murugan-paramesh/SiC-DC-DC-Converter/Advanced_Research_2026/Robust_Optimization/README.md

# Robust_Optimization - reliability-aware multi-objective DAB design under uncertainty

_Generated by `robust_optimize.py` (seed 20261010, NSGA-II population 60 x 60 generations for every variant, 24 LHS uncertainty samples per design, 30850 design evaluations in 506 s). Maturity **L2** (analytical/simulation models, nothing measured)._

## 1. Problem

Design variables (9, mixed): switching frequency fs 60-200 kHz; nominal phase shift phi_nom 12-50 deg, which fixes the series inductance L = V1 n V2 phi (pi - phi) / (2 pi^2 fs P) at 800/400 V, 6.6 kW (L is reported); turns ratio n 1.6-2.4; transformer peak-flux target 0.08-0.20 T; transformer core {E55, ETD59, E65, E70}; inductor core {ETD44, ETD49, E55}; dead time 80-250 ns; HV device {C3M0032120K, C3M0016120K}; LV device {C3M0016120K x1, C3M0032120K x2}. Modulation is SPS (as in 12_Optimization); magnetics are designed at the nominal point with `dabtools.dab.magnetics.design_transformer/design_inductor`.

Objectives (all minimised, no weighted sum):

1. total converter loss at 800/400 V, 6.6 kW (W) - same budget as 04/12: bridges, gate drive, transformer, inductor, 12 W auxiliary, 0.4 % PCB/bus-bar;
2. magnetics volume (cm3) = 2.2 x (transformer + inductor core volume), as in 12_Optimization;
3. reliability proxy: log10 of the daily lifetime consumption D = sum n_i / Nf_i of the hotter bridge over the ASSUMED 24 h mission profile (rainflow count of the hourly steady-state Tj sequence, Coffin-Manson/Arrhenius law Nf = A dTj^alpha exp(Q/(R Tm)) with the LESIT coefficients A = 3.025e+05, alpha = -5.039, Q/R = 11897 K). **These coefficients are literature-typical values for Si IGBT modules (Held et al. 1997); they are not measured for discrete SiC TO-247 devices, so only the ratio between designs is meaningful** - the objective is reported as log10(D / D_baseline). For the record the absolute proxy for the baseline is 1.48e+13 years, i.e. thermal cycling is not life-limiting with the project heatsink (dTj < 15 K);
4. negative ZVS margin: -min over {nominal + 4 envelope corners} x {100 %, 50 % load} of (I_edge - I_min) at both bridges, A referred to the HV side (I_min from the energy criterion with Coss_er and the 60 pF winding capacitance of design_values.json).

Constraints (<= 0), following 00_Requirements/02_operating_envelope.md: full power reachable at all 9 (V1, V2) corners with phi <= 60 deg (requirement 1, firmware clamp); Tj <= 125 C at every full-power corner (13_Thermal_Analysis limit, heatsink 0.22 K/W + 0.35 K/W pad) **with hard-switching losses charged wherever the ZVS criterion fails** (requirement 2/3: a point without ZVS is allowed if the thermal budget holds); ZVS at both bridges at the nominal voltages 800/400 V at 100 % and 50 % load (EL-04a style); transformer Bpk at 850 V <= 0.2 T; transformer and inductor window fill <= 0.7; HV peak current <= 24 A (design_values I_limit_pk). ZVS over the envelope corners is objective 4 (maximised margin) and, in the three *strict* variants, an additional hard constraint (ZVS at both bridges at all five full-power points); the strict variants are reported because the task asked for corner ZVS as a constraint, and section 3.3 shows why it is incompatible with the 60 deg limit under inductance tolerance for SPS.

Uncertainty (assumed uniform, not measured): kL series inductance tolerance +/-15 % [0.85, 1.15]; kCoss Coss_er tolerance +/-20 % [0.8, 1.2]; kRds Rds_on aging +0..30 % [1, 1.3]; kCore ferrite core-loss tolerance +/-25 % [0.75, 1.25]; Tamb ambient 25..55 C [25, 55]. One Latin-hypercube set of 24 samples (common random numbers, `results/uncertainty_samples_LHS.csv`) is used for every design. **Robust** variant: every objective and constraint is the worst case over the samples. **Chance-constrained** variant: objectives are sample means, every constraint is enforced at its 95 % empirical quantile, so ZVS at the envelope corners holds with probability >= 95 % (at most 1 of 24 samples may fail).

Mission profile (`results/mission_profile_ASSUMED.csv`, figure below): ASSUMED EV-charger / battery-interface day, bidirectional (night charging 6.6 kW with battery voltage rising 330 -> 445 V, morning and evening vehicle-to-grid discharge up to 6.6 kW, midday PV charging 3.3 kW, standby hours with 12 W auxiliary loss). Segments are hourly, so each is evaluated at steady state (thermal time constants of TO-247 + heatsink are minutes).

## 2. Methods

* **Evaluator** (`dab_eval.py`): closed-form SPS waveform quantities (exact piecewise-linear rms), project loss model (`dabtools.dab.losses` re-implemented with Rds_on/Coss scaling, identical at scale 1), 5-step electro-thermal iteration, project magnetics design routines. Self-test against the numerical `DABPoint` model: rms/peak within 0.31 %, edge currents identical to `dab_model.sps_switching_currents`. Cross-check with the stored 12_Optimization baseline (phi = 28 deg -> 63.7 uH, no winding capacitance): stored 91.63 W, this evaluator 90.67 W; the project baseline with L = 64.0 uH gives 90.79 W. The 1 W difference has a cause worth recording: `DABPoint.switching_currents()` detects a third, wrap-around edge on bridge 1 (theta = 2 pi - d_theta) so 12_Optimization and 04 count three HV turn-off/dead-time events per period instead of two (HV switching 2.80 W and dead-time diode 0.87 W in design_values.json vs 1.88 W and 0.59 W here); the closed form uses two edges per bridge.
* **NSGA-II** (numpy): constrained non-dominated sorting (feasible beats infeasible, infeasible ranked by total violation), crowding distance, binary tournament, SBX (eta_c = 15, p_c = 0.9), polynomial mutation (eta_m = 20, p_m = 1/9). The reported Pareto set is the non-dominated subset of all feasible first-front members archived over the generations. Hypervolume is a Monte-Carlo estimate (1e5 fixed points) in a common box spanned by the union of all fronts.
* **Surrogate-assisted search**: Gaussian process (ARD squared-exponential kernel, hyperparameters by marginal likelihood, L-BFGS-B, two restarts) on an augmented-Tchebycheff scalarisation s = max_k w_k f~_k + 0.05 sum_k w_k f~_k of the box-normalised objectives, expected-improvement acquisition maximised over 4000 random + 300 local candidates; 5 weight vectors, 20 LHS initial + 30 iterations each. Infeasible designs get s = 2 + violation. This is a simplified single-objective BO per weight vector (ParEGO-like), not a hypervolume-based multi-objective BO; the weight vectors only steer the search, the result reported is the non-dominated set of all feasible evaluated points.
* **Exhaustive grid**: the 8640-point grid of 12_Optimization re-evaluated with this evaluator (Bpk target 0.13 T as there) for a like-for-like comparison.
* **Knee selection**: on each front, min-max normalise the four objectives over the front and take the point closest (Euclidean) to the ideal point; a second knee from the (loss, volume) projection (maximum distance from the chord between the extremes) is reported as a cross-check. Both are standard knee heuristics; neither is a tuned weighted-sum score.

## 3. Results

Variants: `nominal`, `robust`, `cc` use the requirement-based constraint set; `*_strict` add ZVS at every full-power corner as a hard constraint.

| variant | evaluations | non-dominated designs | hypervolume | loss range (W) | volume range (cm3) | ZVS-margin range (A) | log10 D/D_base range |
|---|---|---|---|---|---|---|---|
| NSGA-II nominal | 3660 | 305 | 0.691 | 77.7 - 107.1 | 152 - 321 | -12.00 - -4.96 | -1.63 - +3.00 |
| NSGA-II robust (worst case) | 3660 | 242 | 0.267 | 84.6 - 101.3 | 166 - 277 | -12.14 - -8.59 | -0.50 - +4.12 |
| NSGA-II chance-constrained 95 % | 3660 | 197 | 0.524 | 80.6 - 95.3 | 152 - 277 | -10.75 - -6.61 | -0.78 - +3.22 |
| NSGA-II nominal, strict (ZVS at all full-power corners) | 3660 | 234 | 0.680 | 81.1 - 99.2 | 152 - 321 | -8.37 - -4.99 | -1.09 - +2.25 |
| NSGA-II robust, strict | 3660 | 0 | 0.000 | nan - nan | nan - nan | nan - nan | +nan - +nan |
| NSGA-II chance-constrained 95 %, strict | 3660 | 0 | 0.000 | nan - nan | nan - nan | nan - nan | +nan - +nan |
| exhaustive grid (nominal, re-evaluated) | 8640 (1380 feasible) | 52 | 0.437 | 81.0 - 95.5 | 152 - 321 | -12.92 - -6.84 | -1.07 - +2.98 |
| GP-EI surrogate search (nominal) | 250 | 15 | 0.291 | 89.6 - 110.2 | 214 - 277 | -8.42 - -5.92 | +0.03 - +1.65 |

The robust and chance-constrained hypervolumes are computed in the same box but from worst-case / mean objectives, so they are not directly comparable to the nominal value; the comparison that matters is the shift of the fronts in the figures. NSGA-II nominal dominates 71 % of the grid's 4-D non-dominated designs and 100 % of the surrogate-search designs; at the surrogate budget (250 evaluations) NSGA-II nominal had hypervolume 0.361 vs 0.291 for the surrogate search. The grid front is evaluated under 12_Optimization's own constraint set (phi <= 60 deg, Tj, Bpk, fills; 1380 of 8640 feasible; 564 of them also pass this module's nominal set); only 0 grid designs satisfy the strict ZVS-at-every-full-power-corner + Ipk <= 24 A set, because the grid's phi_nom steps (20, 25, 30, 35 deg) straddle the narrow strict window (see 3.3) - its reported front designs (phi_nom 20 deg) hard-switch at the 650/450 V and 850/300 V full-power corners (allowed by the requirements if Tj holds, which it does with this heatsink).

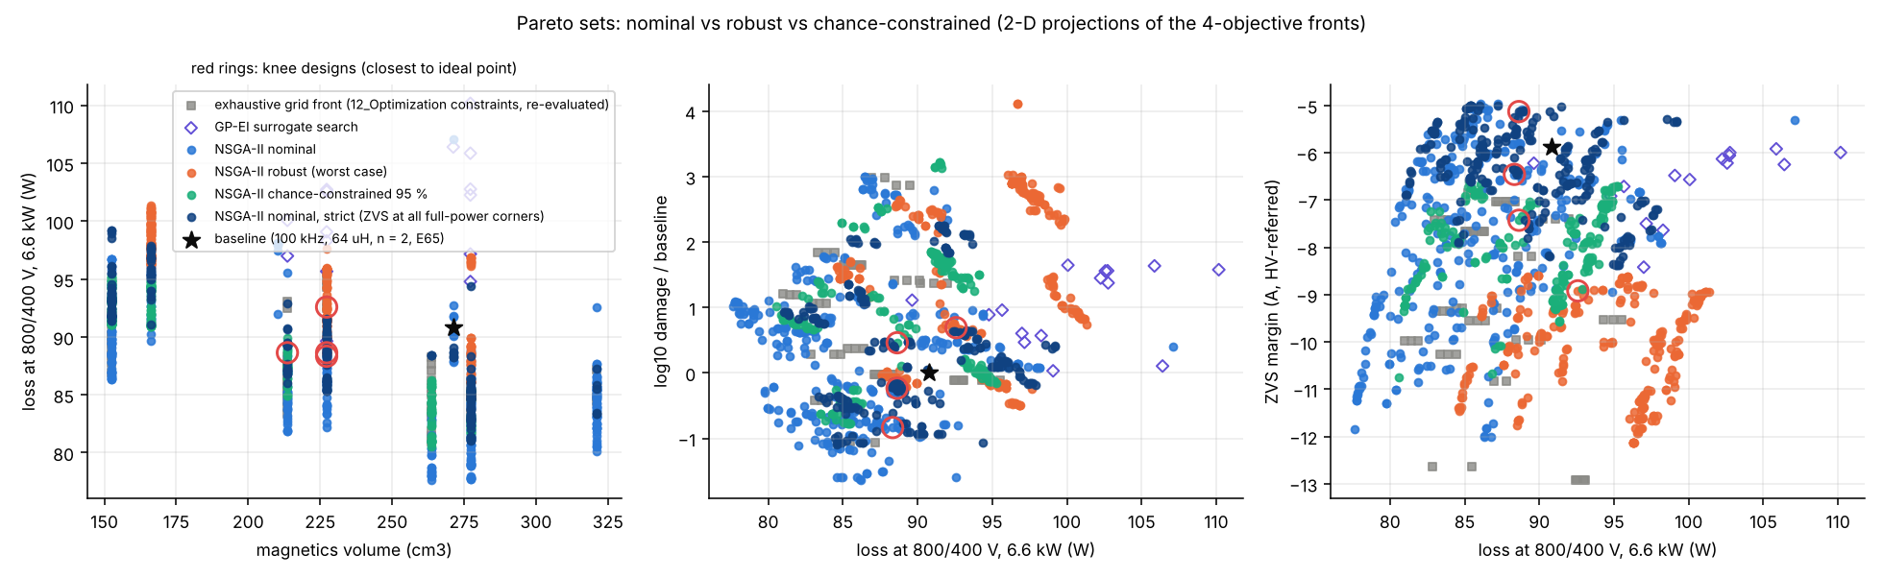
[picture p4: Advanced_Research_2026/Robust_Optimization/results/pareto_2d.png]
pareto 2d


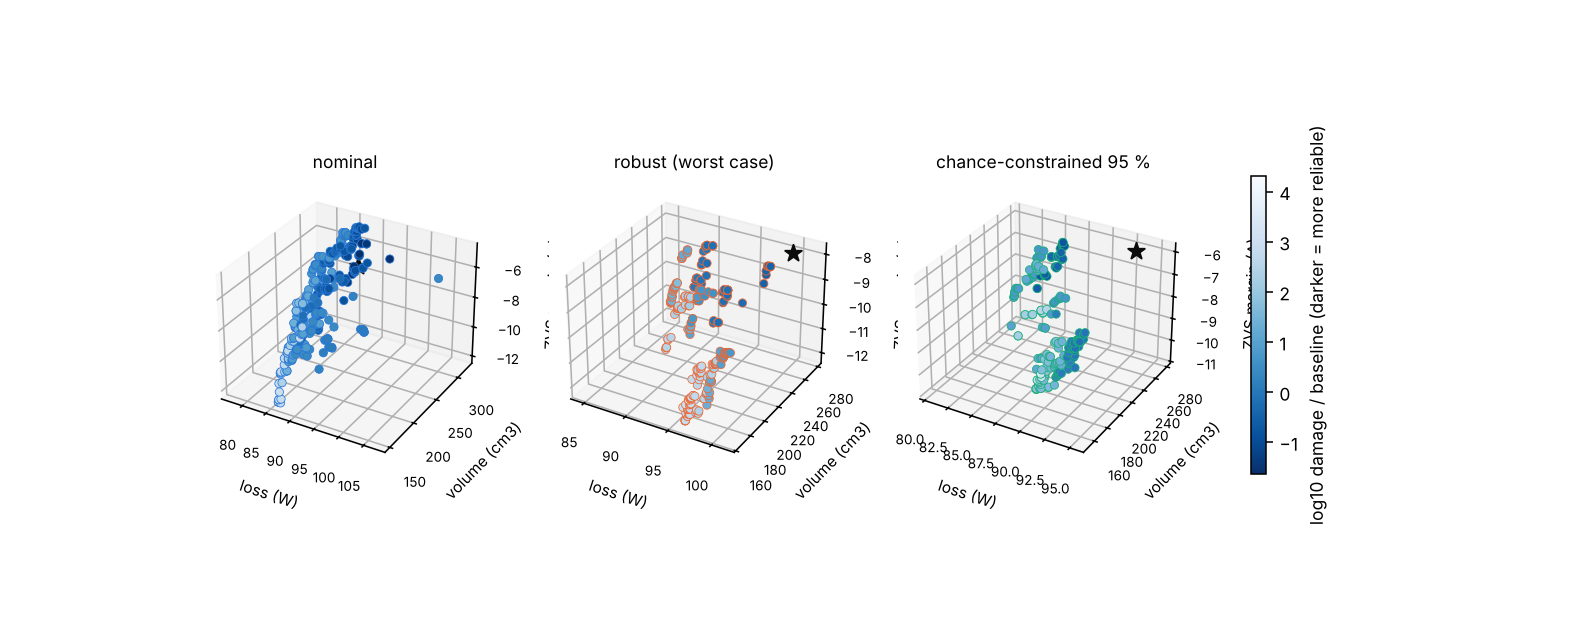
[picture p5: Advanced_Research_2026/Robust_Optimization/results/pareto_3d.png]
pareto 3d


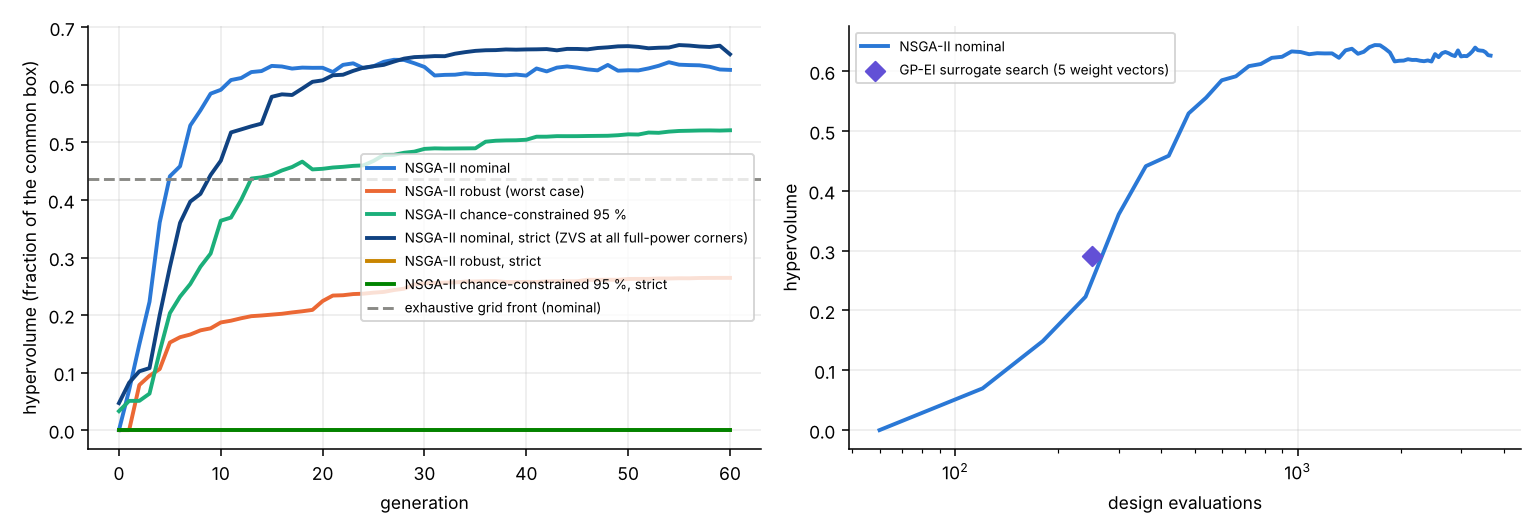
[picture p6: Advanced_Research_2026/Robust_Optimization/results/convergence_hypervolume.png]
convergence


### 3.1 Knee designs

| fs (kHz) | phi_nom (deg) | L (uH) | n | Bpk (T) | transformer | inductor | t_dead (ns) | HV device | LV device | loss (W) | volume (cm3) | log10 D/D_base | ZVS margin (A) |
|---|---|---|---|---|---|---|---|---|---|---|---|---|---|
| 71 | 24.6 | 78.9 | 1.97 | 0.178 | E65/32/27 | ETD49/25/16 | 119 | C3M0032120Kx1 | C3M0032120Kx2 | 88.3 | 227 | -0.83 | -6.46 | NSGA-II nominal, knee (ideal-point distance 0.64)
| 107 | 24.7 | 52.9 | 1.97 | 0.124 | E65/32/27 | ETD49/25/16 | 81 | C3M0032120Kx1 | C3M0032120Kx2 | 92.6 | 227 | +0.69 | -8.92 | NSGA-II robust (worst case), knee (ideal-point distance 0.78)
| 133 | 23.8 | 41.1 | 1.97 | 0.097 | E65/32/27 | ETD44/22/15 | 132 | C3M0032120Kx1 | C3M0032120Kx2 | 88.6 | 214 | +0.46 | -7.43 | NSGA-II chance-constrained 95 %, knee (ideal-point distance 0.82)
| 94 | 29.1 | 68.4 | 1.96 | 0.135 | E65/32/27 | ETD49/25/16 | 84 | C3M0032120Kx1 | C3M0032120Kx2 | 88.6 | 227 | -0.23 | -5.13 | NSGA-II nominal, strict (ZVS at all full-power corners), knee (ideal-point distance 0.66)
| 94 | 18.6 | 47.5 | 1.98 | 0.139 | E65/32/27 | ETD44/22/15 | 117 | C3M0016120Kx1 | C3M0032120Kx2 | 81.9 | 214 | +1.62 | -10.85 | NSGA-II nominal, 2-D (loss, volume) chord knee
| 103 | 21.2 | 48.3 | 1.98 | 0.124 | E65/32/27 | ETD49/25/16 | 83 | C3M0016120Kx1 | C3M0032120Kx2 | 88.5 | 227 | +2.54 | -11.76 | NSGA-II robust (worst case), 2-D (loss, volume) chord knee
| 116 | 21.8 | 44.0 | 1.98 | 0.180 | ETD59/31/22 | ETD49/25/16 | 125 | C3M0016120Kx1 | C3M0032120Kx2 | 90.9 | 166 | +1.85 | -9.14 | NSGA-II chance-constrained 95 %, 2-D (loss, volume) chord knee
| 122 | 26.0 | 47.5 | 1.93 | 0.169 | ETD59/31/22 | ETD49/25/16 | 89 | C3M0016120Kx1 | C3M0032120Kx2 | 91.1 | 166 | +2.02 | -6.86 | NSGA-II nominal, strict (ZVS at all full-power corners), 2-D (loss, volume) chord knee
| 100 | 28.2 | 64.0 | 2.00 | 0.130 | E65/32/27 | E55/28/21 | 150 | C3M0032120Kx1 | C3M0016120Kx1 | 90.8 | 271 | +0.00 | -5.88 | **baseline** (nominal evaluation)

Rationale: the knee is the design beyond which improving any one objective costs disproportionately in the others (closest point to the ideal in the normalised objective space). The nominal knee runs at 71 kHz with phi_nom 24.6 deg (L = 78.9 uH), n = 1.97, E65/32/27 / ETD49/25/16, dead time 119 ns, C3M0032120Kx1 / C3M0032120Kx2: 88.3 W (eta 98.68 %), 227 cm3, mission efficiency 98.33 % (1261 Wh/day), Tj max 54 C, dTj (HV/LV) 8.7/5.8 K, ZVS margin -6.46 A.

### 3.2 Baseline (100 kHz, 64 uH, n = 2, E65/E55, 150 ns, C3M0032120K / C3M0016120K) against the fronts

| variant | baseline objectives (loss W, volume cm3, log10 D/D_base, ZVS margin A) | feasible under variant | front designs dominating it | normalised distance to front | loss reduction available (W) | volume reduction available (cm3) | ZVS-margin gain available (A) |
|---|---|---|---|---|---|---|---|
| nominal | 90.8, 271, +0.00, -5.88 | yes | 6 of 305 | 0.173 | 2.6 | 44 | 0.08 |
| robust (worst case) | 99.9, 271, +0.54, -7.87 | no | 0 of 242 | 0.393 | 0.0 | 0 | 0.00 |
| chance-constrained 95 % | 93.3, 271, -0.30, -5.97 | no | 0 of 197 | 0.524 | 0.0 | 0 | 0.00 |
| nominal, strict (ZVS at all full-power corners) | 90.8, 271, +0.00, -5.88 | yes | 12 of 234 | 0.159 | 2.5 | 44 | 0.77 |
| robust, strict | 99.9, 271, +0.54, -7.87 | no | 0 of 0 | nan | 0.0 | 0 | 0.00 |
| chance-constrained 95 %, strict | 93.3, 271, -0.30, -5.97 | no | 0 of 0 | nan | 0.0 | 0 | 0.00 |

The baseline is **dominated** by 6 of the 305 front designs; its normalised distance to the front is 0.173 of the front span. The dominating designs save at most 2.6 W (2.9 % of the loss) and 44 cm3 (16 % of the magnetics volume) while being no worse in reliability proxy and ZVS margin - e.g. 91 kHz, phi_nom 27.0 deg (L = 66.3 uH), n = 1.96, E65/32/27 + ETD49/25/16 inductor, 107 ns, C3M0032120Kx1 / C3M0032120Kx2. Verdict: the baseline is near-Pareto-optimal in loss (within 3 %) but not in magnetics volume: the E55 series-inductor core is oversized (window fill 0.28) and an ETD49 core with 2 x C3M0032120K on the LV bridge gives the same loss, ZVS margin and reliability with less volume; the choice fs = 100 kHz / phi_nom = 28 deg / n = 2 itself lies on the front. Under the robust and chance-constrained variants the baseline is NOT feasible / NOT feasible respectively (violated constraint: phi_corner - the 650/300 V corner needs phi > 60 deg when L is at +15 %, see 3.3); its probability of ZVS at 800/400 V (100 % and 50 % load) over the LHS set is 1.00, of ZVS at every full-power corner 0.71 (see `results/knee_and_baseline.json`).

Designs dominating the baseline (nominal, first three):

| fs (kHz) | phi_nom (deg) | L (uH) | n | Bpk (T) | transformer | inductor | t_dead (ns) | HV device | LV device | loss (W) | volume (cm3) | log10 D/D_base | ZVS margin (A) |
|---|---|---|---|---|---|---|---|---|---|---|---|---|---|
| 91 | 27.0 | 66.3 | 1.96 | 0.141 | E65/32/27 | ETD49/25/16 | 107 | C3M0032120Kx1 | C3M0032120Kx2 | 88.2 | 227 | -0.30 | -5.81 |
| 91 | 27.0 | 66.3 | 1.96 | 0.141 | E65/32/27 | ETD49/25/16 | 110 | C3M0032120Kx1 | C3M0032120Kx2 | 88.2 | 227 | -0.30 | -5.81 |
| 91 | 27.0 | 66.3 | 1.96 | 0.139 | E65/32/27 | ETD49/25/16 | 145 | C3M0032120Kx1 | C3M0032120Kx2 | 88.6 | 227 | -0.30 | -5.80 |

### 3.3 Effect of the uncertainty treatment

* 55 of the 305 nominal-front designs remain feasible under the robust (worst case) constraints.
* 73 of the 305 nominal-front designs remain feasible under the chance-constrained 95 % constraints.
* 120 of the 305 nominal-front designs remain feasible under the nominal, strict (ZVS at all full-power corners) constraints.
* 0 of the 305 nominal-front designs remain feasible under the robust, strict constraints.
* 0 of the 305 nominal-front designs remain feasible under the chance-constrained 95 %, strict constraints.
* nominal front: probability of ZVS at 800/400 V (100 % and 50 % load) over the LHS set is min 0.58, mean 0.99; 95 % of its designs reach >= 95 %.
* robust (worst case) front: probability of ZVS at 800/400 V (100 % and 50 % load) over the LHS set is min 1.00, mean 1.00; 100 % of its designs reach >= 95 %.
* chance-constrained 95 % front: probability of ZVS at 800/400 V (100 % and 50 % load) over the LHS set is min 0.96, mean 1.00; 100 % of its designs reach >= 95 %.
* nominal, strict (ZVS at all full-power corners) front: probability of ZVS at every full-power corner over the LHS set is min 0.46, mean 0.72; 1 % of its designs reach >= 95 %.
* **No feasible design was found by the robust, strict variant** (3660 evaluations); least-violating final design: constraints [-0.113, -0.463, 0.0, -0.18, -0.082, -0.486, -0.133] (order ['phi_corner', 'Tj', 'zvs_full', 'Bpk_850V', 'fill_xf', 'fill_ind', 'Ipk']).
* **No feasible design was found by the chance-constrained 95 %, strict variant** (3660 evaluations); least-violating final design: constraints [-0.016, -0.537, 0.0, -0.175, -0.507, -0.261, -0.198] (order ['phi_corner', 'Tj', 'zvs_full', 'Bpk_850V', 'fill_xf', 'fill_ind', 'Ipk']).
* Shift of the fronts (minimum loss / maximum ZVS margin / best log10 D on each front): nominal 77.7 W / -4.96 A / -1.63; robust (worst case) 84.6 W / -8.59 A / -0.50; chance-constrained 95 % 80.6 W / -6.61 A / -0.78; nominal, strict (ZVS at all full-power corners) 81.1 W / -4.99 A / -1.09. Worst-case objectives include +30 % Rds_on, +25 % core loss and 55 C ambient simultaneously, so a robust front sits above the nominal one in loss by construction; the chance-constrained objectives are sample means and sit close to the nominal values, the difference is in which designs are admitted.
* Why the strict worst case is (nearly) empty - closed form: with SPS at full power the HV bridge keeps ZVS at the 650/450 V corner only if phi > pi (V2' - V1) / (2 V2') (I0 > 0) and the LV bridge at 850/300 V only if phi > pi (V1 - V2') / (2 V1) (I1 > 0); for n = 2 these are 25.0 deg and 26.5 deg. Because P = V1 V2' phi (pi - phi) / (2 pi^2 fs L), every corner sees the same K = 2 pi^2 fs L P scaled by 1/(V1 V2'): ZVS at 650/450 V (585 kV^2, phi >= 25.0 deg) needs K >= 690 kV^2 and ZVS at 850/300 V (510 kV^2, phi >= 26.5 deg) K >= 632 kV^2, while the 60 deg limit of 00_Requirements / firmware clamp at 650/300 V (390 kV^2) caps K <= 855 kV^2. K is proportional to L, so the zero-current ZVS boundaries and the phase limit together admit only a K ratio of 1.24, i.e. a +/-10.7 % inductance band for n = 2 (+/-12.7 % for n = 1.95), below the assumed +/-15 % tolerance; the Coss-based minimum ZVS current, the +20 % Coss sample and the 24 A peak limit of the strict set narrow it further. (Earlier text quoted 57 deg at 650/300 V and a +/-1.5 % band: the 57 deg is the baseline 64 uH value, not the value implied by the 26.5 deg boundary (37.3 deg), and the 1.5 % was not supported by the closed form - corrected 2026-10-10.) In nominal-phase terms the lossless bound is phi_nom (800/400 V) = 22.5-29.1 deg; the optimiser's strict set narrows it to about 26.5-28.5 deg - the baseline (28.2 deg) sits inside it, which also explains why only 0 of the 8640 grid designs (phi_nom 20/25/30/35 deg) satisfy the strict constraint set. Consequence: with SPS, ZVS at the voltage-mismatch corners at full power cannot be *guaranteed* under a +/-15 % inductance tolerance; the requirement document already allows hard-switched operation where the thermal budget holds, which is what the main variants enforce (Tj with hard-switching losses) while the corner margin is maximised as an objective. EPS/TPS modulation (11_Control_Algorithms) is the known remedy and is outside this SPS study.

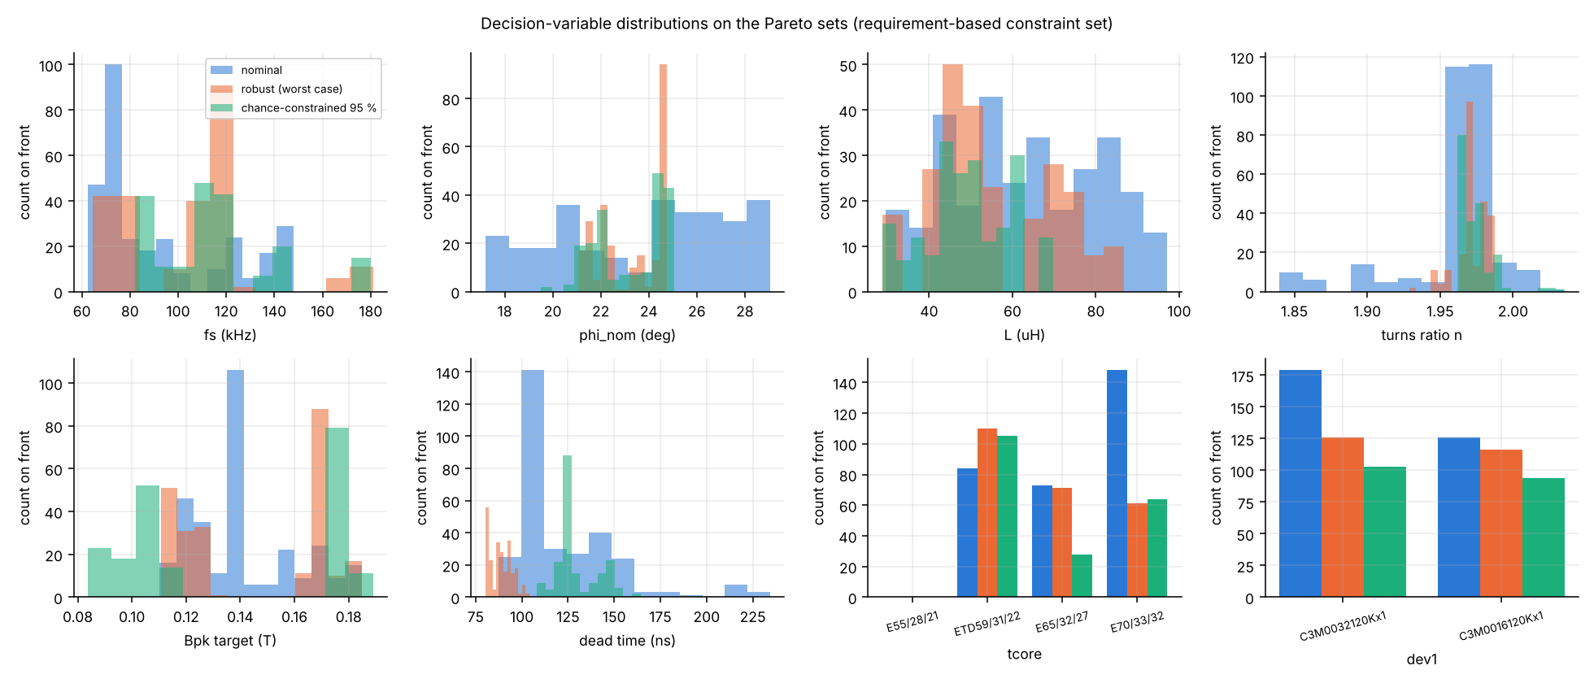
[picture p7: Advanced_Research_2026/Robust_Optimization/results/decision_variables.png]
variables


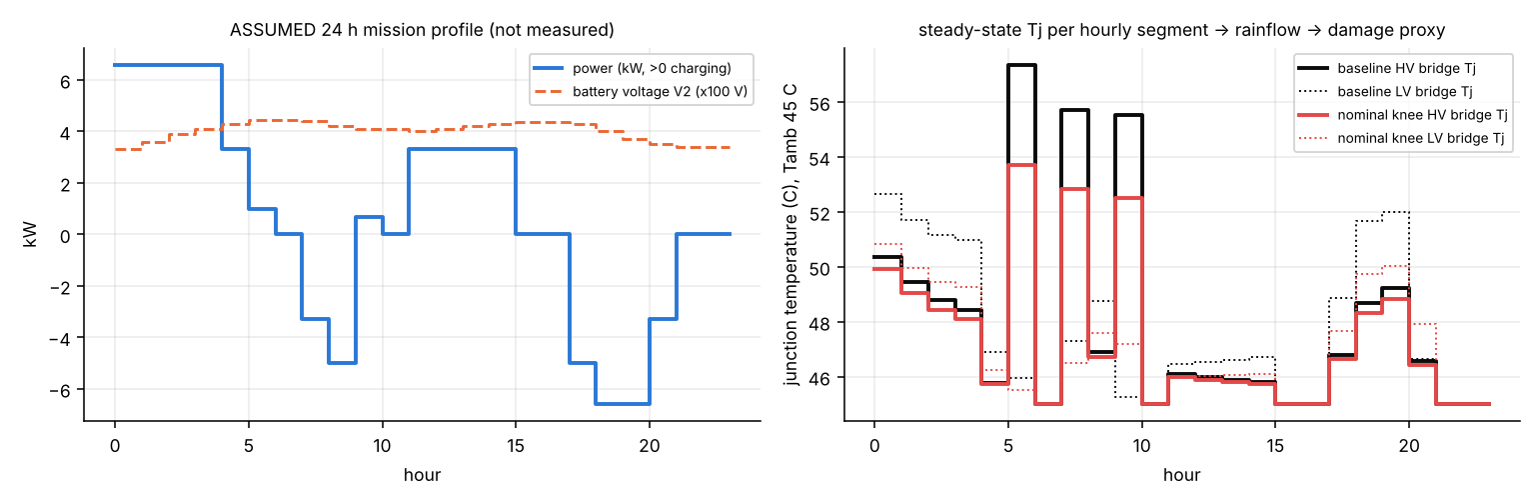
[picture p8: Advanced_Research_2026/Robust_Optimization/results/mission_profile_Tj.png]
mission


### 3.4 Decision-variable patterns on the fronts

* nominal: fs 63-148 kHz (median 77), phi_nom 17-29 deg, n 1.84-2.03 (median 1.97), Bpk 0.110-0.185 T, t_dead 88-234 ns; transformer cores {'E55/28/21': 0, 'ETD59/31/22': 84, 'E65/32/27': 73, 'E70/33/32': 148}; HV device {'C3M0032120Kx1': 179, 'C3M0016120Kx1': 126}.
* robust (worst case): fs 65-181 kHz (median 107), phi_nom 21-25 deg, n 1.93-1.99 (median 1.97), Bpk 0.111-0.185 T, t_dead 80-104 ns; transformer cores {'E55/28/21': 0, 'ETD59/31/22': 110, 'E65/32/27': 71, 'E70/33/32': 61}; HV device {'C3M0032120Kx1': 126, 'C3M0016120Kx1': 116}.
* chance-constrained 95 %: fs 82-180 kHz (median 111), phi_nom 20-25 deg, n 1.96-2.04 (median 1.97), Bpk 0.084-0.189 T, t_dead 108-164 ns; transformer cores {'E55/28/21': 0, 'ETD59/31/22': 105, 'E65/32/27': 28, 'E70/33/32': 64}; HV device {'C3M0032120Kx1': 103, 'C3M0016120Kx1': 94}.
* nominal, strict (ZVS at all full-power corners): fs 71-140 kHz (median 98), phi_nom 25-29 deg, n 1.82-1.99 (median 1.94), Bpk 0.103-0.184 T, t_dead 80-123 ns; transformer cores {'E55/28/21': 0, 'ETD59/31/22': 79, 'E65/32/27': 84, 'E70/33/32': 71}; HV device {'C3M0032120Kx1': 156, 'C3M0016120Kx1': 78}.

Note on objective 4: the margin is the minimum over the envelope at 100 % and 50 % load; with SPS every design is hard-switched at 50 % load at the voltage-mismatch corners (850/300 V, 650/450 V), so the values are negative throughout and rank how far from ZVS the worst point is. The per-generation hypervolume uses the population's first front, the final value the archive, so small dips are possible.

Full fronts: `results/pareto_fronts.csv` (NSGA-II, all variants with feasible designs), `results/grid_front_reevaluated.csv`, `results/bo_front.csv`; hypervolume history and BO traces: `results/convergence.json`.

## 4. Maturity and what was NOT verified

Maturity **L2**: every number comes from the analytical/semi-numerical project models (SPS closed form, datasheet-typical device parameters flagged `verified=False`, Steinmetz/Dowell magnetics, one-node thermal network). Not verified:

* no hardware, no measured losses, temperatures, ZVS transitions or inductance/capacitance tolerances - the uncertainty ranges are assumptions;
* the lifetime law and its coefficients (LESIT, Si IGBT modules) are not calibrated for discrete SiC TO-247 devices; the proxy ranks designs, it does not predict a lifetime;
* the mission profile is invented (labelled ASSUMED); a different profile changes the reliability ranking and the mission efficiency;
* the mission thermal model is quasi-static (hourly steady state), so sub-hour power cycling and the resulting small-amplitude Tj cycles are not counted;
* SPS modulation only - EPS/TPS would change the ZVS margins at the voltage-mismatch corners (see 11_Control_Algorithms);
* the hypervolume is a Monte-Carlo estimate (1e5 points); NSGA-II is stochastic - a single seed per variant is reported (deterministic, but no multi-seed statistics); the robust and chance-constrained hypervolume curves were still rising slowly at the last generation (more generations would extend those fronts slightly);
* the chance constraint uses an empirical quantile over 24 LHS samples (resolution 1/24), not an analytical probability;
* the surrogate search is a simplified single-objective BO per weight vector; its lower hypervolume at equal budget is a result of this run, not a general statement about BO.

## 5. Files

`dab_eval.py` (shared evaluator, also used by `../Uncertainty_Quantification/`), `robust_optimize.py` (this run), `results/` (CSV, JSON, PNG), `provenance.json`.
