murugan-paramesh/SiC-DC-DC-Converter/SiC_6k6_Industrial_DAB/07_KiCad_Schematics/drc_report.txt

** Drc report for /home/user/SiC-DC-DC-Converter/SiC_6k6_Industrial_DAB/07_KiCad_Schematics/SiC_DAB_6k6.kicad_pcb **
** Created on 2026-10-10 03:26:20 **

** Found 63 DRC violations **
[silk_overlap]: Silkscreen overlap
    Rule: board setup constraints silk; Severity: warning
    @(270.0000 mm, 241.0000 mm): Circle on F.Silkscreen
    @(280.0000 mm, 241.0000 mm): PCB Text 'DANGER: LV LINK 450 VDC' on F.Silkscreen
[silk_overlap]: Silkscreen overlap
    Rule: board setup constraints silk; Severity: warning
    @(280.0000 mm, 241.0000 mm): PCB Text 'DANGER: LV LINK 450 VDC' on F.Silkscreen
    @(283.0000 mm, 238.0000 mm): Rect on F.Silkscreen
[silk_overlap]: Silkscreen overlap
    Rule: board setup constraints silk; Severity: warning
    @(170.0000 mm, 241.0000 mm): PCB Text 'rev A  2026-10  open hardware' on F.Silkscreen
    @(170.0000 mm, 243.0000 mm): Circle on F.Silkscreen
[silk_overlap]: Silkscreen overlap
    Rule: board setup constraints silk; Severity: warning
    @(170.0000 mm, 245.0000 mm): PCB Text 'CONTROL (SELV)' on F.Silkscreen
    @(170.0000 mm, 243.0000 mm): Circle on F.Silkscreen
[silk_overlap]: Silkscreen overlap
    Rule: board setup constraints silk; Severity: warning
    @(150.5000 mm, 242.0000 mm): Circle on F.Silkscreen
    @(170.0000 mm, 241.0000 mm): PCB Text 'rev A  2026-10  open hardware' on F.Silkscreen
[silk_overlap]: Silkscreen overlap
    Rule: board setup constraints silk; Severity: warning
    @(150.0000 mm, 84.5750 mm): Reference 'C159'
    @(148.2500 mm, 84.8000 mm): Footprint Text '+' of C159
[silk_overlap]: Silkscreen overlap
    Rule: board setup constraints silk; Severity: warning
    @(160.0000 mm, 84.5750 mm): Reference 'C160'
    @(158.2500 mm, 84.8000 mm): Footprint Text '+' of C160
[silk_overlap]: Silkscreen overlap
    Rule: board setup constraints silk; Severity: warning
    @(170.0000 mm, 84.5750 mm): Reference 'C162'
    @(168.2500 mm, 84.8000 mm): Footprint Text '+' of C162
[silk_overlap]: Silkscreen overlap
    Rule: board setup constraints silk; Severity: warning
    @(60.0000 mm, 245.0000 mm): PCB Text 'SiC 6.6 kW BIDIRECTIONAL DUAL ACTI...' on F.Silkscreen
    @(53.0000 mm, 238.0000 mm): Rect on F.Silkscreen
[silk_overlap]: Silkscreen overlap
    Rule: board setup constraints silk; Severity: warning
    @(60.0000 mm, 245.0000 mm): PCB Text 'SiC 6.6 kW BIDIRECTIONAL DUAL ACTI...' on F.Silkscreen
    @(7.0000 mm, 243.0000 mm): Circle on F.Silkscreen
[silk_overlap]: Silkscreen overlap
    Rule: board setup constraints silk; Severity: warning
    @(60.0000 mm, 245.0000 mm): PCB Text 'SiC 6.6 kW BIDIRECTIONAL DUAL ACTI...' on F.Silkscreen
    @(17.0000 mm, 238.0000 mm): Rect on F.Silkscreen
[silk_over_copper]: Silkscreen clipped by solder mask
    Local override; Severity: warning
    @(60.0000 mm, 241.0000 mm): PCB Text 'DANGER: HV LINK 850 VDC' on F.Silkscreen
[silk_over_copper]: Silkscreen clipped by solder mask
    Local override; Severity: warning
    @(170.0000 mm, 241.0000 mm): PCB Text 'rev A  2026-10  open hardware' on F.Silkscreen
[silk_over_copper]: Silkscreen clipped by solder mask
    Local override; Severity: warning
    @(60.0000 mm, 245.0000 mm): PCB Text 'SiC 6.6 kW BIDIRECTIONAL DUAL ACTI...' on F.Silkscreen
[silk_over_copper]: Silkscreen clipped by solder mask
    Local override; Severity: warning
    @(280.0000 mm, 241.0000 mm): PCB Text 'DANGER: LV LINK 450 VDC' on F.Silkscreen
[silk_over_copper]: Silkscreen clipped by solder mask
    Local override; Severity: warning
    @(170.0000 mm, 245.0000 mm): PCB Text 'CONTROL (SELV)' on F.Silkscreen
[silk_over_copper]: Silkscreen clipped by solder mask
    Local override; Severity: warning
    @(247.4000 mm, 20.5000 mm): Line on F.Silkscreen
[silk_over_copper]: Silkscreen clipped by solder mask
    Local override; Severity: warning
    @(284.0500 mm, 7.7000 mm): Rect on F.Silkscreen
[silk_over_copper]: Silkscreen clipped by solder mask
    Local override; Severity: warning
    @(315.4000 mm, 20.5000 mm): Line on F.Silkscreen
[silk_over_copper]: Silkscreen clipped by solder mask
    Local override; Severity: warning
    @(77.4000 mm, 20.5000 mm): Line on F.Silkscreen
[silk_over_copper]: Silkscreen clipped by solder mask
    Local override; Severity: warning
    @(68.0500 mm, 7.7000 mm): Rect on F.Silkscreen
[silk_over_copper]: Silkscreen clipped by solder mask
    Local override; Severity: warning
    @(168.4000 mm, 222.5000 mm): Line on F.Silkscreen
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
    @(126.4700 mm, 74.0000 mm): Rect on Edge.Cuts
    @(135.8000 mm, 81.6000 mm): Rect on F.Silkscreen
[silk_edge_clearance]: Silkscreen clipped by board edge
    Rule: board setup constraints silk; Severity: warning
    @(210.9300 mm, 54.0000 mm): Rect on Edge.Cuts
    @(203.2000 mm, 54.4000 mm): Rect on F.Silkscreen
[silk_edge_clearance]: Silkscreen clipped by board edge
    Rule: board setup constraints silk; Severity: warning
    @(212.2000 mm, 124.0000 mm): Rect on Edge.Cuts
    @(203.2000 mm, 124.4000 mm): Rect on F.Silkscreen
[silk_edge_clearance]: Silkscreen clipped by board edge
    Rule: board setup constraints silk; Severity: warning
    @(210.9300 mm, 74.0000 mm): Rect on Edge.Cuts
    @(203.2000 mm, 74.4000 mm): Rect on F.Silkscreen
[silk_edge_clearance]: Silkscreen clipped by board edge
    Rule: board setup constraints silk; Severity: warning
    @(126.4700 mm, 64.0000 mm): Rect on Edge.Cuts
    @(126.0000 mm, 64.0750 mm): Reference 'PS3'
[silk_edge_clearance]: Silkscreen clipped by board edge
    Rule: board setup constraints silk; Severity: warning
    @(126.4700 mm, 64.0000 mm): Rect on Edge.Cuts
    @(135.8000 mm, 71.6000 mm): Rect on F.Silkscreen
[silk_edge_clearance]: Silkscreen clipped by board edge
    Rule: board setup constraints silk; Severity: warning
    @(126.4700 mm, 54.0000 mm): Rect on Edge.Cuts
    @(126.0000 mm, 54.0750 mm): Reference 'PS2'
[silk_edge_clearance]: Silkscreen clipped by board edge
    Rule: board setup constraints silk; Severity: warning
    @(126.4700 mm, 54.0000 mm): Rect on Edge.Cuts
    @(135.8000 mm, 61.6000 mm): Rect on F.Silkscreen
[track_dangling]: Track has unconnected end
    Local override; Severity: warning
    @(148.5400 mm, 167.7800 mm): Track [RESET_N] on F.Cu, length 4.0000 mm
[track_dangling]: Track has unconnected end
    Local override; Severity: warning
    @(148.5400 mm, 165.2400 mm): Track [SPI_MISO] on F.Cu, length 2.0000 mm
[track_dangling]: Track has unconnected end
    Local override; Severity: warning
    @(148.5400 mm, 162.7000 mm): Track [SPI_CS] on F.Cu, length 4.0000 mm
[track_dangling]: Track has unconnected end
    Local override; Severity: warning
    @(148.5400 mm, 160.1600 mm): Track [I2C_SDA] on F.Cu, length 2.0000 mm
[track_dangling]: Track has unconnected end
    Local override; Severity: warning
    @(146.0000 mm, 167.7800 mm): Track [SPI_MOSI] on F.Cu, length 4.0000 mm
[track_dangling]: Track has unconnected end
    Local override; Severity: warning
    @(146.0000 mm, 160.1600 mm): Track [I2C_SCL] on F.Cu, length 2.0000 mm
[track_dangling]: Track has unconnected end
    Local override; Severity: warning
    @(146.0000 mm, 157.6200 mm): Track [SPI_CLK] on F.Cu, length 4.0000 mm
[track_dangling]: Track has unconnected end
    Local override; Severity: warning
    @(152.7000 mm, 79.3650 mm): Track [I2_REF_OUT] on F.Cu, length 3.6000 mm
[track_dangling]: Track has unconnected end
    Local override; Severity: warning
    @(170.0000 mm, 162.7000 mm): Track [GPIO_SYNC] on F.Cu, length 4.0000 mm

** Found 0 unconnected pads **

** Found 0 Footprint errors **

** End of Report **
