murugan-paramesh/SiC-DC-DC-Converter/hardware/kicad/drc_report.txt

** Drc report for /home/user/SiC-DC-DC-Converter/hardware/kicad/SiC_PSFB_3kW.kicad_pcb **
** Created on 2026-10-09 20:26:44 **

** Found 40 DRC violations **
[silk_overlap]: Silkscreen overlap
    Rule: board setup constraints silk; Severity: warning
    @(200.0000 mm, 192.0000 mm): PCB Text 'SECONDARY 48 V / 62.5 A' on F.Silkscreen
    @(183.2000 mm, 191.6000 mm): Rect on F.Silkscreen
[silk_overlap]: Silkscreen overlap
    Rule: board setup constraints silk; Severity: warning
    @(244.0000 mm, 180.0000 mm): Circle on F.Silkscreen
    @(244.0000 mm, 170.5750 mm): Reference 'C16'
[silk_overlap]: Silkscreen overlap
    Rule: board setup constraints silk; Severity: warning
    @(244.0000 mm, 162.0000 mm): Circle on F.Silkscreen
    @(244.0000 mm, 170.5750 mm): Reference 'C16'
[silk_overlap]: Silkscreen overlap
    Rule: board setup constraints silk; Severity: warning
    @(244.0000 mm, 162.0000 mm): Circle on F.Silkscreen
    @(244.0000 mm, 152.5750 mm): Reference 'C15'
[silk_overlap]: Silkscreen overlap
    Rule: board setup constraints silk; Severity: warning
    @(244.0000 mm, 152.5750 mm): Reference 'C15'
    @(244.0000 mm, 144.0000 mm): Circle on F.Silkscreen
[silk_overlap]: Silkscreen overlap
    Rule: board setup constraints silk; Severity: warning
    @(244.0000 mm, 134.5750 mm): Reference 'C14'
    @(244.0000 mm, 144.0000 mm): Circle on F.Silkscreen
[silk_overlap]: Silkscreen overlap
    Rule: board setup constraints silk; Severity: warning
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
    @(130.5000 mm, 8.0000 mm): Rect on Edge.Cuts
    @(130.0000 mm, 8.0750 mm): Reference 'PS1'
[silk_edge_clearance]: Silkscreen clipped by board edge
    Rule: board setup constraints silk; Severity: warning
    @(130.5000 mm, 8.0000 mm): Rect on Edge.Cuts
    @(139.8000 mm, 15.6000 mm): Rect on F.Silkscreen
[silk_edge_clearance]: Silkscreen clipped by board edge
    Rule: board setup constraints silk; Severity: warning
    @(130.5000 mm, 18.0000 mm): Rect on Edge.Cuts
    @(130.0000 mm, 18.0750 mm): Reference 'PS2'
[silk_edge_clearance]: Silkscreen clipped by board edge
    Rule: board setup constraints silk; Severity: warning
    @(130.5000 mm, 18.0000 mm): Rect on Edge.Cuts
    @(139.8000 mm, 25.6000 mm): Rect on F.Silkscreen
[silk_edge_clearance]: Silkscreen clipped by board edge
    Rule: board setup constraints silk; Severity: warning
    @(130.5000 mm, 38.0000 mm): Rect on Edge.Cuts
    @(130.0000 mm, 38.0750 mm): Reference 'PS4'
[silk_edge_clearance]: Silkscreen clipped by board edge
    Rule: board setup constraints silk; Severity: warning
    @(130.5000 mm, 38.0000 mm): Rect on Edge.Cuts
    @(139.8000 mm, 45.6000 mm): Rect on F.Silkscreen
[silk_edge_clearance]: Silkscreen clipped by board edge
    Rule: board setup constraints silk; Severity: warning
    @(130.5000 mm, 28.0000 mm): Rect on Edge.Cuts
    @(130.0000 mm, 28.0750 mm): Reference 'PS3'
[silk_edge_clearance]: Silkscreen clipped by board edge
    Rule: board setup constraints silk; Severity: warning
    @(130.5000 mm, 28.0000 mm): Rect on Edge.Cuts
    @(139.8000 mm, 35.6000 mm): Rect on F.Silkscreen

** Found 0 unconnected pads **

** Found 0 Footprint errors **

** End of Report **
