murugan-paramesh/SiC-DC-DC-Converter/SiC_6k6_Industrial_DAB/00_Requirements/00_existing_project_audit.md

# 00 - Audit of the existing project (Phase 1)

Repository `murugan-paramesh/SiC-DC-DC-Converter`, branch `claude/gifted-archimedes-m9e484`, audited before
the DAB upgrade (commit 5d49041 is the preservation point; the PSFB design is untouched by the DAB work
except for generator refactoring that keeps its outputs identical).

| Item | State found | Reusable for the DAB |
|---|---|---|
| Topology / specification | PSFB ZVS, 3 kW, 370-420 V -> 48 V / 62.5 A, 100 kHz, unidirectional, UCC28951 control | baseline for the topology comparison only |
| Design calculations | `tools/psfb_design.py` (turns ratio, ZVS boundary, magnetics, loss budget 97.1 %, type-II loop, IPC copper) | method; magnetics/Dowell models re-implemented in `dabtools/dab/magnetics.py` |
| Schematic | KiCad 7 hierarchical, 3 sheets, 157 symbols, generated from `tools/kicad/design.py`; netlist verified identical to the design database by `kicad-cli` export + `check_netlist.py` | generator reused (`gen_schematic.use_design`) |
| Libraries | 32 symbols, 38 footprints, project-local | reused + 19 new symbols/footprints for the DAB |
| PCB | 260 x 200 mm, 4-layer, generated; zones/planes, power pours and stitching correct; signal routing by an own grid router - at the time of the audit 12-14 of 72 nets remained unrouted (dense controller block), zero clearance errors, isolation rules (8 mm / 5.5 mm + slots) DRC-checked | BoardGen + router (now negotiated-congestion) reused |
| ERC | not available in kicad-cli 7; netlist/pin consistency check used instead | same for the DAB (+ pin-exists check) |
| DRC | Python `WriteDRCReport` with project rules; results in `hardware/kicad/drc_report.txt` / `drc_summary.json` | same |
| Simulation | switched model (Python) agrees with the analytical design (duty 0.853 vs 0.845, I_rms 10.2 vs 10.1 A) | model approach reused for the DAB |
| BOM, docs | 57 line items; docs 01-07 | format reused |
| Missing in the PSFB package | firmware (analog controller), EMI, FMEA, thermal beyond junction estimates, gerbers | all added in the DAB package |

Necessary upgrades identified: bidirectional topology (DAB), 1200 V devices and 850 V insulation
coordination, digital control + firmware, 6-layer PCB with three isolation regions, hardware
protection chain, sensing, communication, and the research/verification documentation.
