murugan-paramesh/SiC-DC-DC-Converter/SiC_6k6_Industrial_DAB/06_Magnetics/magnetics_design.md

# 06 - High-frequency transformer and series inductor

_Generated by `transformer_design.py` from the design values; see 03 for the models._

## 1. Core material and geometry comparison (100 kHz, square-wave, Bpk 0.13 T target)

| core | material | N1:N2 | Bpk (T) | core loss (W) | copper loss (W) | bundle fill (copper fill = 0.5x) | leakage interleaved (uH) | dT (K) | volume (cm3) |
|---|---|---|---|---|---|---|---|---|---|
| E55/28/21 | 3C95 | 44:22 | 0.128 | 5.9 | 9.9 | 1.45 (!) | 14.6 | 37 | 44 |
| E55/28/21 | N97 | 44:22 | 0.128 | 5.6 | 9.9 | 1.45 (!) | 14.6 | 36 | 44 |
| ETD59/31/22 | 3C95 | 42:21 | 0.129 | 7.0 | 8.4 | 1.06 (!) | 9.8 | 33 | 52 |
| ETD59/31/22 | N97 | 42:21 | 0.129 | 6.7 | 8.4 | 1.06 (!) | 9.8 | 32 | 52 |
| E65/32/27 | 3C95 | 28:14 | 0.132 | 11.4 | 7.4 | 0.66 | 4.1 | 36 | 79 |
| E65/32/27 | N97 | 28:14 | 0.132 | 10.9 | 7.4 | 0.66 | 4.1 | 35 | 79 |
| PQ65/60 | 3C95 | 24:12 | 0.124 | 11.8 | 7.0 | 0.81 (!) | 4.0 | 35 | 96 |
| PQ65/60 | N97 | 24:12 | 0.124 | 11.3 | 7.0 | 0.81 (!) | 4.0 | 34 | 96 |
| E70/33/32 | 3C95 | 24:12 | 0.122 | 12.0 | 6.8 | 0.50 | 3.3 | 33 | 102 |
| E70/33/32 | N97 | 24:12 | 0.122 | 11.5 | 6.8 | 0.50 | 3.3 | 33 | 102 |

Selection: **E65/32/27 pair, 3C95** - lowest total loss with a feasible fill factor and 14 K rise; E55 does not fit the window, E70/PQ65 add volume without benefit. Planar alternative: a planar E64 with 4-layer PCB windings would need 28 turns of 2 mm2 (two 70 um layers in parallel per turn ... > 24 layers) - not practical at 800 V / 28 turns; planar construction is attractive only for n ~ 1 low-turn-count designs, so the conventional litz/bobbin construction is retained.

## 2. Selected transformer

| item | value |
|---|---|
| core | 2 x E65/32/27, 3C95, ungapped (Lm ~ 10.9 mH) |
| turns | N1 = 28, N2 = 14 (n = 2) |
| primary wire | litz 294 x 0.1 mm (2.31 mm2), 2 layers |
| secondary wire | litz 588 x 0.1 mm (4.62 mm2), 2 layers |
| arrangement | P/2 - S - P/2 interleaved; 3 x 50 um polyimide between P and S (reinforced), 6 mm margins |
| skin depth at 100 kHz, 100 C | 0.239 mm |
| Rac/Rdc | primary 1.04, secondary 1.08 |
| Bpk at 800 V | 0.132 T (Bsat 0.41 T at 100 C) |
| core loss | 11.4 W (Steinmetz x iGSE 1.22) |
| copper loss | 7.4 W at 9.2 / 18.5 A rms |
| temperature rise | 36 K at 3 m/s |
| leakage (HV side) | 4.1 uH interleaved, 16.4 uH non-interleaved |
| interwinding capacitance | 631 pF |
| window fill | 0.66 |

## 3. Integrated leakage option

The non-interleaved winding gives 16 uH (26 % of the 64 uH needed) with 1.16x the copper loss. A deliberate leakage layer (3 mm spacer between P and S) would reach ~40 uH but the tolerance on leakage of a hand-wound bobbin transformer is +/-20 %, which maps directly into +/-20 % power capability (eq. 4). The baseline keeps the leakage small and uses the discrete gapped inductor whose value is set by the gap (+/-5 %).

## 4. Series inductor

| item | value |
|---|---|
| core | 2 x E55/28/21, 3C95, gapped 2.10 mm (centre leg, fringing correction to be measured) |
| inductance | 59.9 uH |
| turns | 17 x litz 294 x 0.1 mm, 2 layers, kept 3 mm from the gap |
| Bpk at 1.2 x I_pk | 0.116 T |
| stored energy | 4.1 mJ |
| core loss | 4.6 W |
| copper loss | 2.5 W (Rac/Rdc 1.50 incl. fringing) |
| fill | 0.28 |

## 5. Insulation system (HV-LV basic, 850 V working, see 15_Safety_Reliability)

* Bobbin: glass-filled PBT/PET, CTI >= 400, 6 mm flanges; primary and secondary on separate bobbin halves is NOT used (interleaving needs a single bobbin), so the
  interwinding insulation is 3 layers of 50 um polyimide tape (each layer rated > 5 kV) plus 6 mm margin tape at both ends: creepage along the bobbin > 12 mm.
* Lead-outs: triple-insulated wire (TIW) for the primary exits, secondary litz with 0.4 mm PFA sleeve.
* High-frequency stress: the 100 kHz square voltage (dv/dt ~ 20 V/ns at the edges) drives displacement current through C_iw (~0.6 nF): i = C dv/dt ~ 12 A peak pulses - the
  Y-capacitors and the EMI filter (14) return this current; partial-discharge inception is not expected below 1 kV peak across 150 um polyimide but must be tested.
* Core bonded to the heatsink/chassis (PE) through a thermal pad; the core is at protective-earth potential, so the primary-to-core and secondary-to-core insulation is also basic (850 V / 450 V).

## 6. Test procedure (before assembly on the PCB)

1. Turns ratio and polarity (1 kHz, 1 V): N1/N2 = 2.00 +/- 1 %.
2. Lm at 100 kHz, 1 V: expect 10 mH class (ungapped 3C95), record; leakage with the secondary shorted: expect < 6 uH.
3. Winding resistance (4-wire): compare with the calculated DC values (R1 = 41.1 mOhm, R2 = 10.3 mOhm).
4. Interwinding capacitance at 100 kHz.
5. Hipot: 2.5 kVrms 60 s primary-secondary and 2.5 kVrms primary-core / secondary-core (basic, 850 V working); partial discharge screening at 1.5 x working voltage if the lab has the equipment.
6. Thermal run at rated current (back-to-back test with a second unit or on the converter at reduced voltage) - record hot-spot with a thermocouple under the outer layer.
7. Inductor: L at 0, 10, 20 A DC bias (must stay within -10 % at 24 A), gap measurement, hipot 1.5 kVrms winding-core.
