murugan-paramesh/SiC-DC-DC-Converter/SiC_6k6_Industrial_DAB/11_Control_Algorithms/control_design.md

# 11 - Digital control design

_Generated by `control_design.py`_

## 1. Plant and controller structure

Averaged model (03, eq. 10-12): the DAB is a current source into the LV link. The controller output is a **power command** and the modulator inverse (`phi_from_power`, current form) linearises it, so the loop gain does not depend on V1 or on the operating phase shift (without the feedforward K_phi varies from 26.6 to 36.6 A/rad between 650 and 850 V, a +/-15 % gain change that the PI would otherwise have to tolerate). The one-period computation delay plus the PWM update give T_d = 1.5 T_s = 15 us.

## 2. PI design

| item | value |
|---|---|
| LV capacitance (link + external) | 1.12 mF |
| plant pole at full load | 6 Hz |
| PI zero | 120 Hz (fc/5) |
| kp | 1689.0 W/V |
| ki | 1.27e+06 W/(V s) |
| crossover | 612 Hz |
| phase margin | 76 deg |
| gain margin | inf dB |
| anti-windup | clamping (integrate only when unsaturated) |
| output limits | +/- 1.1 P_rated, slew 2 kW/ms |

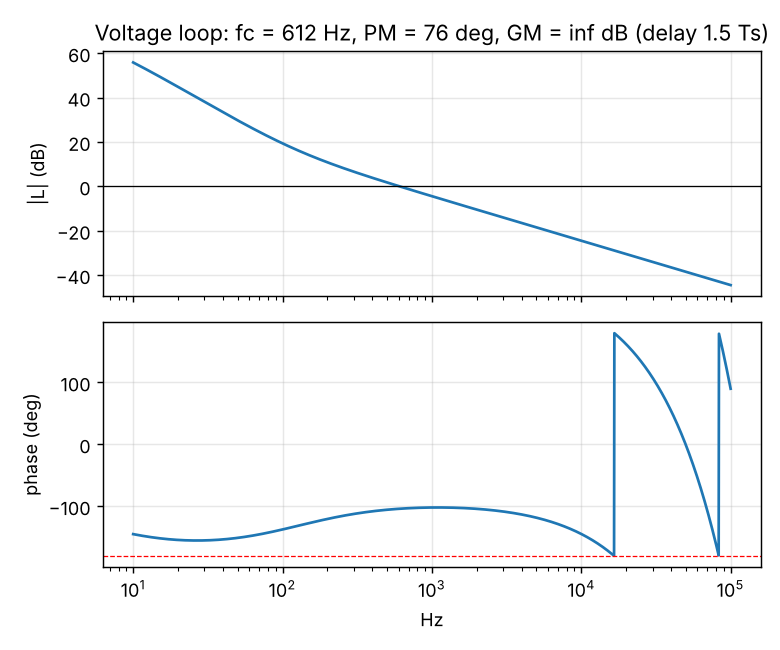
[picture p27: SiC_6k6_Industrial_DAB/11_Control_Algorithms/img/loop_bode.png]
bode


The 600 Hz crossover (f_s/167) keeps the delay phase lag at 3 deg and gives a 2.8 % dip for a 50 % load step in the switched simulation (05_Simulation), against the 3 % requirement EL-10. Quantisation: the C2000 EPWM has a 10 ns resolution (1/1000 of the period, 0.36 deg); the ADC is 12 bit (0.25 V on an 850 V range), both negligible against the 1 % regulation requirement.

## 3. Modulation comparison (analytical, HV-side rms current)

| V1/V2 | load | SPS I_rms / backflow / ZVS margin | EPS | DPS | TPS |
|---|---|---|---|---|---|
| 850/300 | 25 % | 6.1 A / 1378 W / -7.9 A | 4.8 A / 376 W / -1.0 A | 5.3 A / 150 W / -5.9 A | 4.4 A / 196 W / +1.0 A |
| 850/300 | 50 % | 7.5 A / 982 W / -4.7 A | 6.8 A / 43 W / -1.0 A | 7.5 A / 736 W / -7.4 A | - |
| 850/300 | 75 % | 9.5 A / 1022 W / -1.1 A | 9.2 A / 7 W / -0.7 A | 9.5 A / 539 W / -6.3 A | - |
| 850/300 | 100 % | 12.2 A / 1427 W / +3.2 A | 12.3 A / 84 W / +2.7 A | 12.2 A / 1418 W / +3.1 A | 12.1 A / 225 W / +4.6 A |
| 650/450 | 25 % | 6.1 A / 848 W / -8.8 A | 4.8 A / 463 W / -1.6 A | 5.1 A / -0 W / -6.4 A | - |
| 650/450 | 50 % | 7.2 A / 312 W / -6.0 A | 6.5 A / 92 W / -1.5 A | 7.2 A / 230 W / -8.8 A | - |
| 650/450 | 75 % | 9.0 A / 22 W / -2.8 A | 8.7 A / 1 W / -0.8 A | 9.0 A / 5 W / -5.6 A | - |
| 650/450 | 100 % | 11.3 A / 16 W / +0.9 A | 11.2 A / 59 W / +2.0 A | 11.3 A / 16 W / +0.9 A | 11.2 A / 25 W / +1.4 A |
| 800/400 | 25 % | 2.1 A / 13 W / +0.1 A | 2.1 A / 13 W / +0.1 A | 2.1 A / 13 W / +0.1 A | - |
| 800/400 | 50 % | 4.3 A / 60 W / +2.4 A | 4.3 A / 60 W / +2.4 A | 4.3 A / 60 W / +2.4 A | - |
| 800/400 | 75 % | 6.7 A / 149 W / +4.9 A | 6.7 A / 153 W / +5.0 A | 6.7 A / 153 W / +5.0 A | 6.8 A / 18 W / +0.4 A |
| 800/400 | 100 % | 9.2 A / 299 W / +7.7 A | 9.3 A / 304 W / +7.8 A | 9.3 A / 304 W / +7.8 A | 9.3 A / 300 W / +7.7 A |

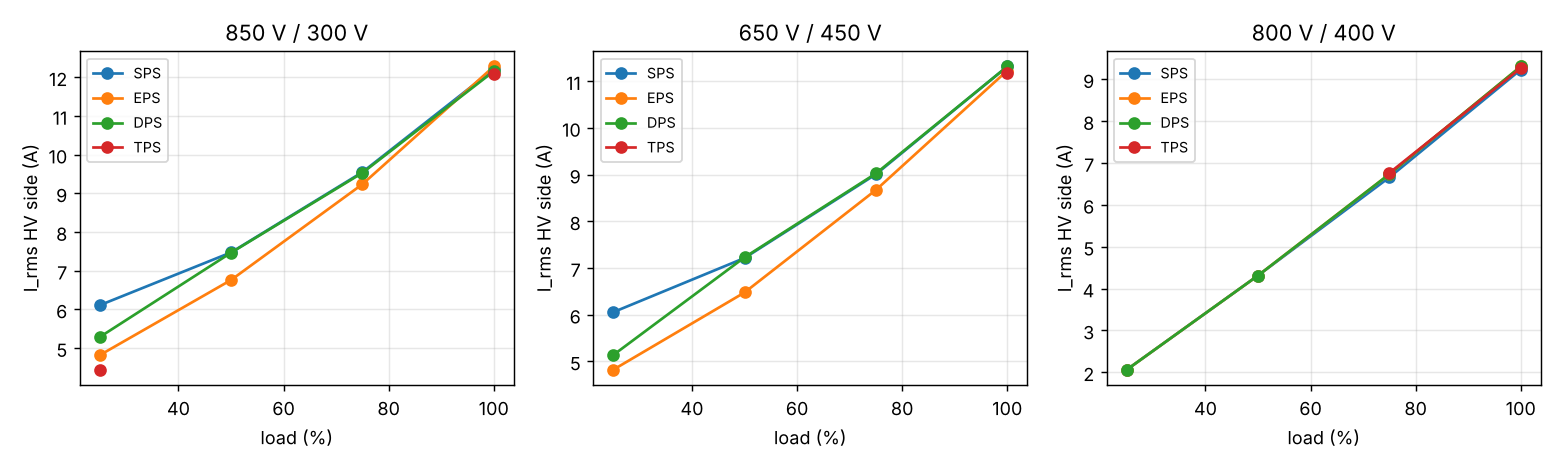
[picture p28: SiC_6k6_Industrial_DAB/11_Control_Algorithms/img/modulation_rms.png]
mod


EPS voltage matching (D of the higher-voltage bridge = d) removes most of the circulating power at d far from 1 and keeps ZVS at light load; it is the firmware default because it needs no table. TPS gives the lowest rms current but the gain over EPS is small at this ratio range; it is kept as an optional look-up table (12_Optimization). All modulation changes are applied by the ISR at the period boundary with the same feedforward, so the voltage loop sees the same linearised plant.

## 4. Model predictive control (research alternative)

An explicit one-step MPC with a disturbance observer on the averaged model gives a 0.1 V dip versus 1.5 V for the PI on a 50 % step; settling (1 V band) 0.0 ms vs 1.28 ms. The explicit form costs ~30 multiply-adds per ISR (equivalent to the PI), but it relies on the load estimate and the plant parameters (C2, delay); in the switched simulation the PI with feedforward already meets EL-08/EL-10, so the MPC remains a documented research option, not the baseline.

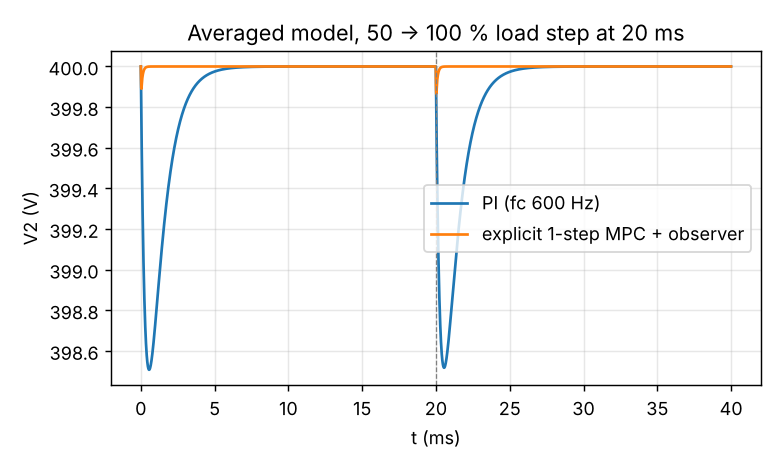
[picture p29: SiC_6k6_Industrial_DAB/11_Control_Algorithms/img/mpc_vs_pi.png]
mpc


## 5. Reverse power flow

In CP mode the power reference is signed; the feedforward returns a negative phi and the same PI trims the regulated port. The switched simulation (05) ramps +6.6 kW to -6.6 kW in 6.6 ms (2 kW/ms slew) with < 0.7 % excursion on either link.
