murugan-paramesh/SiC-DC-DC-Converter/Advanced_Research_2026/Reliability_Engineering/results/state_machine_report.md

# State-machine model check (generated by state_machine_check.py)

Reachable states from INIT: ['FAULT', 'INIT', 'PRECHARGE_WAIT', 'RUN', 'SOFTSTART']; transitions checked: 46080 (5 states x 4608 consistent input combinations x clear/no-clear)

| property | status | violations | summary |
|---|---|---|---|
| P1_literal | FAIL | 456 | INIT: ['v1_low'] (16); INIT: ['v2_low'] (16); INIT: ['v1_low', 'v2_low'] (16); INIT: ['comm_lost'] (16); INIT: ['comm_lost', 'v1_low'] (16); INIT: ['comm_lost', 'v2_low'] (16) |
| P1_conditional | PASS | 0 |  |
| P2_fault_latched | PASS | 0 |  |
| P3_gates_off_outside_run_softstart | PASS | 0 |  |
| P4_no_deadlock | PASS | 0 |  |
| P5_gates_imply_enable | PASS | 0 |  |

C-code conformance (sm_conformance.c against the unmodified dab_control.c): **PASS**, 46080 cases, 0 mismatches

Python reference controller (dabtools/dab/control.py) vs the C model: 71 mismatch classes over 23040 cases:

| state | C model next | Python next | distinguishing inputs | count |
|---|---|---|---|---|
| INIT | FAULT | INIT | ['driver_fault'] | 32 |
| INIT | FAULT | PRECHARGE_WAIT | ['driver_fault', 'enable'] | 32 |
| INIT | FAULT | INIT | ['hw_trip'] | 32 |
| INIT | FAULT | PRECHARGE_WAIT | ['hw_trip', 'enable'] | 32 |
| INIT | FAULT | INIT | ['driver_fault', 'hw_trip'] | 32 |
| INIT | FAULT | PRECHARGE_WAIT | ['driver_fault', 'hw_trip', 'enable'] | 32 |
| INIT | FAULT | INIT | ['driver_fault', 'pc_timeout'] | 32 |
| INIT | FAULT | PRECHARGE_WAIT | ['driver_fault', 'pc_timeout', 'enable'] | 32 |
| INIT | FAULT | INIT | ['hw_trip', 'pc_timeout'] | 32 |
| INIT | FAULT | PRECHARGE_WAIT | ['hw_trip', 'pc_timeout', 'enable'] | 32 |
| INIT | FAULT | INIT | ['driver_fault', 'hw_trip', 'pc_timeout'] | 32 |
| INIT | FAULT | PRECHARGE_WAIT | ['driver_fault', 'hw_trip', 'pc_timeout', 'enable'] | 32 |
| SOFTSTART | FAULT | INIT | ['driver_fault'] | 16 |
| SOFTSTART | FAULT | INIT | ['hw_trip'] | 16 |
| SOFTSTART | FAULT | INIT | ['driver_fault', 'hw_trip'] | 16 |

SIL harness (10_Firmware/sil/sil_main.c, compiled with gcc in a scratch directory): {'status': 'RUN', 'exit_code': 0, 'n_pass': 30, 'n_fail': 0, 'result_line': ['RESULT: ALL PASS (0 failures)'], 'build_warnings': ''}
