murugan-paramesh/SiC-DC-DC-Converter/21_Human_Friendly_Learning_Notes/18_Health_GateDrive_Reliability_Security.md

# 18 Health monitoring, gate drive, reliability and cybersecurity

> Reading time: ~45 min. Prerequisites: chapters 03 (SiC devices), 09 (state machine, protections),
> 10 (schematics), 12 (thermal) and 14 (safety, FMEA). Files covered:
> `Advanced_Research_2026/SiC_Health_Monitoring/`, `Advanced_Research_2026/Active_Gate_Drive/`,
> `Advanced_Research_2026/Reliability_Engineering/`, `Advanced_Research_2026/Cybersecurity/`,
> `Advanced_Research_2026/Verification_Evidence/KNOWN_ISSUES.md` (items 6-12).

## Overview

**Level 1 - Beginner:** A converter must not only work on day one; it must keep working safely for
years and must not be misused. This chapter covers four questions. Can we notice that a transistor is
slowly wearing out before it fails (health monitoring)? Is a clever "active" gate driver worth it, and is
the gate driver we chose safe against accidental turn-on (gate drive)? What combinations of part
failures could cause a hazard, and do our protections catch them (reliability)? Could someone on the
communication bus switch the converter on or keep it running when they should not (cybersecurity)?
Every answer here comes from calculations and simulations; the wear-out data are invented (SYNTHETIC)
because no device was ever aged, and no safety rating or certification is claimed.

**Level 2 - Engineering:** On SYNTHETIC data, a temperature-compensated Rds_on estimator with weekly
CUSUM detects a 1 % drift within 1-7 weeks with zero false alarms in 3 years - provided the temperature
reference drifts by less than ~1 K over life; a 2 K drift gives false alarms in every run. The gate-drive
study finds that under ZVS the node dv/dt is set by I / (2 Coss) (15-31 V/ns), not by Rg, so an active
gate driver is not worth it; the real finding is a crosstalk margin of about 0 V (HV) and negative (LV)
with the schematic's -3 V off bias, while `dabtools/dab/devices.py` assumed -4 V. The fault tree shows
that every leading cut set of the shoot-through top event contains "no DESAT"; a DESAT driver divides it
by ~99. The exhaustive check of 46 080 state-machine transitions finds 0 mismatches against
`SiC_6k6_Industrial_DAB/10_Firmware/src/dab_control.c`. The command interface is unauthenticated today;
an AES-128-CMAC frame with a replay counter is demonstrated in host Python.

**Level 3 - Research:** Condition monitoring of SiC MOSFETs (Rds_on, Vth, gate-switching signatures) is an
active field, but most papers rely on accelerated-test data the project does not have; the honest
deliverable here is a sensor requirement, not a remaining-useful-life (RUL) prediction. Active gate
drivers are a hot topic for hard-switched SiC; this study shows why they have little to act on in a ZVS
DAB. FTA and FMEDA use assumed class failure rates, so they rank weaknesses but give no SIL. IEC 62443
applicability is mapped at the component level, with a target security level proposed, not assessed.

## Topic 1: SiC health monitoring on SYNTHETIC data

### Rds_on drift estimators, CUSUM detection and the temperature-reference requirement
**What is it?** A feasibility study: could the project's sensing chain detect a 1 % rise of the
on-resistance of an HV MOSFET (C3M0032120K), the classic indicator of bond-wire and die-attach fatigue,
and what would a V_ds,on sensor need? All data are SYNTHETIC. `[Simulated]` (L2 on synthetic data)

**Why do we need it?** Power cycling ages the package; detecting the drift early would allow planned
maintenance. Before building sensors one must know whether the drift is even resolvable.

**How does it work?**
**Level 1 - Beginner:** A worn transistor gets slightly more resistive, like a garden hose getting
furred up. We measure the voltage across it while it conducts and the current through it, and divide.
The trouble is that the resistance also rises when the device is warm - by about 0.5 % per degree - so a
1-degree error in temperature looks like half the wear we want to detect. Averaging a week of
measurements removes random noise, but a slowly drifting thermometer cannot be averaged away.
**Level 2 - Engineering:** Generator (`Advanced_Research_2026/SiC_Health_Monitoring/01_generate_synthetic_data.py`):
3 years hourly mission, Tj from the thermal network (20-53 C - this converter runs cold), damage
N_f = A dTj^-4.4 exp(0.08 eV / kB Tm), dR/R0 = 0.05 D^1.5, A calibrated so D = 1 at 2.5 years (a scenario
choice, not a lifetime estimate), plus a Vth drift of 0.08 V log10(1 + t / 100 h). Estimators: R25_hat =
(V_ds / I_d) rds(25) / rds(T_meas) with samples below 40 % of nominal current discarded; 2-parameter RLS
(forgetting 0.9995) that also estimates the tempco; a Kalman filter on [level, rate]; CUSUM on weekly
means in relative units, g = max(0, g + (block / mu0 - 1) - k), k = 0.5 %, baseline the first 13 weeks.
**Level 3 - Research:** Bond-wire fatigue and gate-oxide Vth drift both raise Rds_on and cannot be
separated from Rds_on alone; the Vth share (~0.6 % of 7.1 % after 3 years) is below detection anyway.
A first CUSUM standardised with a 13-week sigma gave 60-90 % false alarms - a documented negative result
fixed by the relative-units design.

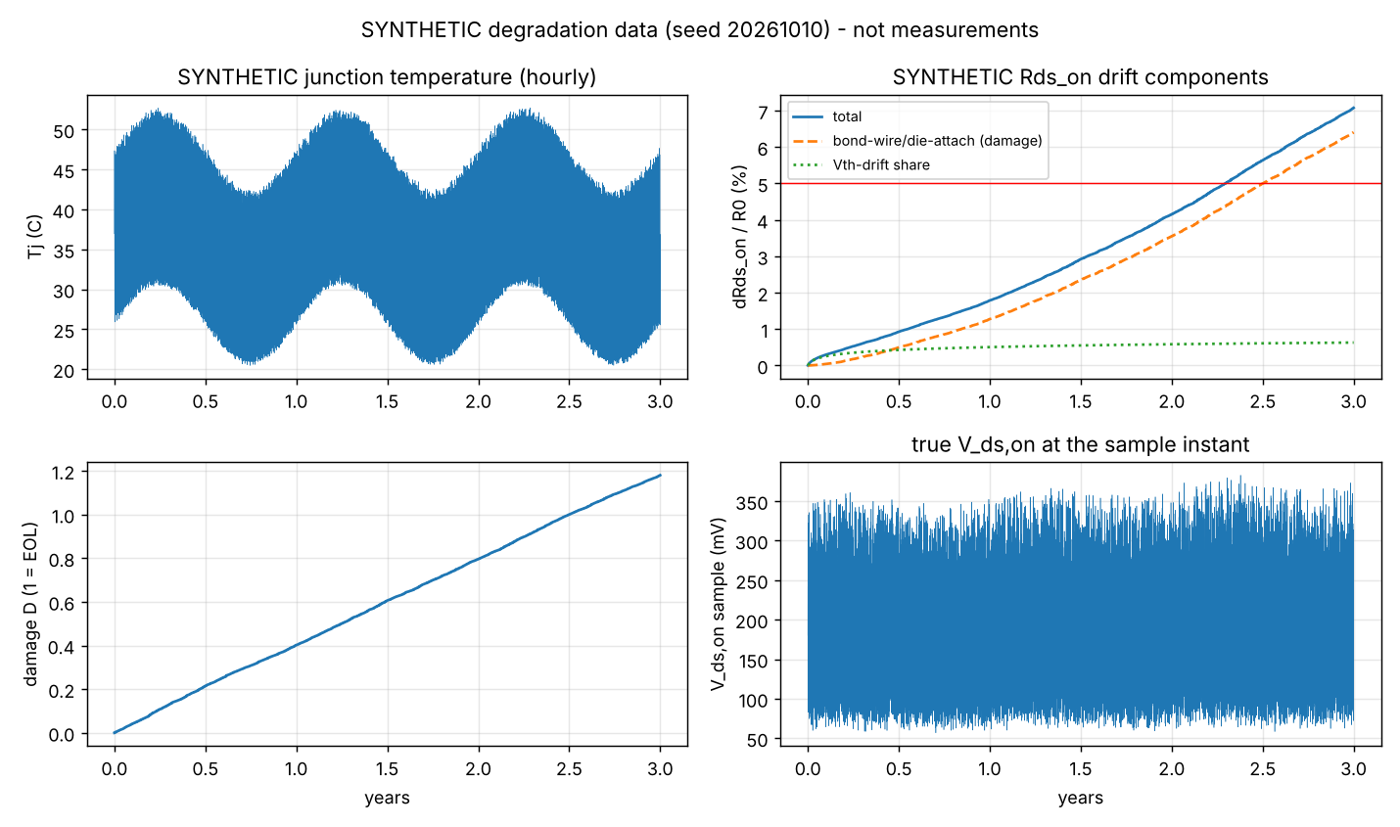
[picture p42: Advanced_Research_2026/SiC_Health_Monitoring/results/fig_synthetic_truth.png]
synthetic truth


*Figure 18-1: SYNTHETIC degradation truth (module result figure) - generated, not measured.*

**Example from our converter:** `Advanced_Research_2026/SiC_Health_Monitoring/results/detection_tables.md`
(24 Monte-Carlo noise realisations, SYNTHETIC):

| temperature sensor | h | false alarms (healthy, 3 y) | detection | alarm vs 1 % crossing, mean / p90 (days) |
|---|---|---|---|---|
| heatsink NTC (current design) | 0.5 % | 0.00 | 1.00 | -3 / +8 |
| heatsink NTC | 2.0 % | 0.00 | 1.00 | +36 / +45 |
| case sensor | 0.5 % | 0.00 | 1.00 | +1 / +10 |
| junction model (1 K slow bias) | 0.5 % | 0.62 | 1.00 | -41 / +1 |
| junction model | 2.0 % | 0.00 | 1.00 | +26 / +90 |

Sensitivity (case sensor, h = 2 %): random temperature noise up to 10 K and load-dependent offsets are
harmless; a slow sensor drift of 1 K over 3 years gives 0 false alarms, **2 K gives false alarms in every
realisation**. `[Simulated]` (SYNTHETIC)

**Engineering calculations:** datasheet-typical R25 = 32 mOhm, R150 = 52 mOhm (`verified=False` in
`dabtools/dab/devices.py`): (52 - 32) / 32 / 125 K = 0.5 %/K of R25, so 1 K error = 0.5 % apparent drift,
one tenth of the 5 % end-of-life criterion. Sensor requirement (analytic 3-sigma of a weekly mean,
random errors only): 1 mV rms V_ds noise -> 0.20 % (0.5 K) to 1.09 % (10 K); 10 mV rms -> 1.36 % even at
0.5 K, i.e. a 10 mV-class channel cannot resolve 1 %. Modelled chain LSB 0.39 mV at the device.

**Design decision made in this project:** No V_ds,on sensor exists in rev A. A desaturation-detector-style
sense (1200 V diode, 1 mA source, ~5 V clamp, 1:4 divider, AMC1301, TLV9062, ADC sampled at mid-conduction
with >= 300 ns blanking) on at least Q1 and Q5 is proposed, with requirements <= 0.4 mV resolution,
< 50 ppm/K gain drift, a sampled instantaneous current within 0.5 % and a temperature reference within
1 K of Tj over the service life. `[Proposed]` (not in the schematic, not simulated at circuit level)

**Alternatives considered:** A Vth measurement circuit (proposed only); a junction-temperature model (a 1 K
slow bias gives 62 % false alarms at h = 0.5 %); gate-signature methods (L12, L39, L40).

**How to verify it:** Run `Advanced_Research_2026/SiC_Health_Monitoring/02_estimators_and_detection.py`
(deterministic seeds, < 20 s) to reproduce the tables. Real verification needs power-cycled devices and
measured drift - none exist. `[Not yet tested]`

**Common mistakes:** Quoting the detection delay in days as a device property (it scales with the assumed
drift rate); using the Kalman rate for RUL (it extrapolates the assumed law); dropping the SYNTHETIC label.

**Interview explanation (30 s):** "On synthetic data, a temperature-compensated Rds_on estimator with a
weekly CUSUM detects a 1 percent drift in one to seven weeks with no false alarms in three years. The
catch is temperature: Rds_on moves 0.5 percent per kelvin, so the reference must not drift more than about
1 kelvin over life - at 2 kelvin every run false-alarms. We give a sensor requirement, not a lifetime
prediction."

**Research-level explanation:** The dominant risk is a slow systematic error - NTC ageing, thermal-interface
degradation changing the NTC-to-junction offset, or a sensor replacement - exactly what a synthetic study
cannot bound. A defensible research path is a power-cycling test with a reference V_ds,on measurement and
a periodic self-check of the temperature reference against the heatsink NTC; RUL claims must wait for
measured aging data (see L11, L41, L42 in the literature database).

## Topic 2: Active gate drive and the gate-bias discrepancy

### What sets dv/dt in a ZVS DAB, and the -3 V versus -4 V crosstalk margin
**What is it?** An analytic comparison of gate-drive options for the C3M0032120K (HV, 800 V) and
C3M0016120K (LV, 400 V): fixed Rg, the current two-level 3.3 / 1.5 Ohm network, the same with -4 V bias,
with a Miller clamp, slow 10 / 10 Ohm, and a multi-level active driver concept. `[Simulated]` (L1 analytic)

**Why do we need it?** dv/dt drives EMI and crosstalk; active gate drivers are often proposed to shape it.
We must know whether they help in a DAB, and whether the chosen driver keeps the off device off.

**How does it work?**
**Level 1 - Beginner:** When one transistor of a leg switches, the voltage across its partner changes very
fast. Through a tiny internal capacitance this pushes current into the partner's gate and can lift it
towards its turn-on threshold - an accidental turn-on. A negative off voltage on the gate is the safety
margin. In soft (ZVS) switching the speed of the voltage change is set by the load current charging the
device capacitances, not by the gate resistor, so a clever driver has little to control.
**Level 2 - Engineering:** Under ZVS the turn-off is capacitive: dv/dt = I_sw / (2 Coss,tr), independent of
Rg. Crosstalk: V_gs,ind = Voff + R_off (Qgd / V) dv/dt (1 - exp(-t_tr / tau_off)), margin to
Vth,min(150 C) = 1.8 V; Miller clamp modelled as R_off -> 1 Ohm + Rg_int. Hard-switched light-load points:
3 A (HV) and 6 A (LV), just above I_min = 2.0 / 3.1 A.
**Level 3 - Research:** The quasi-static gate-charge method is pessimistic at the start of the slope and
optimistic near its end; a transient Cgd(V) model would move margins by +/-1 V. In a ZVS leg an induced
bump re-conducts the device that just turned off (self-limiting, extra loss); in the hard-switched
light-load region it is genuine cross-conduction.

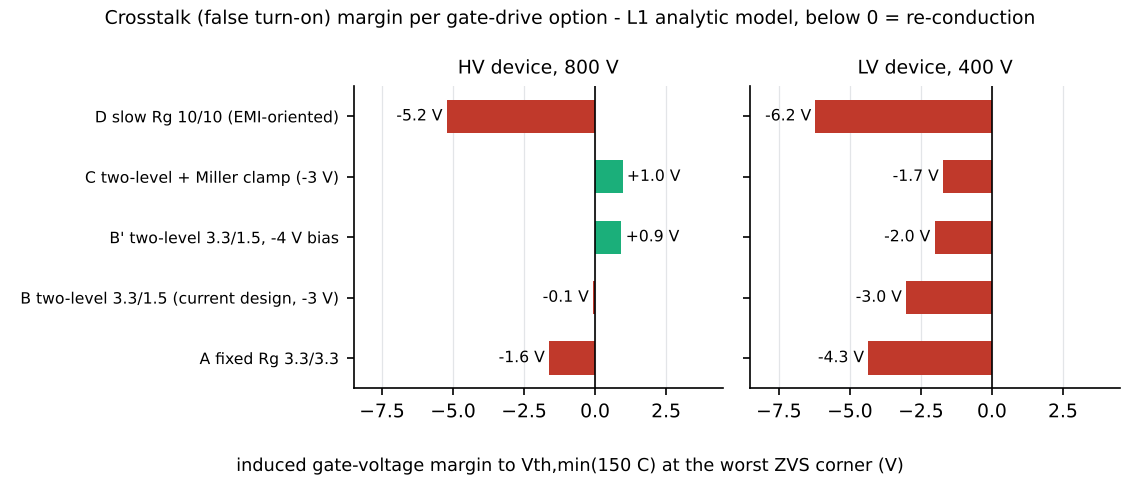
[picture p43: 21_Human_Friendly_Learning_Notes/img/ch18_crosstalk_margin.png]
crosstalk margin


*Figure 18-2 (`img/make_figs_ch17_18.py`, data from the module's gate_drive_results.json): worst-corner
ZVS crosstalk margin per option.*

**Example from our converter:** `Advanced_Research_2026/Active_Gate_Drive/results/option_table.md`:

| option | HV margin ZVS nom / worst (V) | LV margin ZVS nom / worst (V) | HV hard E_on+off at 3 A (uJ) |
|---|---|---|---|
| B current 3.3 / 1.5 Ohm, -3 V | +2.3 / -0.1 | -0.4 / -3.0 | 91 |
| B' same with -4 V | +3.3 / +0.9 | +0.6 / -2.0 | 91 |
| C current + Miller clamp, -3 V | +2.9 / +1.0 | +0.9 / -1.7 | 91 |
| D slow 10 / 10 Ohm | -1.7 / -5.2 | -4.7 / -6.2 | 110 |

ZVS dv/dt 15 V/ns nominal, ~30 V/ns at the worst corners, on both bridges, for every option. `[Simulated]`

**Engineering calculations:** Hard turn-on at 3.3 Ohm: 31 V/ns and 91 uJ per on/off pair, i.e. 9.1 W per
edge position at 100 kHz if continuous; 10 Ohm costs +20 % energy for -40 % dv/dt. Ringing bound at the
end of a worst-corner capacitive commutation I sqrt(L_loop / C_leg) ~ 95 V (HV) / 90 V (LV), inside the
1200 V rating. ZVS turn-off loss by this model 0.16 / 0.31 uJ per edge, far below the conservative
0.35 x Eoff assumption of the loss model (19 / 42 uJ) - the truth is in between and needs measurement.

**Design decision made in this project:** Active gate drive is **not worth its complexity** for this
converter. Recommended instead: resolve the bias to -4 V (or -5 V) and move to a Miller-clamp + DESAT
driver (UCC21710 class), the documented upgrade path in `SiC_6k6_Industrial_DAB/16_BOM/bom.md`. Rev A uses
UCC21520DW (no DESAT, no Miller clamp), Rg_on 3.3 Ohm / Rg_off 1.5 Ohm and R12P21503D bias modules
(+15 / -3 V). `[Implemented]` (rev A as drawn) / `[Proposed]` (the change)

**Alternatives considered:** Rg_off below 1.5 Ohm (Rg_int dominates); snubber capacitance (costs ZVS range);
a closed-loop dv/dt driver (nothing to act on under ZVS).

**How to verify it:** `python3 Advanced_Research_2026/Active_Gate_Drive/gate_drive_analysis.py` (< 5 s, no
random numbers). Then measure v_GS of the off device at 25 / 50 / 100 % load (test plan step 8) - not done;
gate-loop SPICE also absent. `[Not yet tested]`

**Common mistakes:** Assuming Rg controls dv/dt in a ZVS converter; slowing the gate "for EMI" (option D
makes crosstalk worse: -5.2 / -6.2 V); trusting a negative-bias value from a model file instead of the
schematic; forgetting that Ciss, g_fs, Rg_int and Vth,min(150 C) in the script are recalled values to verify.

**Interview explanation (30 s):** "In a ZVS DAB the switching node slews at the load current divided by
twice Coss - 15 to 30 volts per nanosecond - whatever the gate resistor. So an active gate driver has
nothing to act on. The real finding was crosstalk: with the schematic's minus 3 volt bias the margin is
about zero on the HV side and negative on the LV side, so we recommend minus 4 volts and a Miller-clamp
plus DESAT driver."

**Research-level explanation:** The literature on active gate drivers (L21, L22, L44, L45) targets
hard-switched SiC where turn-on di/dt and overshoot are Rg-controlled. In a DAB the hard-switched region is
light load, where the loss penalty of a slow passive Rg is small in absolute terms. The open measurement
item is the LV device (Qgd 62 nC, low Rg_int), whose self-limiting dv/dt is only 12 V/ns at -3 V - below
the nominal 15 V/ns.

## Topic 3: Fault tree analysis (FTA)

### Minimal cut sets for four top events
**What is it?** Fault trees for TE1 hazardous voltage at an accessible part, TE2 overcurrent / shoot-through
not interrupted within the device withstand time, TE2b = TE2 and the fuse fails, and TE3 thermal runaway,
with 32 basic events and minimal cut sets by boolean expansion. `[Simulated]` (L1, assumed rates)

**Why do we need it?** An FMEA (chapter 14) looks at one failure at a time; a fault tree shows which
combinations lead to a hazard and which single item dominates.

**How does it work?**
**Level 1 - Beginner:** Start from the bad outcome ("an uncontrolled short circuit") and ask "what must go
wrong for this?" - one thing, or two things together. A "cut set" is a smallest group of failures that
together cause the outcome. If one missing feature appears in every important group, fixing it helps most.
**Level 2 - Engineering:** Rates in FIT (1e-9 / h) of the IEC TR 62380 / SN 29500 class, entered as
assumptions; detected failures repaired in 48 h, latent ones revealed by an annual proof test
(unavailability lambda T / 2); `NO_DESAT` is a house event (TRUE for the UCC21520); rare-event
approximation; Fussell-Vesely importance per basic event.
**Level 3 - Research:** A static FTA ignores sequence and repair-time distributions, and demand-type events
(ACCESS, SW_PWM, TZ_CFG) are placeholders. Its value is ranking, not absolute probability.

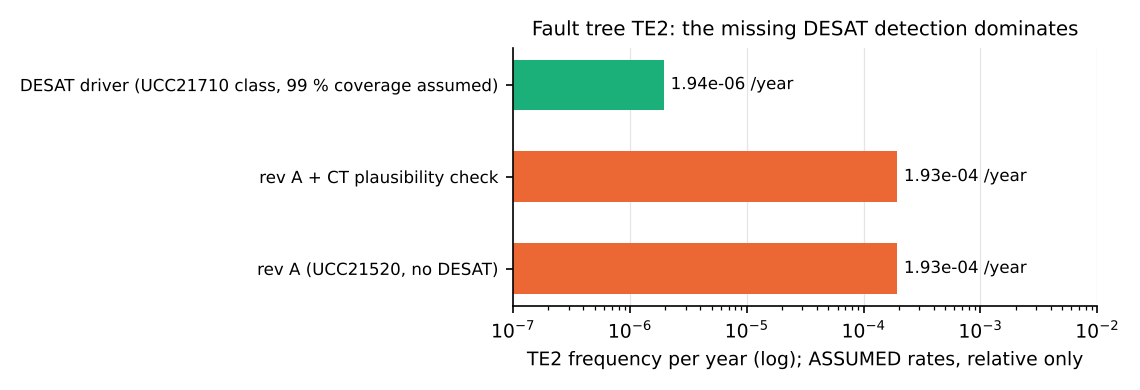
[picture p44: 21_Human_Friendly_Learning_Notes/img/ch18_te2_variants.png]
TE2 variants


*Figure 18-3 (`img/make_figs_ch17_18.py`, data from the module's fta_cutsets.json): TE2 frequency for rev A,
with a CT plausibility check, and with a DESAT driver.*

**Example from our converter:** `Advanced_Research_2026/Reliability_Engineering/results/fta_cutsets.md`:

| top event | cut sets | lowest order | frequency (/year) | dominant cut sets |
|---|---|---|---|---|
| TE1 hazardous voltage | 6 | 1 | 1.4e-4 | ISO_BIAS 50 %, ISO_DRV 25 %, ISO_AMC 22 % |
| TE2 overcurrent not interrupted | 21 | 2 | 1.9e-4 | DRV_HIGH + NO_DESAT 36 %, MCU + NO_DESAT 23 %, XTALK + NO_DESAT 23 %, UVLO + NO_DESAT 18 % |
| TE2b and fuse fails | 21 | 3 | 1.7e-9 | FUSE + NO_DESAT + SW_PWM 51 % |
| TE3 thermal runaway | 15 | 3 | 1.7e-9 | FAN + NTC + HOST 74 % |

Variants: DESAT driver (99 % coverage assumed) 1.94e-6 / year (ratio 99.2); CT plausibility check leaves TE2
unchanged (1.93e-4); NTC plausibility check reduces TE3 to 3.8e-10 (4.4x). `[Simulated]`

**Engineering calculations:** TE2 rev A / DESAT = 1.93e-4 / 1.94e-6 = 99.2. Fussell-Vesely of NO_DESAT is
1.00 in rev A: every relevant TE2 cut set contains it. In TE1 the eight bias modules (ISO_BIAS, 7.0e-5 /
year) are the largest contributor - they are basic-class parts (R12P21503D, 5.2 kVDC), confirming open item
15.1-4 of `SiC_6k6_Industrial_DAB/15_Safety_Reliability/01_insulation_coordination.md`.

**Design decision made in this project:** Next hardware revision: DESAT-capable drivers, reinforced-rated
bias modules, an NTC plausibility check. `[Proposed]` (KNOWN_ISSUES item 9)

**Alternatives considered:** A leg-current shunt with a fast comparator instead of DESAT.

**How to verify it:** `python3 Advanced_Research_2026/Reliability_Engineering/fta.py` (< 2 s) regenerates
the cut sets; the trees are in `Advanced_Research_2026/Reliability_Engineering/results/fta_trees.md`. The
absolute numbers cannot be verified without manufacturer FIT data and field data. `[Simulated]`

**Common mistakes:** Reading 1.9e-4 / year as a real hazard rate; claiming a SIL from an FTA; forgetting
that the CT sees the inductor current, not the leg current, so only the fuse (milliseconds) stops a
shoot-through in rev A.

**Interview explanation (30 s):** "The fault tree for an uninterrupted shoot-through has 21 minimal cut
sets and every important one contains 'no desaturation detection'. With a DESAT driver the frequency
drops by about a hundred. For hazardous voltage the eight basic-class bias modules are the biggest
single-point contributor. The rates are assumptions, so this ranks weaknesses - it is not a safety rating."

**Research-level explanation:** Dynamic fault trees or Markov models would capture the repair and proof-test
sequence; common-cause beta factors (e.g. one supply feeding several drivers) are absent. The robust
conclusion survives any reasonable rate choice because it is structural: rev A has no detection path for
leg shoot-through below the fuse.

## Topic 4: FMEDA-lite and the LV-sensor common cause
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
