murugan-paramesh/SiC-DC-DC-Converter/21_Human_Friendly_Learning_Notes/17_Advanced_Control_MPC_AI_RL.md

# 17 Advanced control: MPC, embedded AI, safe RL and physics-informed models

> Reading time: ~45 min. Prerequisites: chapters 04 (DAB operation, ZVS), 05 (models), 08 (switched
> simulation) and 09 (PI loop, modulator inverse). Files covered: `Advanced_Research_2026/Adaptive_MPC/`,
> `Advanced_Research_2026/Embedded_AI/`, `Advanced_Research_2026/Safe_RL_Research/README.md`,
> `Advanced_Research_2026/Physics_Informed_Models/README.md` and their `results/` folders.

## Overview

**Level 1 - Beginner:** Chapter 09 described the controller the converter actually uses: a simple PI
loop that compares the output voltage with 400 V and asks for more or less power. This chapter asks
whether a "smarter" controller does better: model predictive control (the controller looks a few steps
ahead), a small neural network inside the microcontroller, reinforcement learning (learning by trial
and error) and physics-informed neural networks. Every experiment ran only on a computer model. The
answer is that the simple tools are mostly good enough here. Prediction helps for sudden load changes,
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
