murugan-paramesh/SiC-DC-DC-Converter/21_Human_Friendly_Learning_Notes/img/ch01_inductor_voltseconds.png

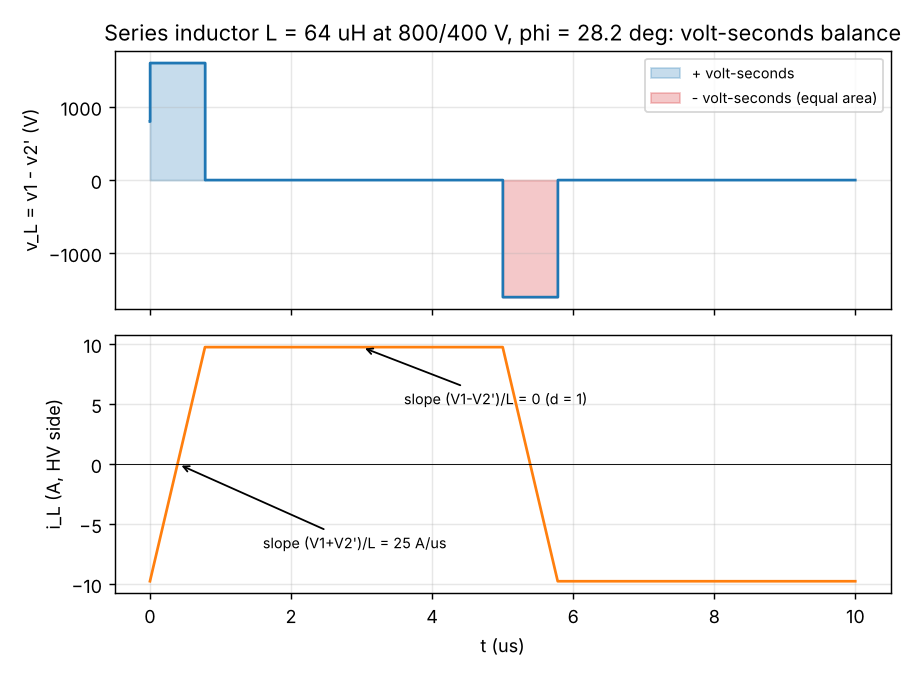
21_Human_Friendly_Learning_Notes/img/ch01_inductor_voltseconds.png
