murugan-paramesh/SiC-DC-DC-Converter/21_Human_Friendly_Learning_Notes/img/ch01_rms_avg_peak.png

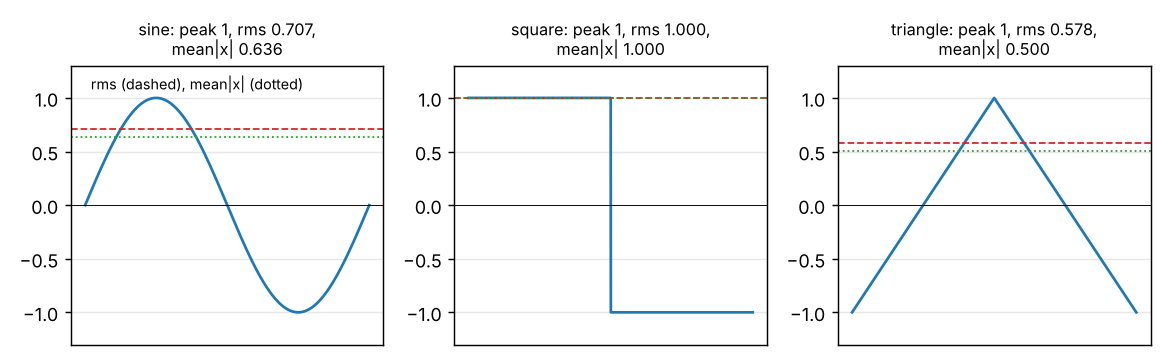
21_Human_Friendly_Learning_Notes/img/ch01_rms_avg_peak.png
