murugan-paramesh/SiC-DC-DC-Converter/21_Human_Friendly_Learning_Notes/img/ch02_hard_vs_soft.png

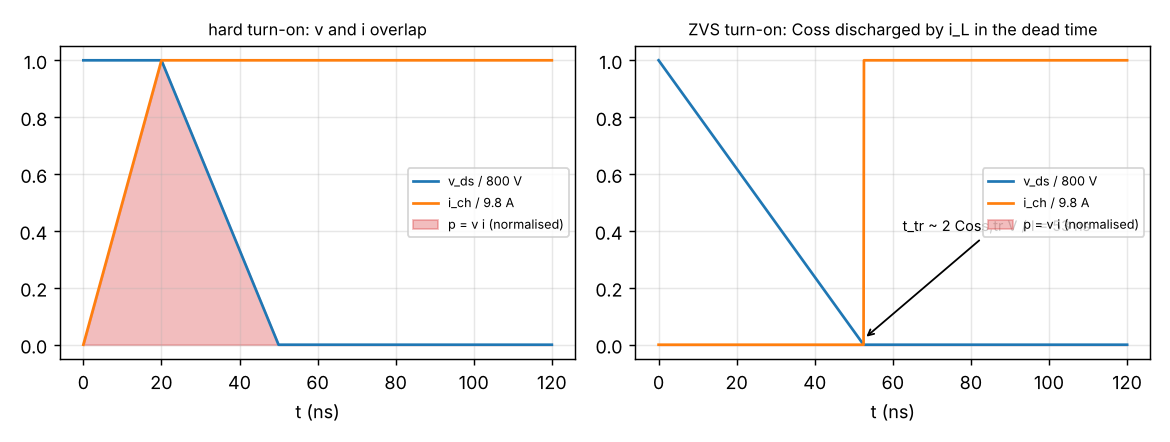
21_Human_Friendly_Learning_Notes/img/ch02_hard_vs_soft.png
