murugan-paramesh/SiC-DC-DC-Converter/21_Human_Friendly_Learning_Notes/img/ch03_rds_vs_tj.png

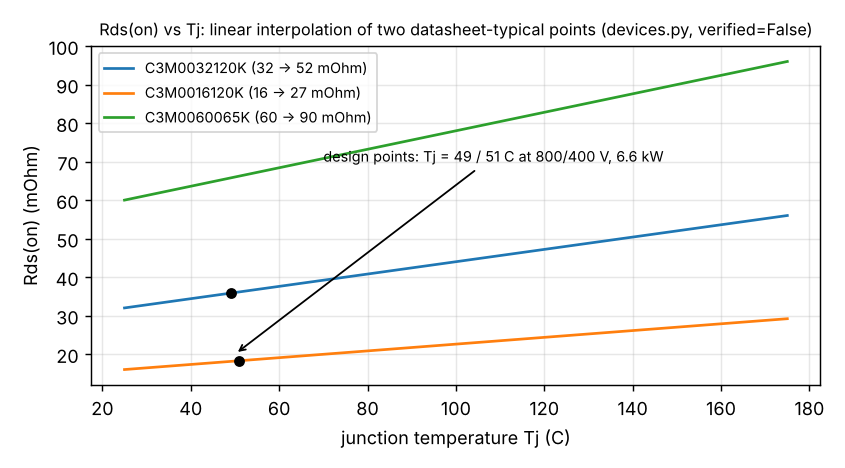
21_Human_Friendly_Learning_Notes/img/ch03_rds_vs_tj.png
