murugan-paramesh/SiC-DC-DC-Converter/21_Human_Friendly_Learning_Notes/img/ch03_zvs_current_min.png

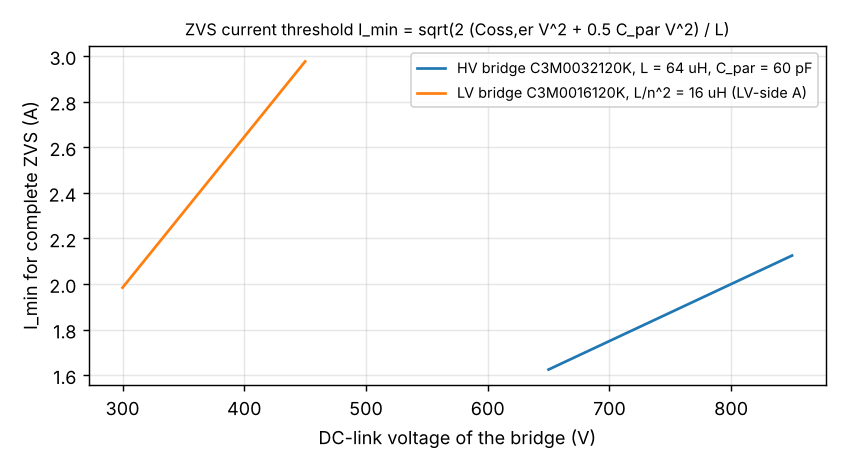
21_Human_Friendly_Learning_Notes/img/ch03_zvs_current_min.png
