murugan-paramesh/SiC-DC-DC-Converter/21_Human_Friendly_Learning_Notes/img/ch04_edge_currents_vs_d.png

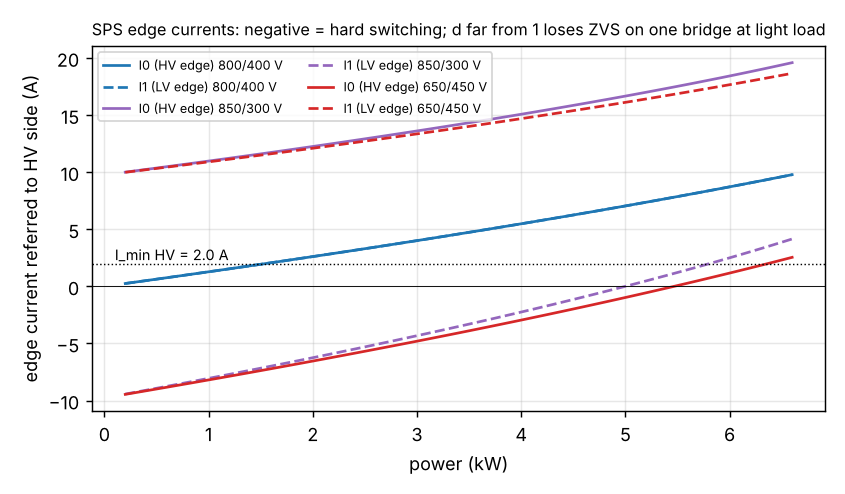
21_Human_Friendly_Learning_Notes/img/ch04_edge_currents_vs_d.png
