murugan-paramesh/SiC-DC-DC-Converter/21_Human_Friendly_Learning_Notes/img/ch04_power_vs_phi.png

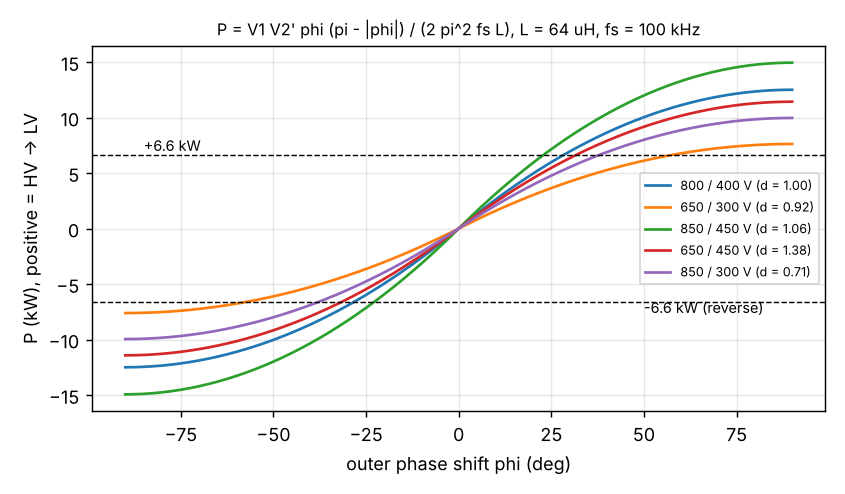
21_Human_Friendly_Learning_Notes/img/ch04_power_vs_phi.png
