murugan-paramesh/SiC-DC-DC-Converter/21_Human_Friendly_Learning_Notes/img/ch04_waveforms_three_ratios.png

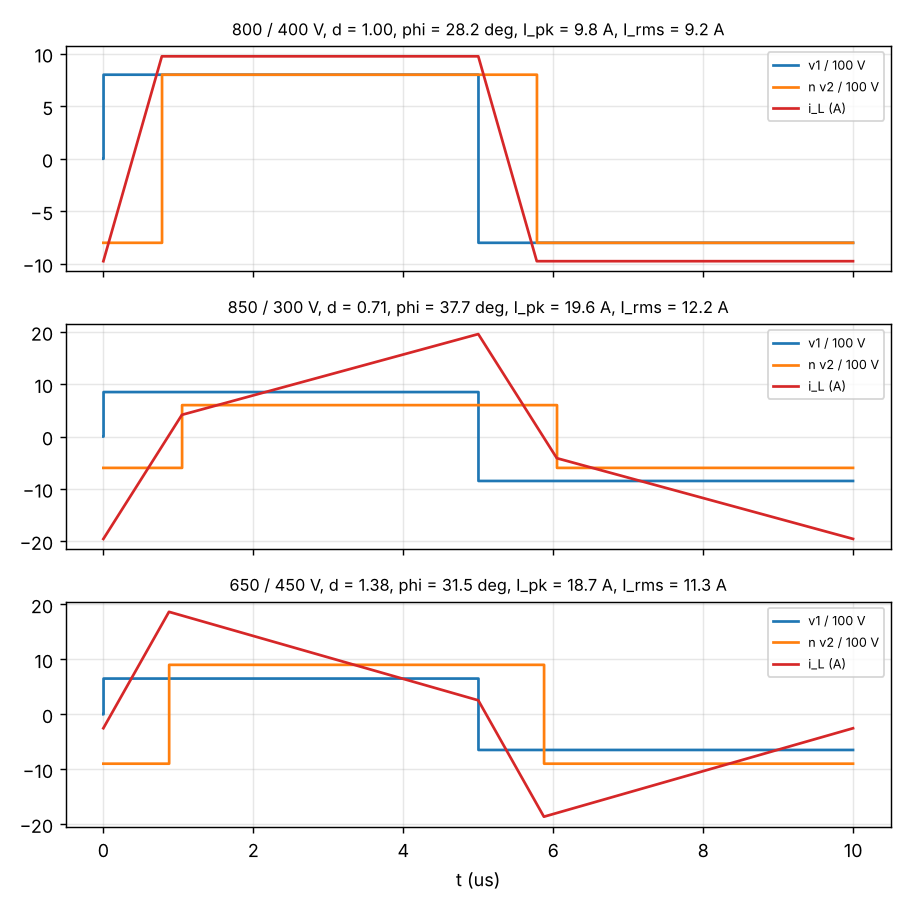
21_Human_Friendly_Learning_Notes/img/ch04_waveforms_three_ratios.png
