murugan-paramesh/SiC-DC-DC-Converter/21_Human_Friendly_Learning_Notes/img/ch05_averaged_gain.png

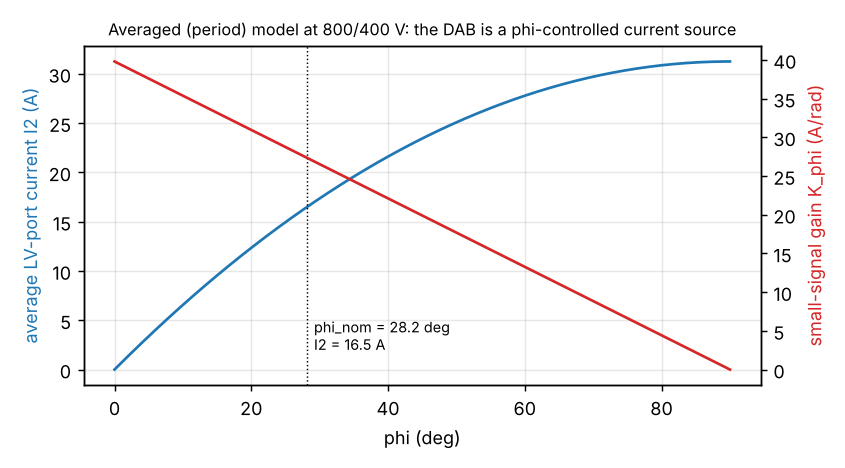
21_Human_Friendly_Learning_Notes/img/ch05_averaged_gain.png
