murugan-paramesh/SiC-DC-DC-Converter/21_Human_Friendly_Learning_Notes/img/ch05_closed_vs_numeric.png

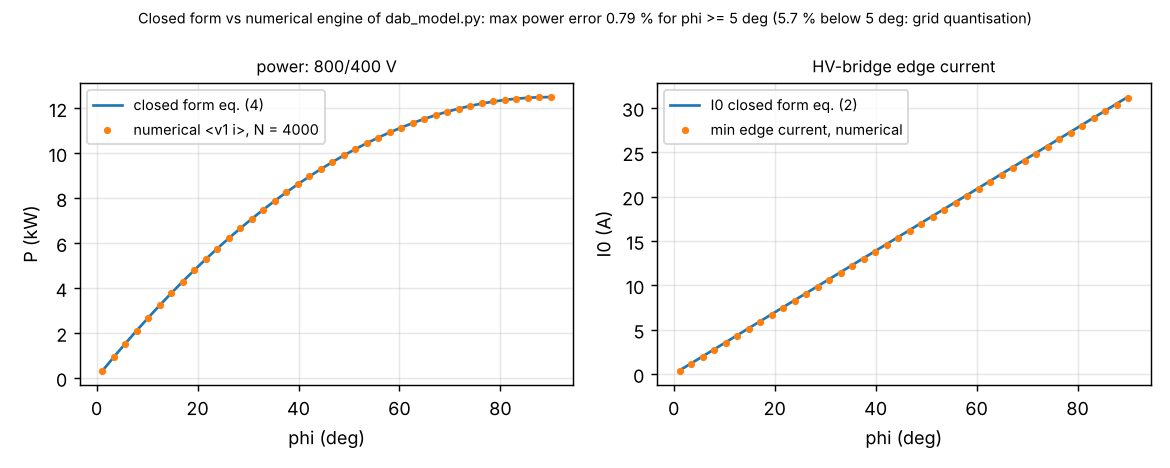
21_Human_Friendly_Learning_Notes/img/ch05_closed_vs_numeric.png
