murugan-paramesh/SiC-DC-DC-Converter/21_Human_Friendly_Learning_Notes/img/ch05_regressor_1_over_L.png

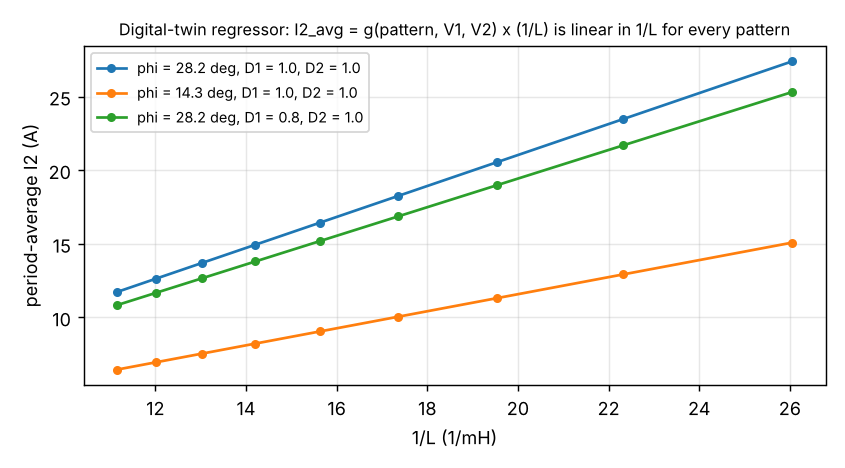
21_Human_Friendly_Learning_Notes/img/ch05_regressor_1_over_L.png
