murugan-paramesh/SiC-DC-DC-Converter/21_Human_Friendly_Learning_Notes/img/ch11_router_halos.png

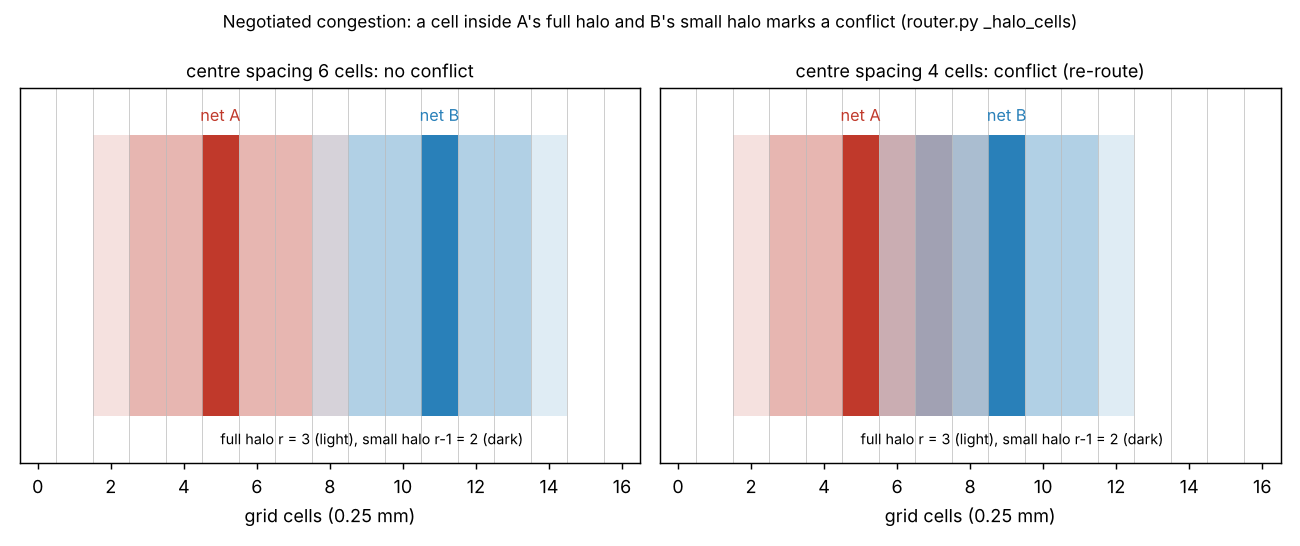
21_Human_Friendly_Learning_Notes/img/ch11_router_halos.png
