murugan-paramesh/SiC-DC-DC-Converter/21_Human_Friendly_Learning_Notes/img/ch12_thermal_chain.png

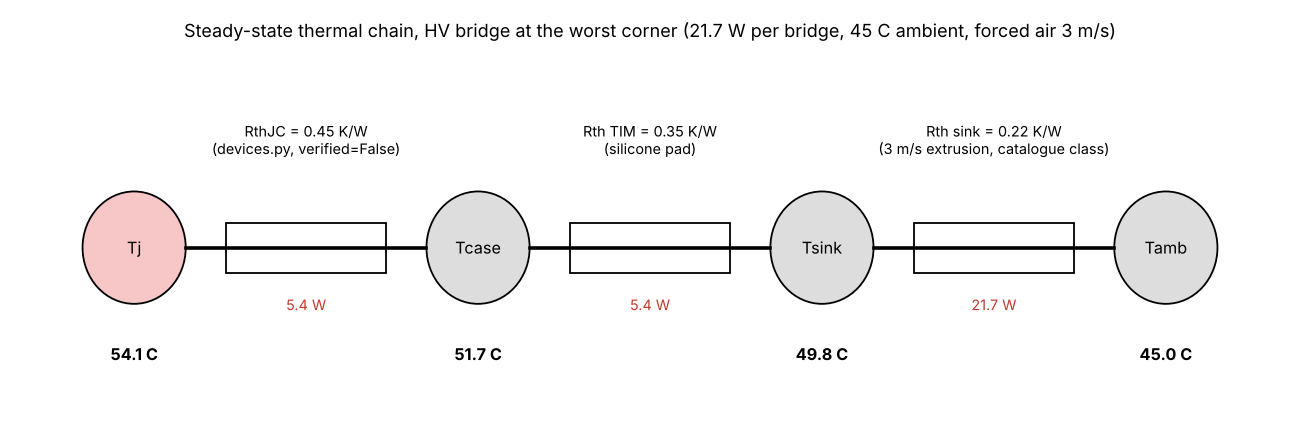
21_Human_Friendly_Learning_Notes/img/ch12_thermal_chain.png
