murugan-paramesh/SiC-DC-DC-Converter/21_Human_Friendly_Learning_Notes/img/ch13_dm_cm_paths.png

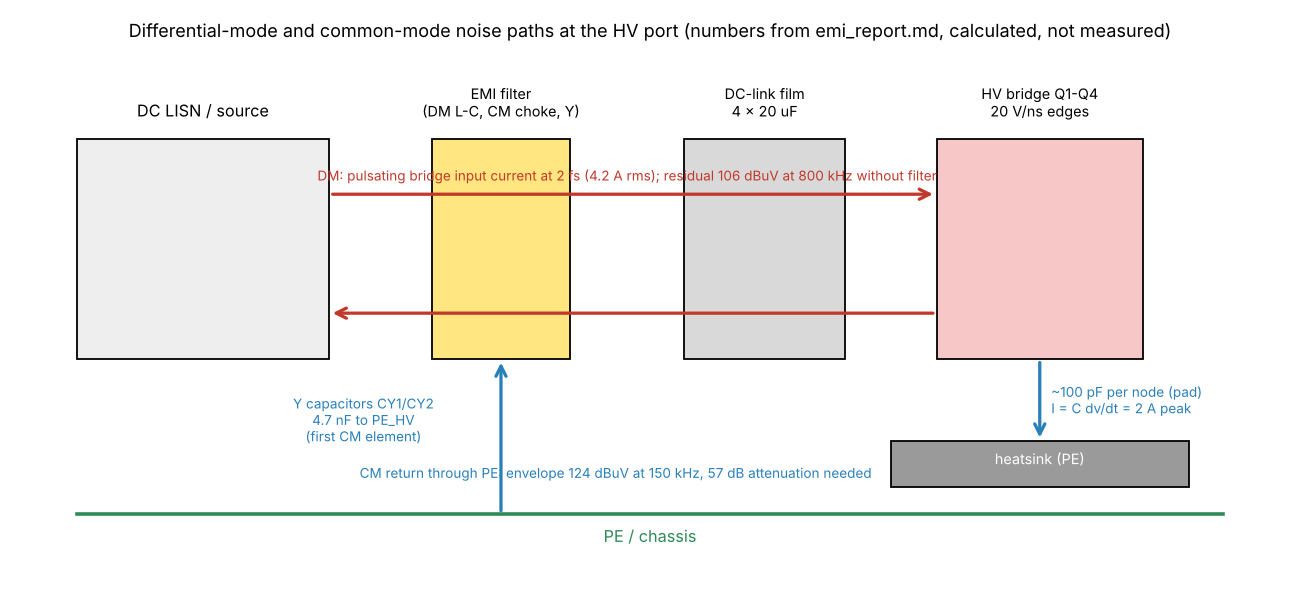
21_Human_Friendly_Learning_Notes/img/ch13_dm_cm_paths.png
