murugan-paramesh/SiC-DC-DC-Converter/21_Human_Friendly_Learning_Notes/img/ch17_surrogate_accuracy.png

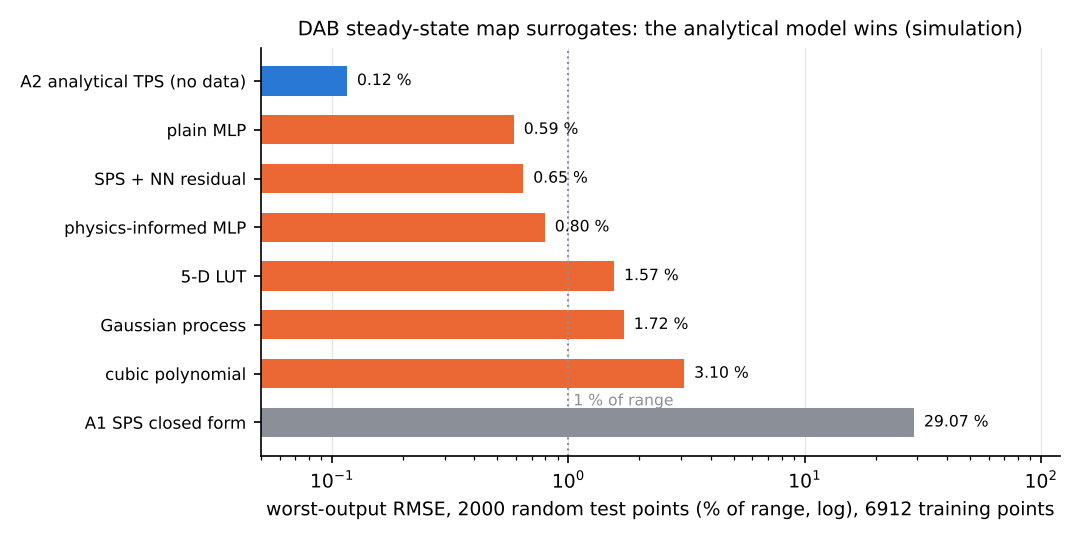
21_Human_Friendly_Learning_Notes/img/ch17_surrogate_accuracy.png
