murugan-paramesh/SiC-DC-DC-Converter/21_Human_Friendly_Learning_Notes/img/ch17_wcet_budget.png

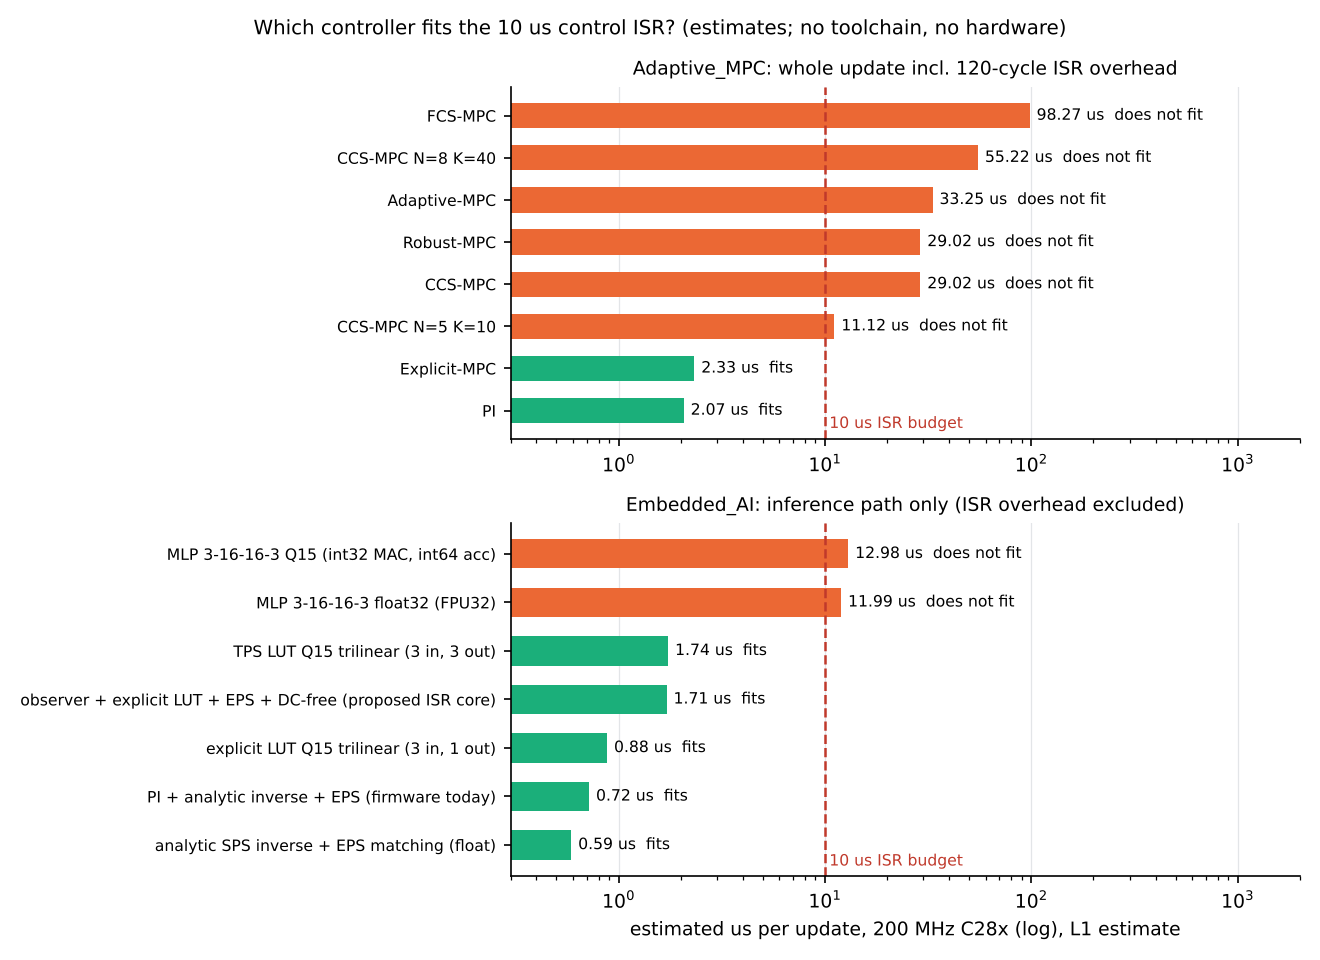
21_Human_Friendly_Learning_Notes/img/ch17_wcet_budget.png
