murugan-paramesh/SiC-DC-DC-Converter/21_Human_Friendly_Learning_Notes/img/fig07_winding_arrangements.png

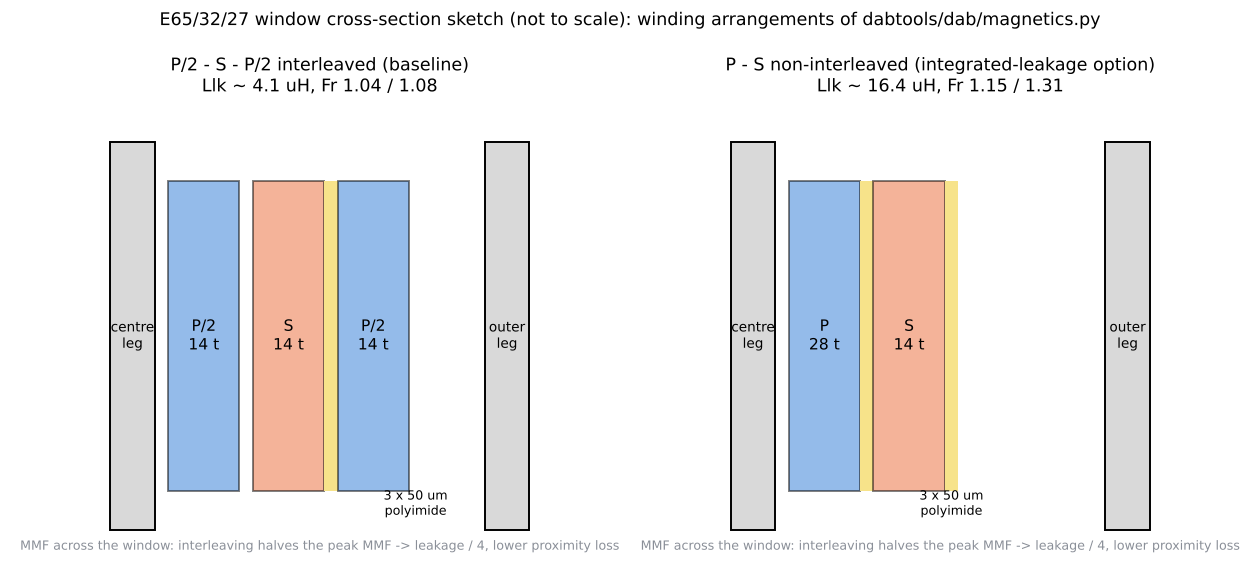
21_Human_Friendly_Learning_Notes/img/fig07_winding_arrangements.png
