murugan-paramesh/SiC-DC-DC-Converter/21_Human_Friendly_Learning_Notes/img/fig08_sim_timing.png

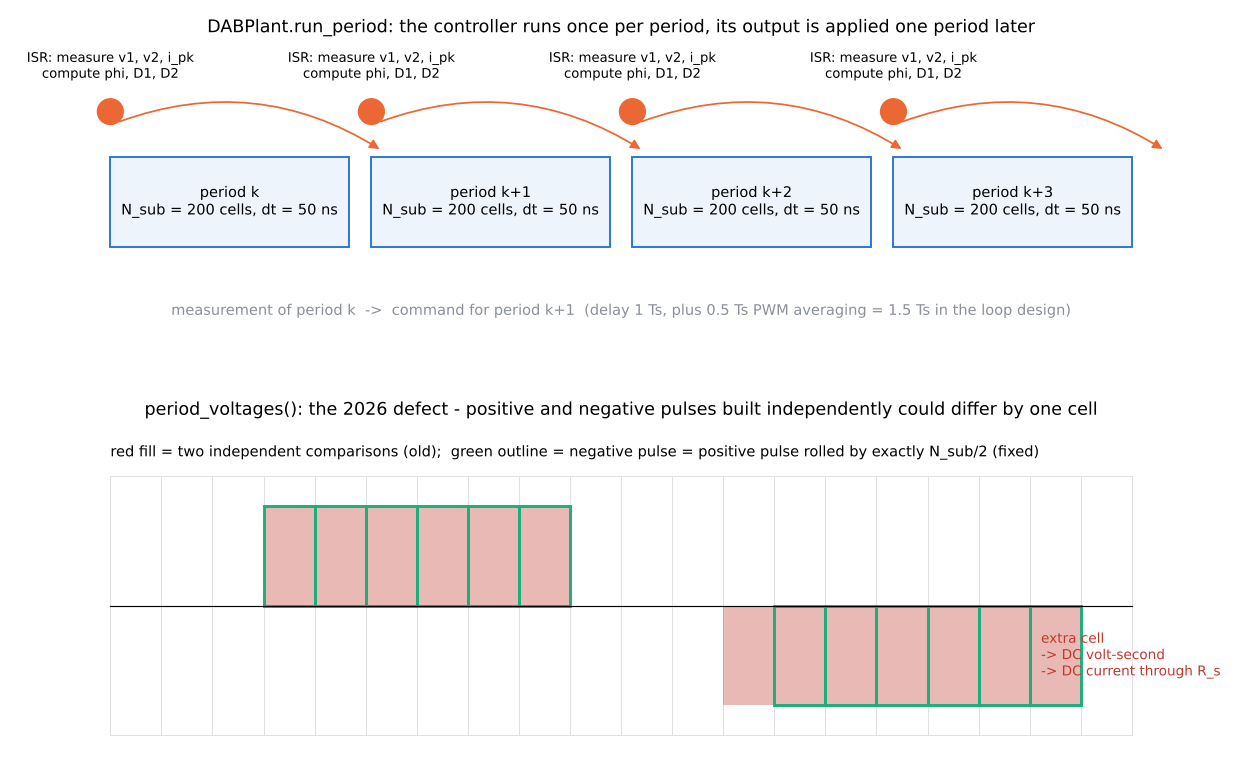
21_Human_Friendly_Learning_Notes/img/fig08_sim_timing.png
