murugan-paramesh/SiC-DC-DC-Converter/Advanced_Research_2026/SiC_Health_Monitoring/results/fig_sensor_requirement.png

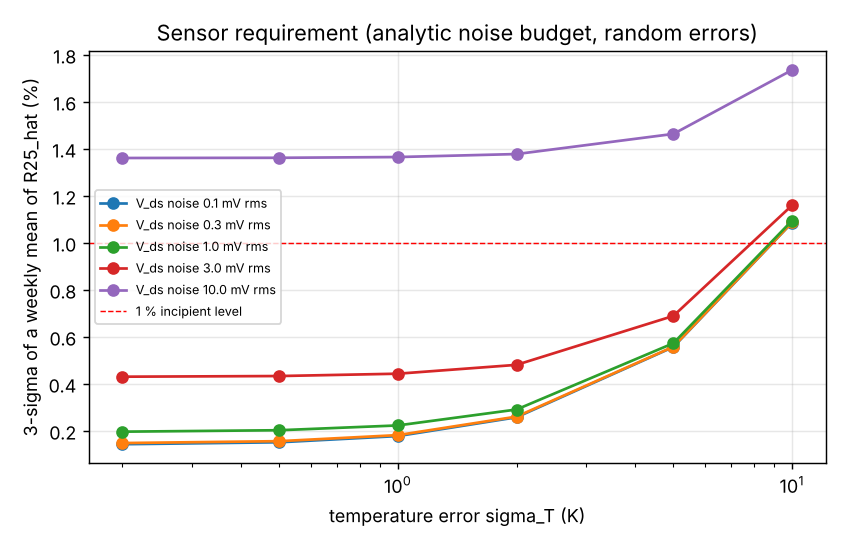
Advanced_Research_2026/SiC_Health_Monitoring/results/fig_sensor_requirement.png
