murugan-paramesh/SiC-DC-DC-Converter/docs/img/sim_waveforms.png

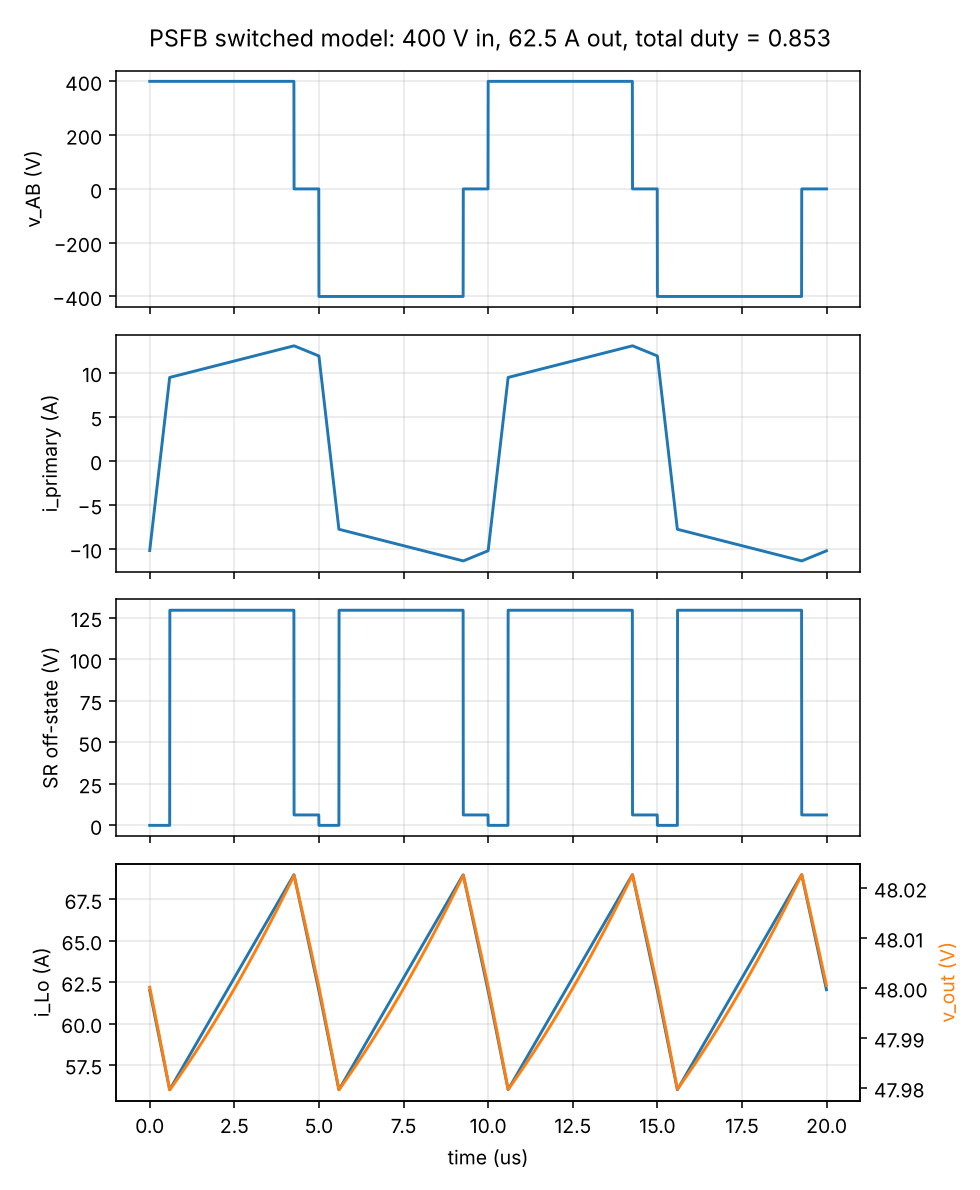
docs/img/sim_waveforms.png
