murugan-paramesh/SiC-DC-DC-Converter/SiC_6k6_Industrial_DAB/02_Topology_Comparison/img/clllc_gain.png

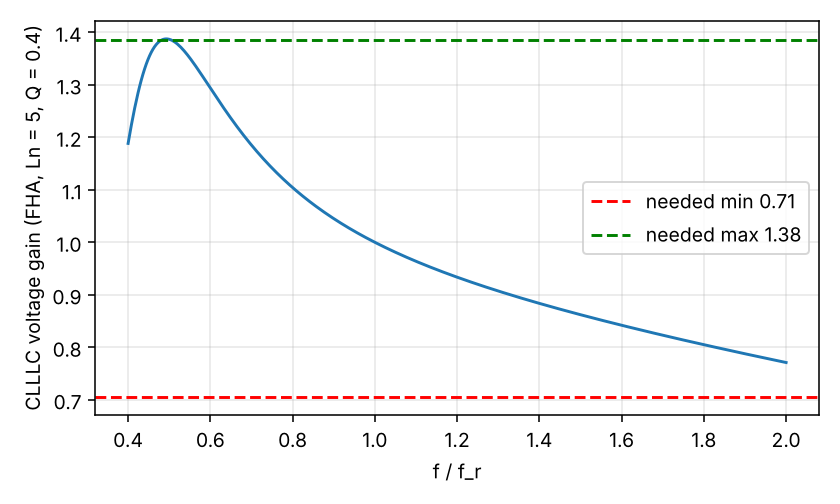
SiC_6k6_Industrial_DAB/02_Topology_Comparison/img/clllc_gain.png
