murugan-paramesh/SiC-DC-DC-Converter/SiC_6k6_Industrial_DAB/05_Simulation/img/sim_deadbus_start.png

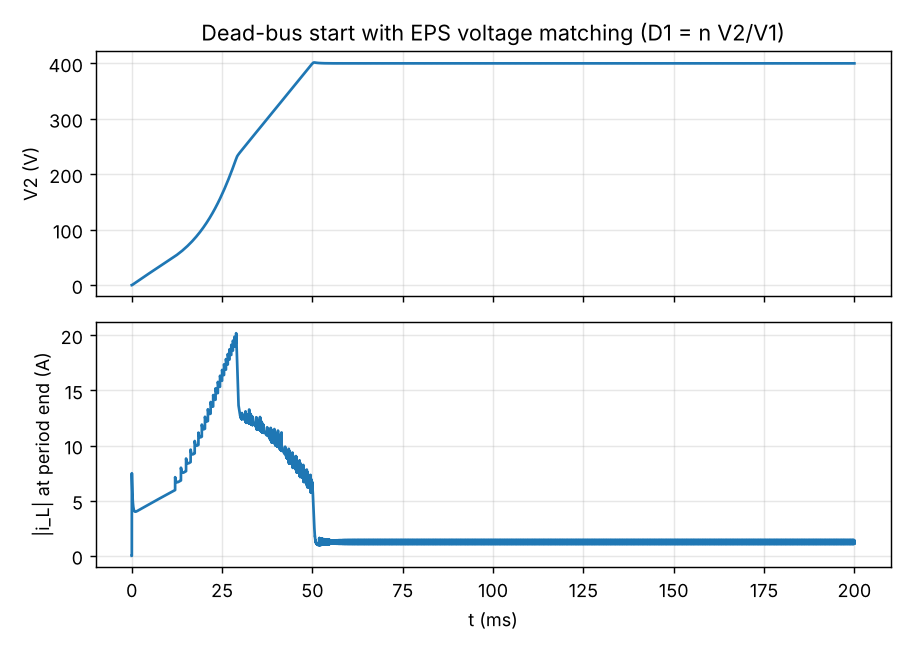
SiC_6k6_Industrial_DAB/05_Simulation/img/sim_deadbus_start.png
