murugan-paramesh/SiC-DC-DC-Converter/SiC_6k6_Industrial_DAB/05_Simulation/img/sim_reversal.png

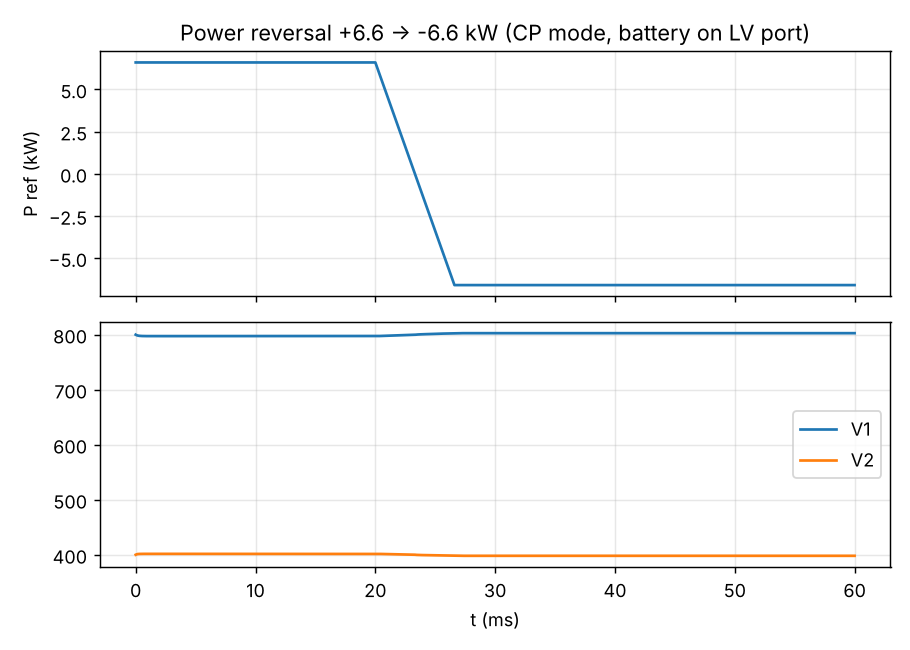
SiC_6k6_Industrial_DAB/05_Simulation/img/sim_reversal.png
