murugan-paramesh/SiC-DC-DC-Converter/SiC_6k6_Industrial_DAB/05_Simulation/img/sim_switching_waveforms.png

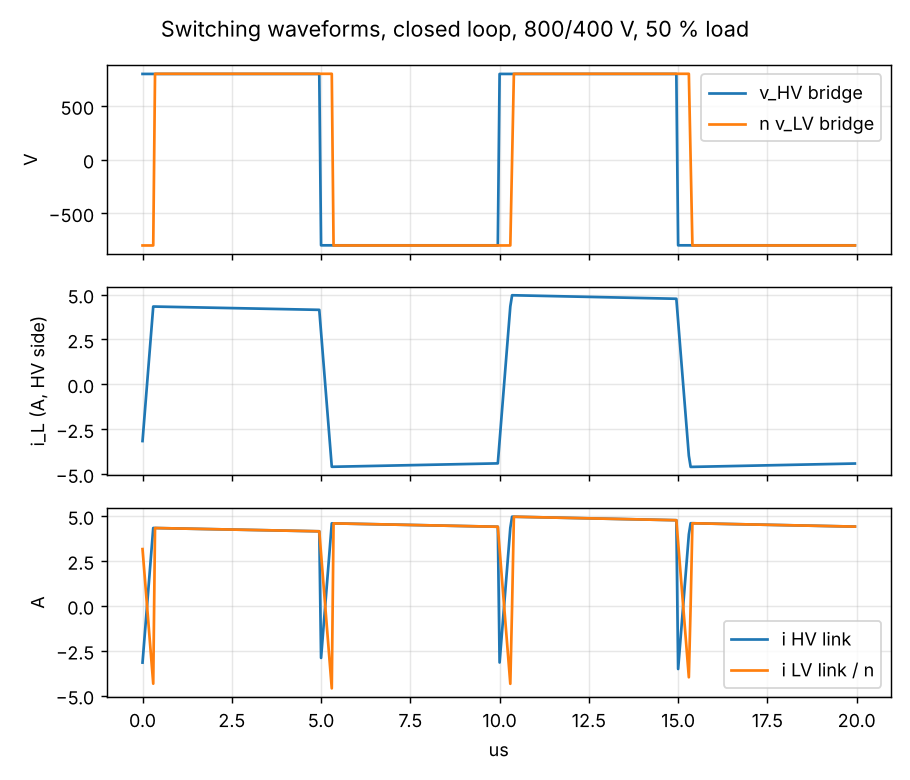
SiC_6k6_Industrial_DAB/05_Simulation/img/sim_switching_waveforms.png
