murugan-paramesh/SiC-DC-DC-Converter/SiC_6k6_Industrial_DAB/05_Simulation/img/spice_sps_waveforms.png

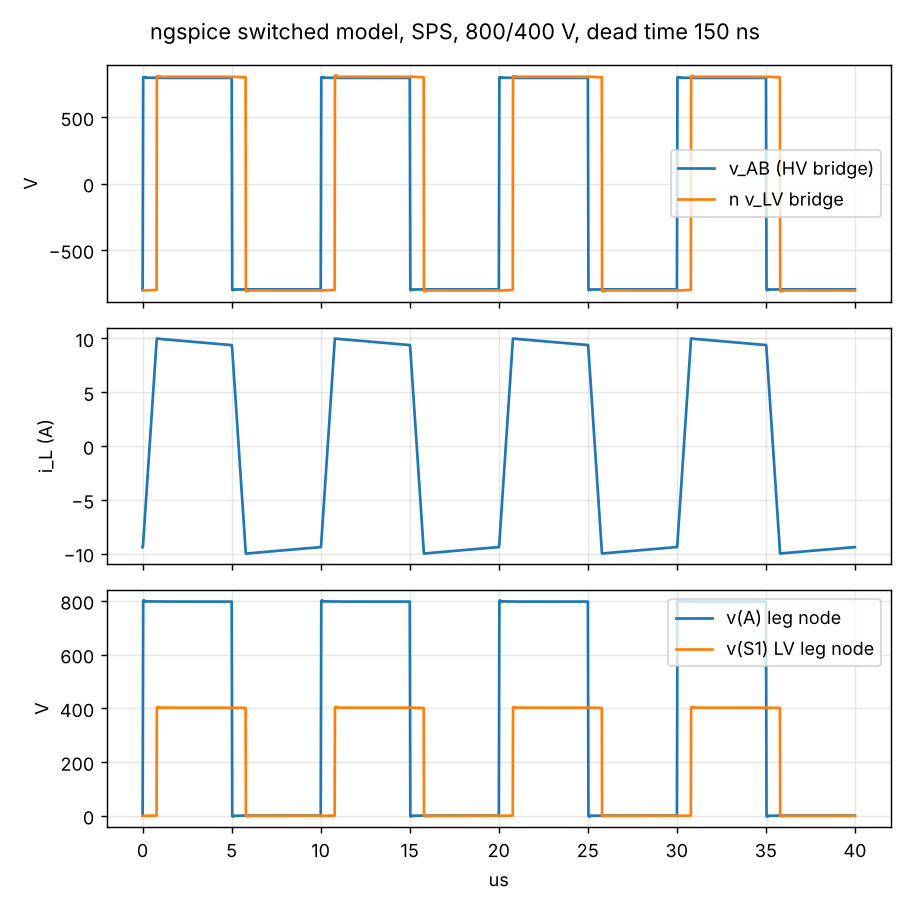
SiC_6k6_Industrial_DAB/05_Simulation/img/spice_sps_waveforms.png
