murugan-paramesh/SiC-DC-DC-Converter/SiC_6k6_Industrial_DAB/16_BOM/off_board_items.md

# Off-board items

| Item | Specification | Reference |
|---|---|---|
| T1 main transformer | 2 x E65/32/27 3C95, 28:14, litz, reinforced tape | 06_Magnetics |
| L1 series inductor | 2 x E55/28/21 3C95 gapped, 60 uH | 06_Magnetics |
| CT1 core | ferrite toroid 1:100 (Magnetics ZW42908TC class) | 06_Magnetics |
| Controller | TI LAUNCHXL-F280049C | 10_Firmware |
| Heatsinks | 2 x extruded 150 x 60 x 40 mm, 0.22 K/W at 3 m/s | 13_Thermal_Analysis |
| Fans | 2 x 80 mm 24 V, 60 m3/h | 13_Thermal_Analysis |
| HV fuse | 16 A / 1000 V semiconductor fuse, 14x51 body (Bussmann FWP class, verify) | 15_Safety_Reliability |
| LV fuse | 32 A / 700 V semiconductor fuse (verify) | 15_Safety_Reliability |
| Precharge | contactor + 100 Ohm / 100 W resistor per port (system) | 00_Requirements APP-05 |
| EMI filter | 2-stage DM/CM per port | 14_EMI_EMC |
| Enclosure | IP20 module, PE bonded | 15_Safety_Reliability |
