murugan-paramesh/SiC-DC-DC-Converter/SiC_6k6_Industrial_DAB/00_Requirements/03_RTM.csv

req_id | requirement | design_artifact | analysis_or_simulation | test_reference | verification_level_planned | status
EL-01 | 6.6 kW rated power both directions | 04_Design_Calculations/dab_design.py | 05_Simulation | 18_Verification/verification_report.md | calc | calc-verified (no hardware test)
EL-02 | HV port 650-850 V | 04_Design_Calculations (envelope) | 05_Simulation | 18_Verification | calc | calc-verified (no hardware test)
EL-03 | LV port 300-450 V | 04_Design_Calculations (envelope) | 05_Simulation | 18_Verification | calc | calc-verified (no hardware test)
EL-04 | Full-power envelope and derating map | 04_Design_Calculations/img/derating_map.png | - | 18_Verification | calc | calc-verified (no hardware test)
EL-05 | 100 kHz switching | 04_Design_Calculations, 12_Optimization | 05_Simulation | 18_Verification | calc | calc-verified (no hardware test)
EL-06 | Peak efficiency >= 97.5 % | 04_Design_Calculations (loss model) | 05_Simulation | 20_Experimental_Test_Plan | calc only; measurement required | calc only (no hardware test)
EL-07 | Full-load efficiency >= 96.5 % | 04_Design_Calculations | 05_Simulation | 20_Experimental_Test_Plan | calc only | calc only (no hardware test)
EL-08 | +/-1 % regulation | 11_Control_Algorithms | 05_Simulation (closed loop) | 20_Experimental_Test_Plan | sim | sim-verified (no hardware test)
EL-09 | <= 1 % ripple | 04_Design_Calculations (DC link) | 05_Simulation | - | calc | calc-verified (no hardware test)
EL-10 | 50 % load step | 11_Control_Algorithms | 05_Simulation (closed loop) | 20_Experimental_Test_Plan | sim | sim-verified (no hardware test)
EL-11 | Power reversal < 20 ms | 11_Control_Algorithms | 05_Simulation | 20_Experimental_Test_Plan | sim | sim-verified (no hardware test)
EL-12 | Cycle-by-cycle current limit | 07_KiCad_Schematics (comparator -> TZ) | 10_Firmware | 20_Experimental_Test_Plan | design | designed (no hardware test)
EL-13 | DC-link ripple <= 2 % | 04_Design_Calculations | 05_Simulation | - | calc | calc-verified (no hardware test)
EL-14 | C2000 digital control | 07_KiCad_Schematics, 10_Firmware | 10_Firmware/sil | - | SIL | SIL-verified (no hardware test)
EL-15 | CAN + UART | 07_KiCad_Schematics, 10_Firmware | - | 20_Experimental_Test_Plan | design | designed (no hardware test)
EL-16 | 24 V aux | 07_KiCad_Schematics | - | - | design | designed (no hardware test)
SAF-01 | Insulation classes | 15_Safety_Reliability/01_insulation_coordination.md | - | 20_Experimental_Test_Plan | analysis | analysed (no hardware test)
SAF-02 | Test voltages | 15_Safety_Reliability | - | 20_Experimental_Test_Plan | analysis | analysed (no hardware test)
SAF-03 | Creepage/clearance | 08_KiCad_PCB (DRC rules) | 18_Verification (DRC) | - | DRC | DRC-checked (no hardware test)
SAF-04 | DC-link discharge | 07_KiCad_Schematics (bleeders), 04_Design_Calculations | - | 20_Experimental_Test_Plan | calc | calc-verified (no hardware test)
SAF-05 | Protective earthing | 08_KiCad_PCB (mounting holes), 17_Manufacturing | - | - | design | designed (no hardware test)
SAF-06 | Hardware protection | 07_KiCad_Schematics (protection sheet) | 05_Simulation (comparator timing) | 20_Experimental_Test_Plan | design | designed (no hardware test)
SAF-07 | Firmware protection | 10_Firmware | 10_Firmware/sil tests | 20_Experimental_Test_Plan | SIL | SIL-verified (no hardware test)
SAF-08 | No unreviewed energisation | 20_Experimental_Test_Plan | - | - | procedure | procedure defined (no hardware test)
MEC-01 | 3 kW/L | 13_Thermal_Analysis, 17_Manufacturing (volume estimate) | - | - | calc | calc-verified (no hardware test)
MEC-02 | 6-layer 2 oz PCB | 08_KiCad_PCB, 17_Manufacturing/stackup.md | 18_Verification (DRC) | - | design | designed (no hardware test)
MEC-03 | TO-247-4 with Kelvin source | 09_Component_Libraries | - | - | design | designed (no hardware test)
MEC-04 | Bus-bar studs, pluggable connectors | 07_KiCad_Schematics, 16_BOM | - | - | design | designed (no hardware test)
MEC-05 | Standard fab rules | 08_KiCad_PCB (design rules), 17_Manufacturing | 18_Verification (DRC) | - | DRC | DRC-checked (no hardware test)
APP-05 | Precharge interlock | 07_KiCad_Schematics (interface), 10_Firmware (state machine) | 10_Firmware/sil | 20_Experimental_Test_Plan | SIL | SIL-verified (no hardware test)
