murugan-paramesh/SiC-DC-DC-Converter/Advanced_Research_2026/Literature_Database/literature_2022_2026.csv

id | title | authors | year | venue | doi_or_url | topology | power_rating | switching_freq | efficiency_reported | validation_method | strengths | limitations | research_gap_identified | verification_status | evidence
L01 | Optimized Hybrid Phase-Shift Model Predictive Control for Dual Active Bridge Converters with Bayesian Optimization | Cong Hu; Ruofa Cheng; Kui Ye | 2026 | IEICE Electronics Express (advance online publication, article 23.20260139) | 10.1587/elex.23.20260139 | DAB (hybrid phase shift) | 1 kW prototype | not in accessible sources | 92.6 % peak vs 88.2 % SPS; current stress -44.7 % (abstract) | prototype measurements | hybrid-PS MPC with online parameter identification and Bayesian-optimised weights | 1 kW laboratory scale; low efficiency level shows a small/low-voltage prototype; abstract only accessible | no high-power (kW-class, 800 V) demonstration; weight tuning offline | confirmed (title+venue+year seen) | WebSearch 2026-10-10: J-STAGE advpub listing https://www.jstage.jst.go.jp/article/elex/advpub/0/advpub_23.20260139/_article shows title, 3 authors, DOI and abstract with 1 kW / 92.6 % / 44.7 % figures; a first DOI-only query returned nothing (index lag). Full text not accessed.
L02 | Artificial Intelligence-Based Modeling and Control Strategy for Dual Active Bridge Converter With Triple Phase Shift Modulation | Zhang; Xu; Dai; Yu; Zhang; Wang | 2026 | IEEE Transactions on Power Electronics vol. 41 no. 1 pp. 494-513 (2026) | 10.1109/TPEL.2025.3594613 | DAB TPS | not stated in abstract | not stated in abstract | not stated in abstract | comparative experiments (prototype) | general AI model of TPS trained from a numerical model incl. dead time and parasitics; multilayer heuristic optimiser; sliding-mode control + RNN error compensation | training data from a numerical model, so accuracy bounded by that model; computational burden of the AI model in the loop not quantified in the abstract | no physics-constraint guarantee on the AI model; no ZVS-margin estimation under parameter drift | confirmed (title+venue+year seen) | WebSearch 2026-10-10: IEEE Xplore result https://ieeexplore.ieee.org/document/11106282/ and AAU portal https://vbn.aau.dk/en/publications/artificial-intelligence-based-modeling-and-control-strategy-for-d/ show title, TPEL vol. 41 no. 1 pp. 494-513, DOI 10.1109/TPEL.2025.3594613, authors Zhang/Xu/Dai/Yu/Zhang/Wang and abstract (RNN + SMC keywords). Power/fs/efficiency not in snippet.
L03 | Design and Analysis of Digital Twin Models for Dual Active Bridge | Abdullah Berkay Bayindir; Ahmad Al-Khateeb; Ali Sharida; Hussein Alnuweiri; Sertac Bayhan; Haitham Abu-Rub | 2024 | IECON 2024 - 50th Annual Conference of the IEEE Industrial Electronics Society (Chicago), pp. 1-6 | https://ieeexplore.ieee.org/document/10905834/ | DAB | not in accessible sources | not in accessible sources | n/a (voltage-prediction twin) | microcontroller implementation of XGBoost and DNN twins predicting output voltage | low-cost real-time twin on a microcontroller | prediction of output voltage only; no physical parameter estimation; conference paper (IECON 2024), NOT IEEE TIM 2025 | twin without physical parameter identification; the user-cited 'TIM 2025 DAB digital twin parameter monitoring' paper could not be confirmed | confirmed (title+venue+year seen) - but it is IECON 2024, not the 'TIM 2025 DAB digital twin' named in the research specification | WebSearch 2026-10-10: HBKU portal https://elmi.hbku.edu.qa/en/publications/design-and-analysis-of-digital-twin-models-for-dual-active-bridge/ (6 authors, 2024-11-06, abstract: XGBoost + DNN twins on low-cost microcontroller predicting output voltage); IEEE Xplore result https://ieeexplore.ieee.org/document/10905834/ carries the same title; a 2026 review cites it as IECON 2024 Chicago pp. 1-6. No IEEE TIM 2025 DAB-twin paper surfaced in any query.
L04 | One-Cycle Digital Twin-Based Multiparameter Identification of Power Electronic Converters With Simple Implementation and High Accuracy | Y. Liu; X. Qing; G. Chen | 2024 | IEEE Transactions on Instrumentation and Measurement vol. 73 | 10.1109/TIM.2024.3488158 | buck prototype (generic method) | not in accessible sources | not in accessible sources | n/a | buck prototype; PSO fit of a Simulink replica to a few samples within one steady switching period | needs only the open-loop digital model; identifies L, C, switch and load parameters simultaneously from one switching period | buck only; PSO-based (offline-ish) fitting; abstract only accessible | identification bandwidth vs noise not assessed here | confirmed (title+venue+year seen) | WebSearch 2026-10-10: IEEE Xplore result https://ieeexplore.ieee.org/document/10712655/ (title, TIM vol. 73 2024, DOI 10.1109/TIM.2024.3488158, abstract); also cited with identical details in IET Power Electronics review https://ietresearch.onlinelibrary.wiley.com/doi/abs/10.1049/pel2.70013.
L05 | Robust data-light parameter estimation for DAB converters with physics-informed neural network | first author not captured (name cut off in the citing reference) | 2025 | 2025 IEEE Energy Conversion Congress and Exposition (ECCE), pp. 1-7 | not found - do not cite a DOI | DAB | not in accessible sources | not in accessible sources | not in accessible sources | not in accessible sources | PINN for parameter estimation with little data | seen only in a reference list | direct precedent for Contribution D - must be read before claiming novelty | partially confirmed (title + venue ECCE 2025 pp. 1-7 seen only in the reference list of a 2026 arXiv paper; authors/DOI/abstract not seen) | WebSearch 2026-10-10: the exact title appears only as a citation inside a 2026 arXiv preprint (surfaced by the query on 'data-light parameter estimation DAB PINN ECCE 2025'); no IEEE Xplore record, author list or abstract was returned. Closest accessible related work: Dey & Mallik arXiv 2502.17452 (L30).
L06 | A 6.6 kW Highly Efficient Reconfigurable Dual Active Bridge Converter Designed Using Planar Transformer, SiC-FETs and Monolithic Bidirectional Devices | Reza Barzegarkhoo; Fabian Groon; Arkadeb Sengupta; Marco Liserre (Kiel University) | 2025 | 2025 IEEE Applied Power Electronics Conference and Exposition (APEC), Atlanta | 10.1109/APEC48143.2025.10977430 | reconfigurable DAB (T-cell + half-bridge cell per side; SiC-FETs + monolithic bidirectional GaN; planar transformer) | 6.6 kW (abstract) | 50 kHz (abstract, per search snippet) | 98 % peak for 200-800 V input / 400 V output (abstract, per one search snippet of the Kiel repository PDF; full text not read). Earlier database version wrongly suspected the 98 % belonged to TI PMP21495 | fabricated 6.6 kW / 50 kHz prototype (abstract) | same power class as this project; wide 200-800 V input range with ZVS kept by reconfiguration; Pareto-optimised planar transformer | 50 kHz (vs 100 kHz here); needs monolithic bidirectional GaN devices; efficiency curve vs load not in accessible snippet; a related TPEL 2025 journal version (L46) is reported with a 5 kW prototype and 97.8 % peak - the two figures could not be reconciled without full text | benchmark for the 6.6 kW class once the paper is read | partially confirmed (title, authors, APEC 2025, DOI seen; 98 % / 50 kHz / 6.6 kW seen in one abstract snippet only, full text not accessed) | WebSearch 2026-10-10: Kiel repository PDF https://macau.uni-kiel.de/servlets/MCRFileNodeServlet/macau_derivate_00009827/1-A_6.6_10.1109_APEC48143.2025.10977430.pdf and record https://macau.uni-kiel.de/receive/macau_mods_00008292 (title, 4 authors, DOI); second query snippet quoted the abstract sentence 'A 6.6 kW/50 kHz prototype with a 98% peak efficiency for 200 V to 800 V input voltage and 400 V output voltage is fabricated'; APEC 2025 programme https://apec2025.eventscribe.net/agenda.asp?pfp=TechLecture. WebFetch of the PDF blocked (DNS).
L07 | SiC-based 6.6 kW bidirectional dual-active-bridge resonant (CLLC) converter reference design PMP21495 | Texas Instruments | 2019-2020 | TI reference design (industry) | https://www.ti.com/tool/PMP21495 | CLLC resonant DAB | 6.6 kW | 500 kHz | 98 % peak (vendor) | vendor measurements | documented 6.6 kW hardware benchmark with test report | resonant topology (not phase-shift DAB); vendor data | shows what a 500 kHz CLLC achieves; phase-shift DAB at 100 kHz must be compared with that difference stated | partially confirmed (6.6 kW / ~500 kHz / 98 % peak CLLLC reference design seen on a third-party news page; TI page itself not fetchable) | WebSearch 2026-10-10: https://eepower.com/new-industry-products/6-6kw-bidirectional-clllc-resonant-dual-active-bridge-reference-design/ describes TI 6.6 kW CLLLC resonant DAB, ~500 kHz nominal (300-700 kHz), 98 % peak claim; ti.com not fetchable (network policy).
L08 | Deep learning-based modeling for power converters via physics-enhanced hierarchical neural network | not captured | 2025 | IEEE Transactions on Power Electronics | 10.1109/TPEL.2025.3629881 | generic converters | n/a | n/a | n/a | simulation/experiment per abstract | physics-enhanced backbone + transfer learning for time-domain modelling | date ambiguous in index | surrogate accuracy vs analytical models not benchmarked at kW power | not found - treat as unverified | WebSearch 2026-10-10: exact-title query and DOI query 10.1109/TPEL.2025.3629881 returned no matching record (only PELS newsletters and unrelated PE-GPT / ModNet-CirNet hierarchical PINN preprints arXiv 2403.14059 / 2411.14214). Title and DOI may be wrong; do not cite.
L09 | NeurPecs: Physics-Informed AI-Based Adaptive Circuit Simulator for Power Converters | Xinze Li; Fanfan Lin; Juan J. Rodriguez-Andina; Josep M. Guerrero; H. Alan Mantooth; Hao Ma | 2026 | IEEE Transactions on Industrial Electronics vol. 73 no. 1 pp. 494-506 | 10.1109/TIE.2025.3582591 | generic converters | n/a | n/a | n/a | simulation | physics-in-architecture RNN simulator | n/a | PINN vs conventional simulation speed/accuracy for DAB at 100 kHz | confirmed (title+venue+year seen) | WebSearch 2026-10-10: UVa portal https://portaldelaciencia.uva.es/documentos/68b33d5a2f359d6e8f72427a and UVigo portal list title, authors, TIE vol. 73 no. 1 pp. 494-506 (2026), DOI 10.1109/TIE.2025.3582591. Abstract/method not in snippet.
L10 | Physics-Embedded Neural ODEs for Sim2Real Edge Digital Twins of Hybrid Power Electronics Systems | Jialin Zheng; Haoyu Wang; et al. (incl. Sergio Vazquez; Leopoldo G. Franquelo) | 2025 | arXiv 2508.02887 (v1 2025-08-04, cs.LG) | https://arxiv.org/abs/2508.02887 | generic converters | n/a | n/a | n/a | simulation | PENODE: event automaton for switching + known ODE terms embedded in the network; differentiable; cloud-to-edge FPGA toolchain; reports 75 % fewer neurons at higher accuracy vs white/gray/black-box baselines | preprint | supports the cautious stance of this project on PINNs | confirmed (title+venue+year seen) | WebSearch 2026-10-10: https://arxiv.org/abs/2508.02887v1 listing with title, authors, date and abstract. Note: earlier database row described the paper's stance inaccurately; corrected to the abstract's claims.
L11 | Review of Prognosis Approaches Applied to Power SiC MOSFETs for Health State and Remaining Useful Life Prediction | not captured | 2025 | review (journal not shown in accessible snippet); PMC id PMC12939361 not confirmed | https://pmc.ncbi.nlm.nih.gov/articles/PMC12939361/ | SiC devices | n/a | n/a | n/a | review | inventory of degradation indicators (Von/Rds_on in power cycling; Vth and gate leakage in HTRB) | review only | temperature decoupling of indicators under converter operation | partially confirmed (title seen on a French institute page; journal, authors, year and PMC id not confirmed) | WebSearch 2026-10-10: https://www.nae.fr/?p=91624 lists the title and summary (OpenAlex keyword search up to 2025, wear-out prognosis, transferable IGBT/Si-MOSFET methods); PMC12939361 query returned no matching record; pmc.ncbi.nlm.nih.gov not fetchable.
L12 | Non-contact Monitoring of Gate-Oxide Degradation in SiC MOSFETs Using Gate Switching Oscillation | Hao Li; Zehao Yang; Dawei Xiang; Xing Lei | 2025 | IEEE Transactions on Instrumentation and Measurement (early access 2025) | 10.1109/TIM.2025.3635834 | SiC devices | 1.2 kV / 30 A devices in half-bridge test | n/a | indicator: peak of gate HF switching-oscillation current, ~40 % change before end-of-life (abstract) | accelerated high-field gate aging; half-bridge switching tests | gate-oscillation-based indicator; body-diode drop as independent indicator | full text not accessed | in-converter implementation cost | confirmed (title+venue+year seen) | WebSearch 2026-10-10: ResearchGate listing https://www.researchgate.net/publication/397866665_Non-contact_Monitoring_of_Gate-Oxide_Degradation_in_SiC_MOSFETs_Using_Gate_Switching_Oscillation with authors, TIM 2025, DOI 10.1109/TIM.2025.3635834 and abstract.
L13 | A new complete condition monitoring method for SiC power MOSFETs | Enes Ugur; Chi Xu; Fei Yang; Shi Pu; Bilal Akin | 2021 | IEEE Transactions on Industrial Electronics vol. 68 no. 2 pp. 1654-1664 | https://ieeexplore.ieee.org/document/8984739/ | SiC devices | n/a | n/a | n/a | power-cycling experiments | Rds_on = oxide + package degradation; Vth = oxide; body-diode drop separates them | 2020 | baseline for the health-monitoring indicator set | confirmed (title+venue+year seen) - year corrected 2020 -> 2021 (print issue) | WebSearch 2026-10-10: DBLP https://dblp1.uni-trier.de/pid/19/2504-6.html lists Ugur, Xu, Yang, Pu, Akin, TIE 68(2) 1654-1664 (2021); ResearchGate https://www.researchgate.net/publication/339060546_A_New_Complete_Condition_Monitoring_Method_for_SiC_Power_MOSFETs.
L14 | An Approach for Online Estimation of On-State Resistance in SiC MOSFETs Without Current Measurement | Univ. of Illinois group (Karakaya / Banerjee per project page; author list not shown in snippet) | 2023 | IEEE Transactions on Power Electronics vol. 38 no. 9 pp. 11463-11473 | https://ieeexplore.ieee.org/document/10143680 | buck converter | n/a | n/a | Rds_on within +/-5 % | experiment | no load-current sensor needed | buck only | extension to DAB bridges | confirmed (title+venue+year seen; authors only inferred) | WebSearch 2026-10-10: Illinois Experts https://experts.illinois.edu/en/publications/an-approach-for-online-estimation-of-on-state-resistance-in-sic-m/ (title, TPEL 38(9) 11463-11473, Sept 2023, abstract: +/-5 %, buck converter, no load-current sensor); IEEE Xplore https://ieeexplore.ieee.org/document/10143680; CEME project page names Karakaya/Banerjee.
L15 | Model predictive control for DAB under extended-phase-shift considering components uncertainty | Yongsheng Fu; Zhengting Jing; Hai-Peng Ren | 2023 | IET Power Electronics vol. 16 no. 12 pp. 1984-1995 | 10.1049/pel2.12519 | DAB EPS | n/a | n/a | n/a | experiment | robust MPC under parameter uncertainty | n/a | direct precedent for robust/adaptive MPC - must be compared | confirmed (title+venue+year seen) | WebSearch 2026-10-10: DOAJ https://doaj.org/article/20c4b5340ba6487987254e76bb207e4d and Wiley https://ietresearch.onlinelibrary.wiley.com/doi/full/10.1049/pel2.12519 (authors, IET PE 16(12) 1984-1995, Sept 2023, abstract: RMPC under EPS, cost = backflow power + output voltage).
L16 | Moving discretized control set model-predictive control for dual-active bridge with triple-phase shift | Linglin Chen; Lyuyi Lin; Shuai Shao; Fei Gao; Zhenyu Wang; Patrick W. Wheeler; Tomislav Dragicevic | 2020 | IEEE Transactions on Power Electronics vol. 35 no. 8 pp. 8624-8637 (2020) | 10.1109/TPEL.2019.2962838 | DAB TPS | 1 kW (300 V / 300 V) | 20 kHz | n/a | experiment | FCS-MPC over a moving TPS set | n/a | baseline FCS-MPC method | confirmed (title+venue+year seen) | WebSearch 2026-10-10: Nottingham repository https://nottingham-repository.worktribe.com/output/35447125/... (authors, TPEL 35(8) 8624-8637, DOI, abstract with 300 V/300 V, 20 kHz, 1 kW experiment).
L17 | Model predictive control with triple phase shift modulation for a dual active bridge DC-DC converter | Seema Mir Akbar; Ammar Hasan; Alan J. Watson; Pat Wheeler | 2021 | IEEE Access vol. 9 pp. 98603-98614 (2021) | 10.1109/ACCESS.2021.3095553 | DAB TPS | 1 kW laboratory prototype (per ResearchGate summary) | n/a | n/a | experiment | MPC + TPS | n/a | baseline | confirmed (title+venue+year seen) | WebSearch 2026-10-10: Nottingham repository https://nottingham-repository.worktribe.com/output/5899784 and DOAJ https://doaj.org/article/6bf4bee86b574498a19d95182b7e9d9e (authors, IEEE Access vol. 9 98603-98614, DOI, published 2021-07-08); IEEE Xplore https://ieeexplore.ieee.org/document/9477604/.
L18 | Exploration analysis of deep reinforcement learning controller in contrast to traditional control methods for DAB in microgrids | not captured | 2025 | Springer (s40998-025-01007-w) | 10.1007/s40998-025-01007-w | DAB | n/a | n/a | n/a | RTDS HIL | TD3 vs PI vs MPC on HIL | no formal safety constraints | constrained/shielded RL for DAB not found in the 2025 literature - gap confirmed | not found - treat as unverified | WebSearch 2026-10-10: queries on the title, the DOI 10.1007/s40998-025-01007-w and the journal (Iranian J. Sci. Technol. Trans. Electr. Eng.) returned no matching record; link.springer.com not fetchable. Closest real DAB-DRL works: Zeng et al. MA-TD3 ISOP-DAB (TPEL 2023), Tang et al. TD3 VF-TPS (TIE 2022). Keep flagged.
L19 | Deep Reinforcement Learning for Power Converter Control: A Comprehensive Review of Applications and Challenges | not captured (author list includes Josep M. Guerrero) | 2025 | IEEE Open Journal of Power Electronics vol. 6 pp. 1769-1802 | 10.1109/OJPEL.2025.3619673 | various | n/a | n/a | n/a | review | taxonomy of DRL converter control | n/a | safety and determinism remain open | confirmed (title+venue+year seen) | WebSearch 2026-10-10: UVa portal https://portaldelaciencia.uva.es/documentos/690e93022b46b12c9877085d (OJPEL vol. 6 1769-1802, DOI); ADS https://ui.adsabs.harvard.edu/abs/2025IOJPE...6.1769R/abstract; ResearchGate 396394027 (abstract names stability assurance, sample inefficiency, safe exploration as open issues).
L20 | Triple Phase Shift Modulation for Active Bridge Converter: Deep Reinforcement Learning-Based Efficiency Optimization | not captured | 2026 | Electronics (MDPI) vol. 15 no. 8 art. 1563 (published 2026-04-08) | 10.3390/electronics15081563 | three-port active bridge (TAB), shipboard zonal DC - NOT a two-port DAB | n/a | n/a | n/a | DDPG tuning of d1, d2, gamma to minimise total loss at fixed output power (abstract); hardware not stated in snippet | DRL for TPS efficiency | three-port converter; no hard constraint handling visible in abstract; title in earlier database row was wrong | no hard constraint handling | confirmed (title+venue+year seen) - title and topology corrected | WebSearch 2026-10-10: https://doi.org/10.3390/electronics15081563 result shows corrected title, Electronics 2026 15(8) 1563, 2026-04-08, abstract (DDPG, TAB, d1/d2/gamma).
L21 | Design of a SiC MOSFET Gate Driver Chip Based on Adaptive Active Drive Technology | Qidong Li et al. | 2026 | Micromachines vol. 17 no. 5 art. 558 (published 2026-04-30) | 10.3390/mi17050558 | gate driver | 400 V / 40 A double-pulse test; 180 nm BCD chip | n/a (dv/dt 4.8 V/ns at turn-on) | turn-on loss -35.1 %, turn-off loss -33.2 % vs passive driver | experiment | three-stage adaptive gate current; mid-stage current controls dv/dt | chip-level; EMI measured only as overshoot | transfer of the trade-off to a 1200 V C3M device at 800 V | confirmed (title+venue+year seen) | WebSearch 2026-10-10: PubMed https://pubmed.ncbi.nlm.nih.gov/42195474/, PMC13209697 and https://doi.org/10.3390/mi17050558 (title, Micromachines 17(5) 558, 30 Apr 2026, abstract: 3-stage gate current, Miller-plateau tracking, -35.1 % turn-on / -33.2 % turn-off loss at 400 V/40 A).
L22 | Adaptive multi-level active gate drivers for SiC power devices | Shuang Zhao; Audrey Dearien; Yuheng Wu; Chris Farnell; Arman Ur Rashid; Fang Luo; H. Alan Mantooth | 2020 | IEEE Transactions on Power Electronics vol. 35 no. 2 pp. 1882-1898 (Feb 2020) | https://researchconnect.stonybrook.edu/en/publications/adaptive-multi-level-active-gate-drivers-for-sic-power-devices/ | gate driver | n/a | n/a | n/a | double-pulse tests vs two-stage turn-off and commercial drivers; datasheet-driven trajectory model | multi-level gate voltage | 2020 | baseline for sec. 10 | confirmed (title+venue+year seen) | WebSearch 2026-10-10: Stony Brook portal (authors, TPEL 35(2) 1882-1898, article 8734868, abstract: three-level AGD, trajectory model, DPT validation); NSF PAR https://par.nsf.gov/biblio/10215743.
L23 | Optimized coil arrangement for integrating leakage inductance in high-frequency transformers of dual active bridge converters | Kianoush Yadollahi; Adel Zakipour (Arak University of Technology) | 2025 | Scientific Reports (published 2025-10-13) | 10.1038/s41598-025-19533-2 | DAB integrated-leakage transformer | 150 W prototype | 40 kHz (per one search summary) | up to 99.1 % (150 W) | ANSYS Maxwell FEA + 150 W prototype with TMS320F28335 | vertical coil arrangement reaches 50 uH target leakage | 150 W only - not comparable to 6.6 kW | scaling of integrated leakage to kW class with litz/planar at 100 kHz | confirmed (title+venue+year seen) | WebSearch 2026-10-10: PMC https://www.ncbi.nlm.nih.gov/pmc/articles/PMC12518606/ and https://www.nature.com/articles/s41598-025-19533-2 (authors, DOI 10.1038/s41598-025-19533-2, 13 Oct 2025, abstract: vertical coil arrangement, 50 uH, 150 W, 99.1 %).
L24 | Magnetic Integration for a Dual Active Bridge Converter Planar Transformer With Accurate Leakage Inductances Estimation | Yicong Cai; Chunyang Gu; Jing Li; Jiajun Yang; Sandro Guenter; Giampaolo Buticchi; He Zhang | 2024 | IEEE Access vol. 12 pp. 112278-112289 | 10.1109/ACCESS.2024.3442288 | DAB planar transformer | n/a | n/a | n/a | 3-D FEA + prototype experiments | reluctance-based leakage estimation incl. air paths | date not captured | analytical leakage estimation benchmark for the FD solver | confirmed (title+venue+year seen) | WebSearch 2026-10-10: DOAJ https://doaj.org/article/3d6d14ee46634897ace96e867e8fd400 and Nottingham Ningbo portal https://research.nottingham.edu.cn/en/publications/magnetic-integration-for-a-dual-active-bridge-converter-planar-tr/ (authors, IEEE Access 12 112278-112289, DOI, abstract).
L25 | DAB converter for EV onboard chargers using bare-die SiC MOSFETs and leakage-integrated planar transformer (title as listed on the Khaligh group page) | Khaligh group, University of Maryland (incl. Yongwan Park per dissertation) | unknown (not shown) | unknown (listed on https://khaligh.ece.umd.edu/publications; TRID record not retrieved) | https://trid.trb.org/View/1933629 | DAB | 3.3 kW claimed earlier - not confirmed in accessible sources | >500 kHz target per UMD dissertation; 500 kHz figure not confirmed for this paper | n/a | prototype | leakage selected for ZVS over the charging profile | date/venue not captured | benchmark for integrated magnetics | partially confirmed (title seen in the UMD group publication list; year, venue, power, frequency and TRID record not confirmed) | WebSearch 2026-10-10: title appears in the UMD Khaligh publication list https://khaligh.ece.umd.edu/publications; related UMD dissertation https://drum.lib.umd.edu/items/f0ba2b40-b793-4e7b-80dc-f3b9c28a1e80 (bare-die SiC, leakage-integrated planar transformer, >500 kHz DAB); trid.trb.org/View/1933629 not returned by search and not fetchable.
L26 | Model Predictive Control of Dual Active Bridge DC-DC Converter based on PWM plus TPS Modulation for Automotive Applications | not captured | 2022 | IEEE conference paper, Xplore document 9851171 (conference name/year not shown; 2022 per Xplore numbering - unverified) | https://ieeexplore.ieee.org/document/9851171/ | DAB | n/a | n/a | n/a | experiment | PWM+TPS MPC | n/a | baseline | partially confirmed (title and Xplore id 9851171 seen together in a search result; venue, year, authors not shown) | WebSearch 2026-10-10: result list of the L01 query returned 'Model Predictive Control of Dual Active Bridge DC-DC Converter based on PWM plus TPS Modulation for Automotive Applications' at https://ieeexplore.ieee.org/document/9851171/; direct id query returned nothing.
L27 | Turn-off Switching Loss Optimization Strategy with Model Predictive Control for Dual-Active-Bridge Converters | not captured | 2022 | IEEE conference paper, Xplore document 9680962 (conference name/year not shown; 2021/2022 per Xplore numbering - unverified) | https://ieeexplore.ieee.org/document/9680962/ | DAB | n/a | n/a | n/a | experiment | loss-aware MPC | n/a | baseline for loss-objective MPC | partially confirmed (title and Xplore id 9680962 seen together in a search result; venue, year, authors not shown) | WebSearch 2026-10-10: result list of the L01 query returned the title at https://ieeexplore.ieee.org/document/9680962/; direct id query returned nothing.
L28 | Parameter estimation of power electronic converters with differentiable physics simulation (preprint) | Pingjunjin Tan; Chunlin Lv; Jinjun Liu; Yang Li | 2026 | arXiv 2608.30915 | https://arxiv.org/abs/2608.30915 | buck converter case study (generic method) | n/a | n/a | n/a | 30 hardware configurations of a buck converter; sparse transient samples from existing sensors | differentiable simulator for estimation | preprint; tracks relative parameter changes, not absolute values (abstract) | gradient-based identification alternative to RLS/EKF | confirmed (title+venue+year seen) | WebSearch 2026-10-10: https://arxiv.org/pdf/2608.30915 (title, 4 authors, abstract).
L29 | Uncertainty-aware parameter estimation for condition monitoring of power converters (preprint) | Tomas Monopoli; Jiahong Liu; Shuai Zhao | 2026 | arXiv 2609.00218 | https://arxiv.org/abs/2609.00218 | buck converter (synthetic + hardware data) | n/a | n/a | n/a | Bayesian MAP + Laplace posterior on differentiable model; synthetic and hardware buck data | uncertainty quantification of estimates | preprint; MOSFET on-resistance found weakly identifiable with the available sensing (abstract) | directly relevant to Contribution D's confidence intervals | confirmed (title+venue+year seen) | WebSearch 2026-10-10: https://arxiv.org/pdf/2609.00218 (title, 3 authors, abstract).
L30 | Physics Informed Neural Network Estimated Circuit Parameter Adaptive Modulation of DAB | Saikat Dey; Ayan Mallik | 2025 | arXiv 2502.17452 (submitted 2025-02-08, eess.SP) | https://arxiv.org/abs/2502.17452 | DAB, TPS, GaN | 2 kW GaN prototype (stated in one search summary; not visible in the abstract snippet) | 100 kHz (same caveat) | +1.4 % average efficiency vs non-adaptive TPS under an emulated 30 % drop of series inductance; peak ~98 % quoted in one summary (unverified) | PINN trained on mixed hardware + frequency-domain-model data; MAE 2.7 % (L) and 3.1 % (R_eq); hardware experiment | direct precedent: PINN parameter estimation feeding parameter-adaptive TPS on a DAB | preprint; estimates only L and R_eq; no uncertainty quantification | Contribution D must be positioned against this: add uncertainty bounds, Rds_on/health coupling, 800 V SiC class | confirmed (title+venue+year seen) | WebSearch 2026-10-10: https://arxiv.org/pdf/2502.17452 and https://www.arxiv.org/abs/2502.17452 (title, authors, date, abstract with 2.7 %/3.1 % MAE and 1.4 % gain).
L31 | A Generic Modeling Approach for Dual-Active-Bridge Converter Family via Topology Transferrable Networks | Xinze Li; Fanfan Lin; Changjiang Sun; Xin Zhang; Hao Ma; Changyun Wen; Frede Blaabjerg; H. Alan Mantooth | 2025 | IEEE Transactions on Industrial Electronics vol. 72 no. 2 pp. 1524-1536 | not shown in accessible sources (DBLP/AAU listing) | DAB family (non-resonant, resonant, multilevel, multiport) | 2 kW hardware | not in accessible sources | not in accessible sources | 2 kW hardware experiments; transfer from one non-resonant DAB time series to other topologies without retraining | physics-in-architecture recurrent network (T2PA) + mixture density network for discrepancies; topology transfer | gray-box; abstract only | benchmark for the Physics_Informed_Models module; no parameter-drift tracking reported | confirmed (title+venue+year seen) | WebSearch 2026-10-10: AAU portal https://vbn.aau.dk/da/publications/a-generic-modeling-approach-for-dual-active-bridge-converter-fami/ and DBLP (TIE 72(2) 1524-1536, 2025, abstract).
L32 | Data-Light Physics-Informed Modeling for the Modulation Optimization of a Dual-Active-Bridge Converter | Xinze Li; Fanfan Lin; Xin Zhang; Hao Ma; Frede Blaabjerg | 2024 | IEEE Transactions on Power Electronics (published online 2024-03-19) | 10.1109/TPEL.2024.3378184 | DAB | not in accessible sources | not in accessible sources | not in accessible sources | not in accessible sources | physics-consistent recurrent network needing little data for modulation optimisation | abstract not accessible; metadata only | establishes the 'data-light' line that L05 continues | confirmed (title+venue+year seen) | WebSearch 2026-10-10: x-mol listing https://ma.x-mol.com/paper/1770497130985910272 (TPEL, 2024-03-19, DOI, 5 authors); arXiv 2307.16173 related.
L33 | Physics-Informed Neural Network for Parameter Identification: a Buck Converter Case Study | Shuyu Ou; Subham Sahoo; Ariya Sangwongwanich; Frede Blaabjerg; Mahyar Hassanifar; Martin Votava; Marius Langwasser; Marco Liserre | 2025 | arXiv 2504.20528 (2025-04-29); accepted ECCE Asia 2025 | https://arxiv.org/abs/2504.20528 | buck converter | not in accessible sources | not in accessible sources | median estimation errors < 7 % (L), 5 % (C), 2 % (R), 11 % (R_C) over 6 test cases | loss-landscape analysis + experiments on buck converter | faster-converging PINN; classifies parameters by usefulness as health indicators | buck only; preprint | same identifiability question must be answered for DAB (L, C1, C2, Rds_on) | confirmed (title+venue+year seen) | WebSearch 2026-10-10: https://arxiv.org/abs/2504.20528 (title, authors, date, ECCE Asia 2025 note, abstract with error figures).
L34 | DT-MPC: Synthesizing Derivation-Free Model Predictive Control from Power Converter Netlists via Physics-Informed Neural Digital Twins | Jialin Zheng and 8 co-authors | 2025 | arXiv 2512.12026 (v1 2025-12-12, eess.SY) | https://arxiv.org/abs/2512.12026 | generic; validated on a DAB | 1500 W DAB | not in accessible sources | n/a (surrogate >7x faster than real time; >95 % design-time reduction claimed) | cloud-to-edge deployment on a 1500 W DAB; comparison with human-designed controllers | digital twin used directly as the MPC prediction model; physics-informed surrogate | preprint; no parameter-estimation / health layer described in abstract | closest 'twin-in-the-loop MPC' precedent for the Adaptive_MPC + Digital_Twin modules | confirmed (title+venue+year seen) | WebSearch 2026-10-10: https://arxiv.org/abs/2512.12026v1 (title, first author, date, abstract with 1500 W DAB).
L35 | Modulated parameter-less predictive voltage control for dual-active-bridge converters | Zheng Yin; Fujin Deng; Sergio Vazquez; Sayed Abulanwar; Cristian Garcia; Jose Carlos Rodriguez-Cabello | 2026 | IEEE Transactions on Power Electronics vol. 41 no. 3 pp. 3148-3153 (online 2025-09-01; letter) | 10.1109/TPEL.2025.3610199 | DAB | not in accessible sources | not in accessible sources | not in accessible sources | experiments on a DAB prototype | parameter-less model updated in real time + modulated optimal phase-shift calculation; removes dependence on exact L | letter; abstract only | model-free alternative to the explicit parameter estimation planned here - must be compared | confirmed (title+venue+year seen) | WebSearch 2026-10-10: Strathprints https://strathprints.strath.ac.uk/94795/ (authors, TPEL 41(3) 3148-3153, DOI, dates, abstract).
L36 | A Simple Model Predictive Control for Dual Active Bridge Converter to Improve Dynamic Response | Tianhao Mao; Zhiqiang Guo; Suli Zou | 2025 | IEEE (journal/conference name not shown in accessible record; (c) 2025 IEEE) | not shown - do not cite a DOI | DAB TPS | not in accessible sources | not in accessible sources | not in accessible sources | small-signal stability analysis + experiments (abstract) | phase shift from output current removes control delay; discrete-integrator parameter identification with low computation | venue/DOI not accessible | low-cost online L identification inside MPC - compare with RLS/EKF in Digital_Twin | partially confirmed (title, authors, 2025 and abstract seen on BIT repository; venue and DOI not shown) | WebSearch 2026-10-10: https://pure.bit.edu.cn/en/publications/a-simple-model-predictive-control-for-dual-active-bridge-converte/ ; related 2024 conference DOI 10.1109/IPEMC-ECCEAsia60879.2024.10567384 is a different paper.
L37 | Optimization Strategies for Triple-Phase-Shift Modulation in Dual-Active-Bridge Converters: A Comprehensive Review | Tarek Younis; Fahad Saleh Al-Ismail; Syed Muhammad Amrr; S. M. Suhail Hussain | 2025 | IEEE Access vol. 13 pp. 152748-152761 | 10.1109/ACCESS.2025.3603104 | DAB TPS (review) | n/a | n/a | n/a | review | taxonomy offline analytical/LUT vs online programming/metaheuristic/AI; benchmarks on RMS current, ZVS coverage, reactive power | review | names hybrid AI-analytical control, physics-informed surrogates and FPGA digital twins as open directions - matches this project's modules | confirmed (title+venue+year seen) | WebSearch 2026-10-10: KFUPM portal https://pure.kfupm.edu.sa/en/publications/optimization-strategies-for-triple-phase-shift-modulation-in-dual/ and DOAJ https://doaj.org/article/4d8aab304b48454f936afb3758bc229e (authors, IEEE Access 13 152748-152761, DOI, abstract).
L38 | ZVS-Enhanced and RMS-Current-Minimized Optimal Modulation Scheme of Dual-Active Bridge Converter With Comprehensive ZVS Analysis | Gayoung Park; Hwigon Kim; Byung-Geuk Cho; Shenghui Cui | 2025 | IEEE Transactions on Power Electronics (2025) - seen on an aggregator only | not shown - do not cite a DOI | DAB TPS, SiC | 20 kW | 50 kHz | 98.8 % peak (aggregator summary) | 20 kW / 50 kHz SiC prototype | ZVS analysis with nonlinear Coss and dead-time dynamics; RMS-current-optimal TPS | only an aggregator page returned; IEEE record not seen | efficiency benchmark for SiC DAB with ZVS-aware TPS (this project: 6.6 kW / 100 kHz) | partially confirmed (title, authors, TPEL 2025 and figures seen on aggregator page only) | WebSearch 2026-10-10: https://app.rndcircle.io/lab/89c18771-7241-4993-8006-70fd208e661f/papers/2c77c01a-a206-4d93-b611-87ba2b61b2bf (title, authors, TPEL 2025, 20 kW/50 kHz/98.8 %).
L39 | An Online Gate Oxide Degradation Monitoring Method for SiC MOSFETs Based on Turn-ON Gate Current Change Rate | H. Meng; J. Liu; Y. Zhang; C. Y. Chung | 2025 | IEEE Transactions on Power Electronics vol. 40 no. 9 pp. 12015-12020 (Sept 2025) | 10.1109/TPEL.2025.3571725 | SiC MOSFET (buck converter demonstration) | not in accessible sources | not in accessible sources | indicator change 5.61 % / 5 % / 8.33 % after 160 h HTGB(+/-)/HTGS aging; insensitive to T, Vds, Ids, package aging (DPT) | accelerated gate aging + DPT + buck converter online monitoring | non-invasive PCB Rogowski coil; temperature-independent indicator | letter; needs gate-current sensor | candidate Vth-proxy for the SiC_Health_Monitoring indicator set | confirmed (title+venue+year seen) | WebSearch 2026-10-10: PolyU portal https://research.polyu.edu.hk/en/publications/an-online-gate-oxide-degradation-monitoring-method-for-sic-mosfet/ and repository PDF https://ira.lib.polyu.edu.hk/bitstream/10397/118330/1/Meng_Online_Gate_Oxide.pdf (authors, TPEL 40(9) 12015-12020, DOI, abstract).
L40 | A Temperature-Independent Gate-Oxide Degradation Monitoring Method for Silicon Carbide Metal Oxide-Semiconductor Field-Effect Transistors Based on Turn-Off Ringing | Xinghao Zhou; Pengju Sun; Kaiwei Li; Qingsong Liu; Lan Chen; Bo Wang (Chongqing University) | 2025 | Electronics (MDPI) vol. 14 no. 4 art. 771 (2025-02-16) | 10.3390/electronics14040771 | SiC MOSFET | not in accessible sources | not in accessible sources | indicator +6.55 % after 42 h HTGB at 32 V; 0.103 % change over 25-150 C | HTGB aging; temperature sweep; bus voltage/load/bond-wire sensitivity tests | turn-off parasitic-inductor voltage minimum as indicator; temperature compensation via gate drive settings | requires fixed Rg/Vg; device-level tests | second temperature-decoupled gate-oxide indicator for the health-monitoring module | confirmed (title+venue+year seen) | WebSearch 2026-10-10: https://www.mdpi.com/2079-9292/14/4/771 and https://doi.org/10.3390/electronics14040771 (authors, Electronics 14(4) 771, date, abstract figures).
L41 | Comparative analysis and evaluation of ageing forecasting methods for semiconductor devices in online health monitoring | Adrian Villalobos; Iban Barrutia; Rafael Pena-Alzola; Tomislav Dragicevic; Jose I. Aizpurua | 2025 | Engineering Applications of Artificial Intelligence vol. 150 art. 110545; arXiv 2503.20403 | 10.1016/j.engappai.2025.110545 | MOSFET aging data (device level) | n/a | n/a | n/a | benchmark of classical tracking, statistical, NN and Temporal Fusion Transformer forecasters over several horizons | only TFT gave valid long-term forecasts (uses future-condition covariates); attention highlights aging turning points | forecasting of indicators, not converter-level monitoring | RUL/forecast layer options for Reliability_Engineering; confirms long-horizon forecasting is hard | confirmed (title+venue+year seen) | WebSearch 2026-10-10: https://arxiv.org/abs/2503.20403v1 and Strathprints https://strathprints.strath.ac.uk/93937/ (authors, EAAI 150 110545, DOI, abstract).
L42 | Physics-Informed Condition Monitoring of SiC Power Modules | Mattia Scarpa; Evgeny Kusmenko; Francesco Toso; Mattia Bruschetta; Ruggero Carli; Simon Achatz (Infineon / Univ. Padova) | 2026 | arXiv 2608.08363 (Aug 2026, eess.SY / cs.LG) | https://arxiv.org/abs/2608.08363 | SiC MOSFET power modules (sintered packaging) | n/a | n/a | n/a | features from Tj swing, mean Tj and Miner's-rule damage; monotonicity prior via gradient-penalty regularisation (abstract) | addresses multi-regime Vf profiles of sintered modules and abrupt wire-bond jumps | preprint; third framework element not visible in snippet | physics-guided monotonic health model - relevant to the health-index design | confirmed (title+venue+year seen) | WebSearch 2026-10-10: https://arxiv.org/pdf/2608.08363 (title, 6 authors, Aug 2026, abstract).
L43 | Neuromorphic Parameter Estimation for Power Converter Health Monitoring Using Spiking Neural Networks | Hyeongmeen Baik; Hamed Poursiami; Maryam Parsa; Jinia Roy (UW-Madison) | 2026 | arXiv 2604.15714; presented at ICONS 2026 (per UW-Madison lab page) | https://arxiv.org/abs/2604.15714 | generic converter (R_s, C estimation) | n/a | n/a | R_s error 10.2 %, C error 8.8 % on EMI-corrupted waveforms; ~3.3 uJ/inference (~270x less than feedforward on Cortex-M) | simulation with EMI-corrupted waveforms; SNN + ODE loss | always-on edge estimation; native fault signal from spike rate | higher error than feedforward PINNs; surrogate-gradient training noise | edge-deployable estimation alternative for Embedded_AI | confirmed (title+venue+year seen) | WebSearch 2026-10-10: https://arxiv.org/pdf/2604.15714 and https://roypowerlab.ece.wisc.edu/?p=407 (title, authors, ICONS 2026, result figures).
L44 | Universal Active Gate Driver IC With Closed-Loop Timing Control and Gate-Sensing Technique for Silicon Carbide Power Devices | Kuo; Wang; Chen; Tu; Hsiao; Chen (NYCU) | 2025 | IEEE (journal name not shown on NYCU portal) | not shown - do not cite a DOI | SiC active gate driver IC (0.18 um BCD) | not in accessible sources | not in accessible sources | -48.7 % turn-on and -18.8 % turn-off switching loss vs conventional driver at similar overshoot | fabricated IC, switching tests | gate-sensing eliminates external sensors; auto-adapts to different SiC devices | venue not shown; test voltage/current not in snippet | benchmark for Active_Gate_Drive loss/overshoot trade-off | partially confirmed (title, authors, 2025 and abstract seen; venue/DOI not shown) | WebSearch 2026-10-10: https://scholar.nycu.edu.tw/en/publications/universal-active-gate-driver-ic-with-closed-loop-timing-control-a/ (abstract with 48.7 % / 18.8 %).
L45 | An Oscillation-Free Active Gate Driver with Self-Adaptive Overshoot Control for SiC MOSFETs | not captured (Harbin Institute of Technology, Shenzhen) | 2026 | IEEE Transactions on Power Electronics (accepted / in press per HIT portal) | not shown - do not cite a DOI | SiC active gate driver | 600 V; 50 / 100 / 200 A loads; 3 SiC device types | not in accessible sources | overshoot held within a set range cycle-by-cycle (no loss figure in snippet) | experiments at 600 V, 50-200 A incl. dynamic load step | cycle-by-cycle gate-current adaptation; oscillation-free turn-off | in press; authors/DOI not shown | adaptive overshoot control reference for 800 V C3M devices | partially confirmed (title, venue and abstract seen on HIT portal; authors, DOI, final citation not shown) | WebSearch 2026-10-10: https://scholar.hit.edu.cn/en/publications/an-oscillation-free-active-gate-driver-with-self-adaptive-oversho/ (abstract, TPEL in press 2026).
L46 | Wide Voltage Range Reconfigurable DAB Converter Realized by Monolithic Bidirectional GaN/Discrete SiC-FETs, and Planar Transformer | Reza Barzegarkhoo; Fabian Groon; Arkadeb Sengupta; Marco Liserre (Kiel) | 2025 | IEEE Transactions on Power Electronics (2025) per ResearchGate listing | not shown - do not cite a DOI | reconfigurable DAB (full/half/hybrid bridge), GaN MBDS + SiC, planar transformer | 5 kW prototype (ResearchGate summary) - conflicts with 6.6 kW APEC version L06 | not in accessible sources | 97.8 % peak, flat curve (ResearchGate summary); Kiel slides claim >97 % even at low power | prototype | journal version of L06; 200-800 V input / 400 V output | power/efficiency figures differ from L06 and could not be reconciled | wide-range ZVS via reconfiguration vs this project's fixed full-bridge at 100 kHz | partially confirmed (title, authors, TPEL 2025 seen on ResearchGate; DOI and figures unverified) | WebSearch 2026-10-10: https://www.researchgate.net/publication/394725421_Wide_Voltage_Range_Reconfigurable_DAB_Converter_Realized_by_Monolithic_Bidirectional_GaNDiscrete_SiC-FETs_a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 ; Kiel slides https://www.bodoswbg.com/downloads/G15_Reza_Barzegarkhoo.pdf
L47 | Development of GaN-Based, 6.6 kW, 450 V, Bi-Directional On-Board Charger with Integrated 1 kW, 12 V Auxiliary DC-DC Converter with High Power Density | Reali; Alemanno; Ronchi; Rossi; Florian (Univ. Bologna / Arca Tecnologie) | 2024 | Micromachines vol. 15 no. 12 art. 1470 | 10.3390/mi15121470 | totem-pole PFC + DAB DC-DC stage, 650 V / 25 mOhm GaN | 6.6 kW (+1 kW aux) | not in accessible sources | not in accessible sources | hardware implementation (abstract) | open-access 6.6 kW OBC with a DAB stage - architecture reference | GaN, not SiC; efficiency not in snippet | 6.6 kW DAB-stage benchmark in the same power class | confirmed (title+venue+year seen) | WebSearch 2026-10-10: https://www.ncbi.nlm.nih.gov/pmc/articles/PMC11679712/ (title, authors, Micromachines 15(12) 1470, DOI, abstract).
L48 | A Radially Symmetrical Star-Shaped Core Multiwinding Transformer With Controllable Magnetic Integration for N-Port MAB Converters | Yicong Cai; Chunyang Gu; Jing Li; Jiajun Yang; Sandro Guenter; Giampaolo Buticchi; He Zhang | 2025 | IEEE Transactions on Power Electronics vol. 40 no. 4 pp. 5622-5634 (April 2025) | https://ieeexplore.ieee.org/document/10806644 | multi-active-bridge integrated multiwinding transformer | not in accessible sources | not in accessible sources | not in accessible sources | magnetic-circuit analysis + 3-D FEA + cross-shaped-core QAB prototype | leakage inductance tunable over wide range by geometry; port consistency via flux barriers | multiport focus | analytical leakage-estimation benchmark for FEM_Magnetics | confirmed (title+venue+year seen) | WebSearch 2026-10-10: IEEE Xplore result https://ieeexplore.ieee.org/document/10806644 (TPEL 40(4) 5622-5634) and Nottingham Ningbo portal https://research.nottingham.edu.cn/en/publications/a-radially-symmetrical-star-shaped-core-multiwinding-transformer-/
L49 | Safety-Enhanced Self-Learning for Optimal Power Converter Control | Yihao Wan; Qianwen Xu; Tomislav Dragicevic | 2024 | IEEE Transactions on Industrial Electronics vol. 71 no. 11 pp. 15229-15234 (letter; arXiv 2312.04158) | 10.1109/TIE.2024.3363759 | two-level voltage source converter | not in accessible sources | not in accessible sources | n/a | VSC testbed experiments | safe online RL framework keeping the converter safe during self-learning | VSC, not DAB; letter | closest published 'safe RL for converters'; no DAB/isolated DC-DC safe-RL paper found 2024-2026 - gap for Safe_RL_Research stands | confirmed (title+venue+year seen) | WebSearch 2026-10-10: DBLP https://dblp.uni-trier.de/pid/138/2806.html (TIE 71(11) 15229-15234, 2024), OpenAlex record for DOI 10.1109/TIE.2024.3363759, arXiv https://arxiv.org/abs/2312.04158v1
L50 | Model-Free DRL Control for Power Inverters: From Policy Learning to Real-Time Implementation via Knowledge Distillation | Yang Yang; Chenggang Cui; Xitong Niu; Jiaming Liu; Chuanlin Zhang | 2026 | arXiv 2603.07964 (2026-03-09) | https://arxiv.org/abs/2603.07964 | power inverter (kW-level hardware) | kilowatt-level platform | not in accessible sources | n/a (microsecond inference after distillation) | hardware experiments; policy distillation with adaptive importance weighting | makes DRL deployable on embedded hardware | inverter; no formal safety constraints | deployment path (distillation) for Embedded_AI / Safe_RL | confirmed (title+venue+year seen) | WebSearch 2026-10-10: https://arxiv.org/abs/2603.07964 (title, authors, date, abstract).
L51 | Artificial Intelligence and Digital Twin Technologies for Power Converter Control in Transportation Applications: A Review | Zhen Huang; J. Gong; X. Xiao; Y. Gao; Y. Xia; P. Wheeler; B. Ji | 2025 | IET Power Electronics vol. 18 no. 1 | 10.1049/pel2.70013 (DOI seen in a search result URL; not independently confirmed) | review | n/a | n/a | n/a | review | surveys AI + digital-twin converter control for transport; cites L04 | review | states open challenges for DT-based control | confirmed (title+venue+year seen) | WebSearch 2026-10-10: Nottingham repository https://nottingham-repository.worktribe.com/output/45863185/... (authors, IET PE 18(1), 2025, abstract); Wiley URL https://ietresearch.onlinelibrary.wiley.com/doi/abs/10.1049/pel2.70013 appeared in the L04 query.
L52 | Mathematical Model of Dual-Active-Bridge Converters for Control and Hardware-in-the-Loop Applications | Juan Pablo Villegas-Ceballos; Carlos Andres Ramos-Paja; Daniel Gonzalez Montoya; Cristian Escudero-Quintero; Sergio Ignacio Serna-Garces | 2026 | Electronics (MDPI) vol. 15 no. 13 art. 2903 | 10.3390/electronics15132903 | DAB (nonlinear model incl. parasitics) | not in accessible sources | not in accessible sources | n/a | simulation + real-time emulation (abstract) | model + parameter tuning + HIL emulation workflow | abstract only | HIL_Validation reference workflow | confirmed (title+venue+year seen) | WebSearch 2026-10-10: CiteDrive https://www.citedrive.com/en/discovery/mathematical-model-of-dual-active-bridge-converters-for-control-and-hardware-in-the-loop-applications/ and https://doi.org/10.3390/electronics15132903 result (authors, DOI, abstract).
L53 | Modeling and Control Gain Design Method for Dual Active Bridge Converter with Dual-Phase-Shift Modulation | Tae-Hyeon Lim; Jin-Su Jang; Gi-Young Lee | 2026 | IEEE Access vol. 14 pp. 12337-12353 | 10.1109/ACCESS.2026.3655399 | DAB DPS | not in accessible sources | not in accessible sources | n/a | Bode verification + HIL simulation of a virtual DAB | generalised-average model -> simplified transfer function -> PI gain design | HIL only | control-design baseline for HIL_Validation | confirmed (title+venue+year seen) | WebSearch 2026-10-10: GNU repository https://scholarworks.gnu.ac.kr/handle/sw.gnu/82331 (authors, IEEE Access 14 12337-12353, DOI, abstract).
L54 | Symmetric Optimization Strategy Based on Triple-Phase Shift for Dual-Active Bridge Converters with Low RMS Current and Full ZVS over Ultra-Wide Voltage and Load Ranges | Longfei Cui; Yiming Zhang; Xuhong Wang; Dong Zhang (Beijing Univ. of Technology) | 2025 | Electronics (MDPI) vol. 14 no. 15 art. 3031 (2025-07-30) | https://www.mdpi.com/2079-9292/14/15/3031 | DAB TPS | not in accessible sources | not in accessible sources | not in accessible sources | KKT/Lagrange optimisation; prototype not confirmed in snippet | RMS-current minimisation with ZVS constraints; low-power ZVS via modulation factor lambda | hardware validation not visible | analytical TPS baseline for Robust_Optimization | confirmed (title+venue+year seen) | WebSearch 2026-10-10: https://www.mdpi.com/2079-9292/14/15/3031 (authors, Electronics 14(15) 3031, date, abstract).
L55 | Physics-Infused Neural MPC of a DC-DC Boost Converter with Adaptive Transient Recovery and Enhanced Dynamic Stability | Tahmin Mahmud (Purdue) | 2026 | arXiv 2603.21128 (2026-03-22); accepted IEEE IDCD 2026 | https://arxiv.org/abs/2603.21128 | boost converter | not in accessible sources | not in accessible sources | n/a | experiments on a commercial boost module | PINN state prediction + FCS-MPC constraint handling | boost only; quantitative results not in snippet | PINN-in-MPC pattern - compare with the physics-based predictor in Adaptive_MPC | confirmed (title+venue+year seen) | WebSearch 2026-10-10: https://arxiv.org/abs/2603.21128 (title, author, date, IDCD 2026 note, abstract).
L56 | A total loss minimization modulation for series-resonant dual-active-bridge dc-dc converter with triple phase shift control | Jiahua Tang; Jihong Wang; Shengzhi Zhou | 2025 | Scientific Reports (2025) | https://www.nature.com/articles/s41598-025-86964-2 | series-resonant DAB, TPS + variable fs | 300 W laboratory prototype | variable (value not in snippet) | gain stated qualitatively vs literature; no percentage in snippet | 300 W prototype, buck and boost modes | TPS + fs as variables for reactive power / circulating current reduction | 300 W; resonant variant | low-power only | confirmed (title+venue+year seen) | WebSearch 2026-10-10: https://www.nature.com/articles/s41598-025-86964-2 result and library mirror https://lib.hutech.edu.vn/chi-tiet?id=203917 (authors, Sci. Rep. 2025, 300 W).
L57 | Design and Analysis of GaN and Planar Magnetics based DAB Converter for EV On-Board Chargers | Kumar; Kalpana; Bobba (NITK) | 2025 | 2025 IEEE Energy Conversion Congress and Exposition Asia (ECCE Asia) | https://idr.nitk.ac.in/handle/123456789/28615 | GaN DAB with planar transformer | 3.3 kW, 600 V in / 400 V out | 250 kHz | loss comparison vs SiC-DAB in PLECS; no efficiency percentage in snippet | PLECS simulation (hardware not confirmed) | planar magnetics DAB for OBC, GaN vs SiC comparison | simulation-level per snippet | planar DAB at kW class; this project is 6.6 kW / 100 kHz SiC | confirmed (title+venue+year seen) | WebSearch 2026-10-10: NITK repository https://idr.nitk.ac.in/handle/123456789/28615 (title, ECCE Asia 2025, 3.3 kW / 600 V / 400 V / 250 kHz).
