murugan-paramesh/SiC-DC-DC-Converter/21_Human_Friendly_Learning_Notes/textbook/BUILD_STATUS.txt

markdown: produced
html: produced
docx: produced
pdf: produced
