murugan-paramesh/SiC-DC-DC-Converter/Advanced_Research_2026/Adaptive_MPC/results/benchmark_step_load_step_up.png

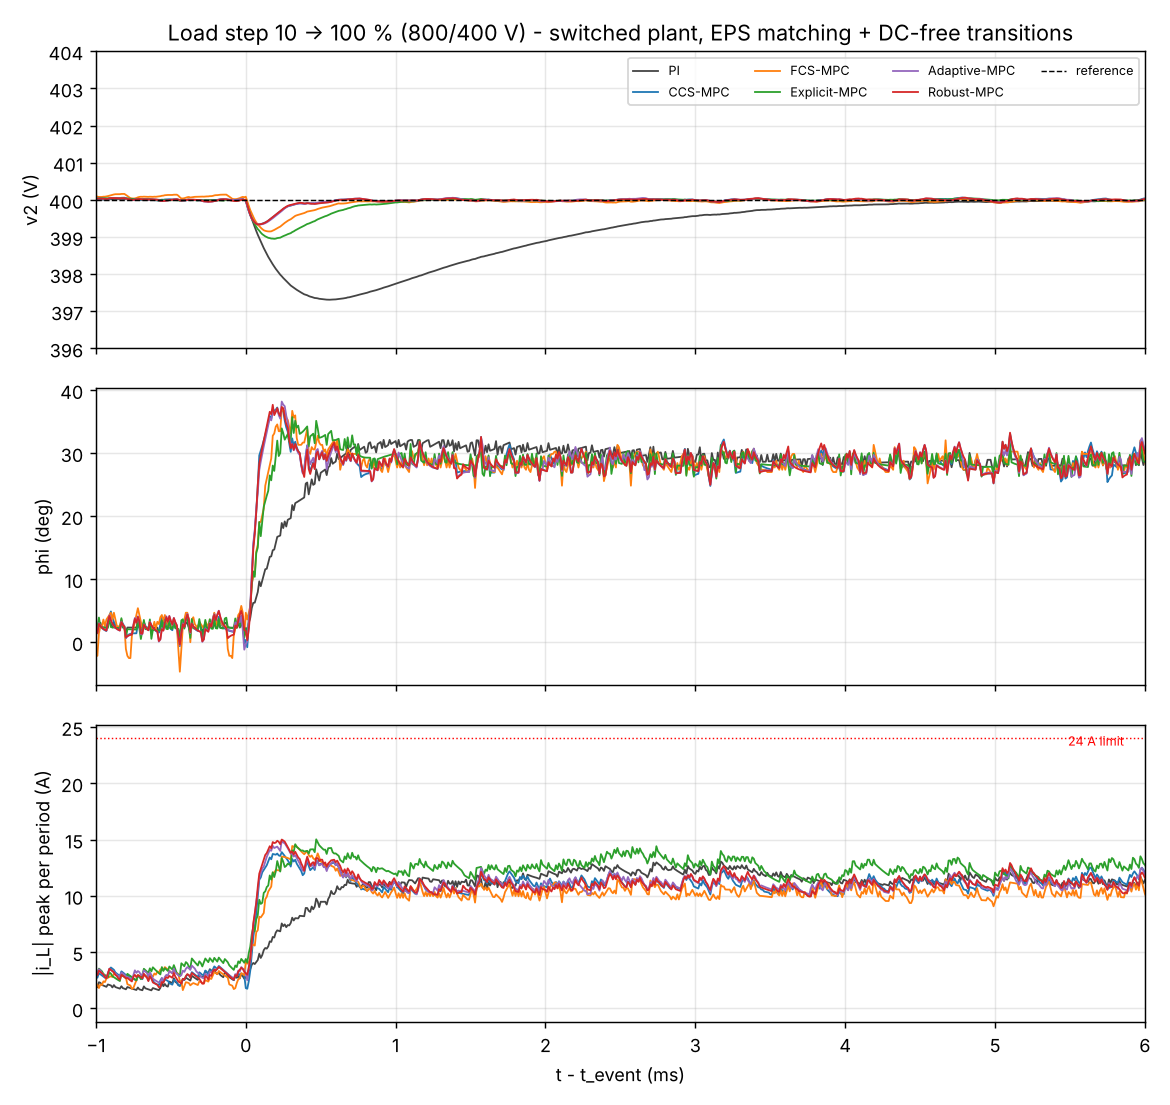
Advanced_Research_2026/Adaptive_MPC/results/benchmark_step_load_step_up.png
