murugan-paramesh/SiC-DC-DC-Converter/Advanced_Research_2026/Adaptive_MPC/results/benchmark_step_soft_start.png

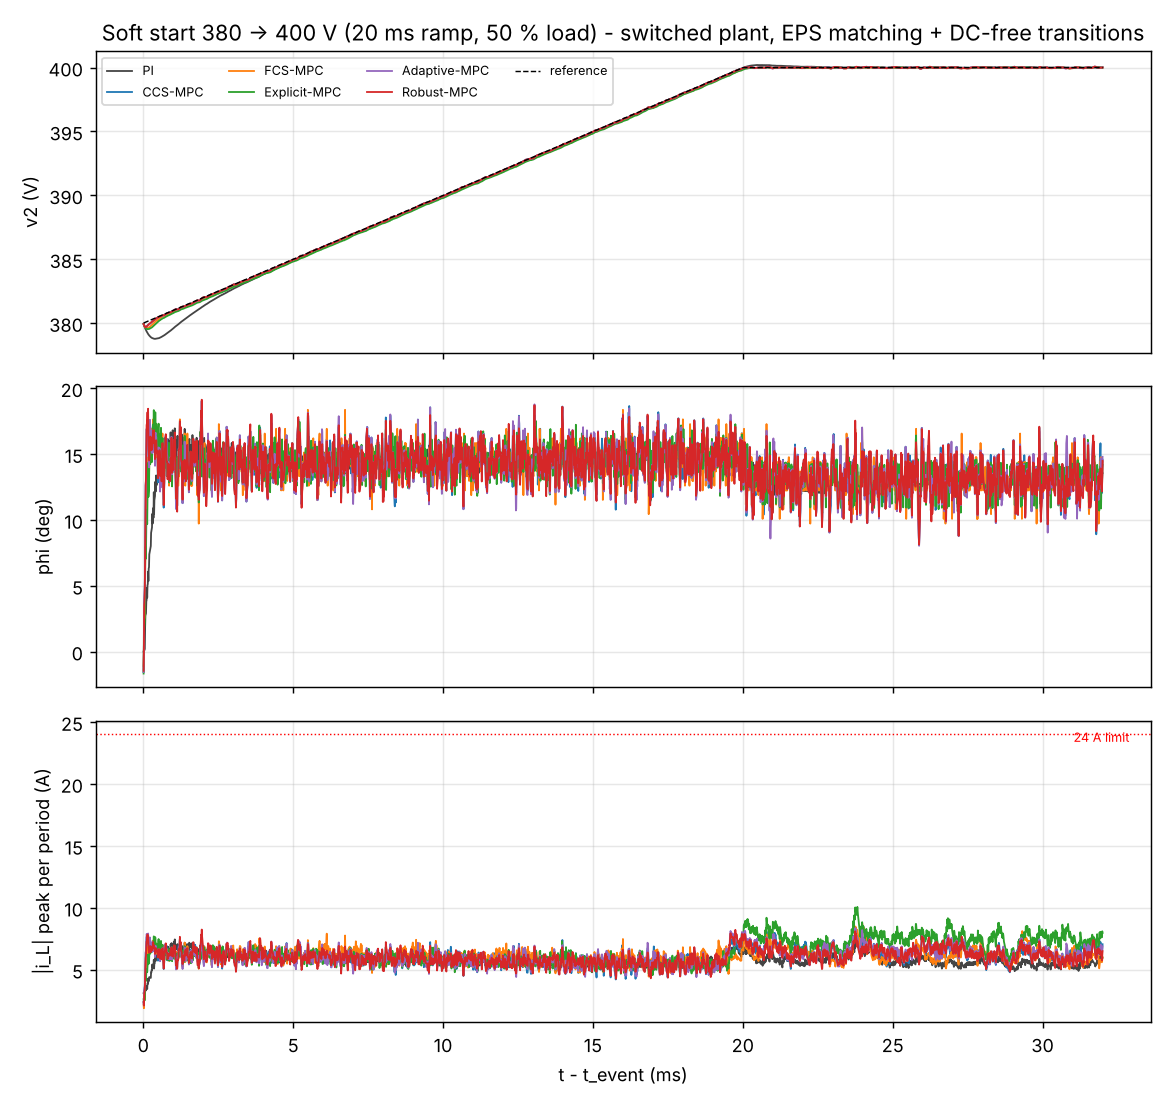
Advanced_Research_2026/Adaptive_MPC/results/benchmark_step_soft_start.png
