murugan-paramesh/SiC-DC-DC-Converter/Advanced_Research_2026/Research_Benchmarks/results/benchmark_table.md

# Benchmark table (generated by benchmark_table.py)

Literature numbers appear in the main columns only when the database entry is marked confirmed/accessible; unverified numbers are in the separate `unverified numbers` column. Project numbers are CALCULATED (no hardware).

| id | source | year | topology | devices | fs (kHz) | P (kW) | voltage ranges | eta peak (%) | eta full load (%) | power density (kW/L) | control | validation | numbers status | unverified numbers |
|---|---|---|---|---|---|---|---|---|---|---|---|---|---|---|
| L01 | Optimized Hybrid Phase-Shift Model Predictive Control for Dual Active Bridge Converters with Bayesian Optimization (IEICE Electronics Express (advance online publication, article 23.20260139)) | 2026 | DAB (hybrid phase shift) | not captured | n/s | 1.0 | not captured | 92.6 | n/s | not recorded in database | hybrid phase-shift MPC, Bayesian-optimised weights | prototype measurements | confirmed source |  |
| L06 | A 6.6 kW Highly Efficient Reconfigurable Dual Active Bridge Converter Designed Using Planar Transformer, SiC-FETs and Monolithic Bidirectional Devices (2025 IEEE Applied Power Electronics Conference and Exposition (APEC), Atlanta) | 2025 | reconfigurable DAB (T-cell + half-bridge cell per side; SiC-FETs + monolithic bidirectional GaN; planar transformer) | SiC-FETs + monolithic bidirectional GaN, planar transformer | see unverified | see unverified | 200-800 V in / 400 V out | see unverified | n/s | not recorded in database | reconfigurable bridge (T-cell + half-bridge cell) | fabricated 6.6 kW / 50 kHz prototype (abstract) | UNVERIFIED (status: partially confirmed (title, authors, APEC 2025, DOI seen; 98) | fs 50 kHz; P 6.6 kW; eta_peak 98.0 % |
| L07 | SiC-based 6.6 kW bidirectional dual-active-bridge resonant (CLLC) converter reference design PMP21495 (TI reference design (industry)) | 2019-2020 | CLLC resonant DAB | SiC MOSFETs (vendor design) | see unverified | see unverified | not captured | see unverified | n/s | not recorded in database | not captured (vendor firmware) | vendor measurements | UNVERIFIED (status: partially confirmed (6.6 kW / ~500 kHz / 98 % peak CLLLC ref) | fs 500 kHz; P 6.6 kW; eta_peak 98.0 % |
| L16 | Moving discretized control set model-predictive control for dual-active bridge with triple-phase shift (IEEE Transactions on Power Electronics vol. 35 no. 8 pp. 8624-8637 (2020)) | 2020 | DAB TPS | not captured | 20 | 1.0 | 300 V / 300 V | n/s | n/s | not recorded in database | moving-discretised-control-set MPC, TPS | experiment | confirmed source |  |
| L17 | Model predictive control with triple phase shift modulation for a dual active bridge DC-DC converter (IEEE Access vol. 9 pp. 98603-98614 (2021)) | 2021 | DAB TPS | not captured | n/s | 1.0 | not captured | n/s | n/s | not recorded in database | MPC + TPS | experiment | confirmed source |  |
| L23 | Optimized coil arrangement for integrating leakage inductance in high-frequency transformers of dual active bridge converters (Scientific Reports (published 2025-10-13)) | 2025 | DAB integrated-leakage transformer | not captured | 40 | 0.15 | not captured | 99.1 | n/s | not recorded in database | not captured (TMS320F28335) | ANSYS Maxwell FEA + 150 W prototype with TMS320F28335 | confirmed source |  |
| L25 | DAB converter for EV onboard chargers using bare-die SiC MOSFETs and leakage-integrated planar transformer (title as listed on the Khaligh group page) (unknown (listed on https://khaligh.ece.umd.edu/publications; TRID record not retrieved)) | unknown (not shown) | DAB | bare-die SiC, leakage-integrated planar transformer | see unverified | see unverified | not captured | see unverified | n/s | not recorded in database | not captured | prototype | UNVERIFIED (status: partially confirmed (title seen in the UMD group publication) | fs n/s kHz; P n/s kW; eta_peak n/s % |
| L31 | A Generic Modeling Approach for Dual-Active-Bridge Converter Family via Topology Transferrable Networks (IEEE Transactions on Industrial Electronics vol. 72 no. 2 pp. 1524-1536) | 2025 | DAB family (non-resonant, resonant, multilevel, multiport) | not captured | n/s | 2.0 | not captured | n/s | n/s | not recorded in database | n/a (modelling paper) | 2 kW hardware experiments; transfer from one non-resonant DAB time series to other topologies without retraining | confirmed source |  |
| L38 | ZVS-Enhanced and RMS-Current-Minimized Optimal Modulation Scheme of Dual-Active Bridge Converter With Comprehensive ZVS Analysis (IEEE Transactions on Power Electronics (2025) - seen on an aggregator only) | 2025 | DAB TPS, SiC | SiC | see unverified | see unverified | not captured | see unverified | n/s | not recorded in database | ZVS-enhanced rms-current-minimised TPS | 20 kW / 50 kHz SiC prototype | UNVERIFIED (status: partially confirmed (title, authors, TPEL 2025 and figures s) | fs 50 kHz; P 20.0 kW; eta_peak 98.8 % |
| L46 | Wide Voltage Range Reconfigurable DAB Converter Realized by Monolithic Bidirectional GaN/Discrete SiC-FETs, and Planar Transformer (IEEE Transactions on Power Electronics (2025) per ResearchGate listing) | 2025 | reconfigurable DAB (full/half/hybrid bridge), GaN MBDS + SiC, planar transformer | GaN MBDS + SiC, planar transformer | see unverified | see unverified | wide range (values not captured) | see unverified | n/s | not recorded in database | reconfigurable bridge | prototype | UNVERIFIED (status: partially confirmed (title, authors, TPEL 2025 seen on Resea) | fs n/s kHz; P 5.0 kW; eta_peak 97.8 % |
| L47 | Development of GaN-Based, 6.6 kW, 450 V, Bi-Directional On-Board Charger with Integrated 1 kW, 12 V Auxiliary DC-DC Converter with High Power Density (Micromachines vol. 15 no. 12 art. 1470) | 2024 | totem-pole PFC + DAB DC-DC stage, 650 V / 25 mOhm GaN | 650 V / 25 mOhm GaN | n/s | 6.6 | 450 V class (title) | n/s | n/s | not recorded in database | not captured | hardware implementation (abstract) | confirmed source |  |
| L57 | Design and Analysis of GaN and Planar Magnetics based DAB Converter for EV On-Board Chargers (2025 IEEE Energy Conversion Congress and Exposition Asia (ECCE Asia)) | 2025 | GaN DAB with planar transformer | GaN, planar magnetics | 250 | 3.3 | 600 V in / 400 V out | n/s | n/s | not recorded in database | not captured | PLECS simulation (hardware not confirmed) | confirmed source |  |
| OURS-DAB | SiC_6k6_Industrial_DAB (this repository, calculated design) | 2026 | single-phase DAB, SPS feed-forward + EPS voltage matching (TPS table optional) | C3M0032120K (HV bridge) / C3M0016120K (LV bridge), TO-247-4 | 100.0 | 6.6 | HV 650-850 V / LV 300-450 V, bidirectional | 98.66 (calculated, L2; at 80 % load, 800/400 V) | 98.62 (calculated, L2; worst corner 850/300 V: 97.92) | 1.1 (ESTIMATE, L1: 340 x 250 x 70 mm boxed, no enclosure/fans; objective MEC-01 >= 3) | digital PI (600 Hz crossover) + inverse-SPS feed-forward + EPS matching; C2000 target; explicit MPC studied | L2 simulation (switched Python + ngspice), L3 SIL of the C control core; NO hardware | calculated (this project) |  |
| OURS-PSFB | hardware/ + docs/ (this repository, 3 kW PSFB reference design, calculated) | 2026 | ZVS phase-shifted full bridge + centre-tapped synchronous rectifier (unidirectional) | C3M0060065K x4 (primary), IPP110N20N3 G x4 (SR), C3D04065A clamp diodes | 100.0 | 3.0 | in 370-420 V (320 V derated) / out 48 V, 62.5 A | 97.59 (calculated, L2; at 47 % load, from the docs/02 loss budget scaling) | 97.1 (calculated, L2) | 1.2 (ESTIMATE, L1: 260 x 200 x 50 mm boxed) | UCC28951 analogue peak-current-mode PSFB controller, adaptive ZVS delays | L3 software-verified design (DRC 0 errors, gerbers), switched simulation; NO hardware | calculated (this project) |  |

Rows: 14 (12 literature entries, 2 project designs). Confirmed literature rows with a quoted peak efficiency: 2; unverified rows: 5.

The `database_text` column of the CSV reproduces the literature-database fields the numbers were transcribed from.
