murugan-paramesh/SiC-DC-DC-Converter/Advanced_Research_2026/Cybersecurity/results/demo_log.md

# CMAC / replay-counter demonstration (generated by cmac_replay_demo.py)

## Self-check against published vectors
| vector | expected | got | ok |
|---|---|---|---|
| AES128_FIPS197_C1 | 69c4e0d86a7b0430d8cdb78070b4c55a | 69c4e0d86a7b0430d8cdb78070b4c55a | True |
| CMAC_RFC4493_len0 | bb1d6929e95937287fa37d129b756746 | bb1d6929e95937287fa37d129b756746 | True |
| CMAC_RFC4493_len16 | 070a16b46b4d4144f79bdd9dd04a287c | 070a16b46b4d4144f79bdd9dd04a287c | True |
| CMAC_RFC4493_len40 | dfa66747de9ae63030ca32611497c827 | dfa66747de9ae63030ca32611497c827 | True |
| CMAC_RFC4493_len64 | 51f0bebf7e3b9d92fc49741779363cfe | 51f0bebf7e3b9d92fc49741779363cfe | True |

**Self-check PASSED**

## Command-channel demo (key 000102..0f, CAN ID 0x200, window 256, persist every 64)
| case | frame (hex) | receiver result |
|---|---|---|
| valid EN,1 | `0100000100000429b46f24a2a6243775` | accept: EN arg=1 ctr=1065 |
| replay of the same frame | `0100000100000429b46f24a2a6243775` | reject: replay / stale counter |
| valid MODE_CV 400.0 V | `02000fa00000042a44b4de3dd54aa0d2` | accept: MODE_CV arg=4000 ctr=1066 |
| same frame with the argument modified (MAC must fail) | `02001fa00000042a44b4de3dd54aa0d2` | reject: MAC |
| frame built with the wrong key | `040000000000042bddbde6e3dcb9a9cb` | reject: MAC |
| counter rolled back (ctr - 5) | `03000bb800000424dfbba0d4a8e4ccd5` | reject: replay / stale counter |
| counter jump beyond the window (+1000) | `03000bb8000008111a226067eb63a673` | reject: counter jump beyond window (resync required) |
| lost frames: counter +10 within the window (accepted, gap tolerated) | `03fff44800000435527fe8ac64a886de` | accept: MODE_CP arg=-3000 ctr=1077 |
| CLR_FAULT with a valid MAC and counter (accepted - authentication does not make the command safe, the state machine still re-faults if the condition persists) | `0400000000000436820357f0a627f5c9` | accept: CLR_FAULT arg=0 ctr=1078 |
| after a reboot with the persisted counter: last valid frame replayed | `0400000000000436820357f0a627f5c9` | reject: replay / stale counter |
| after the reboot: fresh counter ahead of the jump-ahead value | `0100000100000469d36f489f1c9a9d1c` | accept: EN arg=1 ctr=1129 |

Demo expectations met.
