murugan-paramesh/SiC-DC-DC-Converter/Advanced_Research_2026/Reliability_Engineering/results/fta_cutsets.md

# FTA results (generated by fta.py; all rates are assumptions, see README)

## TE1_hazardous_voltage_accessible
minimal cut sets: 6, lowest order 1, top-event frequency 1.40e-04 /year, P(10 y) = 1.40e-03

| cut set | order | frequency (/year) | share |
|---|---|---|---|
| ISO_BIAS | 1 | 7.01e-05 | 50.0 % |
| ISO_DRV | 1 | 3.50e-05 | 25.0 % |
| ISO_AMC | 1 | 3.07e-05 | 21.9 % |
| ISO_PCB | 1 | 4.38e-06 | 3.1 % |
| DEV_PAD AND PE_BOND | 2 | 1.53e-09 | 0.0 % |
| ACCESS AND ACT_DIS AND BLEED | 3 | 3.07e-13 | 0.0 % |

Fussell-Vesely importance (top 6): ISO_BIAS 0.50, ISO_DRV 0.25, ISO_AMC 0.22, ISO_PCB 0.03, DEV_PAD 0.00, PE_BOND 0.00

## TE2_uncontrolled_energy_overcurrent
minimal cut sets: 21, lowest order 2, top-event frequency 1.93e-04 /year, P(10 y) = 1.93e-03

| cut set | order | frequency (/year) | share |
|---|---|---|---|
| DRV_HIGH AND NO_DESAT | 2 | 7.01e-05 | 36.4 % |
| MCU AND NO_DESAT | 2 | 4.38e-05 | 22.7 % |
| NO_DESAT AND XTALK | 2 | 4.38e-05 | 22.7 % |
| DRV_UVLO_LOSS AND NO_DESAT | 2 | 3.50e-05 | 18.2 % |
| CT_FAIL AND LOAD_SHORT | 2 | 8.53e-09 | 0.0 % |
| MCU AND TZ_CFG | 2 | 4.38e-09 | 0.0 % |
| CTRL_FAIL AND CT_FAIL | 2 | 1.71e-09 | 0.0 % |
| CMP_OC AND MCU | 2 | 4.85e-10 | 0.0 % |
| CT_FAIL AND MCU | 2 | 4.27e-10 | 0.0 % |
| CT_FAIL AND XFMR_SAT | 2 | 4.27e-10 | 0.0 % |
| LOGIC_OR AND MCU | 2 | 3.88e-10 | 0.0 % |
| FW_IPK AND LOAD_SHORT AND TZ_CFG | 3 | 8.41e-14 | 0.0 % |

Fussell-Vesely importance (top 6): NO_DESAT 1.00, DRV_HIGH 0.36, MCU 0.23, XTALK 0.23, DRV_UVLO_LOSS 0.18, CT_FAIL 0.00

## TE2b_overcurrent_and_fuse_fails
minimal cut sets: 21, lowest order 3, top-event frequency 1.73e-09 /year, P(10 y) = 1.73e-08

| cut set | order | frequency (/year) | share |
|---|---|---|---|
| FUSE AND NO_DESAT AND SW_PWM | 3 | 8.76e-10 | 50.7 % |
| DRV_HIGH AND FUSE AND NO_DESAT | 3 | 3.10e-10 | 17.9 % |
| FUSE AND MCU AND NO_DESAT | 3 | 1.94e-10 | 11.2 % |
| FUSE AND NO_DESAT AND XTALK | 3 | 1.94e-10 | 11.2 % |
| DRV_UVLO_LOSS AND FUSE AND NO_DESAT | 3 | 1.55e-10 | 9.0 % |
| CT_FAIL AND FUSE AND LOAD_SHORT | 3 | 3.78e-14 | 0.0 % |
| FUSE AND MCU AND TZ_CFG | 3 | 1.94e-14 | 0.0 % |
| CTRL_FAIL AND CT_FAIL AND FUSE | 3 | 7.56e-15 | 0.0 % |
| CMP_OC AND FUSE AND MCU | 3 | 2.15e-15 | 0.0 % |
| CT_FAIL AND FUSE AND MCU | 3 | 1.89e-15 | 0.0 % |
| CT_FAIL AND FUSE AND XFMR_SAT | 3 | 1.89e-15 | 0.0 % |
| FUSE AND LOGIC_OR AND MCU | 3 | 1.72e-15 | 0.0 % |

Fussell-Vesely importance (top 6): FUSE 1.00, NO_DESAT 1.00, SW_PWM 0.51, DRV_HIGH 0.18, MCU 0.11, XTALK 0.11

## TE3_thermal_runaway
minimal cut sets: 15, lowest order 3, top-event frequency 1.68e-09 /year, P(10 y) = 1.68e-08

| cut set | order | frequency (/year) | share |
|---|---|---|---|
| FAN AND HOST AND NTC | 3 | 1.24e-09 | 73.6 % |
| FAN AND FW_OT AND HOST | 3 | 1.11e-10 | 6.6 % |
| CLOG AND FW_OT AND HOST | 3 | 8.59e-11 | 5.1 % |
| CLOG AND HOST AND NTC | 3 | 6.05e-11 | 3.6 % |
| FAN AND HOST AND MCU | 3 | 5.56e-11 | 3.3 % |
| CLOG AND HOST AND MCU | 3 | 4.29e-11 | 2.6 % |
| AMB_HI AND HOST AND NTC | 3 | 4.12e-11 | 2.5 % |
| FW_OT AND HOST AND TIM | 3 | 1.72e-11 | 1.0 % |
| HOST AND NTC AND TIM | 3 | 1.21e-11 | 0.7 % |
| HOST AND MCU AND TIM | 3 | 8.59e-12 | 0.5 % |
| AMB_HI AND FW_OT AND HOST | 3 | 3.70e-12 | 0.2 % |
| AMB_HI AND HOST AND MCU | 3 | 1.85e-12 | 0.1 % |

Fussell-Vesely importance (top 6): HOST 1.00, FAN 0.83, NTC 0.80, FW_OT 0.13, CLOG 0.11, MCU 0.07

## TE2 with the UCC21710 (DESAT) upgrade, DESAT coverage 99 % assumed
frequency 1.94e-06 /year (rev A: 1.93e-04), ratio 99.2

## TE2 with a CT plausibility check: frequency 1.93e-04 /year
## TE3 with an NTC plausibility check: frequency 3.82e-10 /year (rev A: 1.68e-09)
