murugan-paramesh/SiC-DC-DC-Converter/Advanced_Research_2026/SiC_Health_Monitoring/results/detection_tables.md

| T sensor | h | false alarm frac (healthy, 3 y) | detect frac (degrading, 3 y) | alarm time rel. to 1 % crossing, mean (days) | p90 (days) | true dR at alarm, mean (%) | p90 (%) |
|---|---|---|---|---|---|---|---|
| heatsink_ntc | 0.5 % | 0.00 | 1.00 | -3 | +8 | 0.99 | 1.04 |
| heatsink_ntc | 1.0 % | 0.00 | 1.00 | +13 | +24 | 1.06 | 1.11 |
| heatsink_ntc | 1.5 % | 0.00 | 1.00 | +26 | +38 | 1.13 | 1.18 |
| heatsink_ntc | 2.0 % | 0.00 | 1.00 | +36 | +45 | 1.17 | 1.21 |
| heatsink_ntc | 3.0 % | 0.00 | 1.00 | +53 | +66 | 1.25 | 1.30 |
| heatsink_ntc | 5.0 % | 0.00 | 1.00 | +80 | +92 | 1.36 | 1.42 |
| case_sensor | 0.5 % | 0.00 | 1.00 | +1 | +10 | 1.00 | 1.05 |
| case_sensor | 1.0 % | 0.00 | 1.00 | +18 | +29 | 1.08 | 1.14 |
| case_sensor | 1.5 % | 0.00 | 1.00 | +29 | +38 | 1.14 | 1.18 |
| case_sensor | 2.0 % | 0.00 | 1.00 | +41 | +52 | 1.19 | 1.24 |
| case_sensor | 3.0 % | 0.00 | 1.00 | +57 | +66 | 1.26 | 1.30 |
| case_sensor | 5.0 % | 0.00 | 1.00 | +84 | +94 | 1.38 | 1.43 |
| junction_model | 0.5 % | 0.62 | 1.00 | -41 | +1 | 0.82 | 1.00 |
| junction_model | 1.0 % | 0.29 | 1.00 | -16 | +34 | 0.93 | 1.16 |
| junction_model | 1.5 % | 0.08 | 1.00 | +11 | +59 | 1.05 | 1.27 |
| junction_model | 2.0 % | 0.00 | 1.00 | +26 | +90 | 1.12 | 1.41 |
| junction_model | 3.0 % | 0.00 | 1.00 | +47 | +102 | 1.22 | 1.46 |
| junction_model | 5.0 % | 0.00 | 1.00 | +79 | +123 | 1.36 | 1.56 |

| temperature error case (case sensor, h = 2 %) | false alarm frac | detect frac | alarm time rel. to 1 % (days) | true dR at alarm (%) |
|---|---|---|---|---|
| mission_shift_loadbias_x0.0 | 0.00 | 1.00 | +37 | 1.18 |
| mission_shift_loadbias_x0.5 | 0.00 | 1.00 | +37 | 1.18 |
| mission_shift_loadbias_x1.0 | 0.00 | 1.00 | +38 | 1.18 |
| mission_shift_loadbias_x2.0 | 0.00 | 1.00 | +38 | 1.18 |
| sigmaT_0.5K | 0.00 | 1.00 | +37 | 1.18 |
| sigmaT_1.0K | 0.00 | 1.00 | +36 | 1.17 |
| sigmaT_2.0K | 0.00 | 1.00 | +38 | 1.18 |
| sigmaT_5.0K | 0.00 | 1.00 | +28 | 1.13 |
| sigmaT_10.0K | 0.00 | 1.00 | +23 | 1.11 |
| loadbias_x0.0 | 0.00 | 1.00 | +38 | 1.18 |
| loadbias_x0.5 | 0.00 | 1.00 | +37 | 1.18 |
| loadbias_x1.0 | 0.00 | 1.00 | +36 | 1.17 |
| loadbias_x2.0 | 0.00 | 1.00 | +35 | 1.17 |
| sensor_drift_1.0K_over_3y | 0.00 | 1.00 | +25 | 1.12 |
| sensor_drift_2.0K_over_3y | 1.00 | 1.00 | +14 | 1.06 |
| sensor_drift_3.0K_over_3y | 1.00 | 1.00 | +6 | 1.03 |
| sensor_drift_5.0K_over_3y | 1.00 | 1.00 | -10 | 0.96 |
