murugan-paramesh/SiC-DC-DC-Converter/Advanced_Research_2026/Physics_Informed_Models/results/metrics_table.md

| model | train pts | RMSE P (W) | RMSE I_rms1 (A) | RMSE I_peak1 (A) | RMSE m_zvs1 (A) | RMSE m_zvs2 (A) | worst RMSE (% range) | max abs err P (W) | extrap. worst RMSE (% range) | ops/eval | n for 1 % (all) | train (s) |
|---|---|---|---|---|---|---|---|---|---|---|---|---|
| A2_analytic_tps_piecewise | 0 | 4.38 | 0.00463 | 0.00648 | 0.0436 | 0.0244 | 0.116 | 12.8 | 0.116 | 420 | - | 0.0 |
| MLP_plain | 6912 | 21.8 | 0.0519 | 0.134 | 0.112 | 0.113 | 0.589 | 81.8 | 0.697 | 3200 | 3200 | 10.4 |
| HYB_sps_plus_residual | 6912 | 19.4 | 0.0403 | 0.0952 | 0.243 | 0.224 | 0.646 | 74.4 | 0.718 | 3200 | 3200 | 10.6 |
| PINN_physics_loss | 6912 | 38.3 | 0.0733 | 0.182 | 0.178 | 0.171 | 0.797 | 160 | 0.932 | 3200 | 3200 | 33.5 |
| LUT_multilinear | 6912 | 64.6 | 0.111 | 0.357 | 0.439 | 0.418 | 1.565 | 175 | 1.924 | 458 | None | 0.0 |
| GP_rbf | 6912 | 14.2 | 0.0593 | 0.393 | 0.368 | 0.288 | 1.720 | 60.7 | 2.155 | 187500 | None | 3.3 |
| P3_polynomial | 6912 | 59.2 | 0.208 | 0.707 | 0.86 | 0.856 | 3.097 | 223 | 3.853 | 728 | None | 0.0 |
| A1_sps_closed_form | 0 | 1.37e+03 | 1.29 | 1.55 | 10.9 | 10.8 | 29.073 | 4.07e+03 | 29.059 | 160 | - | 0.0 |

Per-output RMSE as % of the test-set range (full training grid, 6912 points):

| model | P | I_rms1 | I_peak1 | m_zvs1 | m_zvs2 | extrap P | extrap I_rms1 | extrap I_peak1 | extrap m_zvs1 | extrap m_zvs2 |
|---|---|---|---|---|---|---|---|---|---|---|
| A2_analytic_tps_piecewise | 0.037 | 0.026 | 0.028 | 0.116 | 0.062 | 0.032 | 0.025 | 0.028 | 0.116 | 0.059 |
| MLP_plain | 0.185 | 0.290 | 0.589 | 0.299 | 0.289 | 0.337 | 0.538 | 0.697 | 0.445 | 0.355 |
| HYB_sps_plus_residual | 0.164 | 0.225 | 0.417 | 0.646 | 0.571 | 0.221 | 0.291 | 0.548 | 0.691 | 0.718 |
| PINN_physics_loss | 0.325 | 0.409 | 0.797 | 0.472 | 0.436 | 0.441 | 0.550 | 0.932 | 0.656 | 0.476 |
| LUT_multilinear | 0.547 | 0.619 | 1.565 | 1.167 | 1.067 | 0.559 | 0.603 | 1.924 | 1.416 | 1.072 |
| GP_rbf | 0.120 | 0.331 | 1.720 | 0.979 | 0.736 | 0.140 | 0.571 | 2.155 | 1.216 | 0.724 |
| P3_polynomial | 0.502 | 1.161 | 3.097 | 2.286 | 2.186 | 0.553 | 1.232 | 3.853 | 2.635 | 1.942 |
| A1_sps_closed_form | 11.644 | 7.212 | 6.778 | 29.073 | 27.527 | 11.675 | 7.824 | 8.850 | 29.059 | 27.531 |

Data efficiency (worst-output RMSE in % of range vs number of training points):

| model | 48 | 324 | 864 | 3200 | 6912 |
|---|---|---|---|---|---|
| P3_polynomial | 18.39 | 4.88 | 4.50 | 3.16 | 3.10 |
| LUT_multilinear | 12.91 | 4.14 | 3.30 | 1.82 | 1.57 |
| MLP_plain | 13.70 | 2.95 | 3.02 | 0.85 | 0.59 |
| PINN_physics_loss | 13.80 | 3.60 | 3.02 | 0.93 | 0.80 |
| HYB_sps_plus_residual | 15.26 | 2.97 | 3.05 | 0.72 | 0.65 |
| GP_rbf | 12.92 | 3.81 | 3.26 | 1.68 | 1.72 |
