murugan-paramesh/SiC-DC-DC-Converter/Advanced_Research_2026/Safe_RL_Research/results/results_table.md

| method | mean I_rms (A) | rel. to PI+EPS | max I_peak (A) | ZVS edges | hard violations (post-filter) | fallbacks | mean |P err| (%) |
|---|---|---|---|---|---|---|---|
| PI_EPS | 8.118 | 1.0000 | 18.43 | 76/104 | 6 | 0 | 2.06 |
| TPS_analytical | 8.088 | 0.9963 | 18.25 | 72/100 | 6 | 0 | 2.13 |
| M1_CEM | 8.182 | 1.0079 | 18.52 | 92/128 | 8 | 6 | 2.09 |
| M2_REINFORCE | 8.121 | 1.0004 | 18.46 | 72/108 | 7 | 0 | 2.12 |

| V1/V2/P | ZVS feasible | PI_EPS I_rms / ZVS / (phi deg, D1, D2) | TPS_analytical I_rms / ZVS / (phi deg, D1, D2) | M1_CEM I_rms / ZVS / (phi deg, D1, D2) | M2_REINFORCE I_rms / ZVS / (phi deg, D1, D2) |
|---|---|---|---|---|---|
| 650/300/3.3 kW | True | 6.07 A / 6/6 / (22.7, 0.92, 1.00) | 6.07 A / 6/6 / (22.7, 0.93, 1.00) | 6.07 A / 6/6 / (22.7, 0.92, 1.00) | 5.72 A / 4/4 / (22.3, 1.00, 1.00) |
| 650/300/6.6 kW | True | 13.79 A / 6/6 / (57.6, 0.92, 1.00) | 13.88 A / 4/4 / (57.2, 1.00, 1.00) | 13.79 A / 6/6 / (57.6, 0.92, 1.00) | 13.74 A / 6/6 / (58.3, 0.90, 1.00) |
| 650/400/3.3 kW | False | 6.01 A / 2/6 / (18.3, 1.00, 0.81) | 6.01 A / 2/6 / (18.3, 1.00, 0.81) | 5.84 A / 2/8 / (17.7, 0.96, 0.83) | 5.75 A / 2/8 / (18.7, 0.90, 0.80) |
| 650/400/6.6 kW | True | 11.37 A / 6/6 / (39.6, 1.00, 0.81) | 11.17 A / 6/6 / (37.3, 1.00, 0.93) | 11.20 A / 8/8 / (39.2, 0.98, 0.83) | 11.04 A / 4/4 / (36.7, 1.00, 1.00) |
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

Transient (50->100 % step): PI+EPS dip 1.46 V, settle 0.009999999998746689 ms, max peak 12.0 A; PI + M1 duties: dip 1.50 V, settle 0.009999999998746689 ms, max peak 12.1 A, filter rejected 3/223, fallback periods 377.
