murugan-paramesh/SiC-DC-DC-Converter/SiC_6k6_Industrial_DAB/10_Firmware/sil/sil_results.csv

period | t_ms | v1 | v2 | phi_deg | d1 | d2 | state | p_cmd
0 | 0.000 | 800.00 | 379.93 | 0.00 | 1.000 | 1.000 | 1 | 0
10 | 0.100 | 799.82 | 379.47 | 5.76 | 0.949 | 1.000 | 2 | 792
20 | 0.200 | 799.59 | 379.21 | 8.29 | 0.949 | 1.000 | 2 | 1426
30 | 0.300 | 799.39 | 379.05 | 10.20 | 0.948 | 1.000 | 2 | 1890
40 | 0.400 | 799.22 | 378.97 | 11.61 | 0.948 | 1.000 | 2 | 2226
50 | 0.500 | 799.05 | 378.98 | 12.46 | 0.949 | 1.000 | 2 | 2428
60 | 0.600 | 798.96 | 379.00 | 13.28 | 0.949 | 1.000 | 2 | 2618
70 | 0.700 | 798.85 | 379.09 | 13.63 | 0.949 | 1.000 | 2 | 2699
80 | 0.800 | 798.78 | 379.19 | 13.75 | 0.949 | 1.000 | 2 | 2726
90 | 0.900 | 798.74 | 379.30 | 13.83 | 0.950 | 1.000 | 2 | 2745
100 | 1.000 | 798.72 | 379.41 | 13.88 | 0.950 | 1.000 | 2 | 2757
110 | 1.100 | 798.70 | 379.52 | 13.84 | 0.950 | 1.000 | 2 | 2750
120 | 1.200 | 798.69 | 379.63 | 13.77 | 0.951 | 1.000 | 2 | 2735
130 | 1.300 | 798.68 | 379.74 | 13.67 | 0.951 | 1.000 | 2 | 2712
140 | 1.400 | 798.68 | 379.85 | 13.53 | 0.951 | 1.000 | 2 | 2681
150 | 1.500 | 798.70 | 379.93 | 13.50 | 0.951 | 1.000 | 2 | 2674
160 | 1.600 | 798.70 | 380.02 | 13.51 | 0.952 | 1.000 | 2 | 2677
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
