murugan-paramesh/SiC-DC-DC-Converter/Advanced_Research_2026/Adaptive_MPC/results/adaptive_robust_metrics.csv

settling_ms | overshoot_pct | peak_dev_pct | ITAE | i_peak_A | i_rms_A | violations | violations_hw | compute_us_mean | compute_us_max | v2_min | v2_max | controller | L_plant_frac
0.0 | 0.015334802441455193 | 0.13665400867465552 | 1.7064691612041385 | 22.603955438223593 | 11.588647060147228 | 0 | 0 | 652.3145200000044 | 4730.28900000827 | 449.38505696096405 | 450.06900661098655 | CCS-MPC | 0.8
0.0 | 0.01608991616317073 | 0.14564975654516527 | 1.6365711052333451 | 22.516454459210802 | 11.589667098101284 | 0 | 0 | 791.8439385007332 | 2567.38400003087 | 449.34457609554676 | 450.07240462273427 | Adaptive-MPC | 0.8
0.0 | 0.01580832866061933 | 0.14042390481665734 | 1.7100114856365867 | 23.0045386205016 | 11.591722704697718 | 0 | 0 | 673.5637525015363 | 2136.194000058822 | 449.36809242832504 | 450.0711374789728 | Robust-MPC | 0.8
1.829999999949601 | 0.007789503923289784 | 0.5543762064502668 | 6.3050540327718965 | 21.2390132628053 | 11.596582097844184 | 0 | 0 | 11.280958500719862 | 140.92700007495296 | 447.5053070709738 | 450.0350527676548 | PI | 0.8
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
