murugan-paramesh/SiC-DC-DC-Converter/Advanced_Research_2026/Adaptive_MPC/results/benchmark_ccs_r_sweep.csv

settling_ms | overshoot_pct | peak_dev_pct | ITAE | i_peak_A | i_rms_A | violations | violations_hw | compute_us_mean | compute_us_max | v2_min | v2_max | r
0.0 | 0.01990757444350777 | 0.1160669680680826 | 1.7116960344175123 | 19.24312480025127 | 10.840051661060373 | 0 | 0 | 671.1488870021185 | 4993.31500009248 | 399.53573212772767 | 400.07963029777403 | 2
0.0 | 0.018407099806694305 | 0.14623475318380486 | 1.4880744716516663 | 14.791223784327043 | 9.635137138106447 | 0 | 0 | 697.7470179979264 | 2339.041999903202 | 399.4150609872648 | 400.0736283992268 | 8
0.0 | 0.016787456919800547 | 0.16619869376678764 | 1.6015624237856412 | 13.888225996106515 | 9.437589518530949 | 0 | 0 | 731.0787005004613 | 2888.2070000690874 | 399.33520522493285 | 400.0671498276792 | 16
0.0 | 0.016167628661293065 | 0.18614435659145556 | 1.5390535924223765 | 14.701587274669972 | 9.373756499801436 | 0 | 0 | 626.3523479971127 | 3030.2110001230176 | 399.2554225736342 | 400.0646705146452 | 32
0.19999999995928136 | 0.07589254242122934 | 0.2762115418603912 | 1.9108865502454848 | 15.873545386080952 | 9.385579767214589 | 0 | 0 | 635.7462250023218 | 2387.4389999036794 | 398.89515383255844 | 400.3035701696849 | 128
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
