murugan-paramesh/SiC-DC-DC-Converter/Advanced_Research_2026/Adaptive_MPC/results/benchmark_metrics.csv

settling_ms | overshoot_pct | peak_dev_pct | ITAE | i_peak_A | i_rms_A | violations | violations_hw | compute_us_mean | compute_us_max | v2_min | v2_max | scenario | controller | ops_total | wall_s
2.1199999999478787 | 0.005199903297437913 | 0.6718900507215864 | 7.295024198265537 | 13.052776774042542 | 9.483825014938416 | 0 | 0 | 11.391974500270408 | 109.0350001504703 | 397.31243979711365 | 400.02079961318975 | load_step_up | PI | 64 | 3.7730674743652344
0.0 | 0.016787456919800547 | 0.16619869376678764 | 1.6015624237856412 | 13.888225996106515 | 9.437589518530949 | 0 | 0 | 636.9469105015924 | 3265.2289999077766 | 399.33520522493285 | 400.0671498276792 | load_step_up | CCS-MPC | 2428 | 4.839304447174072
0.0 | 0.008323360365608323 | 0.21240353809537285 | 2.556348797791878 | 14.518820619630198 | 9.37437033902557 | 0 | 0 | 488.69601849742145 | 4559.464000067237 | 399.1503858476185 | 400.03329344146243 | load_step_up | FCS-MPC | 8001 | 4.773032903671265
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
