murugan-paramesh/SiC-DC-DC-Converter/Advanced_Research_2026/Adaptive_MPC/results/benchmark_modulators.csv

settling_ms | overshoot_pct | peak_dev_pct | ITAE | i_peak_A | i_rms_A | violations | violations_hw | compute_us_mean | compute_us_max | v2_min | v2_max | modulator | controller | scenario | i_rms_full_load_A | zvs_margin_HV_A | zvs_margin_LV_A
1.8999999999491854 | 0.010256849272745209 | 0.9300493793515064 | 6.885799638181537 | 23.04345192342743 | 12.291808715466361 | 0 | 0 | 9.137490998568865 | 71.78000009844254 | 297.2098518619455 | 300.03077054781824 | SPS | PI | load_step_up_850_300 | 12.22267960274263 | 16.840081603435735 | 2.297167279000537
0.0 | 0.02695763034300095 | 0.2856760585783036 | 1.546389409711045 | 30.215523983718565 | 12.297474691630718 | 21 | 0 | 375.77132650073963 | 2019.073999917964 | 299.1429718242651 | 300.080872891029 | SPS | CCS-MPC | load_step_up_850_300 | 12.22799815890584 | 17.191003344047143 | 2.794399767489552
 | 0.0 | 1.747798640181145 | 333.1614215765375 | 22.156432821600873 | 11.891796117994442 | 0 | 0 | 10.529526500477004 | 191.4130000386649 | 294.75660407945657 | 299.8125837182596 | EPS | PI | load_step_up_850_300 | 11.974597469621925 | 2.2556963315551566 | 5.1254161372384
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
