murugan-paramesh/SiC-DC-DC-Converter/Advanced_Research_2026/Adaptive_MPC/results/zvs_dead_time_table.csv

device | V | I_edge_A | Qoss_nC | t_d_ns | clipped_500ns | t_d_table_ns
HV C3M0032120K | 650 | 0.5 | 162.49999999999997 | 649.9999999999999 | True | 500.0
HV C3M0032120K | 650 | 1.0 | 162.49999999999997 | 324.99999999999994 | False | 324.99999999999994
HV C3M0032120K | 650 | 1.5 | 162.49999999999997 | 216.66666666666666 | False | 216.66666666666666
HV C3M0032120K | 650 | 2.0 | 162.49999999999997 | 162.49999999999997 | False | 162.49999999999997
HV C3M0032120K | 650 | 2.5 | 162.49999999999997 | 129.99999999999997 | False | 129.99999999999997
HV C3M0032120K | 650 | 3.0 | 162.49999999999997 | 108.33333333333333 | False | 108.33333333333333
HV C3M0032120K | 650 | 3.5 | 162.49999999999997 | 92.85714285714285 | False | 92.85714285714285
HV C3M0032120K | 650 | 4.0 | 162.49999999999997 | 81.24999999999999 | False | 81.24999999999999
HV C3M0032120K | 650 | 4.5 | 162.49999999999997 | 72.22222222222221 | False | 72.22222222222221
HV C3M0032120K | 650 | 5.0 | 162.49999999999997 | 64.99999999999999 | False | 64.99999999999999
HV C3M0032120K | 650 | 6.0 | 162.49999999999997 | 54.166666666666664 | False | 54.166666666666664
HV C3M0032120K | 650 | 7.0 | 162.49999999999997 | 50.0 | False | 50.0
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
