murugan-paramesh/SiC-DC-DC-Converter/Advanced_Research_2026/Adaptive_MPC/results/zvs_maps.csv

case | modulation | V1 | V2 | P_frac | phi | zvs1 | zvs2 | Irms | Ipk | feasible | Imin1 | Imin2 | D1 | D2 | zvs_min | hard_switching
nominal | SPS | 650.0 | 300.0 | -1.0 | -0.9967815648510205 | 15.23046874999958 | 12.947928021243964 | 13.81859755426397 | 16.859375000000675 | True | 1.625 | 1.149728228756692 | 1.0 | 1.0 | 12.947928021243964 | False
nominal | SPS | 650.0 | 300.0 | -0.9 | -0.8337184731973046 | 12.792968749999533 | 10.307303021243955 | 11.824976347240725 | 14.421875000000666 | True | 1.625 | 1.149728228756692 | 1.0 | 1.0 | 10.307303021243955 | False
nominal | SPS | 650.0 | 300.0 | -0.8 | -0.7006960006273824 | 10.824218749999982 | 8.17449052124317 | 10.142653684667044 | 12.453125000000167 | True | 1.625 | 1.149728228756692 | 1.0 | 1.0 | 8.17449052124317 | False
nominal | SPS | 650.0 | 300.0 | -0.7000000000000001 | -0.5854713078635707 | 9.089843749999964 | 6.295584271243131 | 8.610105030159087 | 10.718750000000142 | True | 1.625 | 1.149728228756692 | 1.0 | 1.0 | 6.295584271243131 | False
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
