murugan-paramesh/SiC-DC-DC-Converter/Advanced_Research_2026/Active_Gate_Drive/results/fig_dvdt_vs_rg.png

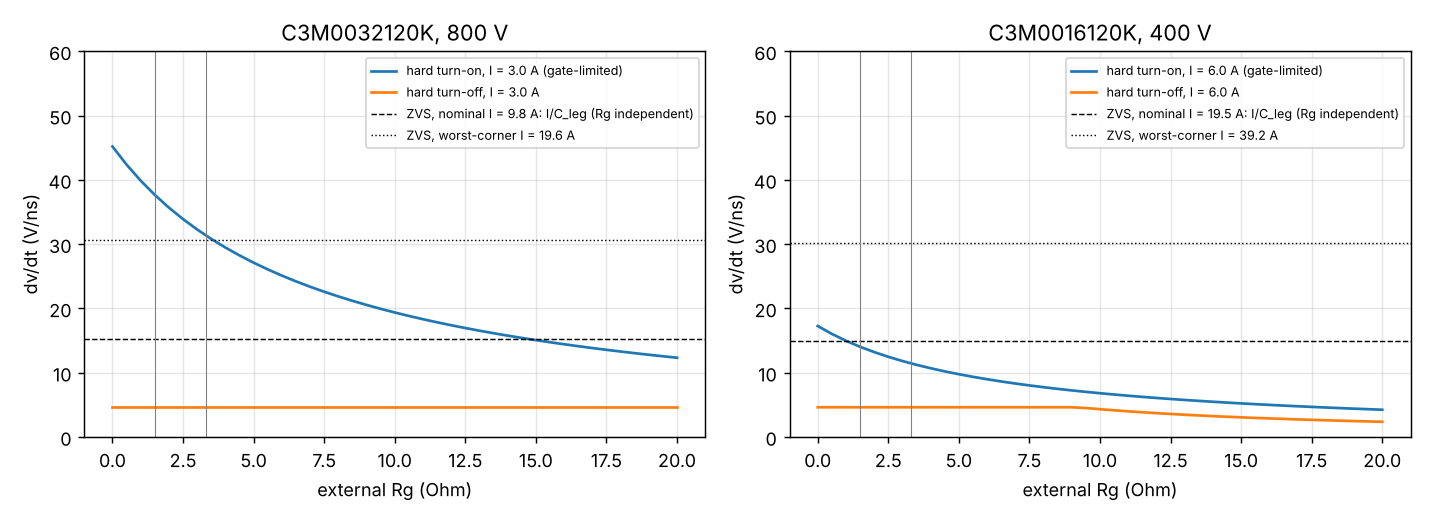
Advanced_Research_2026/Active_Gate_Drive/results/fig_dvdt_vs_rg.png
