murugan-paramesh/SiC-DC-DC-Converter/Advanced_Research_2026/Adaptive_MPC/results/adaptive_rls_convergence.png

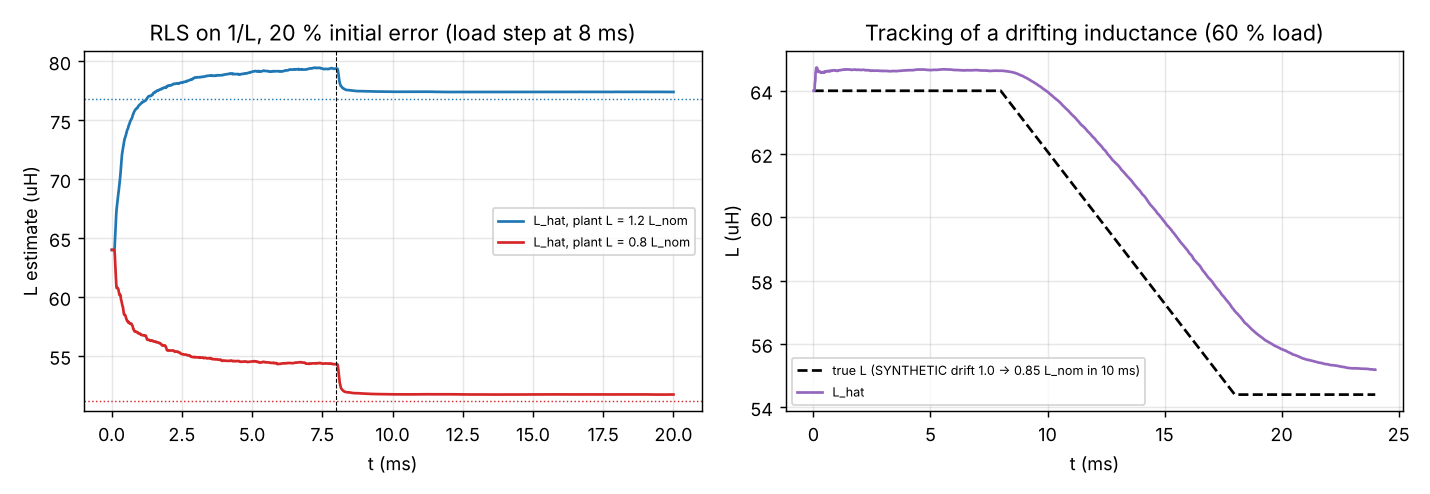
Advanced_Research_2026/Adaptive_MPC/results/adaptive_rls_convergence.png
