murugan-paramesh/SiC-DC-DC-Converter/Advanced_Research_2026/Adaptive_MPC/results/benchmark_metrics_bars.png

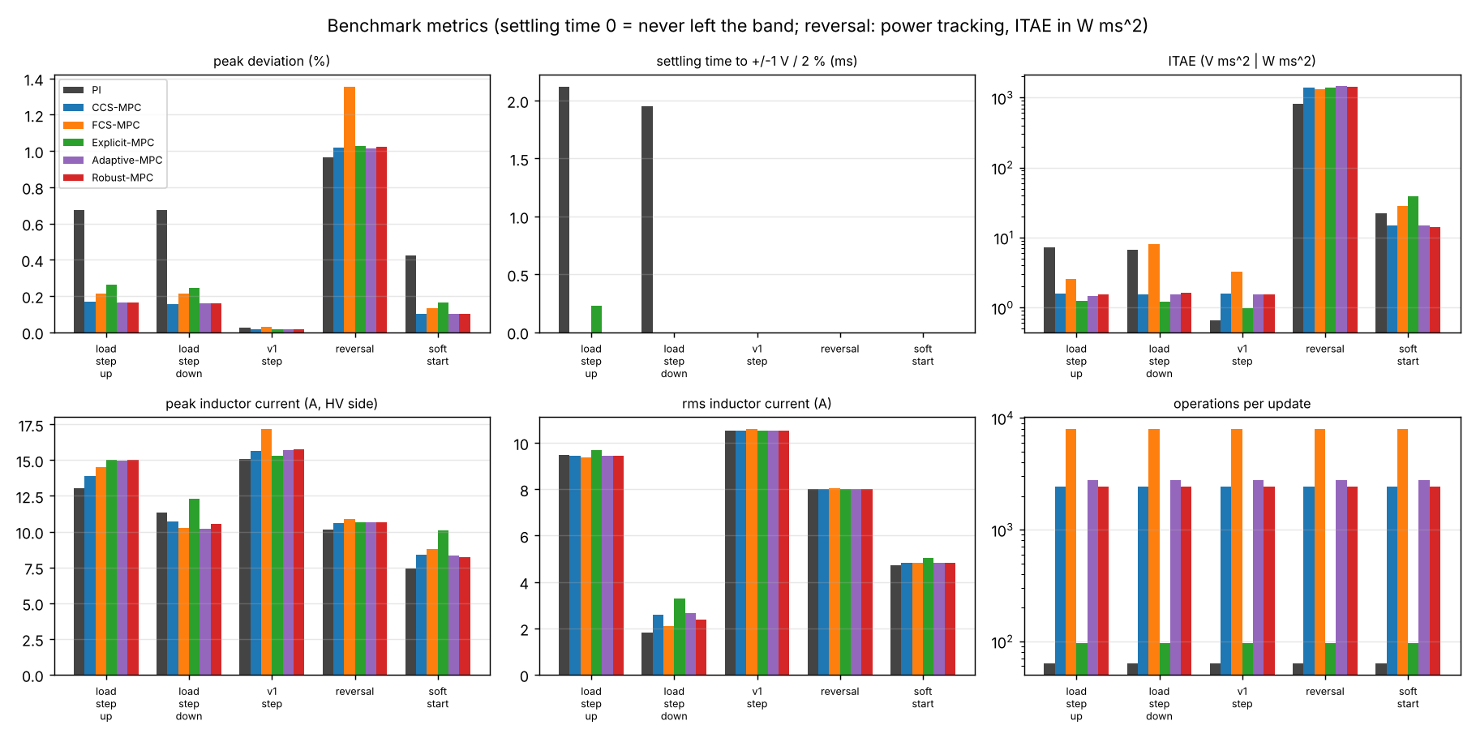
Advanced_Research_2026/Adaptive_MPC/results/benchmark_metrics_bars.png
