murugan-paramesh/SiC-DC-DC-Converter/Advanced_Research_2026/Adaptive_MPC/results/empc_lut_slices.png

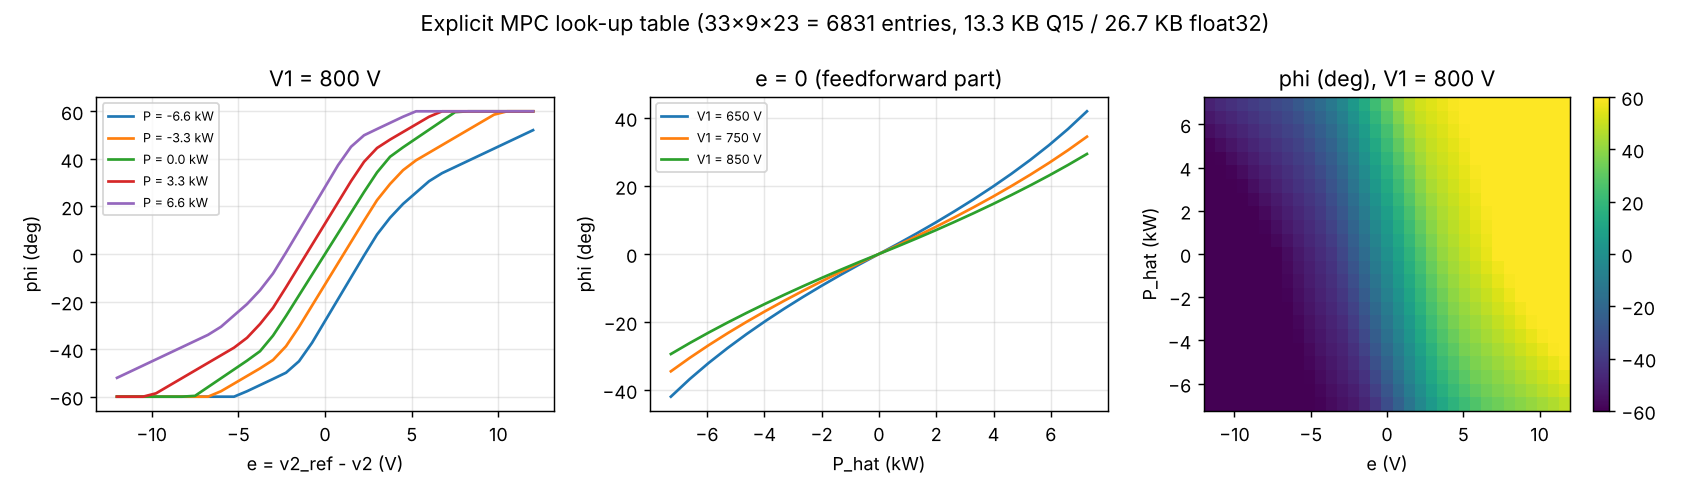
Advanced_Research_2026/Adaptive_MPC/results/empc_lut_slices.png
