murugan-paramesh/SiC-DC-DC-Converter/Advanced_Research_2026/Adaptive_MPC/results/zvs_dead_time_table.png

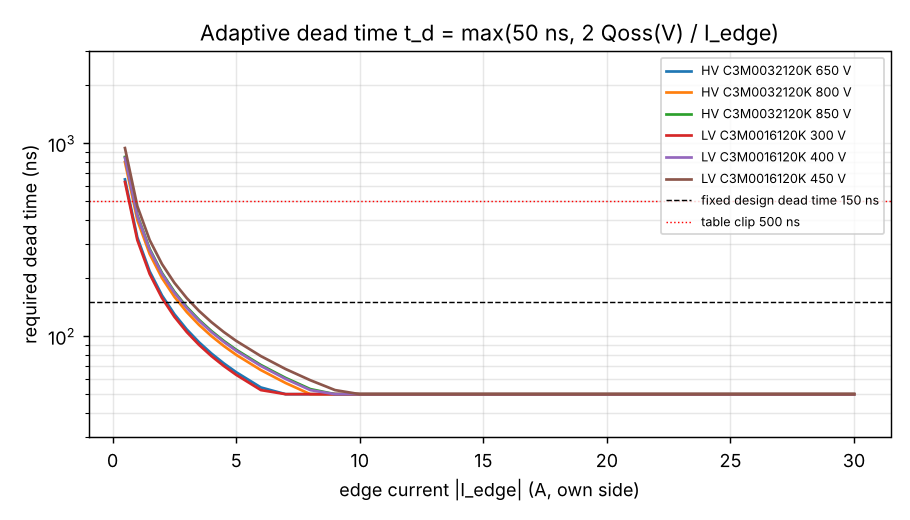
Advanced_Research_2026/Adaptive_MPC/results/zvs_dead_time_table.png
