murugan-paramesh/SiC-DC-DC-Converter/Advanced_Research_2026/Adaptive_MPC/results/zvs_maps_worst_tolerance.png

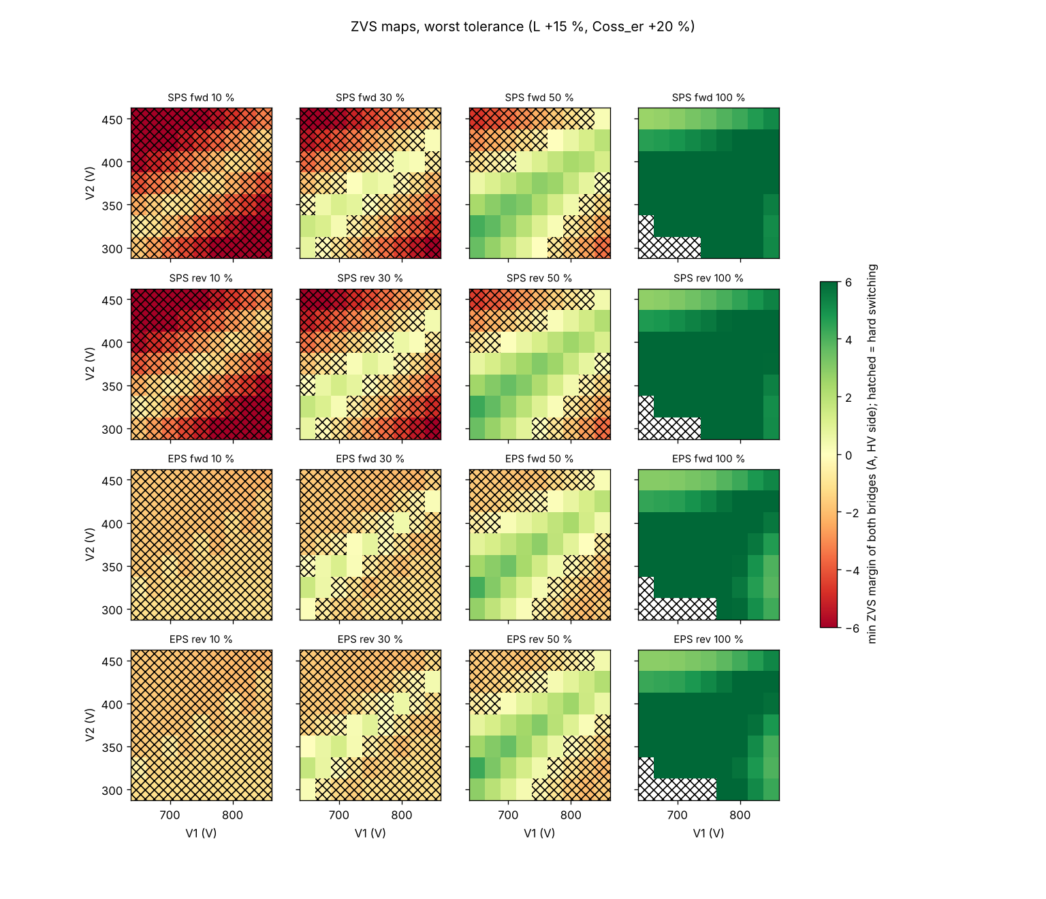
Advanced_Research_2026/Adaptive_MPC/results/zvs_maps_worst_tolerance.png
