murugan-paramesh/SiC-DC-DC-Converter/Advanced_Research_2026/Digital_Twin/results/E3_Coss_identification.png

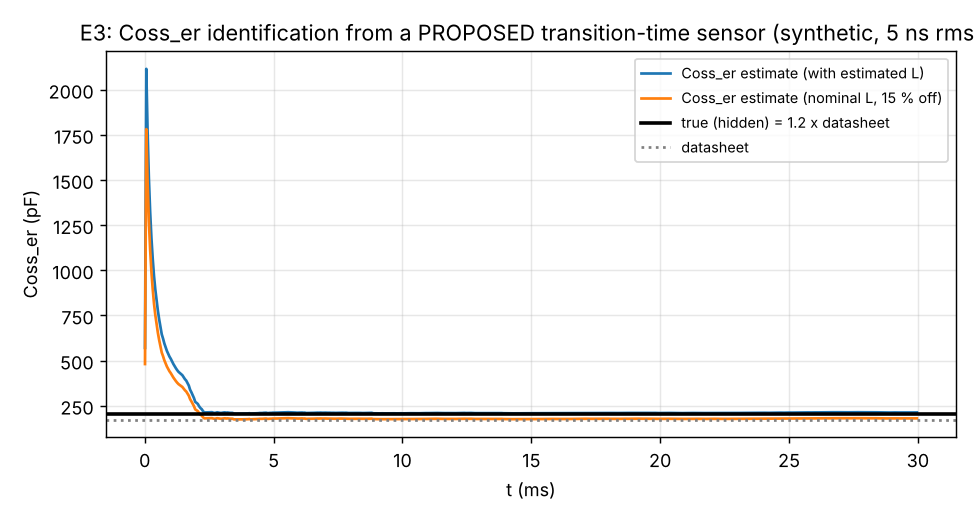
Advanced_Research_2026/Digital_Twin/results/E3_Coss_identification.png
