murugan-paramesh/SiC-DC-DC-Converter/Advanced_Research_2026/Digital_Twin/results/E4_thermal_twin.png

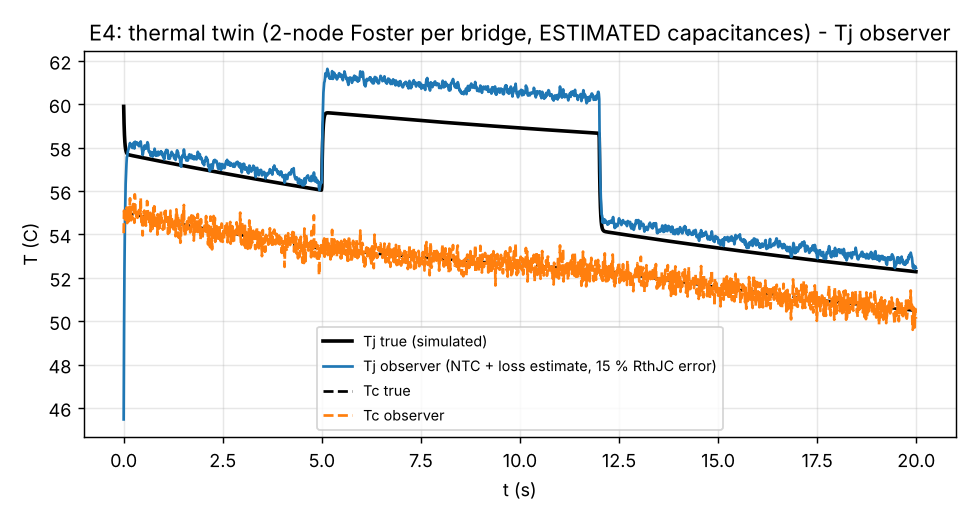
Advanced_Research_2026/Digital_Twin/results/E4_thermal_twin.png
