murugan-paramesh/SiC-DC-DC-Converter/Advanced_Research_2026/Digital_Twin/results/supervisory_study.png

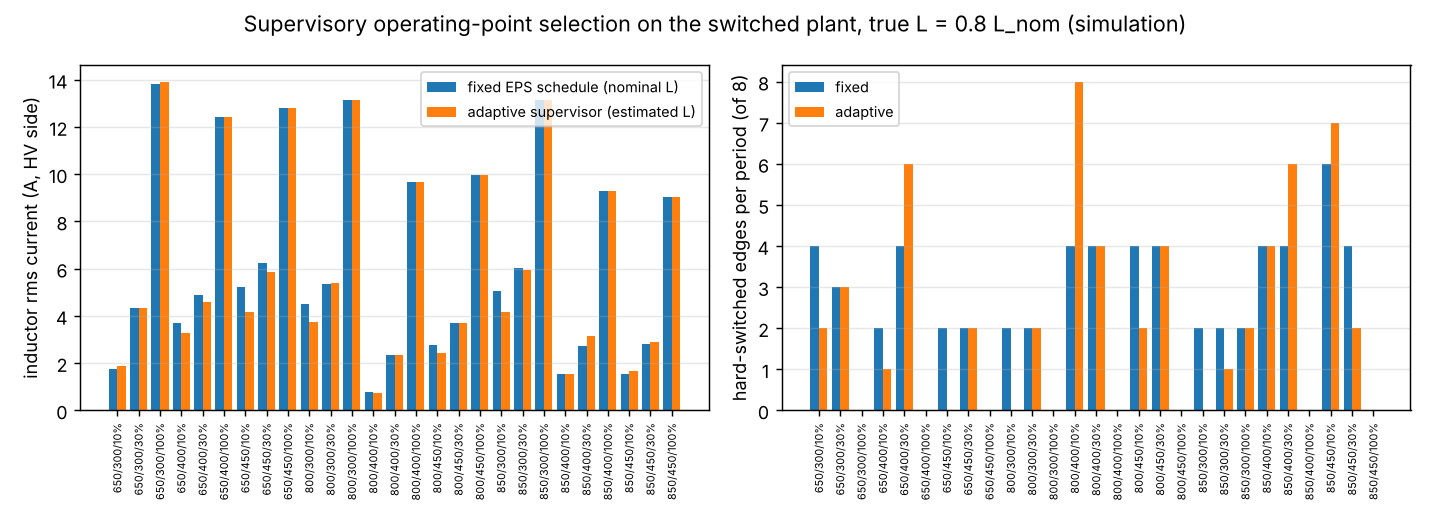
Advanced_Research_2026/Digital_Twin/results/supervisory_study.png
