murugan-paramesh/SiC-DC-DC-Converter/Advanced_Research_2026/Embedded_AI/results/quantisation_errors.png

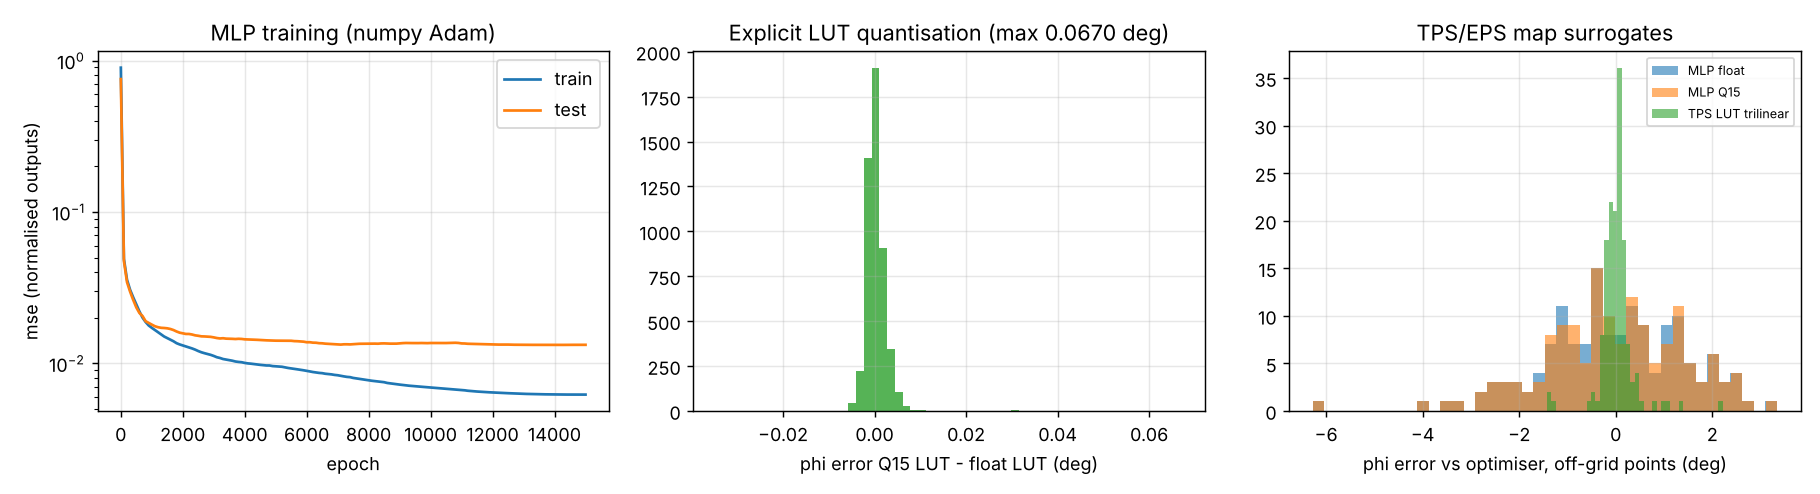
Advanced_Research_2026/Embedded_AI/results/quantisation_errors.png
