murugan-paramesh/SiC-DC-DC-Converter/Advanced_Research_2026/Embedded_AI/results/scheduling_timing.png

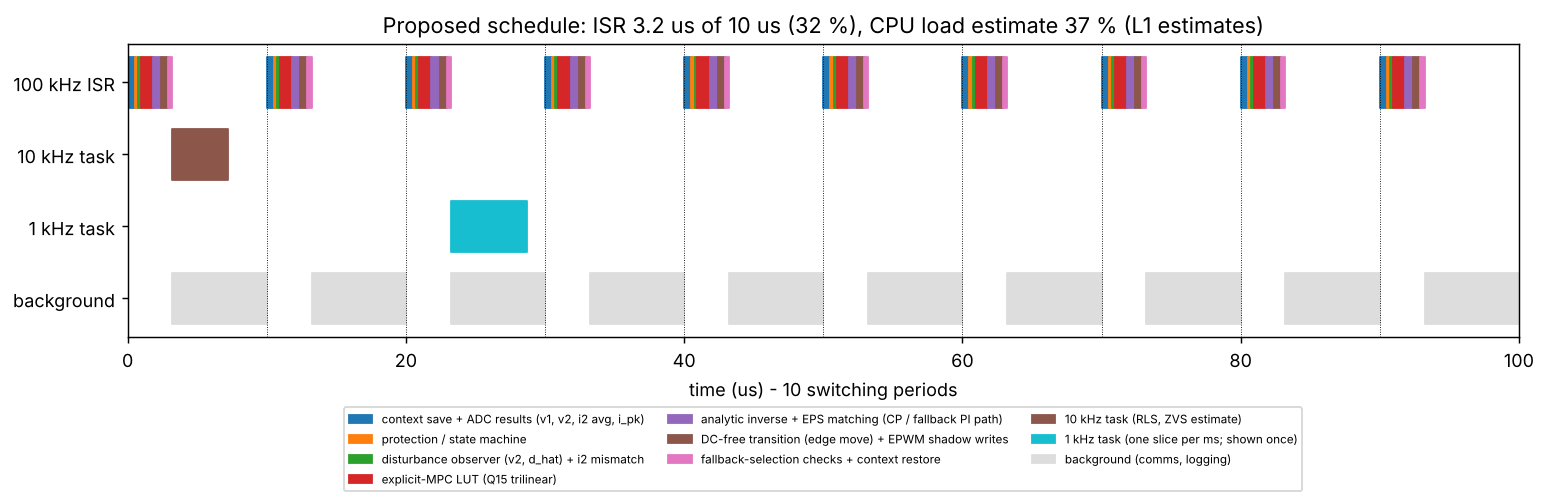
Advanced_Research_2026/Embedded_AI/results/scheduling_timing.png
