murugan-paramesh/SiC-DC-DC-Converter/Advanced_Research_2026/Embedded_AI/results/tps_map_vs_mlp.png

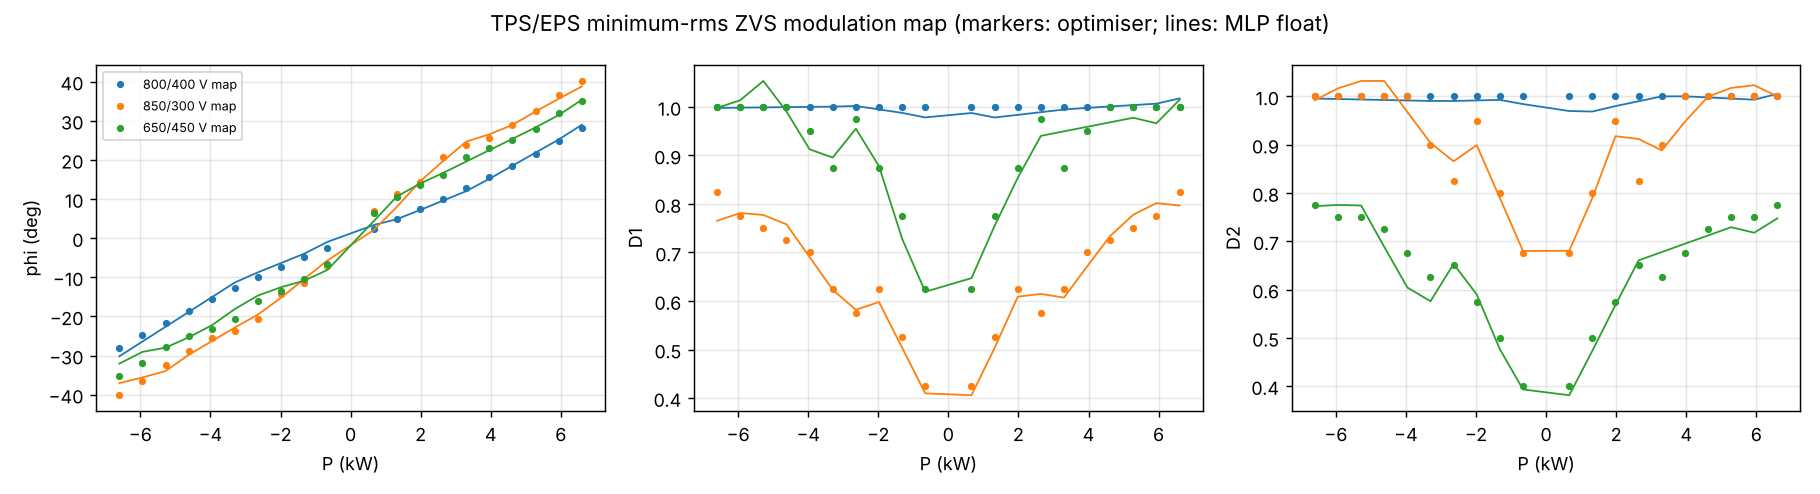
Advanced_Research_2026/Embedded_AI/results/tps_map_vs_mlp.png
