murugan-paramesh/SiC-DC-DC-Converter/Advanced_Research_2026/Embedded_AI/results/wcet_memory.png

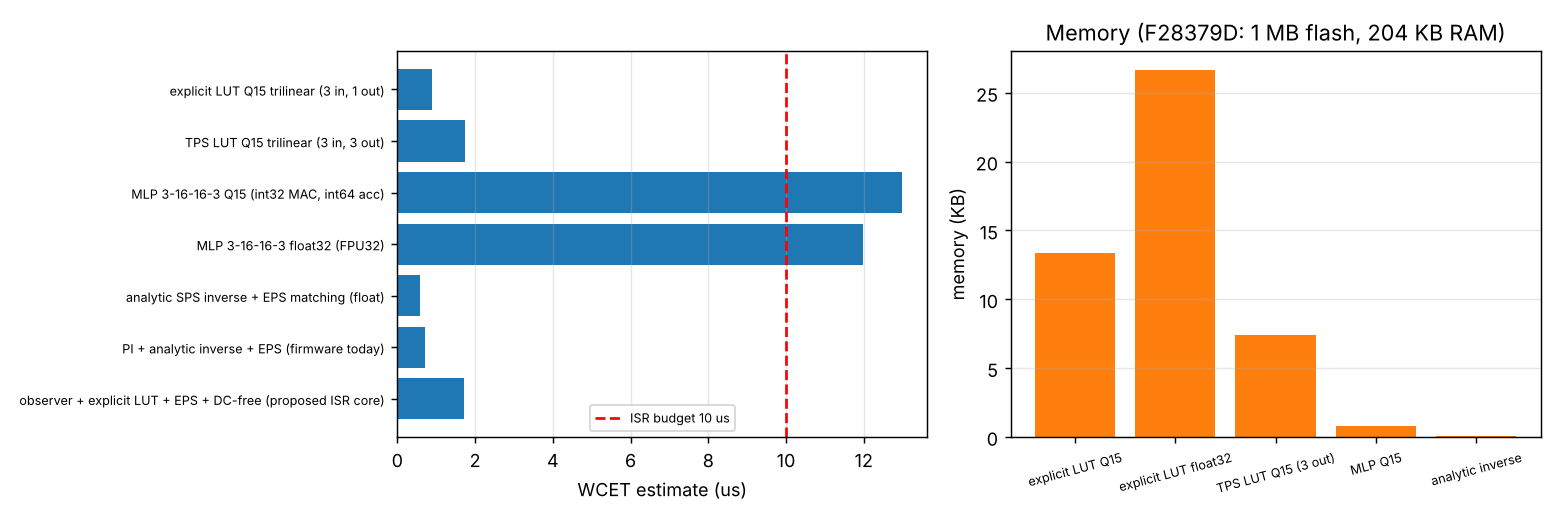
Advanced_Research_2026/Embedded_AI/results/wcet_memory.png
