murugan-paramesh/SiC-DC-DC-Converter/Advanced_Research_2026/FEM_Magnetics/results/fig_field_planar.png

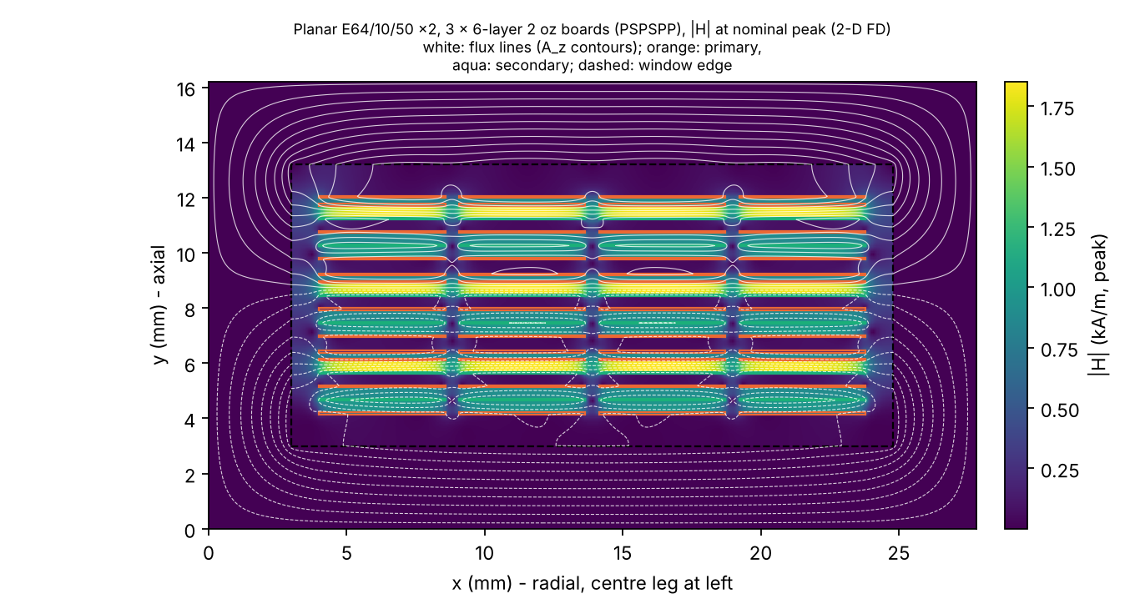
Advanced_Research_2026/FEM_Magnetics/results/fig_field_planar.png
