murugan-paramesh/SiC-DC-DC-Converter/Advanced_Research_2026/HIL_Validation/results/fig_sil_traces.png

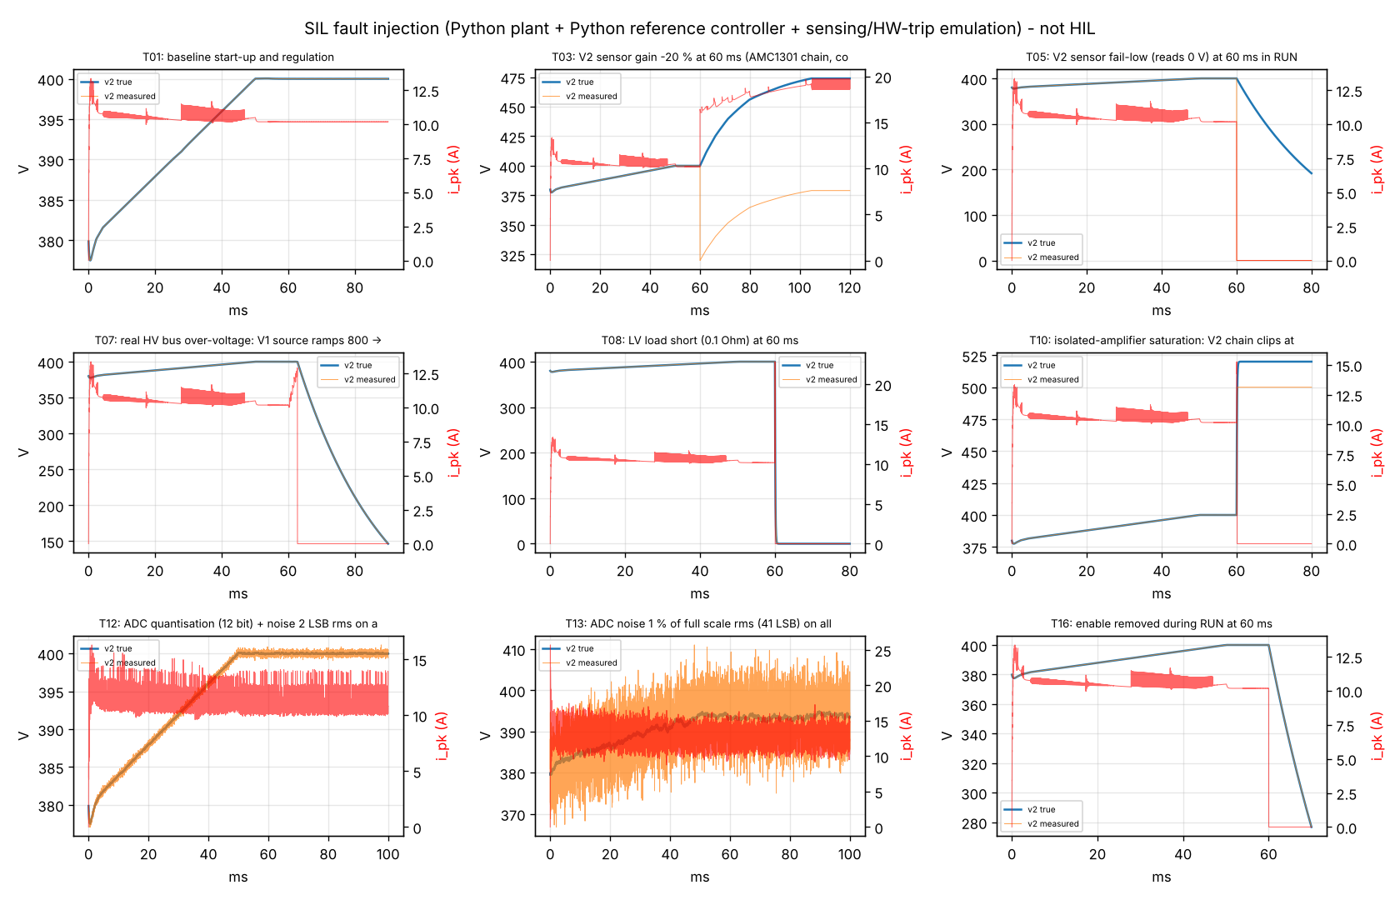
Advanced_Research_2026/HIL_Validation/results/fig_sil_traces.png
