murugan-paramesh/SiC-DC-DC-Converter/Advanced_Research_2026/Multiphysics_Models/results/fig_coupling_diagram.png

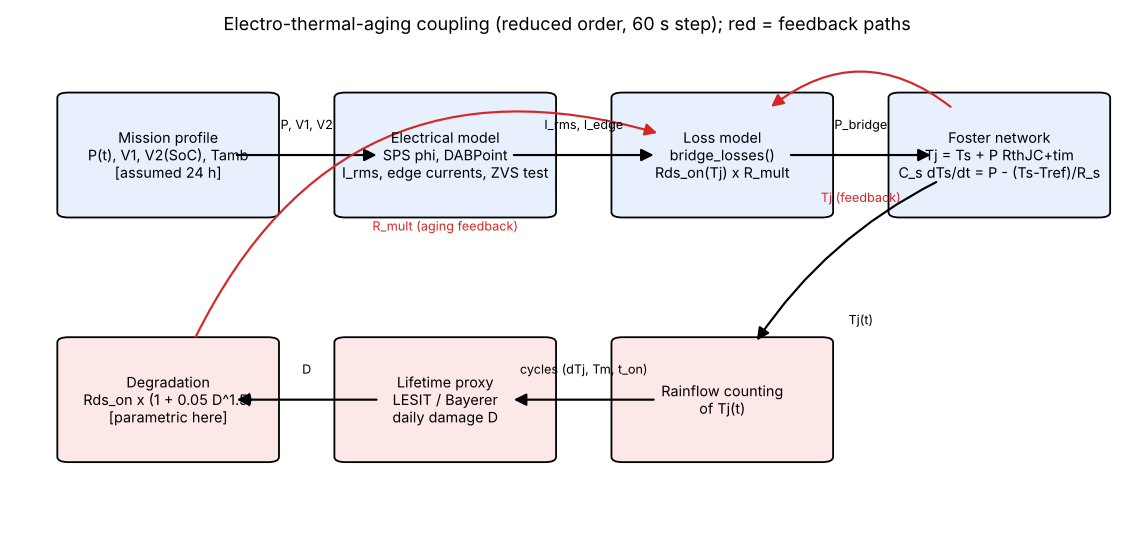
Advanced_Research_2026/Multiphysics_Models/results/fig_coupling_diagram.png
