murugan-paramesh/SiC-DC-DC-Converter/Advanced_Research_2026/Multiphysics_Models/results/fig_lifetime_ratio.png

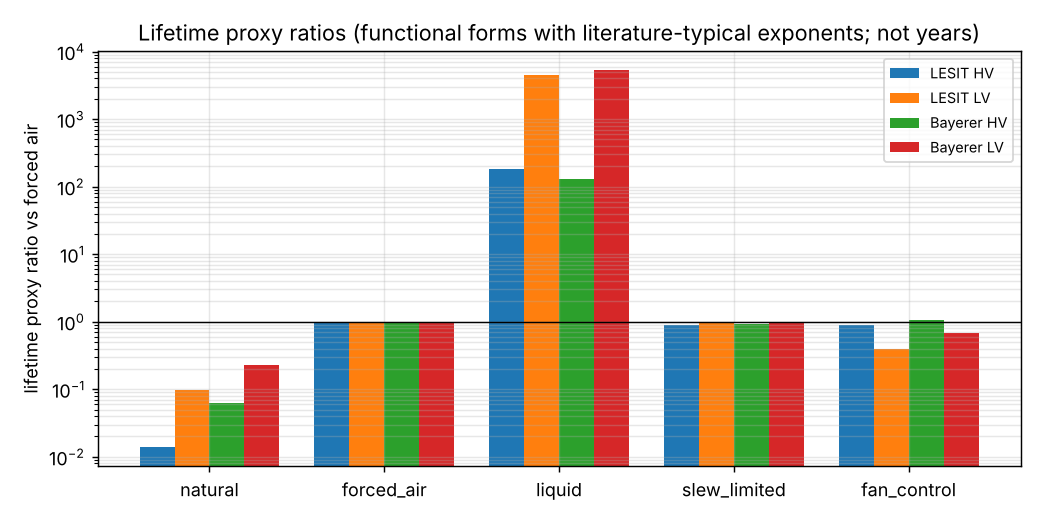
Advanced_Research_2026/Multiphysics_Models/results/fig_lifetime_ratio.png
