murugan-paramesh/SiC-DC-DC-Converter/Advanced_Research_2026/Multiphysics_Models/results/fig_tj_traces.png

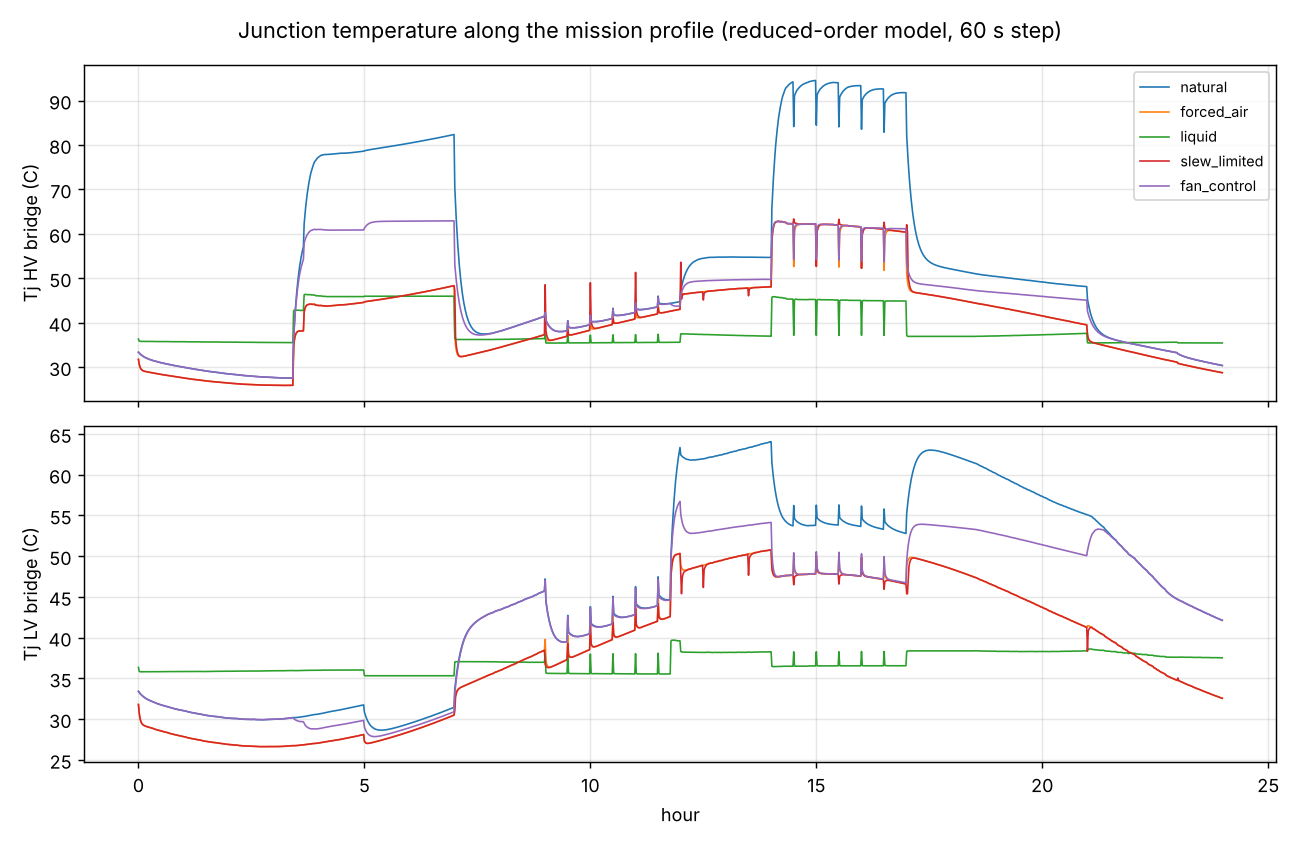
Advanced_Research_2026/Multiphysics_Models/results/fig_tj_traces.png
