murugan-paramesh/SiC-DC-DC-Converter/Advanced_Research_2026/Parasitic_Extraction/results/fig_overshoot.png

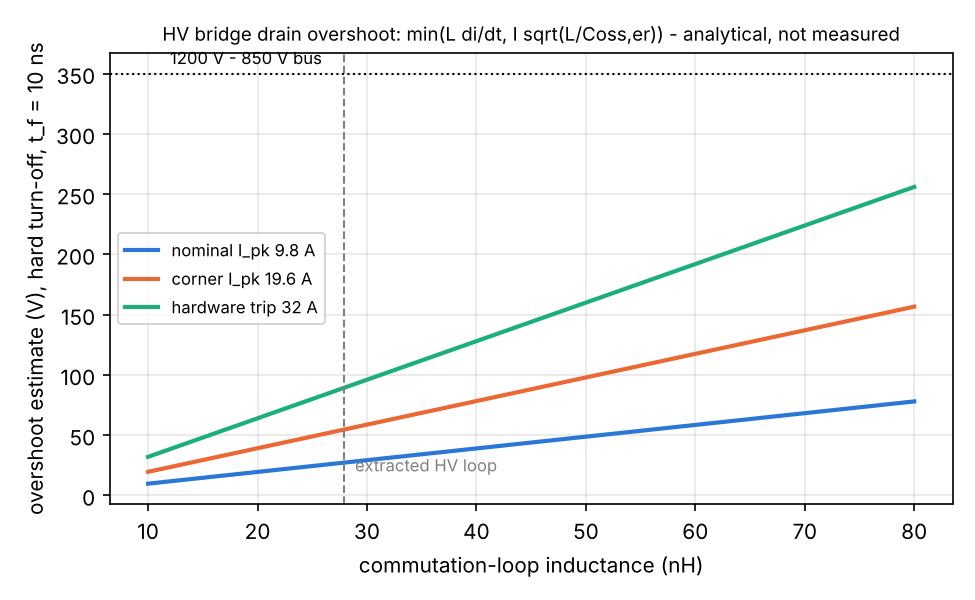
Advanced_Research_2026/Parasitic_Extraction/results/fig_overshoot.png
