murugan-paramesh/SiC-DC-DC-Converter/Advanced_Research_2026/Safe_RL_Research/results/fig_rl_vs_analytical.png

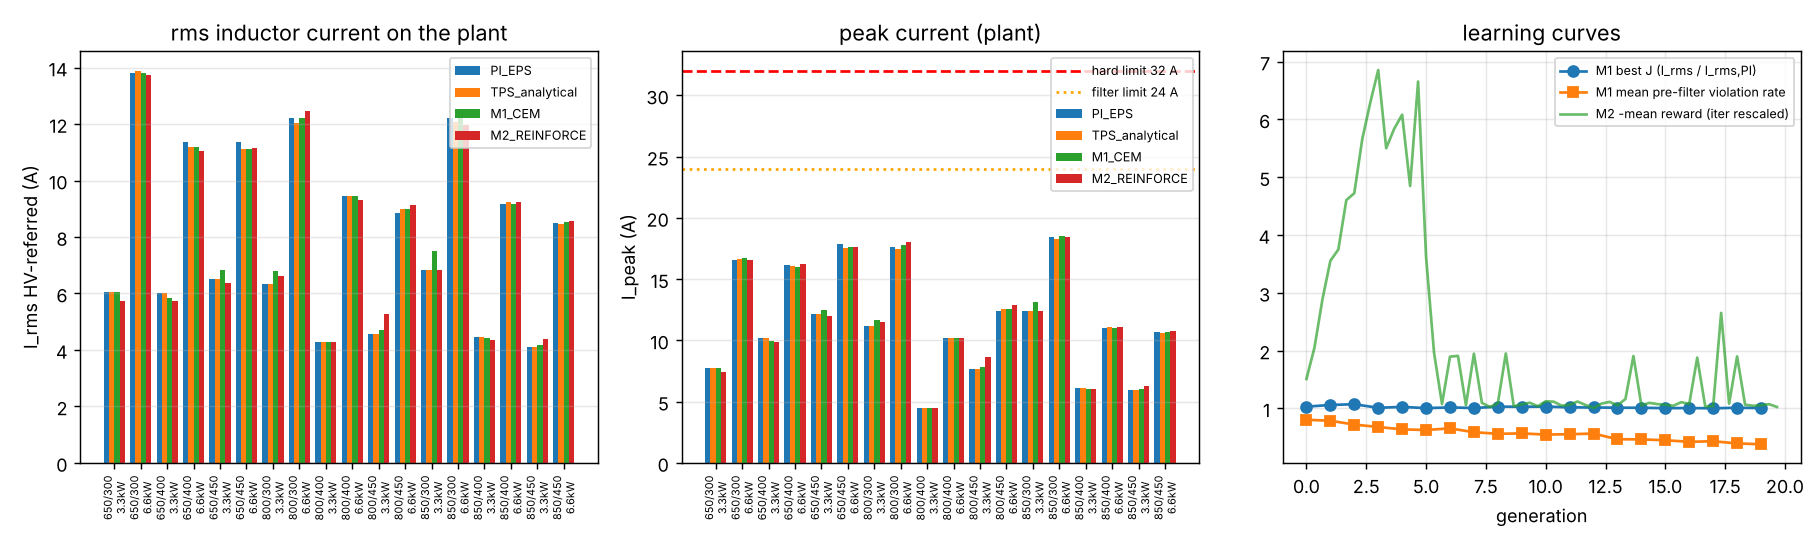
Advanced_Research_2026/Safe_RL_Research/results/fig_rl_vs_analytical.png
