murugan-paramesh/SiC-DC-DC-Converter/Advanced_Research_2026/Safe_RL_Research/results/fig_transient.png

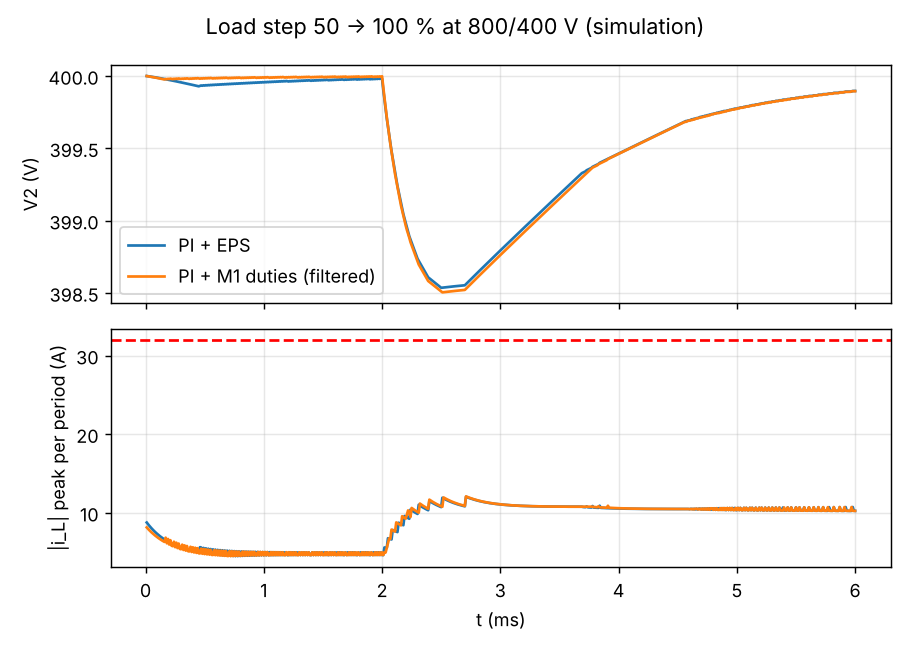
Advanced_Research_2026/Safe_RL_Research/results/fig_transient.png
