murugan-paramesh/SiC-DC-DC-Converter/Advanced_Research_2026/SiC_Health_Monitoring/results/fig_detection_vs_false_alarm.png

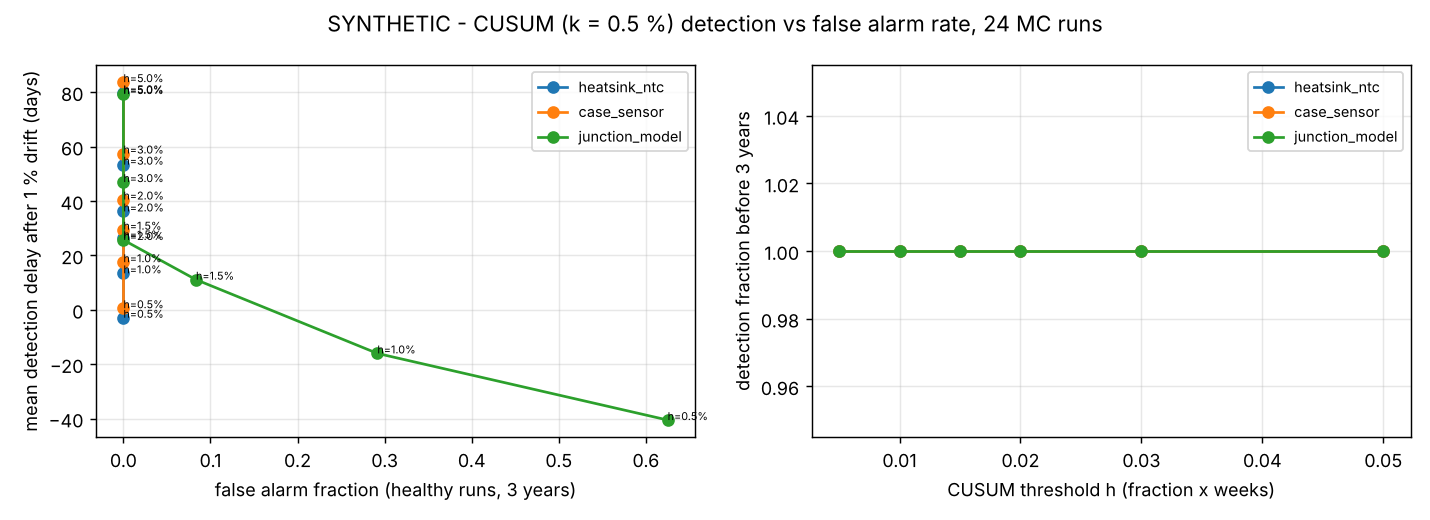
Advanced_Research_2026/SiC_Health_Monitoring/results/fig_detection_vs_false_alarm.png
