murugan-paramesh/SiC-DC-DC-Converter/Advanced_Research_2026/SiC_Health_Monitoring/results/fig_estimators_demo.png

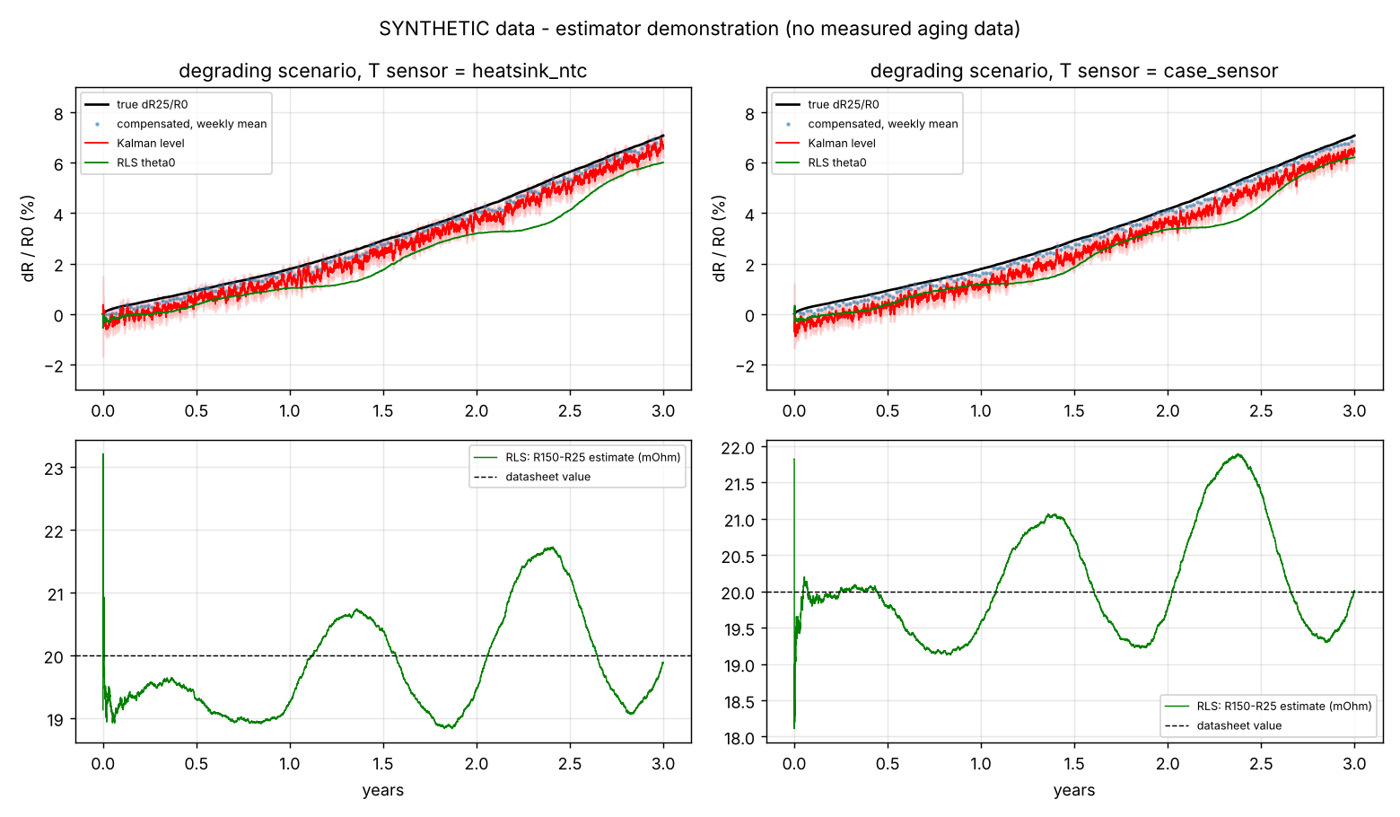
Advanced_Research_2026/SiC_Health_Monitoring/results/fig_estimators_demo.png
