murugan-paramesh/SiC-DC-DC-Converter/hardware/outputs/SiC_PSFB_3kW-schematic.pdf

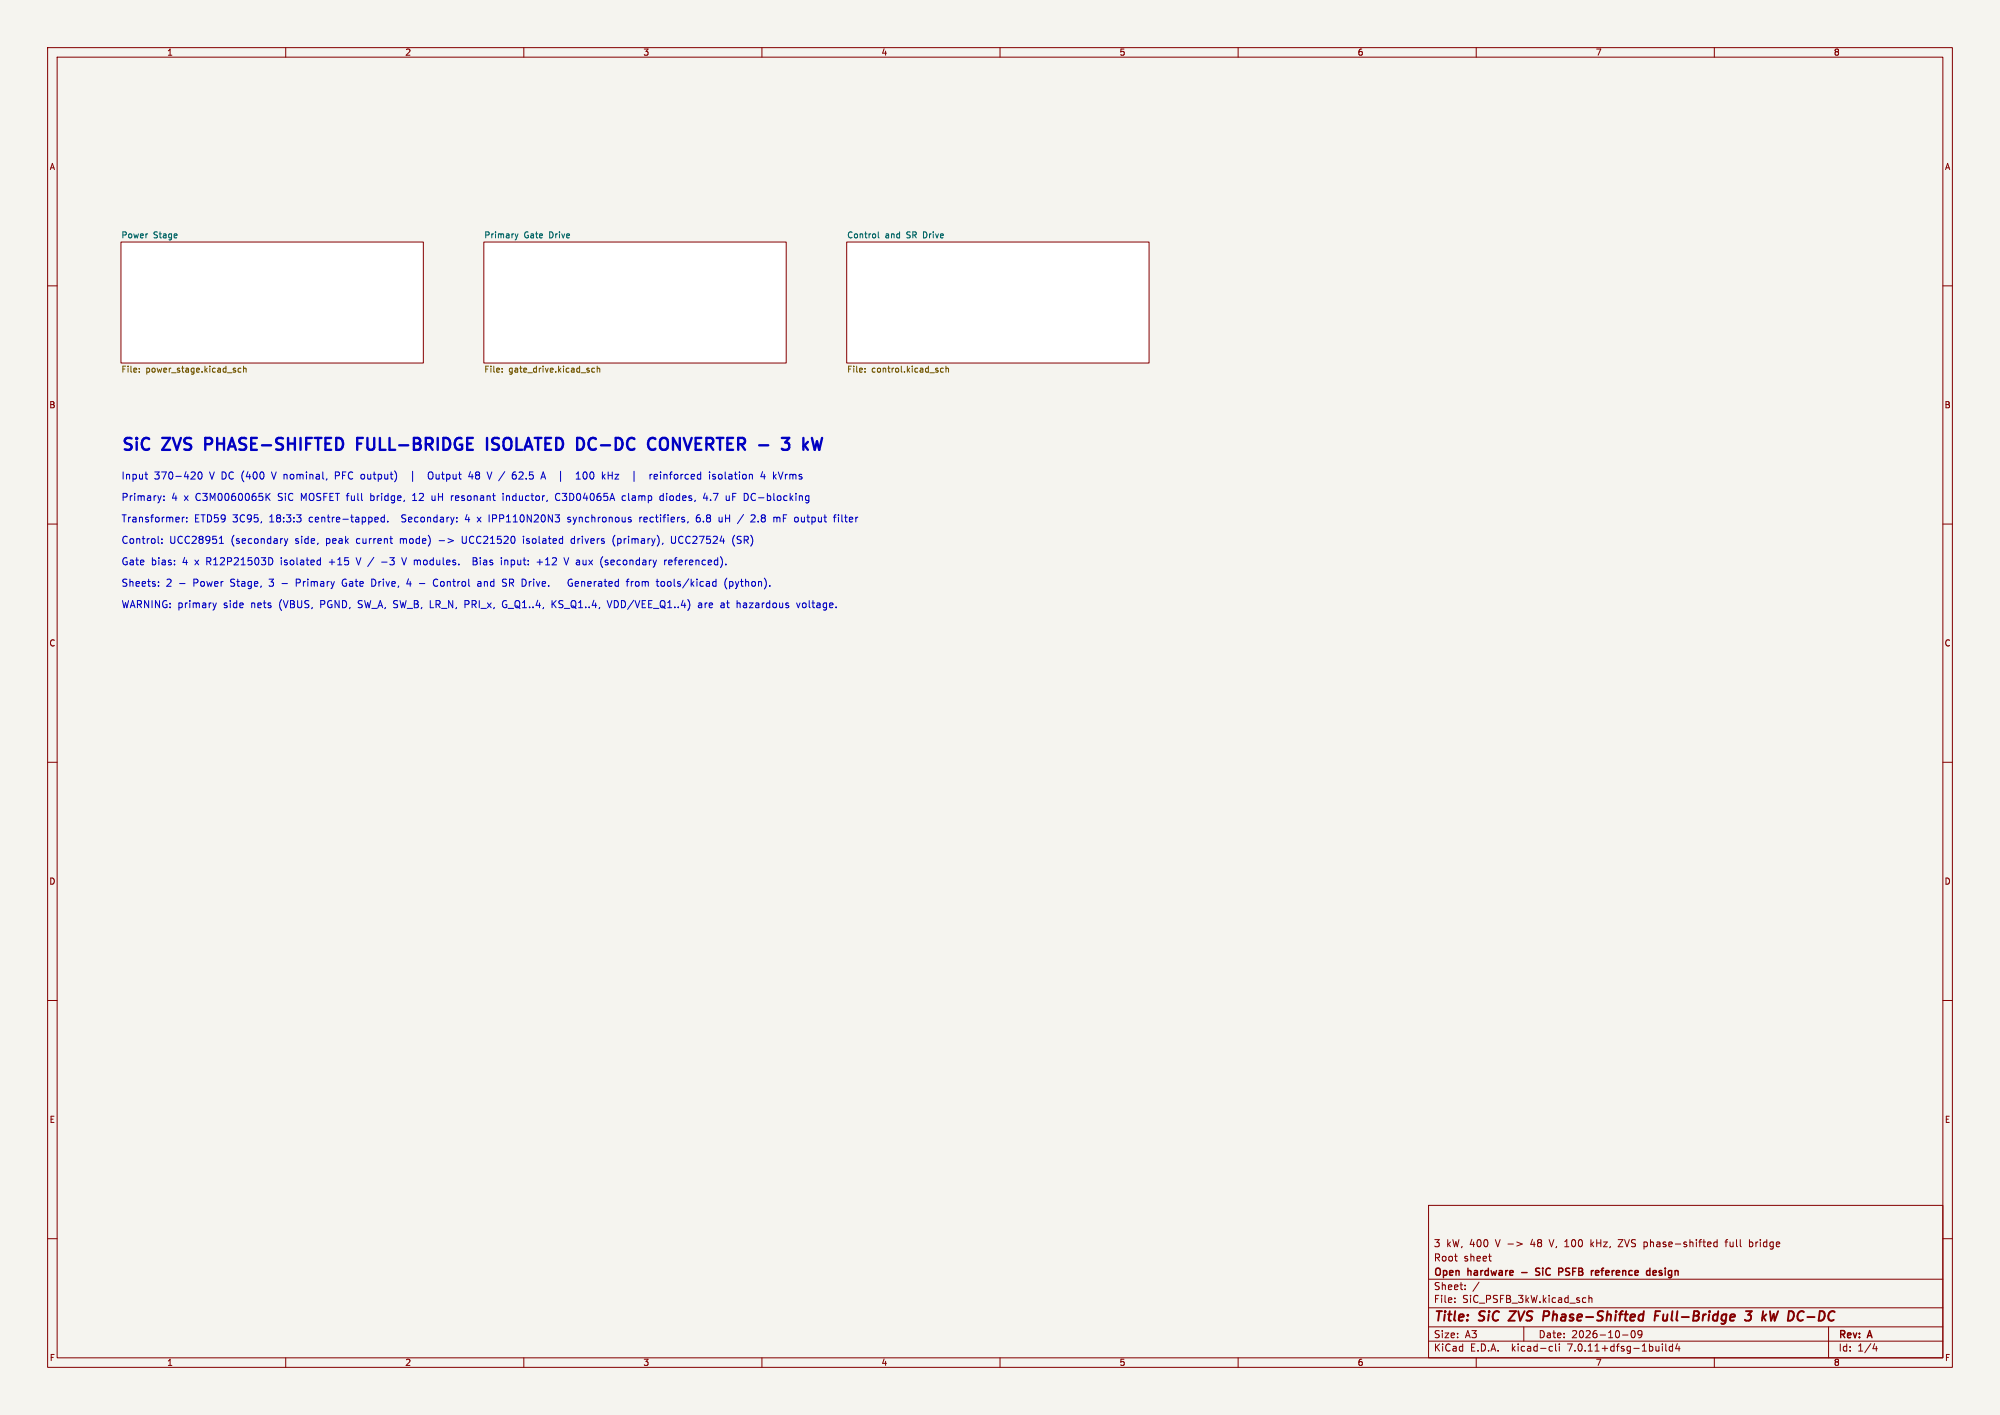
[picture p126: page 1]

SiC ZVS PHASE-SHIFTED FULL-BRIDGE ISOLATED DC-DC CONVERTER - 3 kW

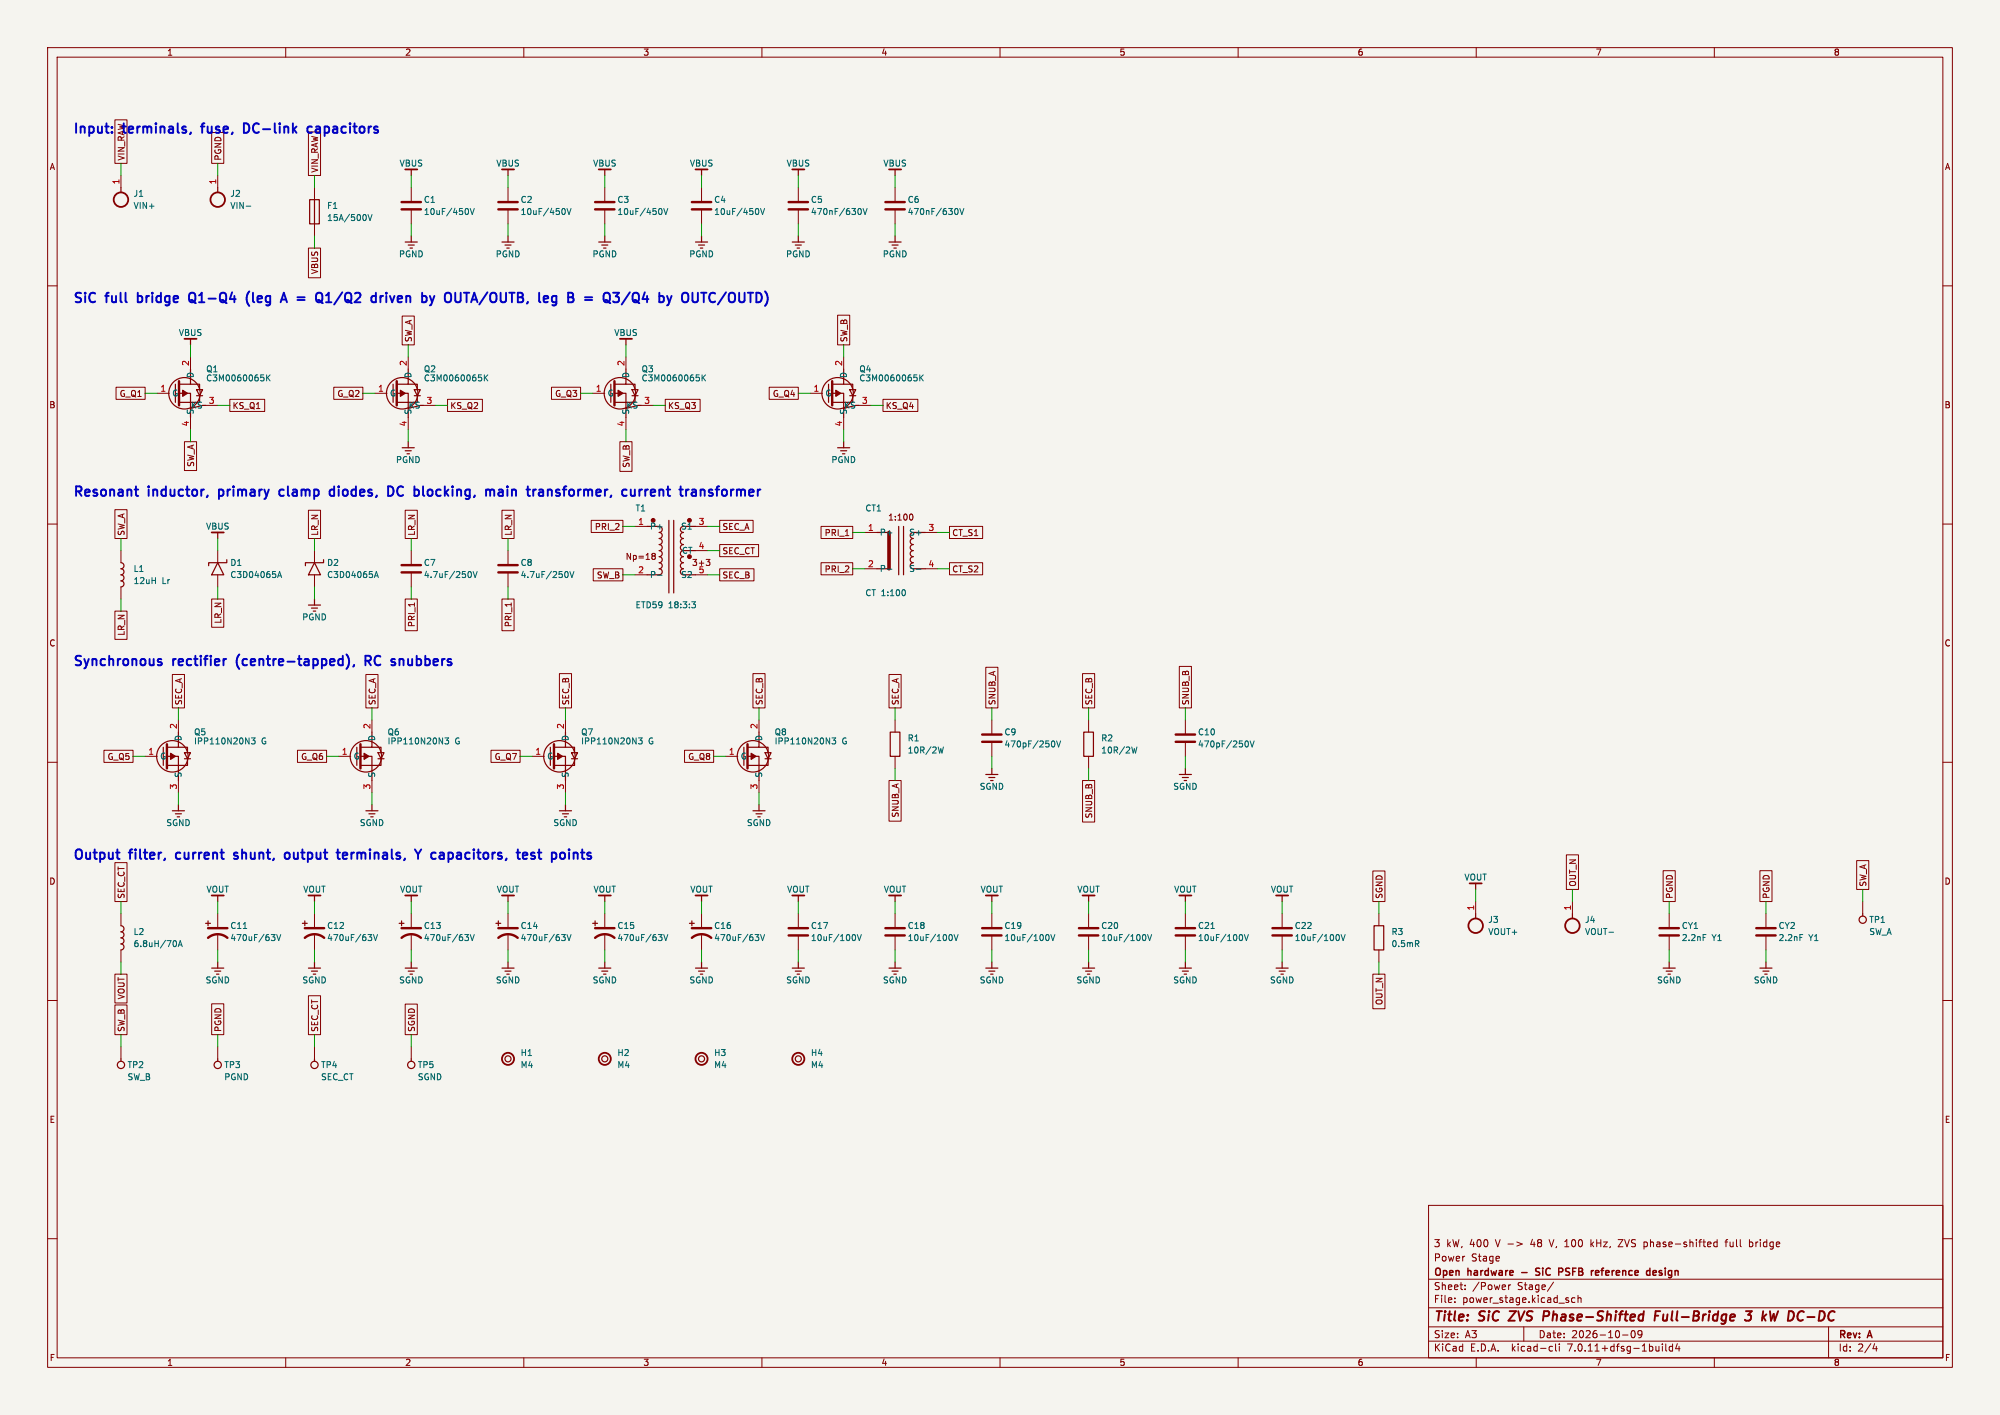
[picture p127: page 2]

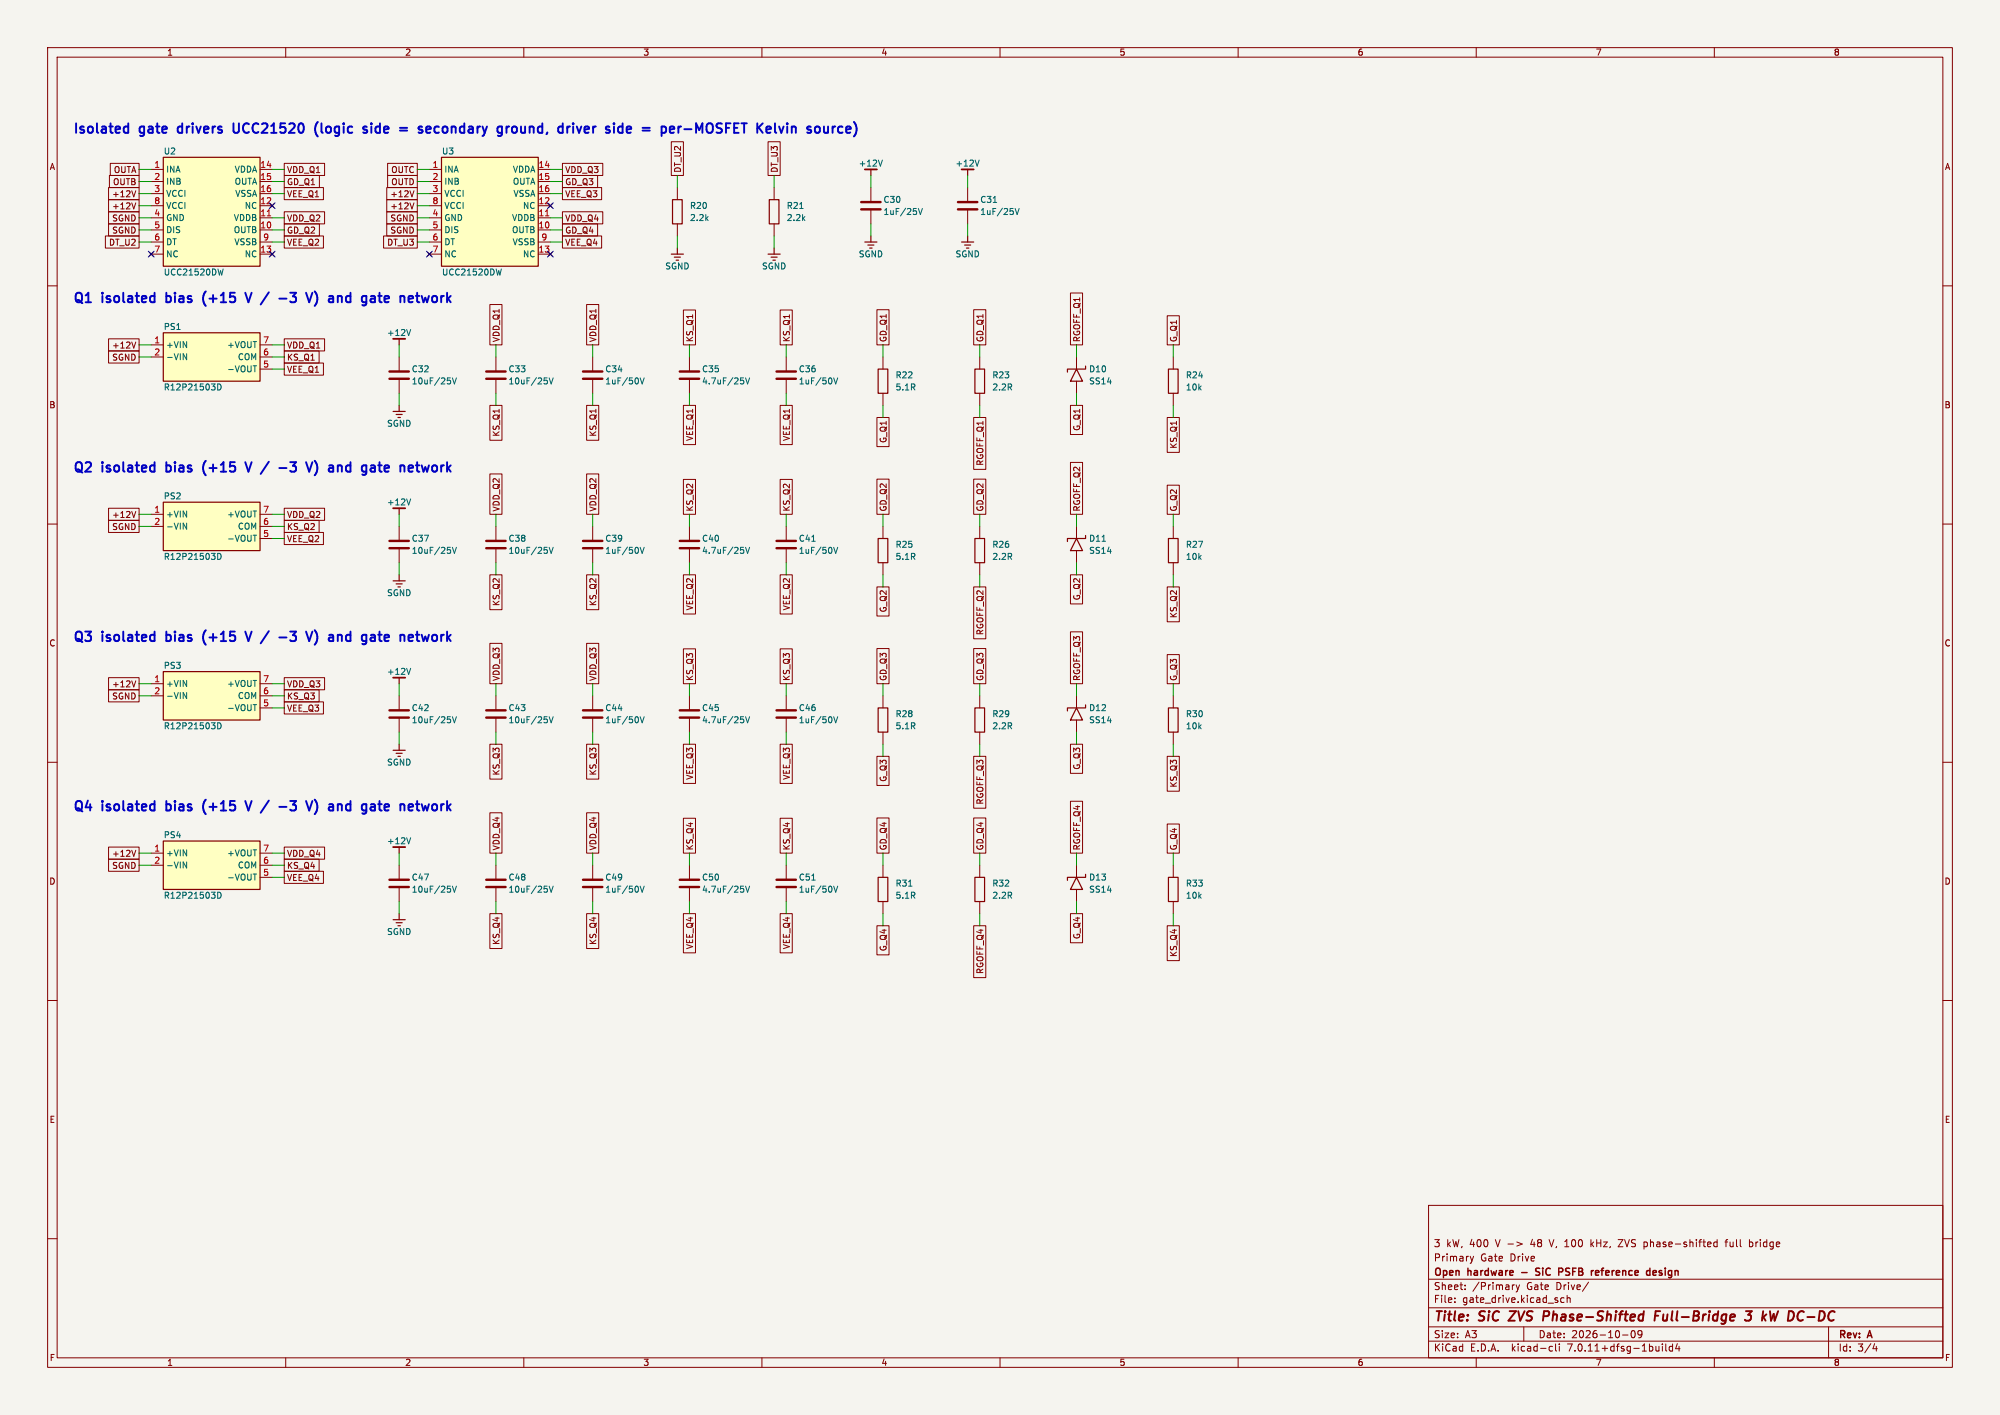
[picture p128: page 3]

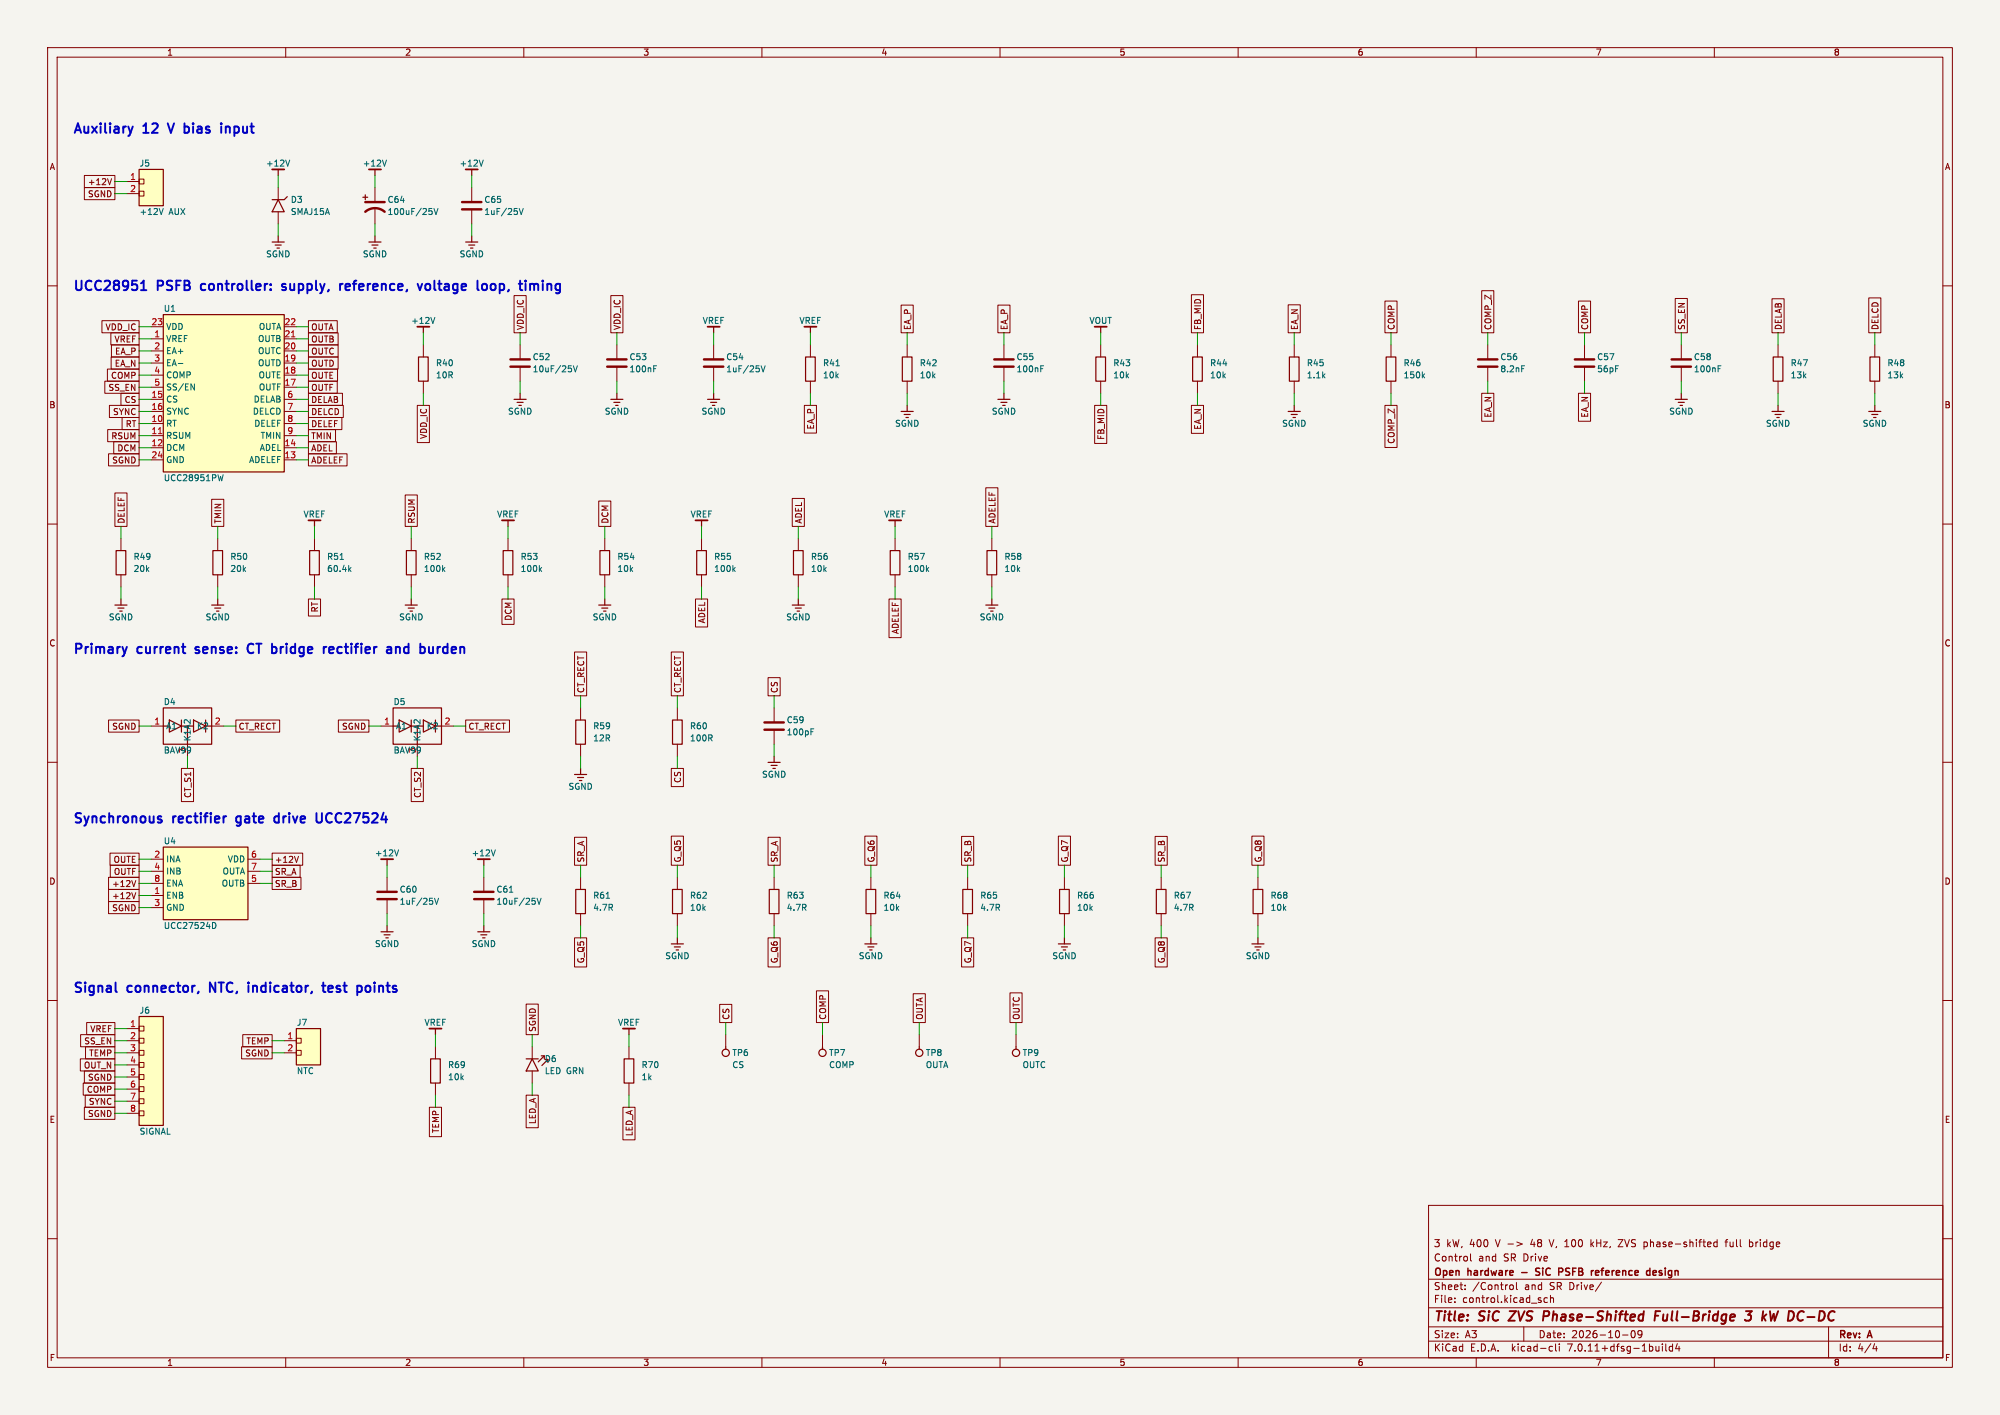
[picture p129: page 4]

DELEF OUTE OUTD OUTF DELAB OUTC OUTB OUTA DELCD

Primary current sense: CT bridge rectifier and burden

Synchronous rectifier gate drive UCC27524
INA 2 GND 3
