murugan-paramesh/SiC-DC-DC-Converter/SiC_6k6_Industrial_DAB/17_Manufacturing/outputs/SiC_DAB_6k6-dimensions.pdf

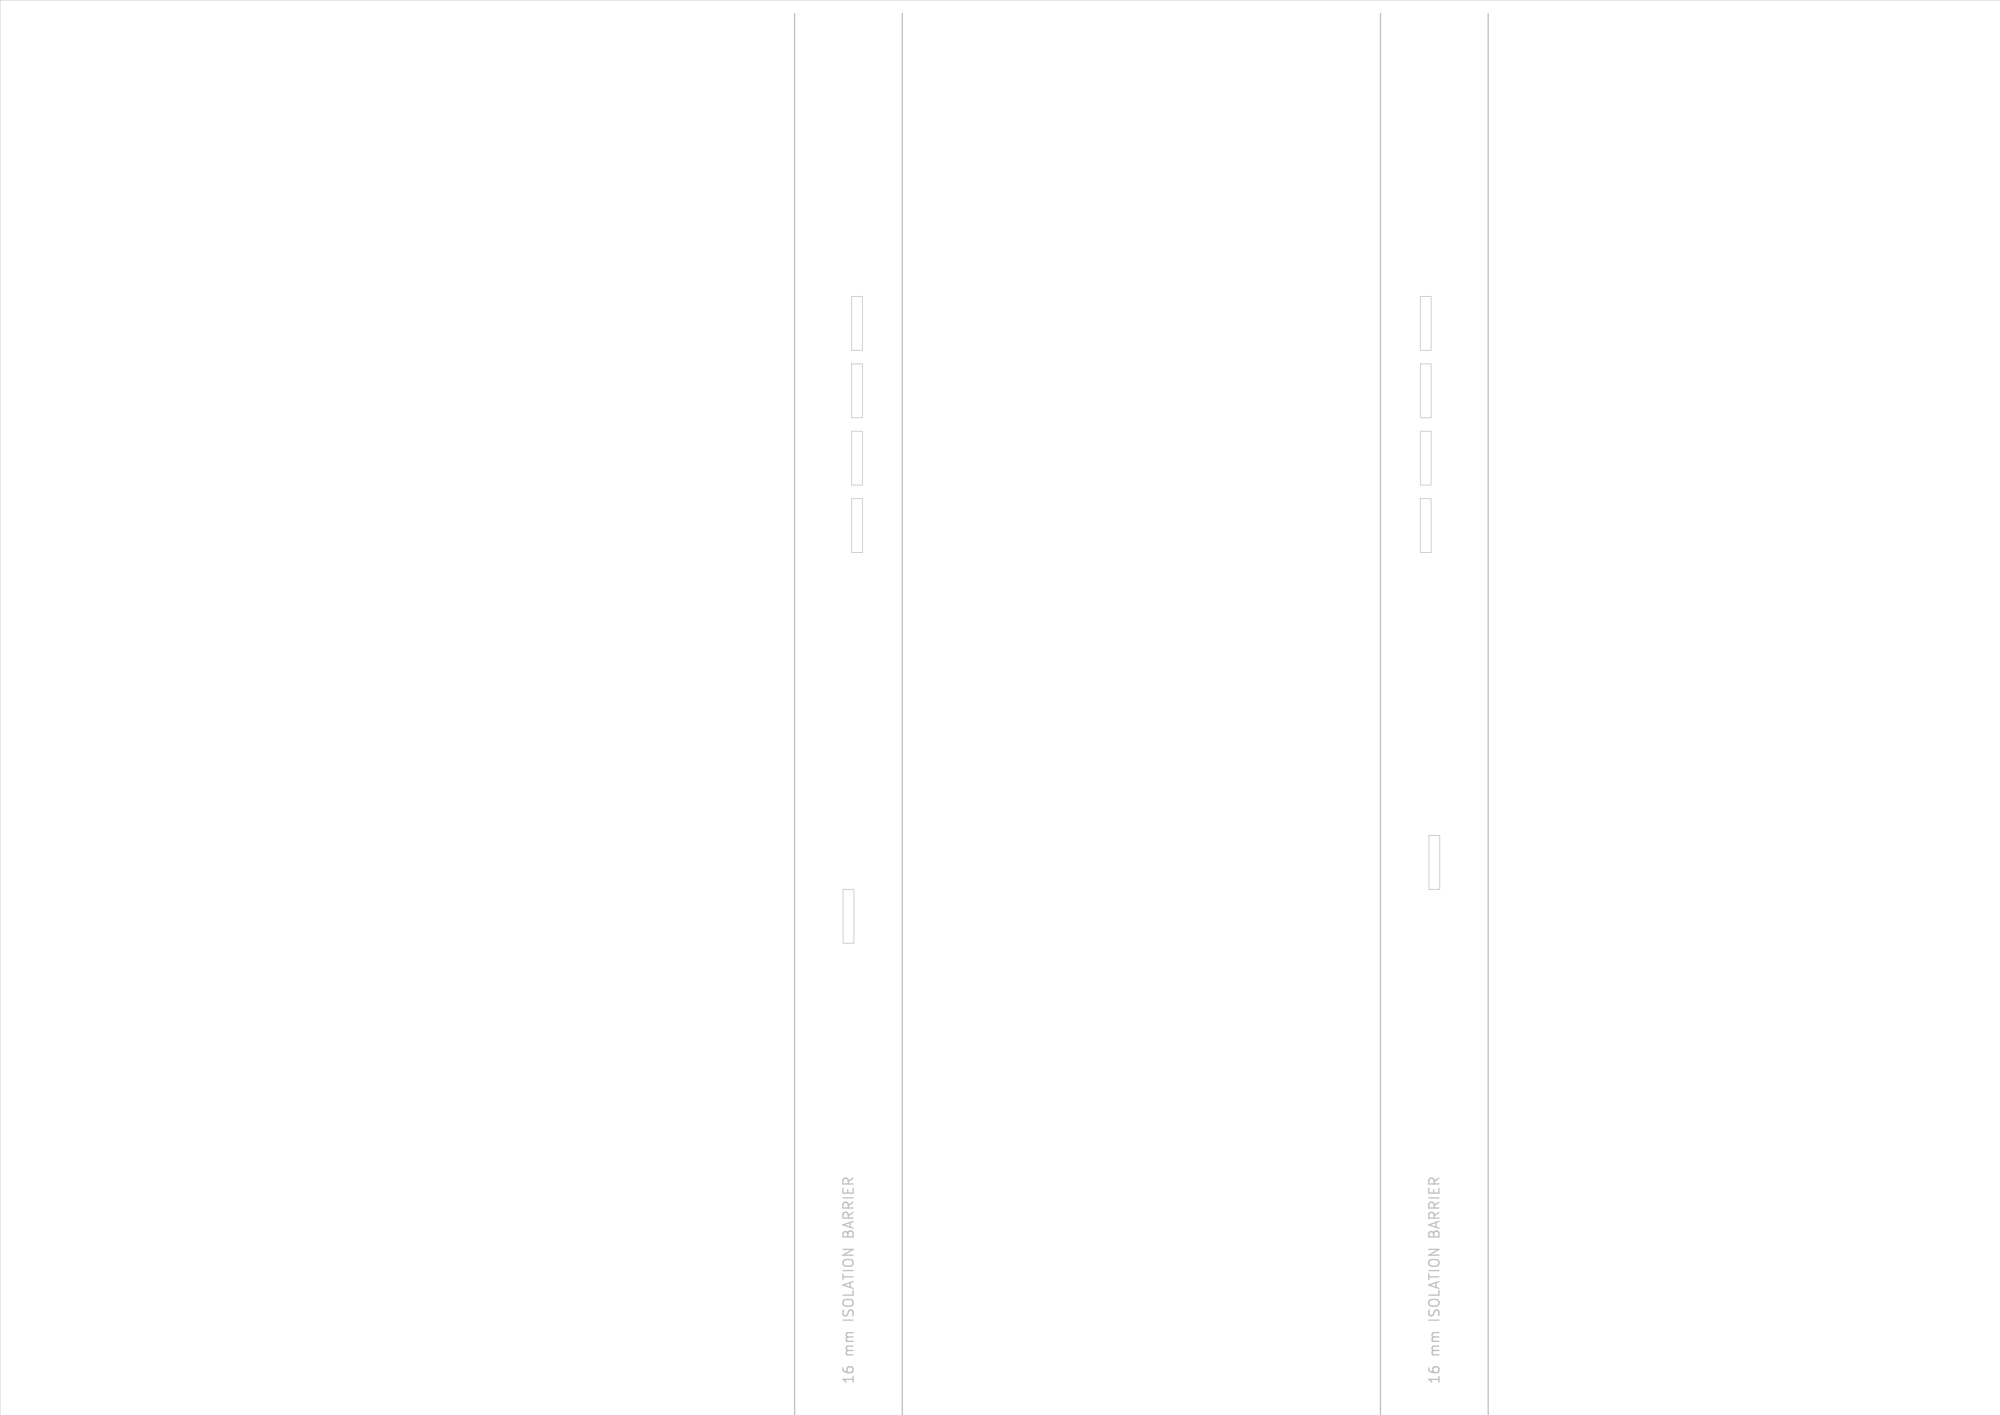
[picture p130: page 1]

16 mm ISOLATION BARRIER
