murugan-paramesh/SiC-DC-DC-Converter/SiC_6k6_Industrial_DAB/17_Manufacturing/outputs/SiC_DAB_6k6-schematic.pdf

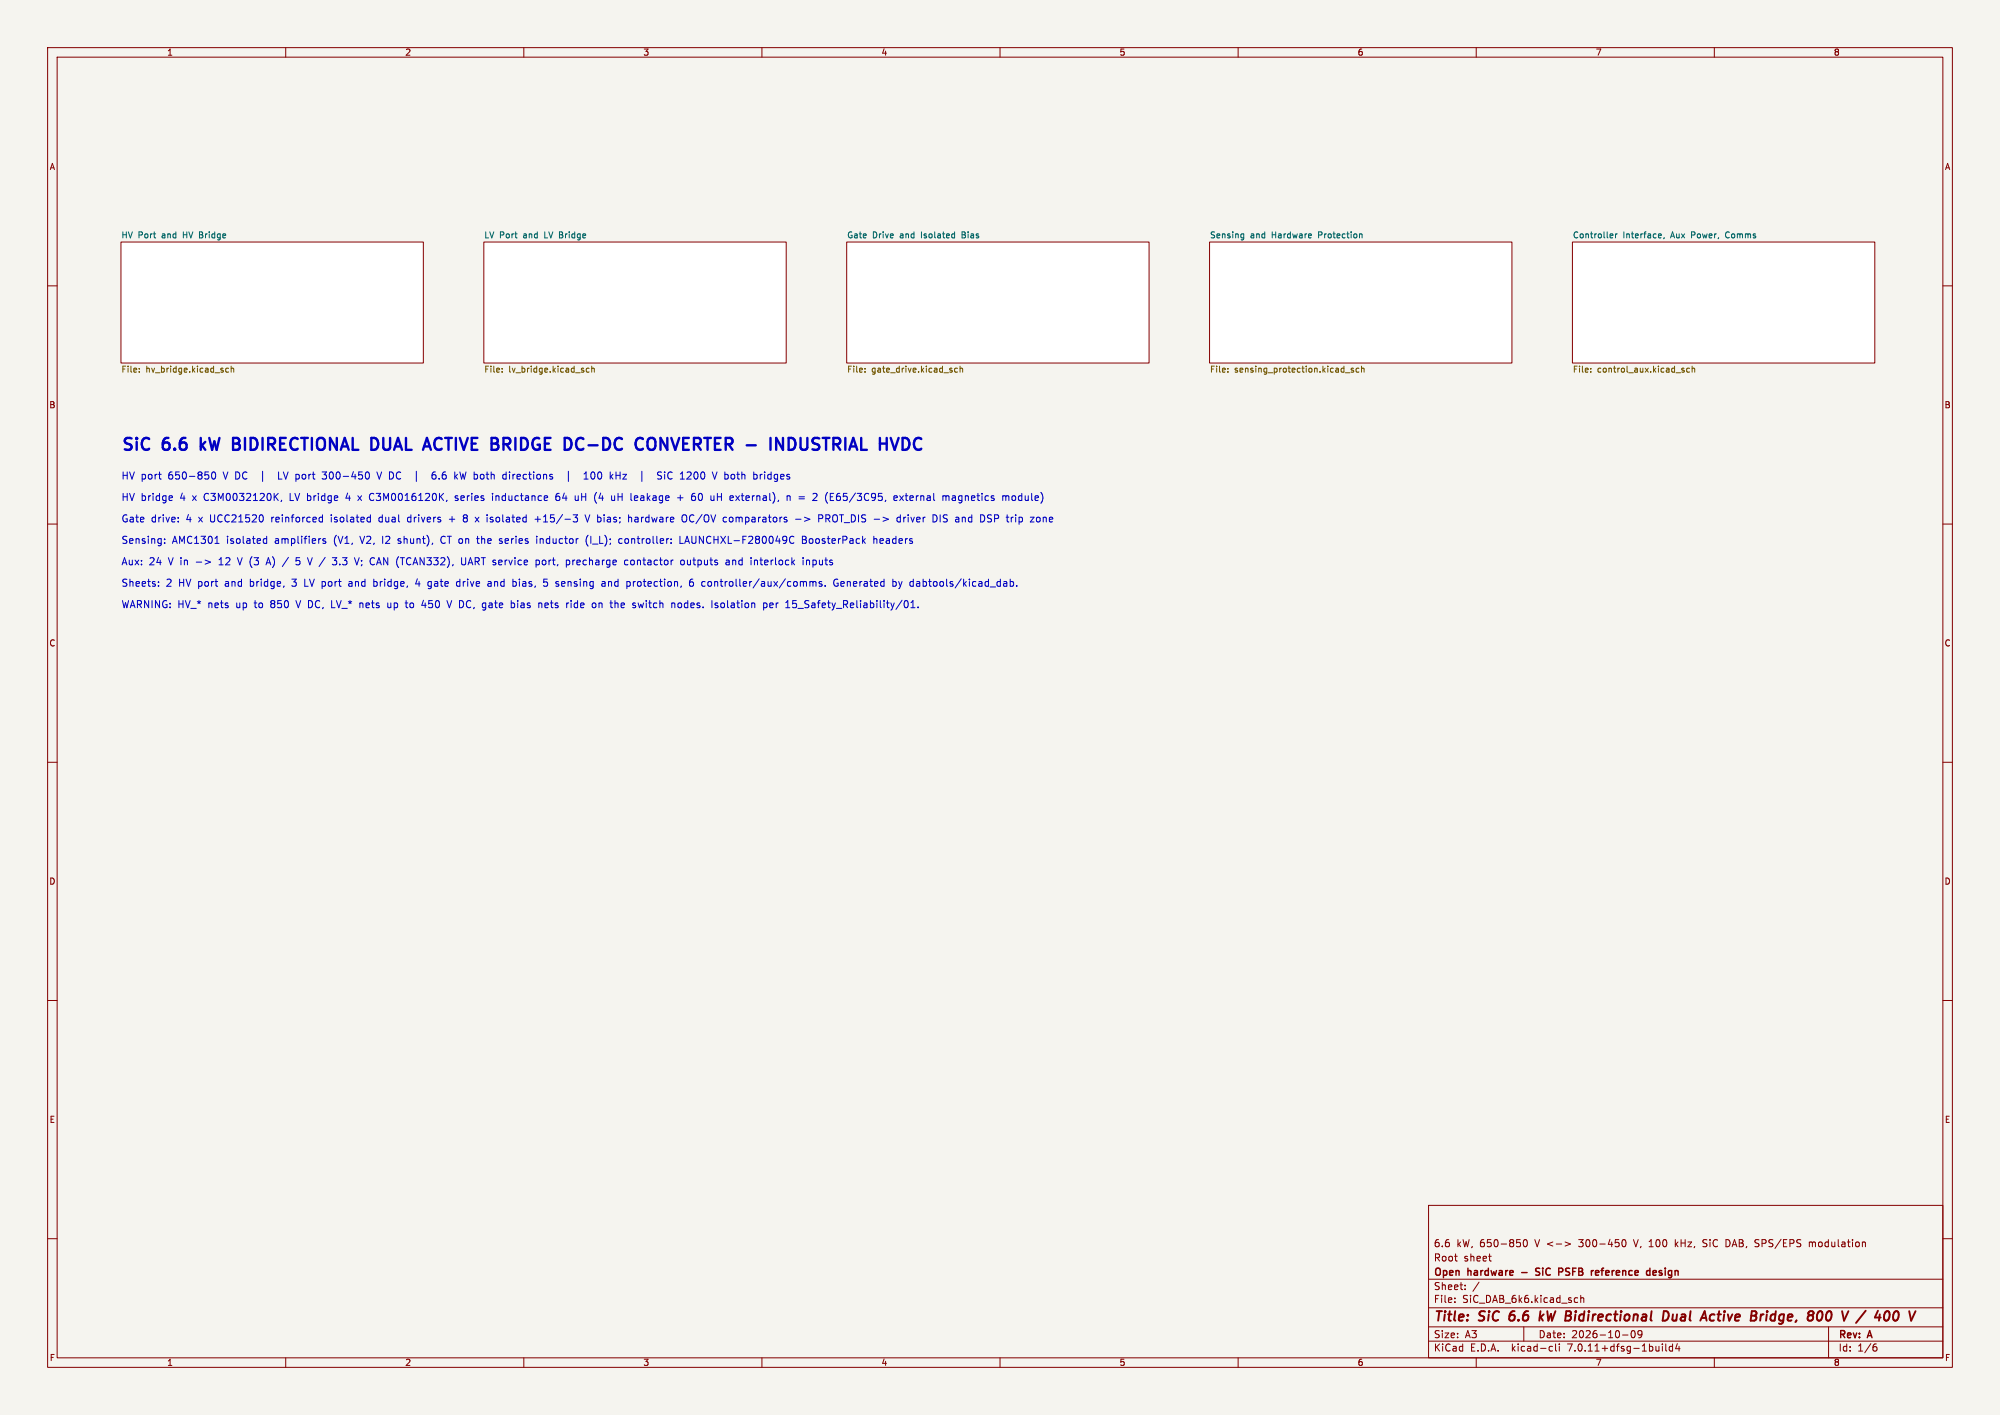
[picture p131: page 1]

HV Port and HV Bridge File: hv_bridge.kicad_sch

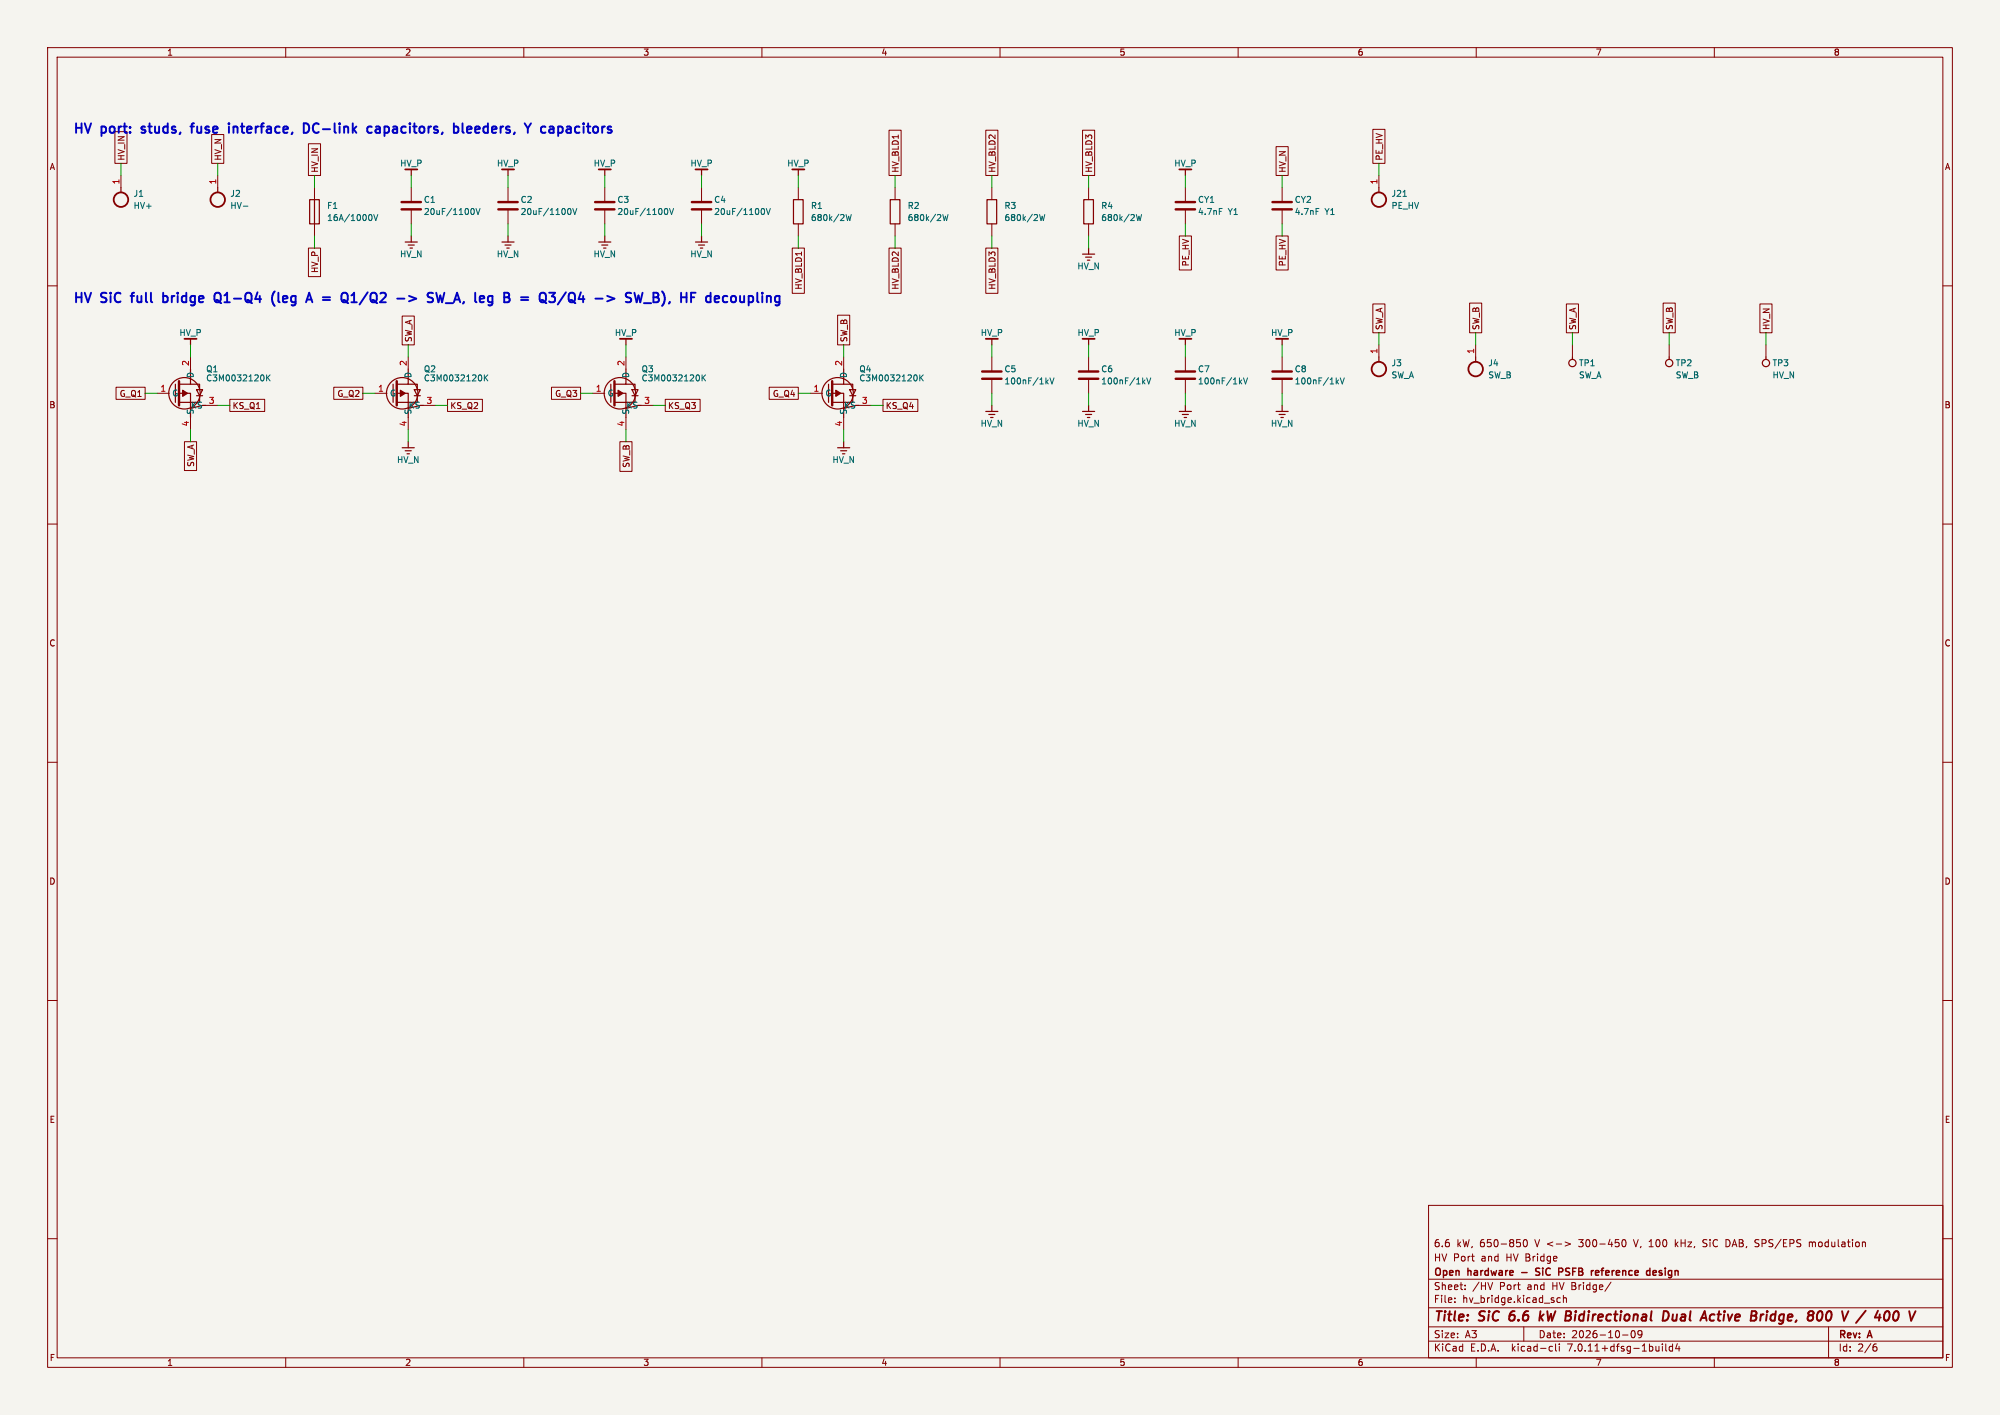
[picture p132: page 2]

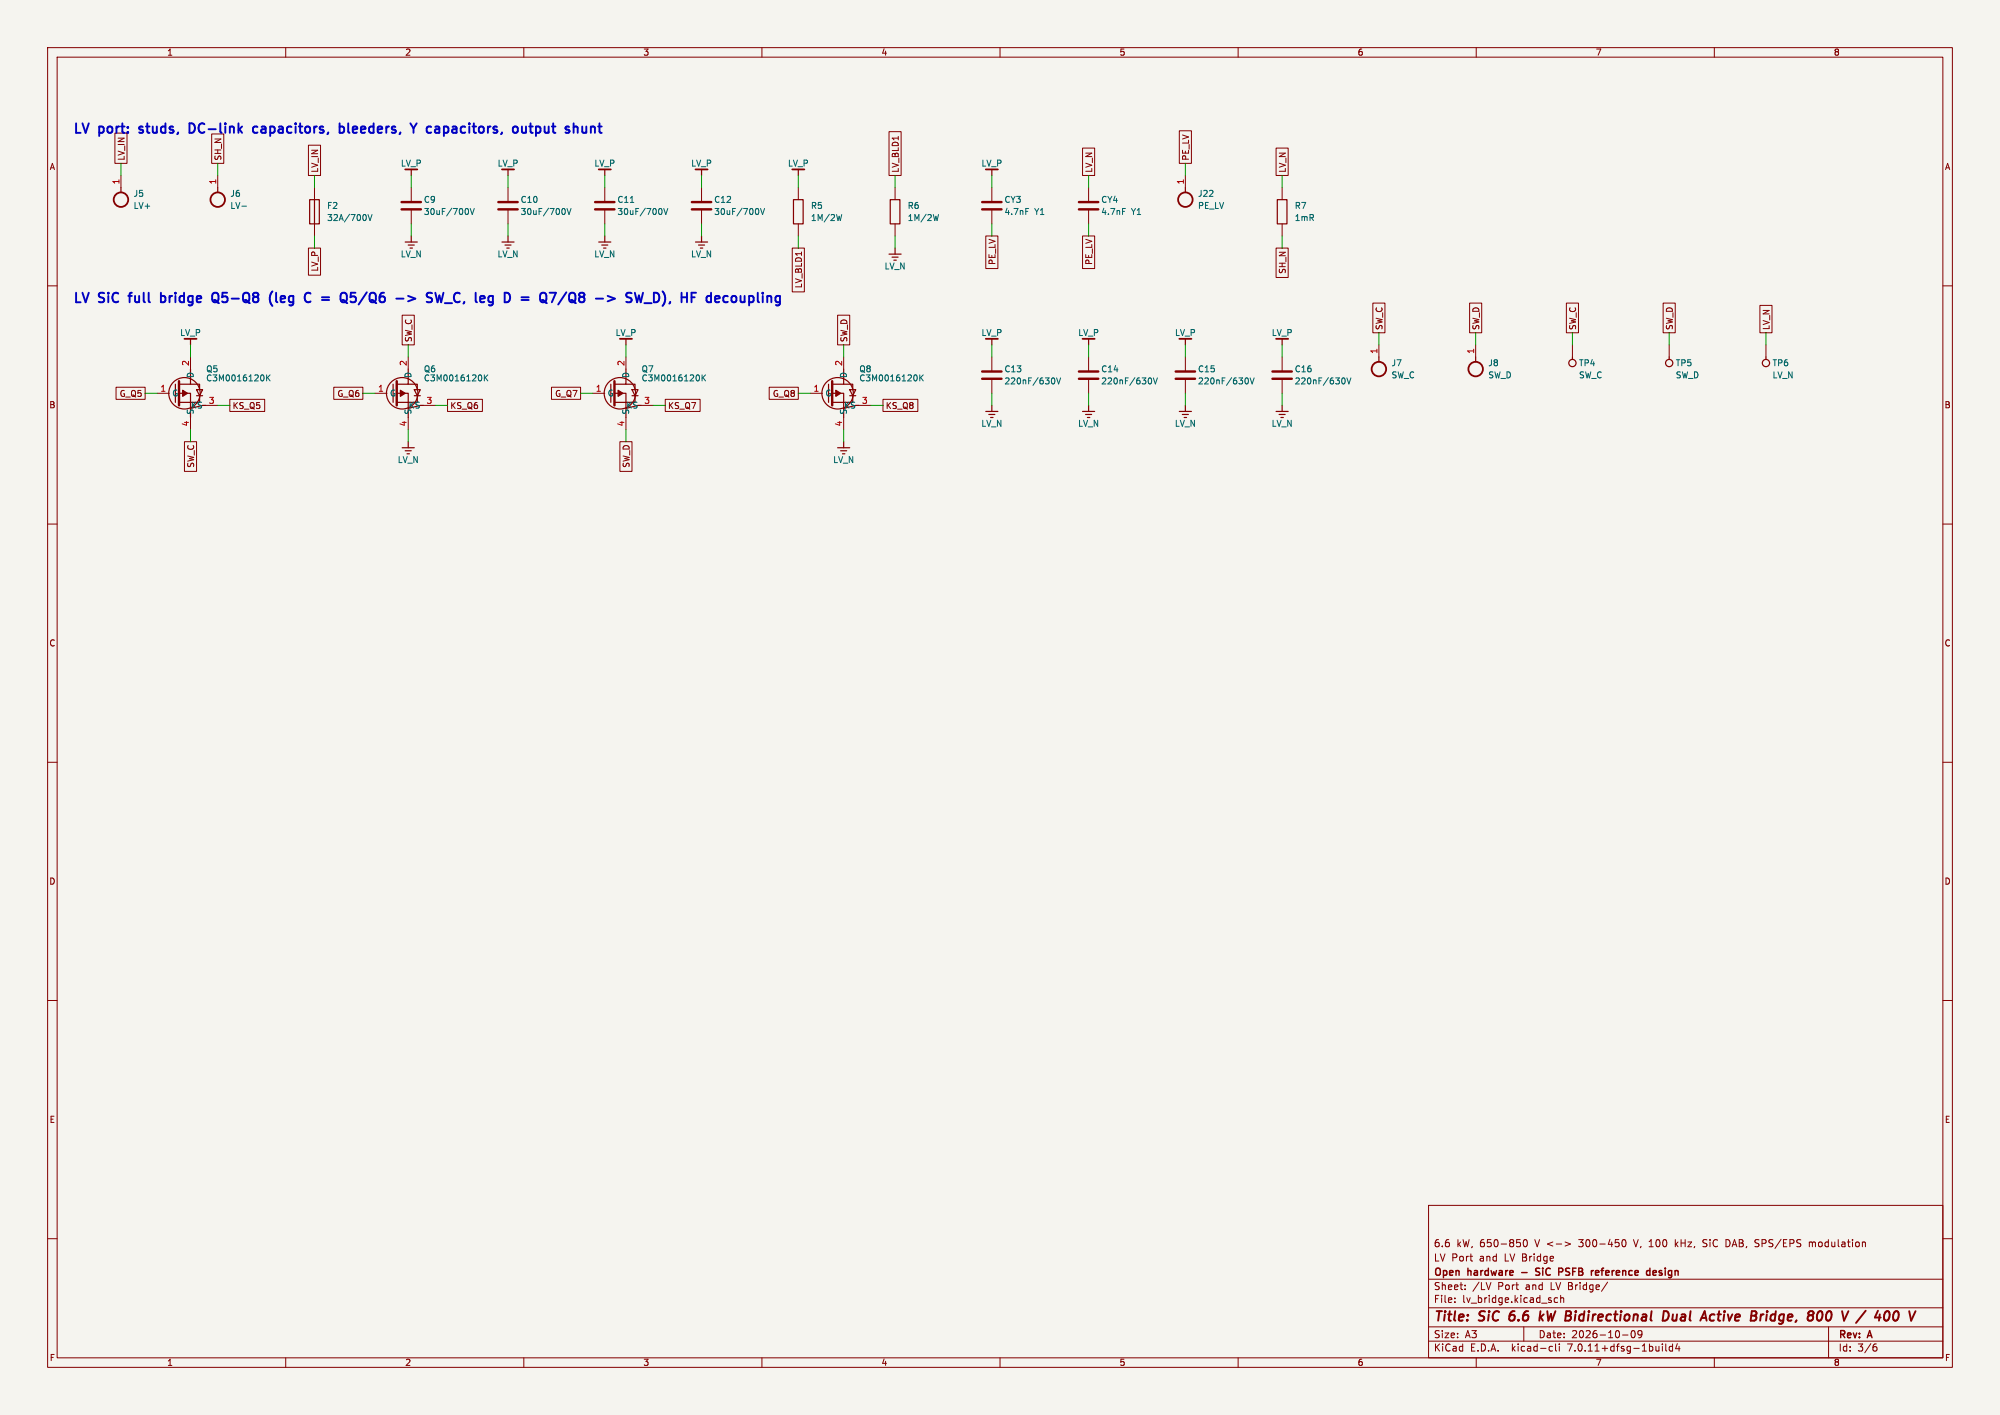
[picture p133: page 3]

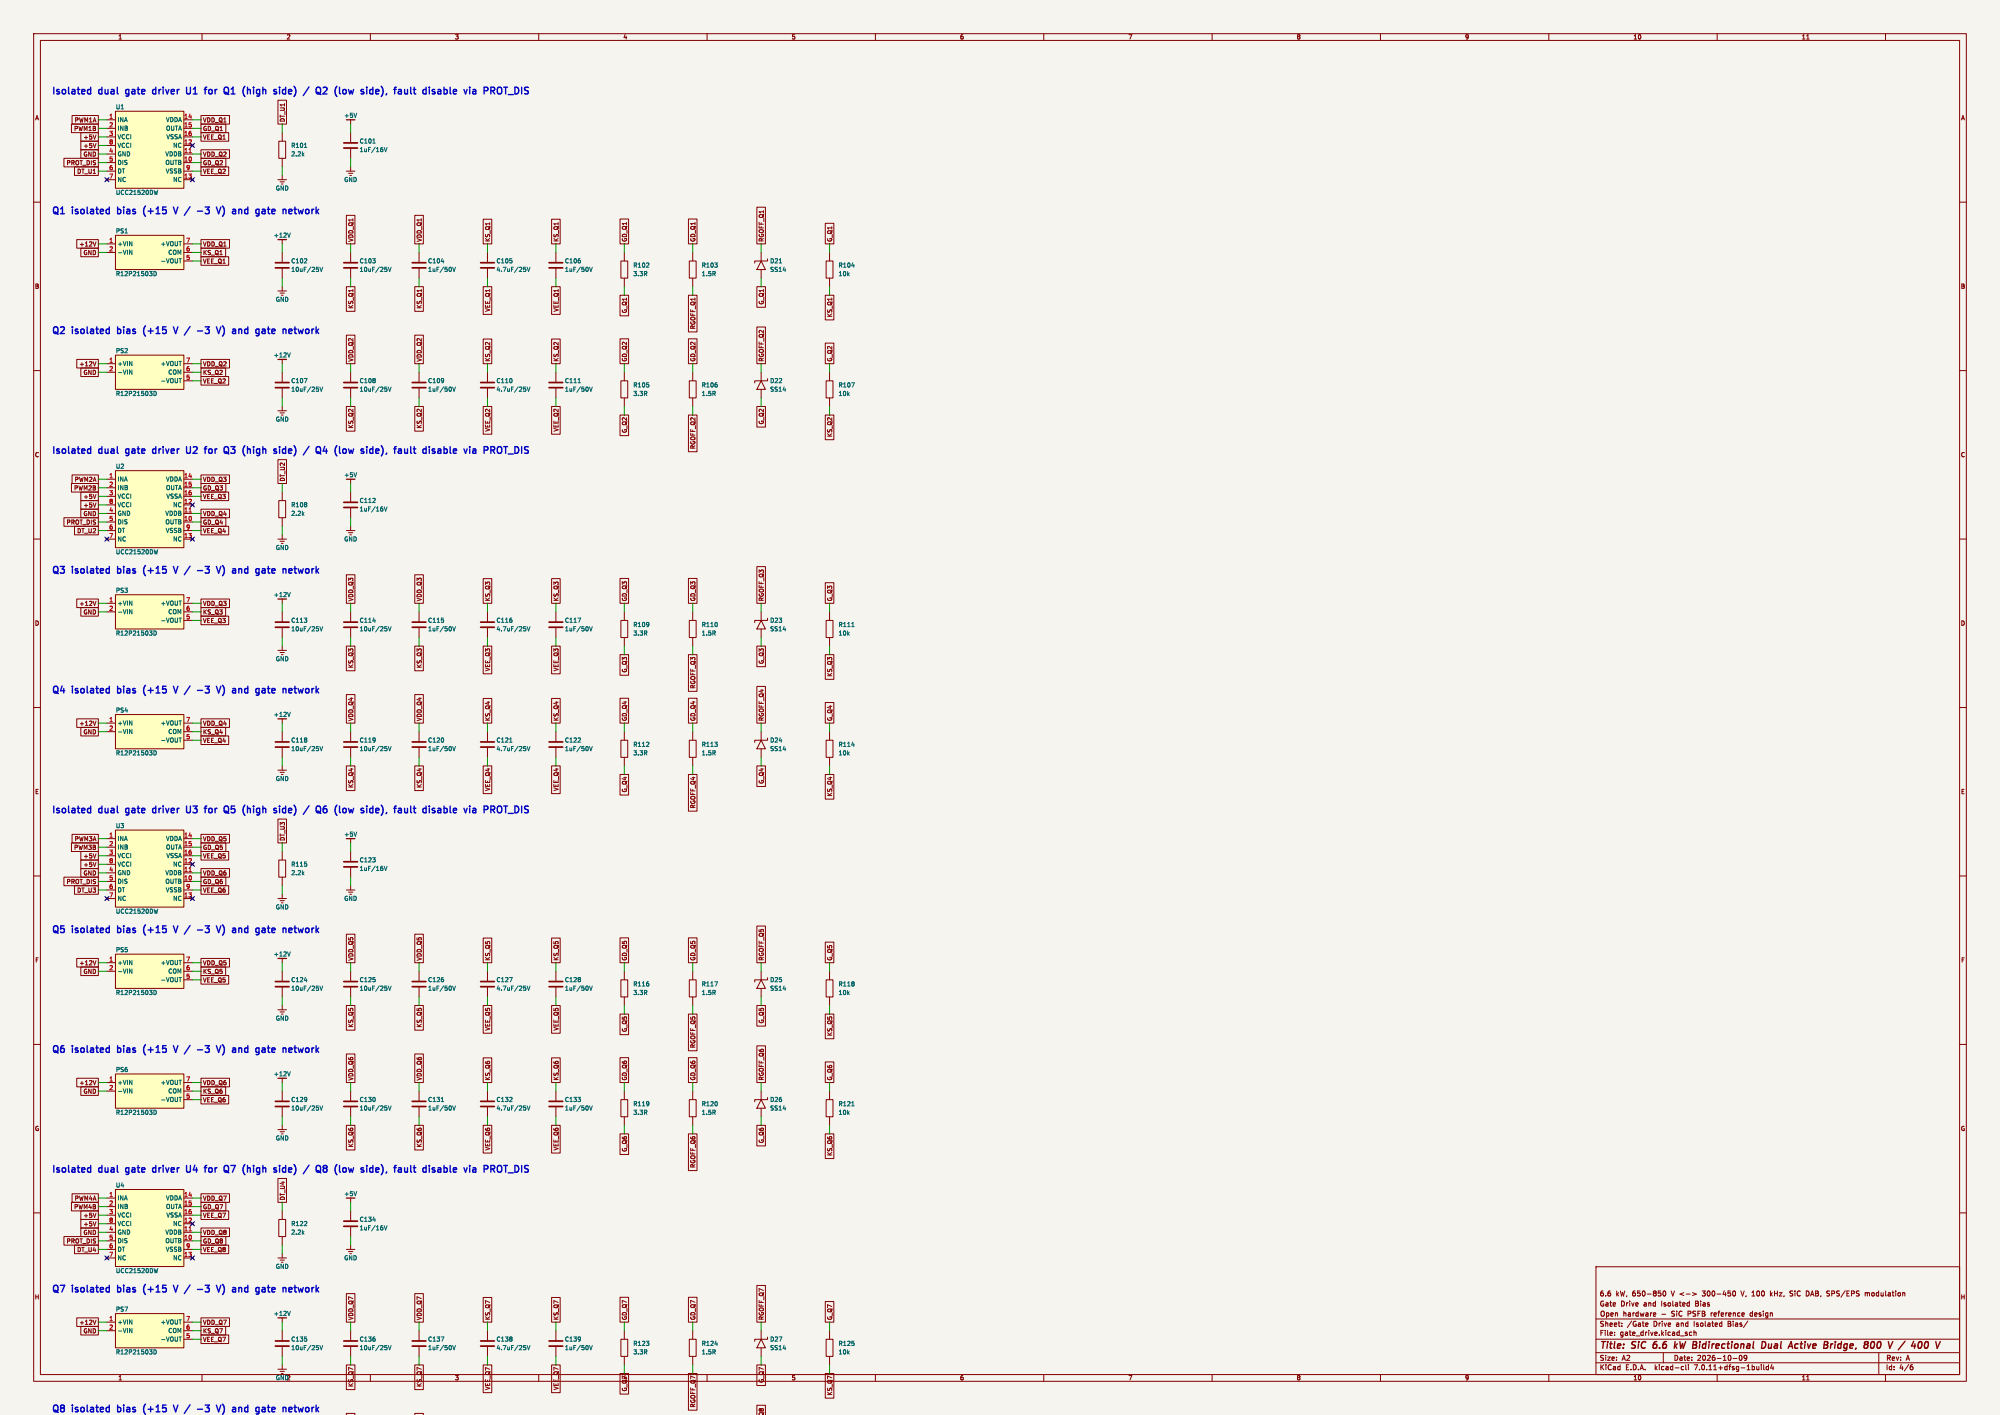
[picture p134: page 4]

Isolated dual gate driver U1 for Q1 (high side) / Q2 (low side), fault disable via PROT_DIS

Isolated dual gate driver U2 for Q3 (high side) / Q4 (low side), fault disable via PROT_DIS

Isolated dual gate driver U3 for Q5 (high side) / Q6 (low side), fault disable via PROT_DIS

Isolated dual gate driver U4 for Q7 (high side) / Q8 (low side), fault disable via PROT_DIS

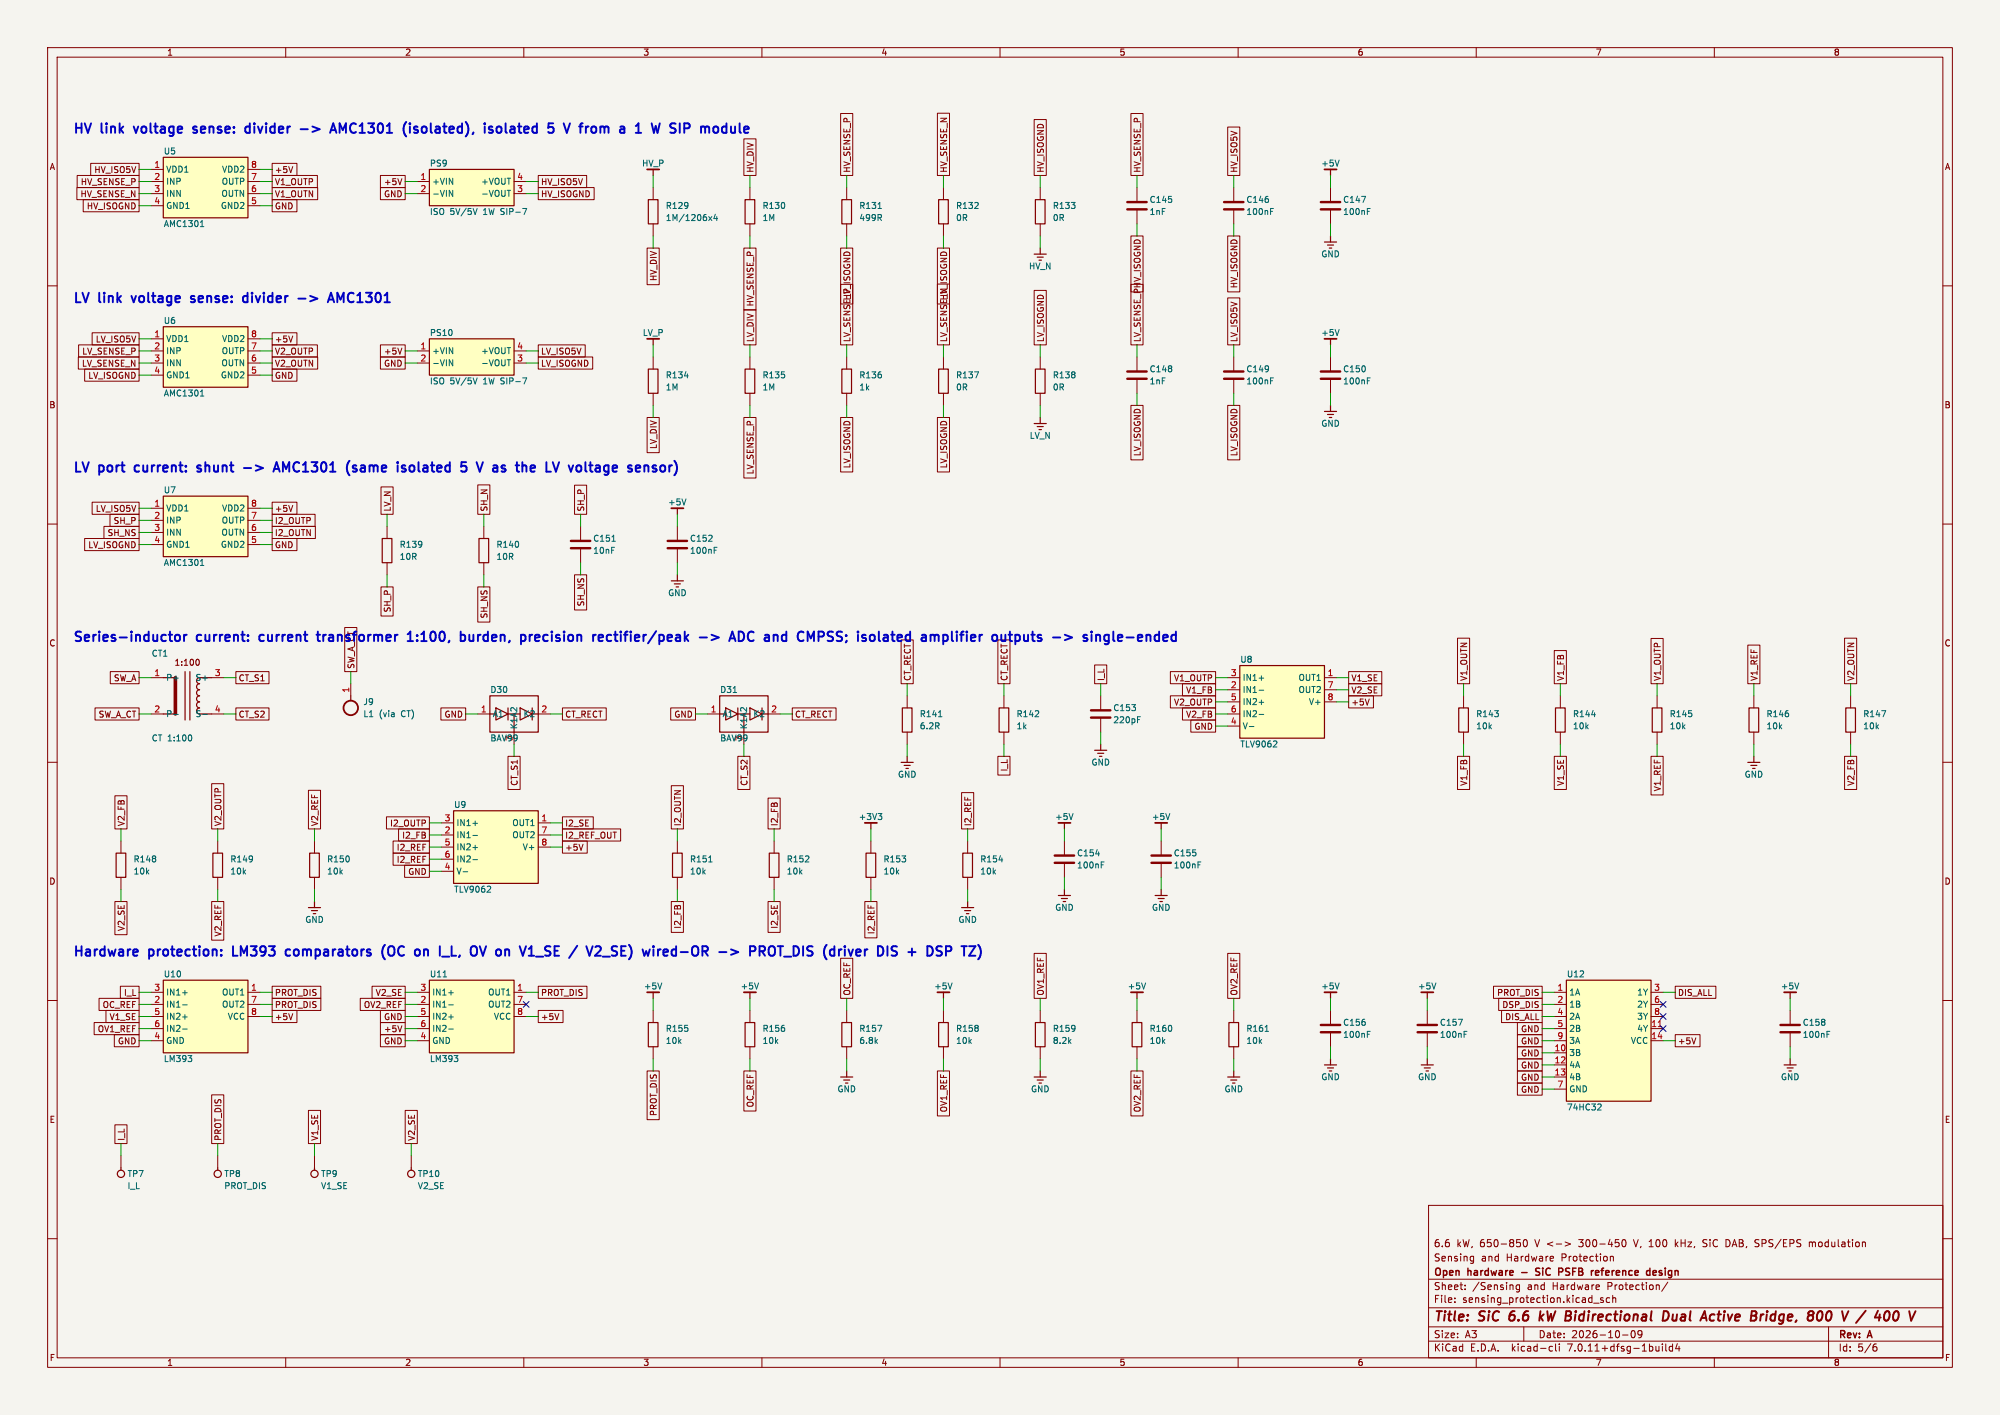
[picture p135: page 5]

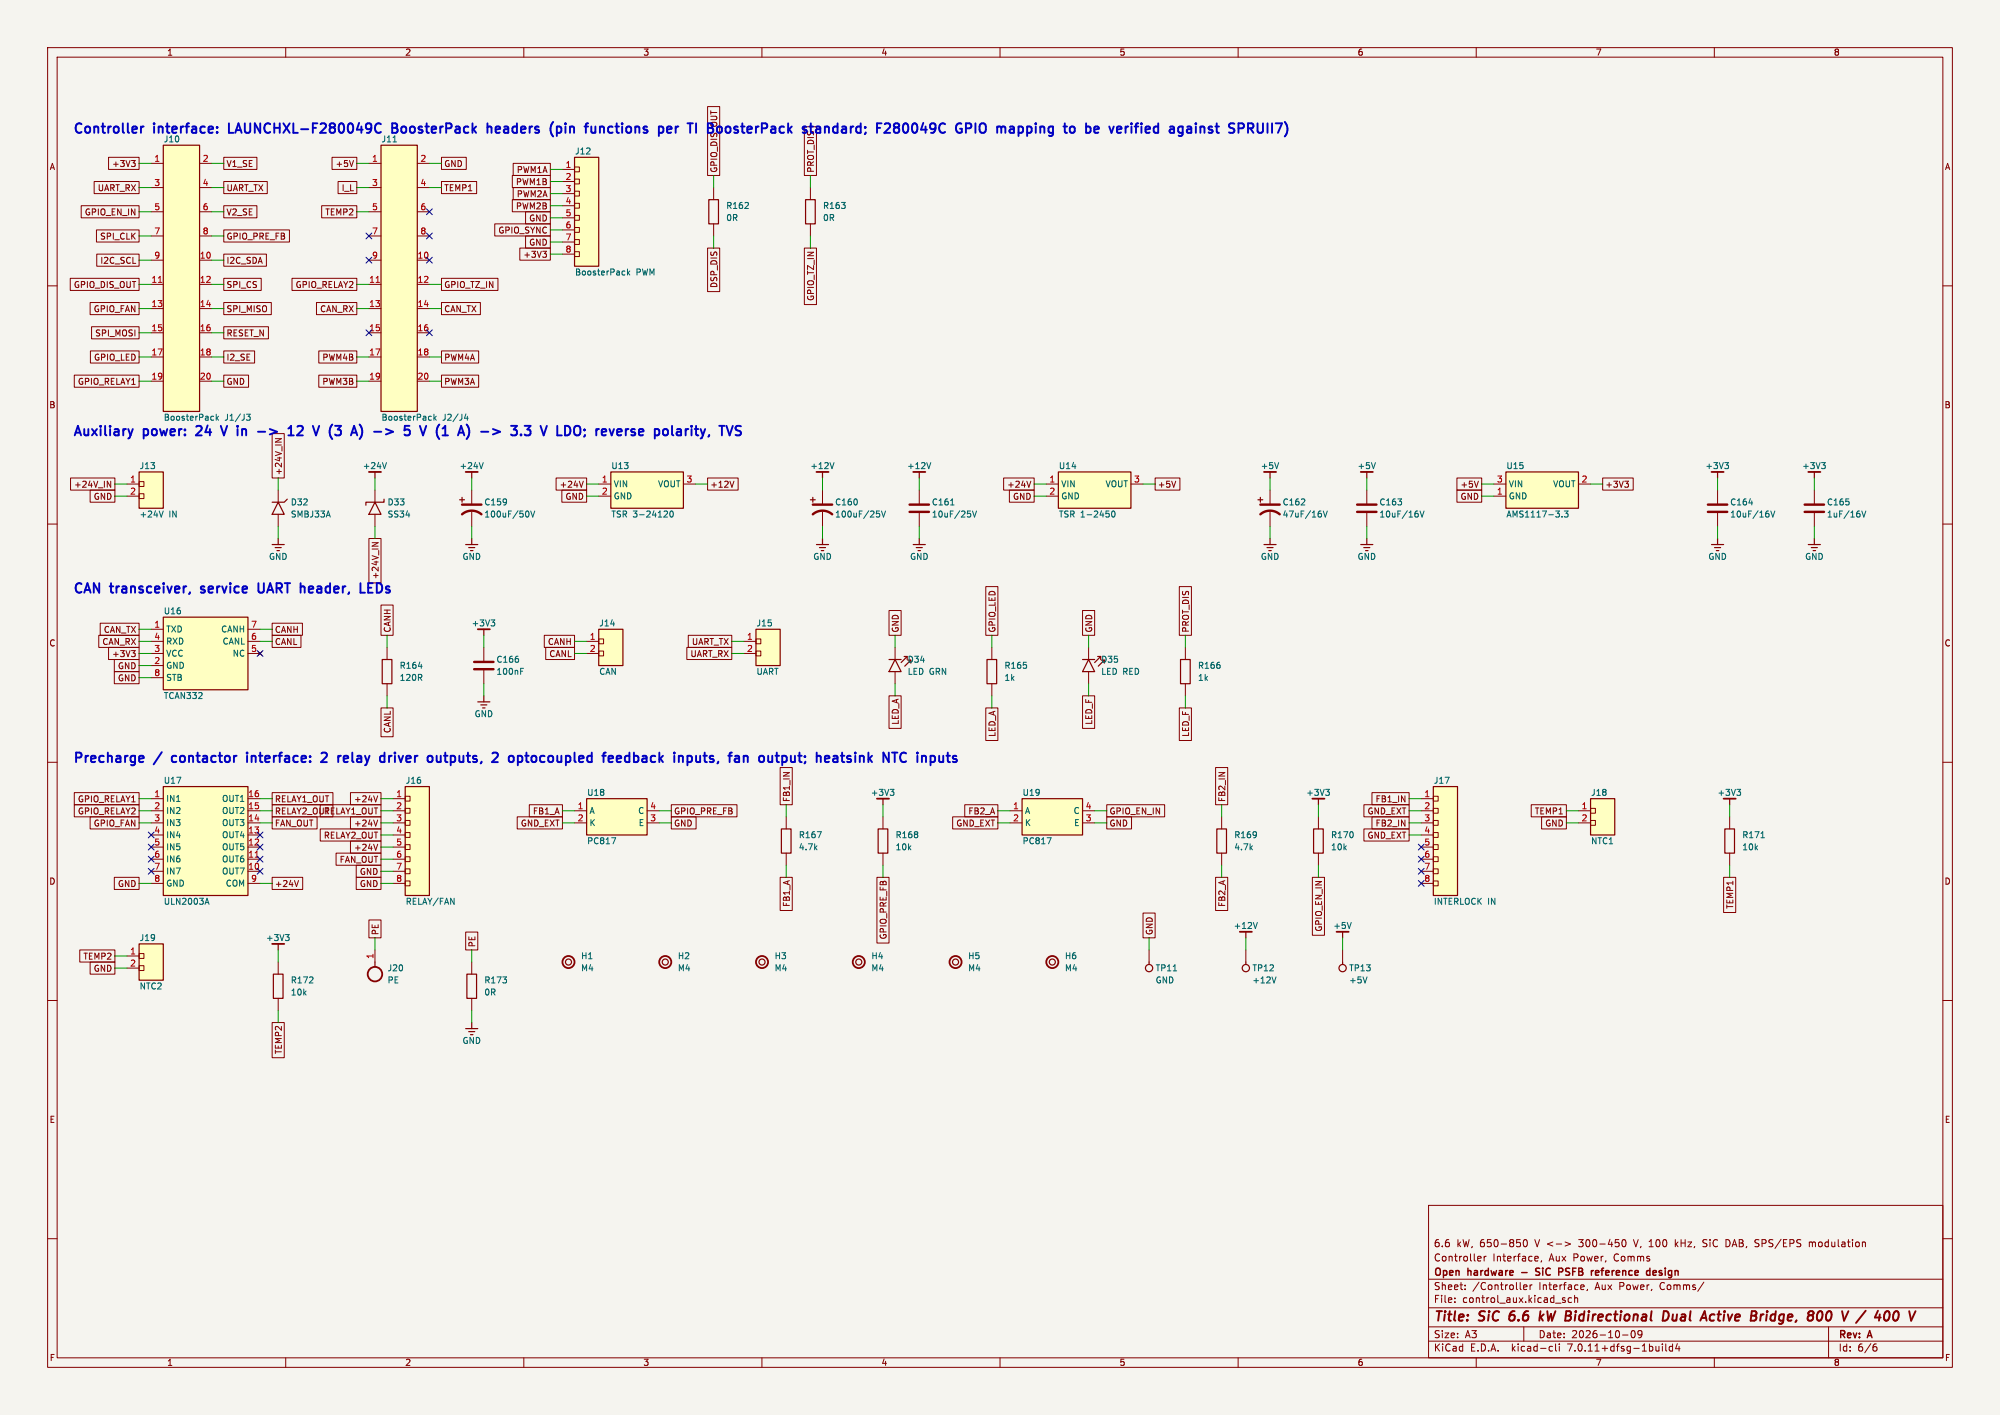
[picture p136: page 6]
