murugan-paramesh/SiC-DC-DC-Converter/hardware/outputs/SiC_PSFB_3kW-bottom-copper.pdf

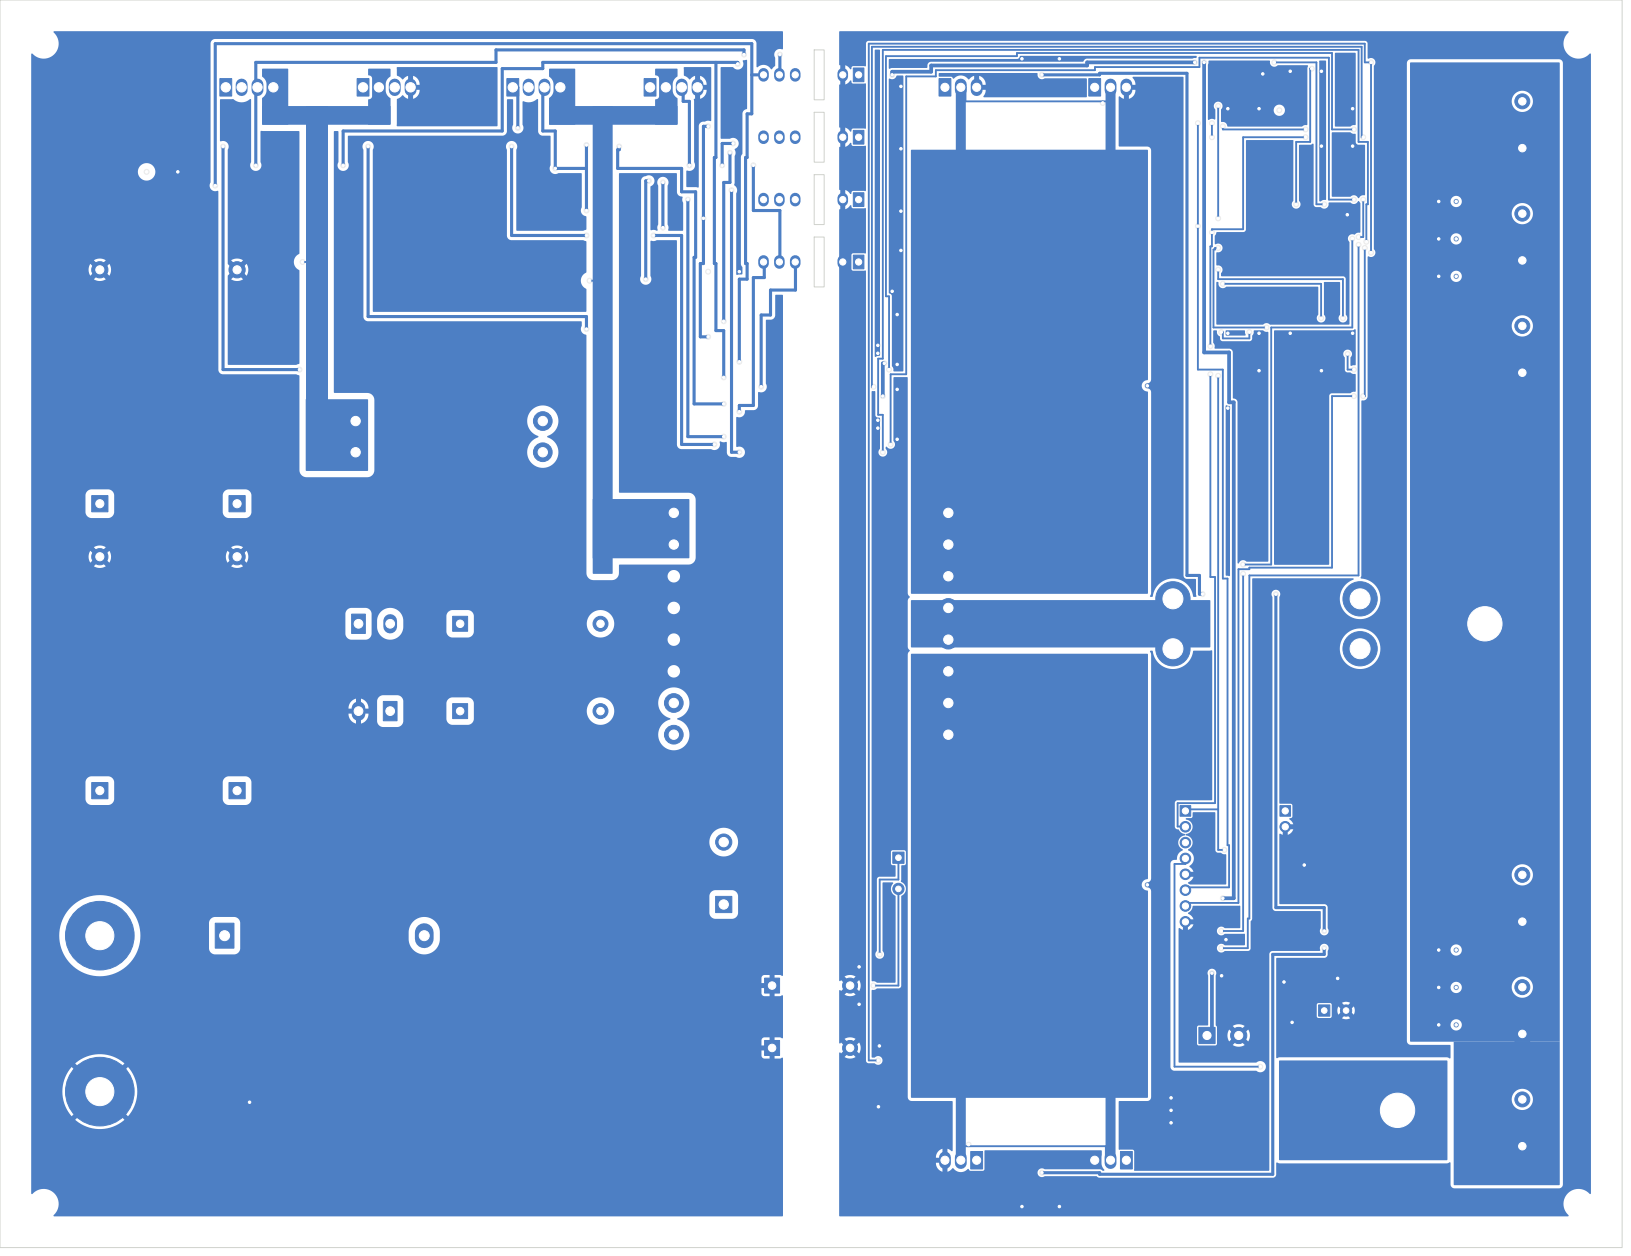
[picture p137: page 1]
