murugan-paramesh/SiC-DC-DC-Converter/hardware/outputs/SiC_PSFB_3kW-dimensions.pdf

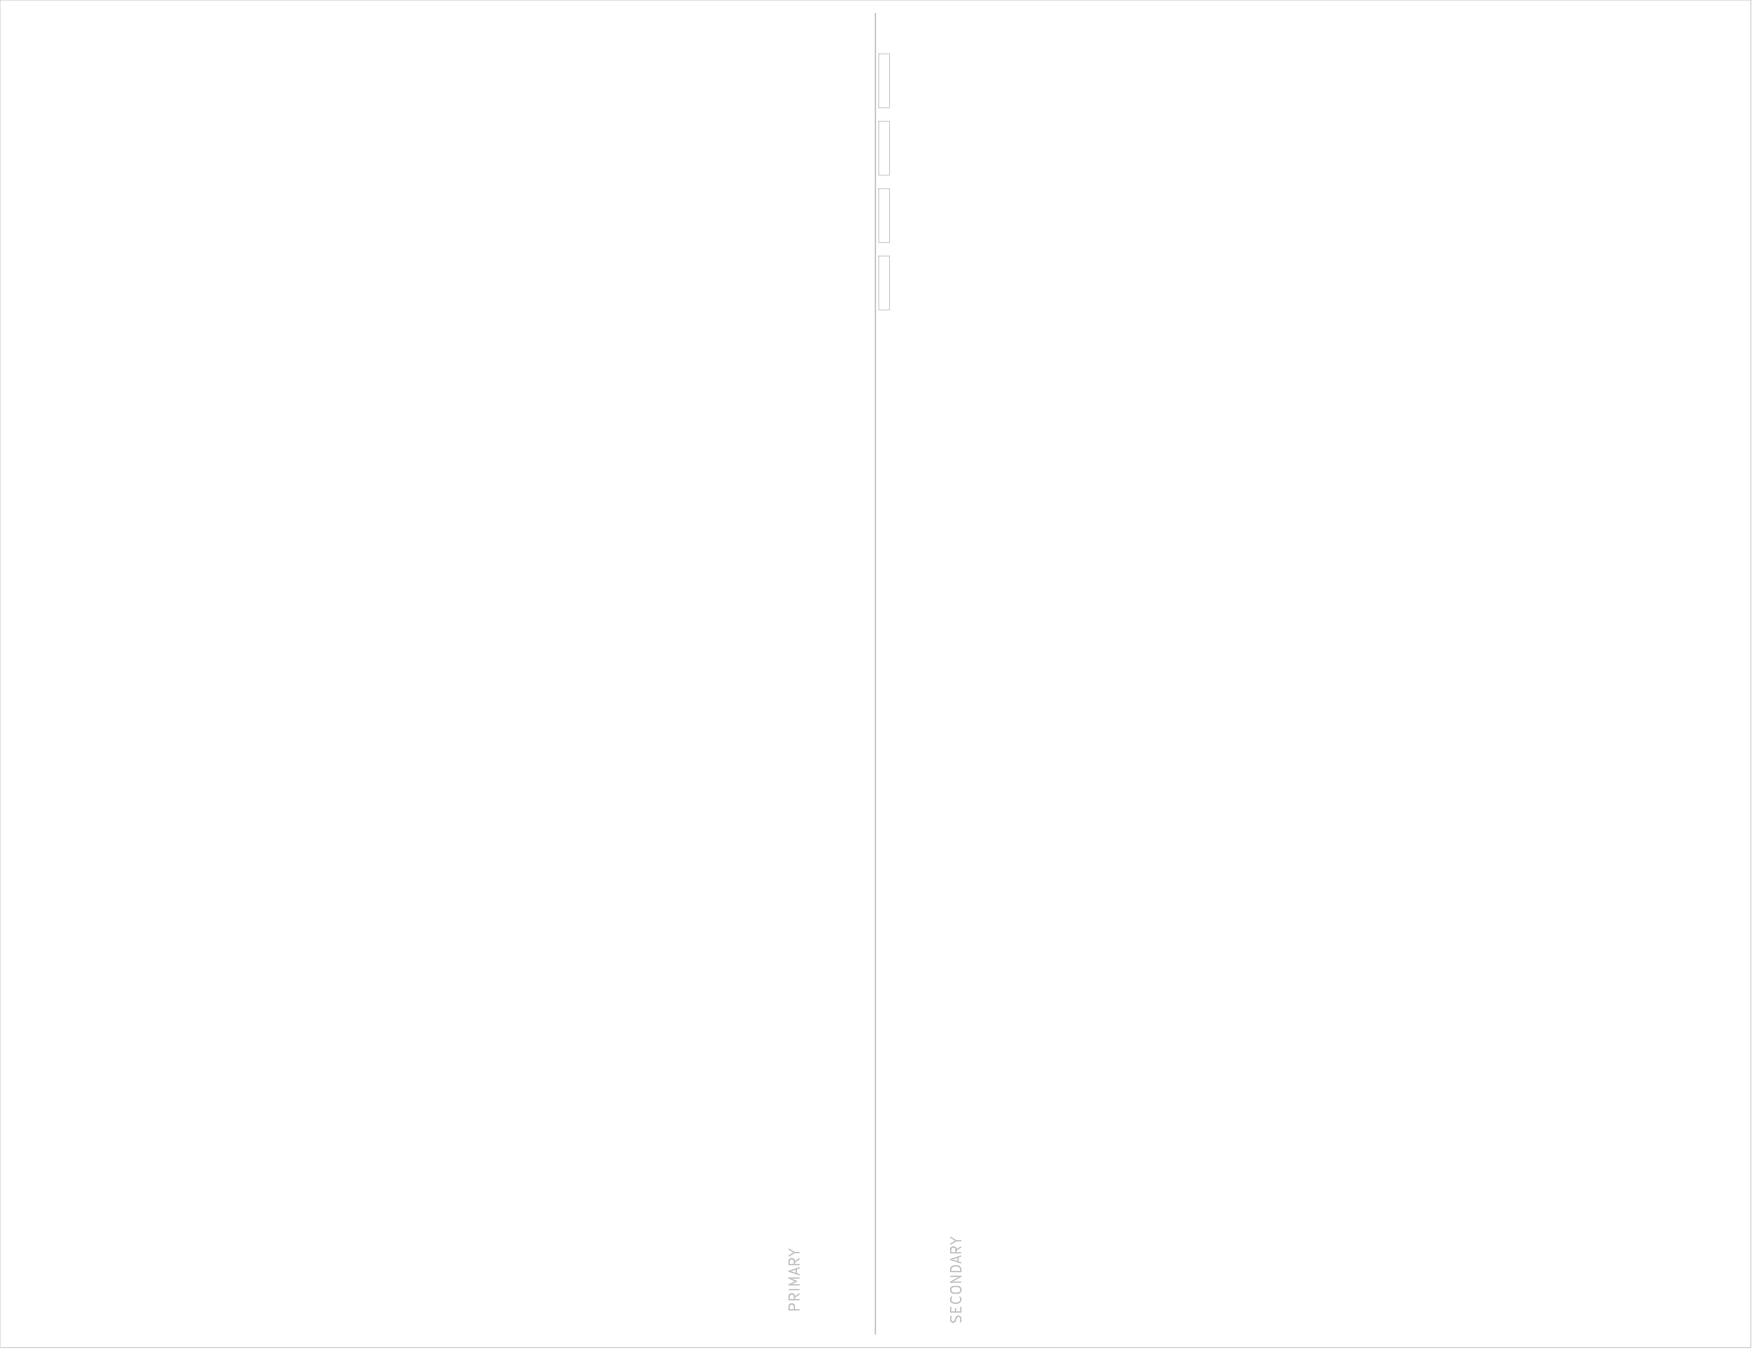
[picture p138: page 1]
