murugan-paramesh/SiC-DC-DC-Converter/hardware/outputs/SiC_PSFB_3kW-F_Fab.pdf

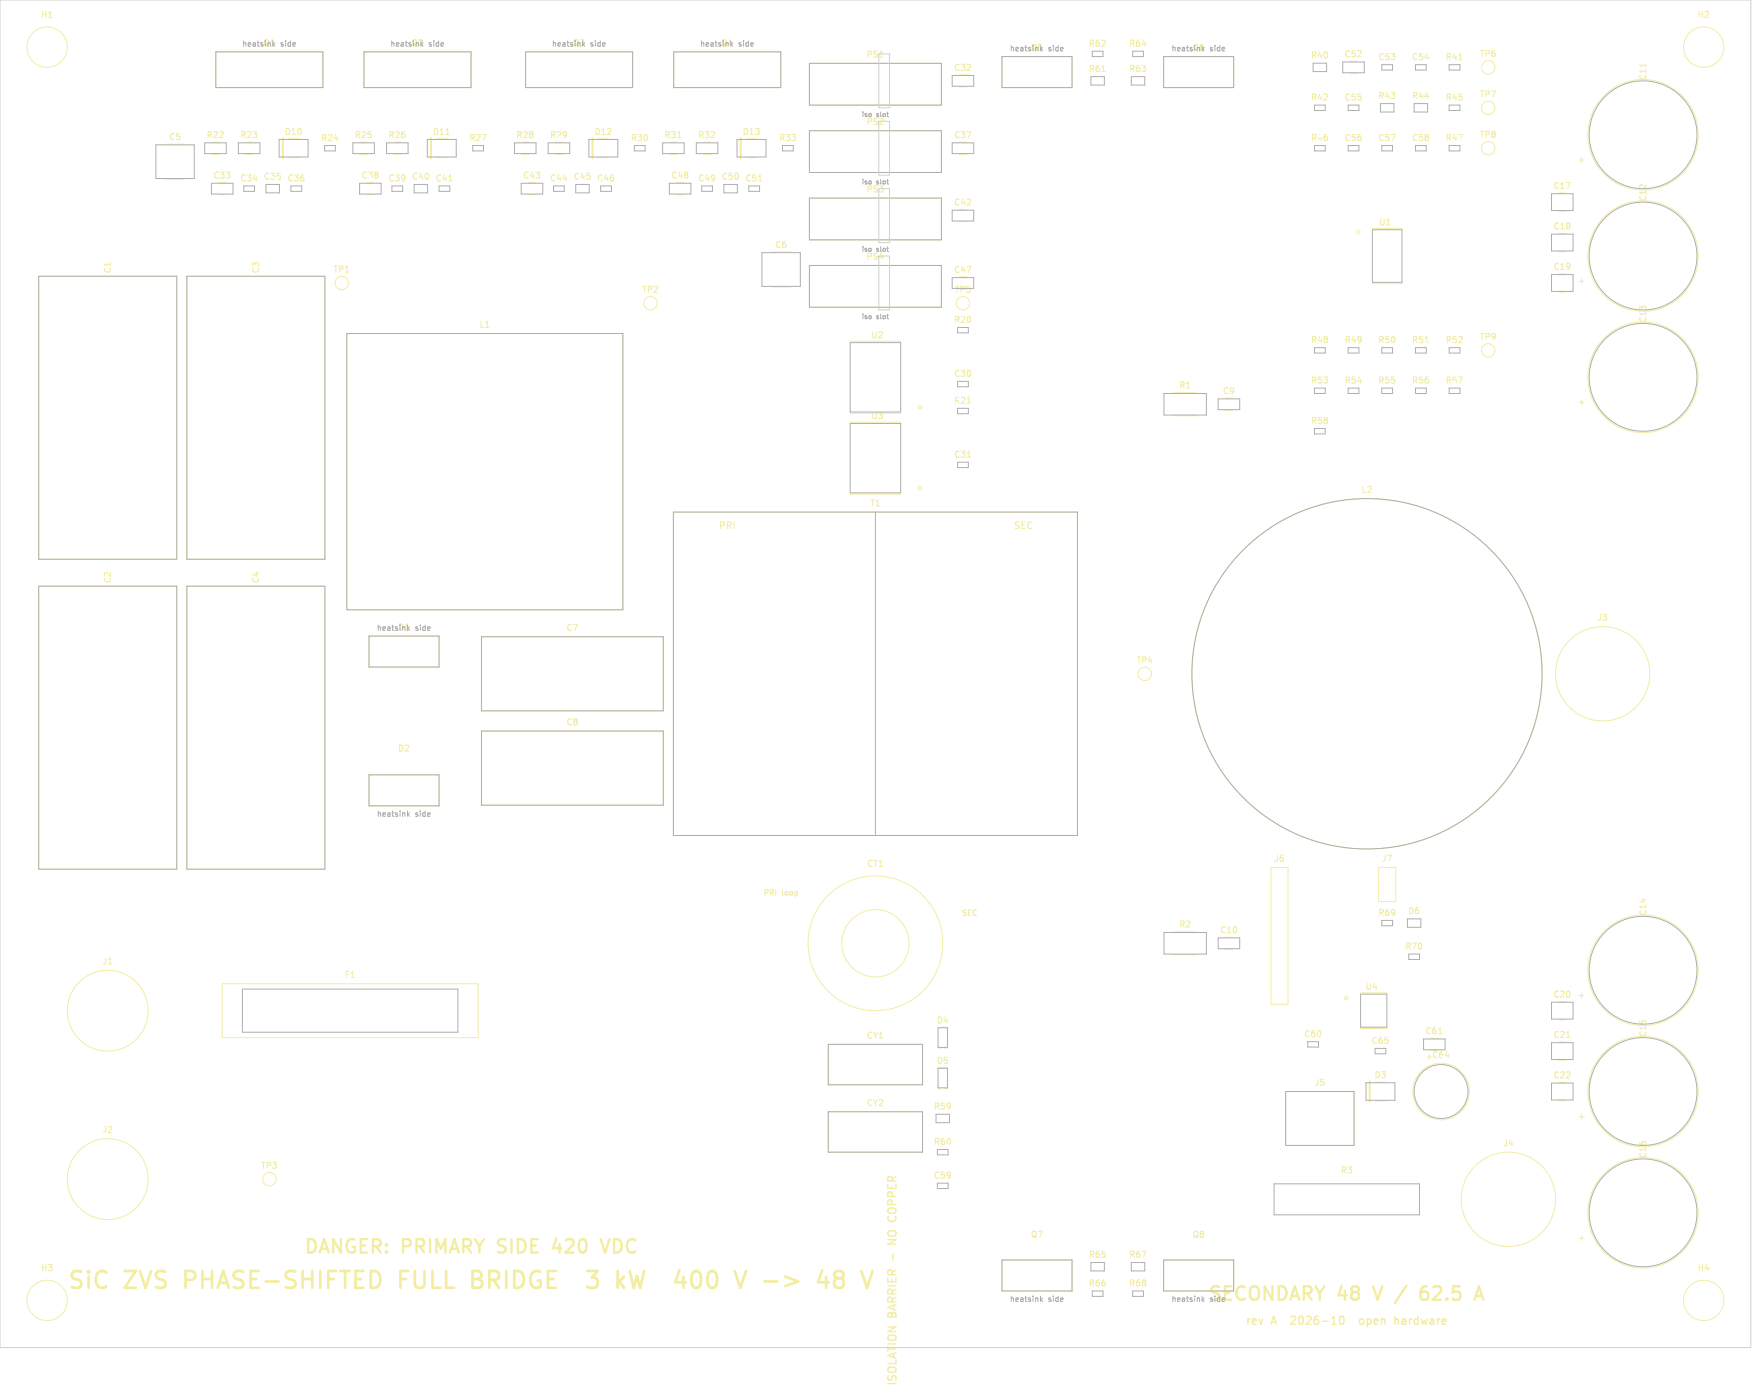
[picture p139: page 1]

ISOLATION BARRIER - NO COPPER
