murugan-paramesh/SiC-DC-DC-Converter/hardware/outputs/SiC_PSFB_3kW-top-copper.pdf

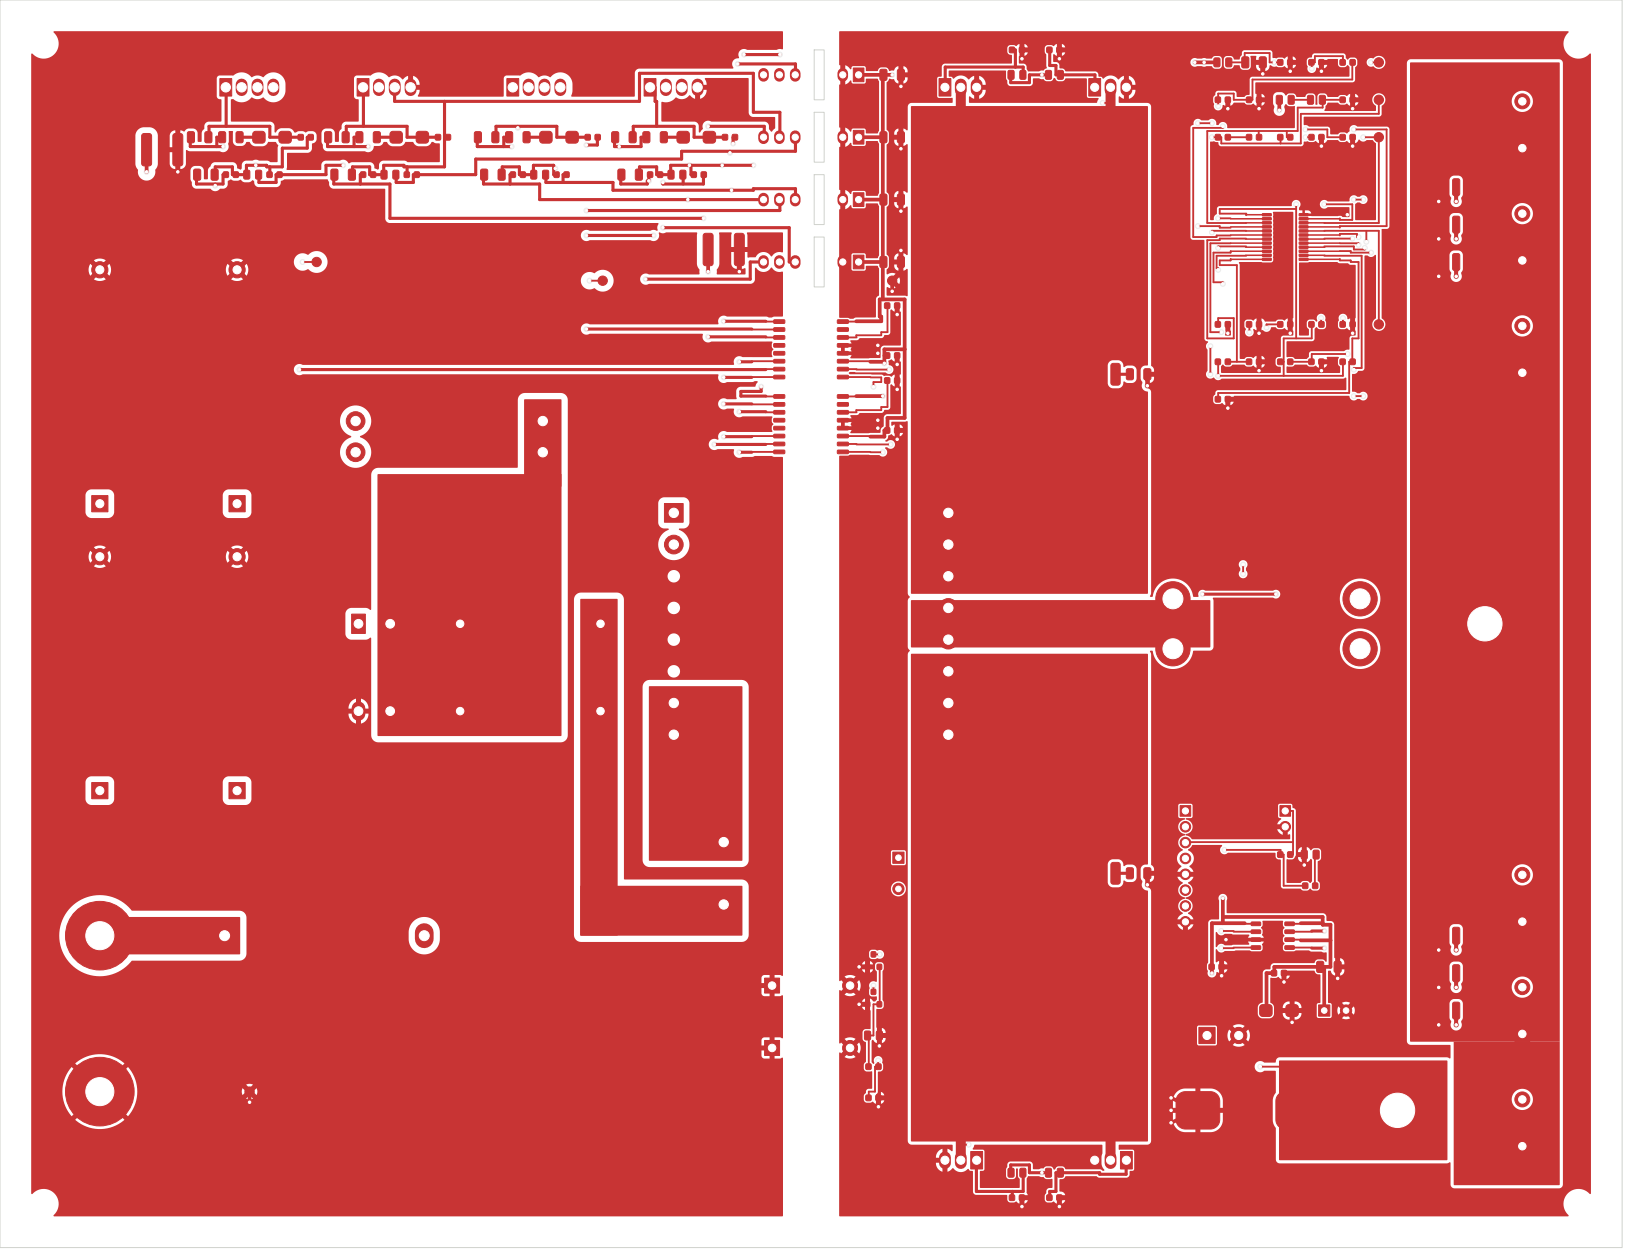
[picture p140: page 1]
