murugan-paramesh/SiC-DC-DC-Converter/SiC_6k6_Industrial_DAB/17_Manufacturing/outputs/SiC_DAB_6k6-bottom-copper.pdf

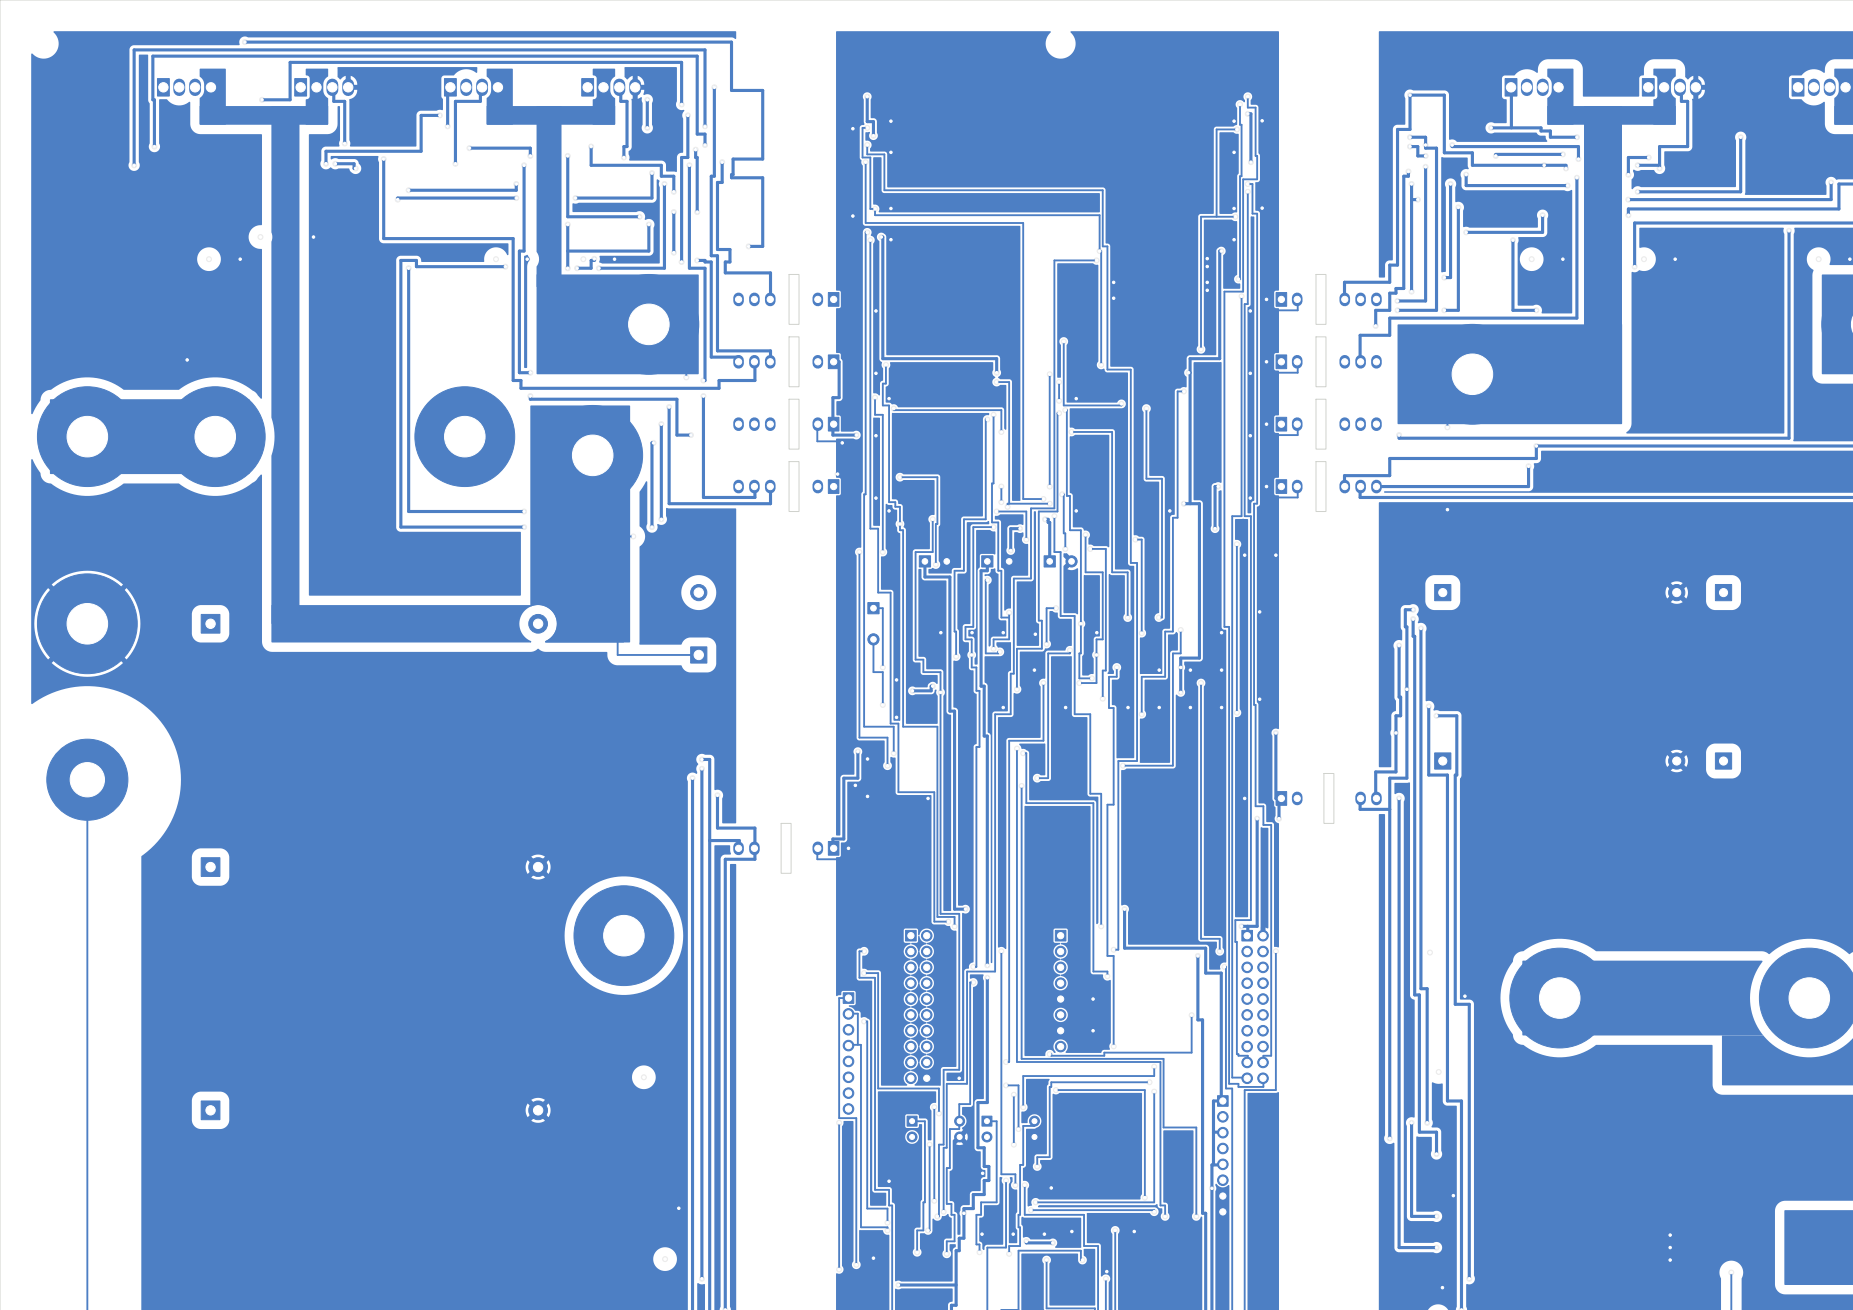
[picture p141: page 1]
