murugan-paramesh/SiC-DC-DC-Converter/SiC_6k6_Industrial_DAB/17_Manufacturing/outputs/SiC_DAB_6k6-F_Fab.pdf

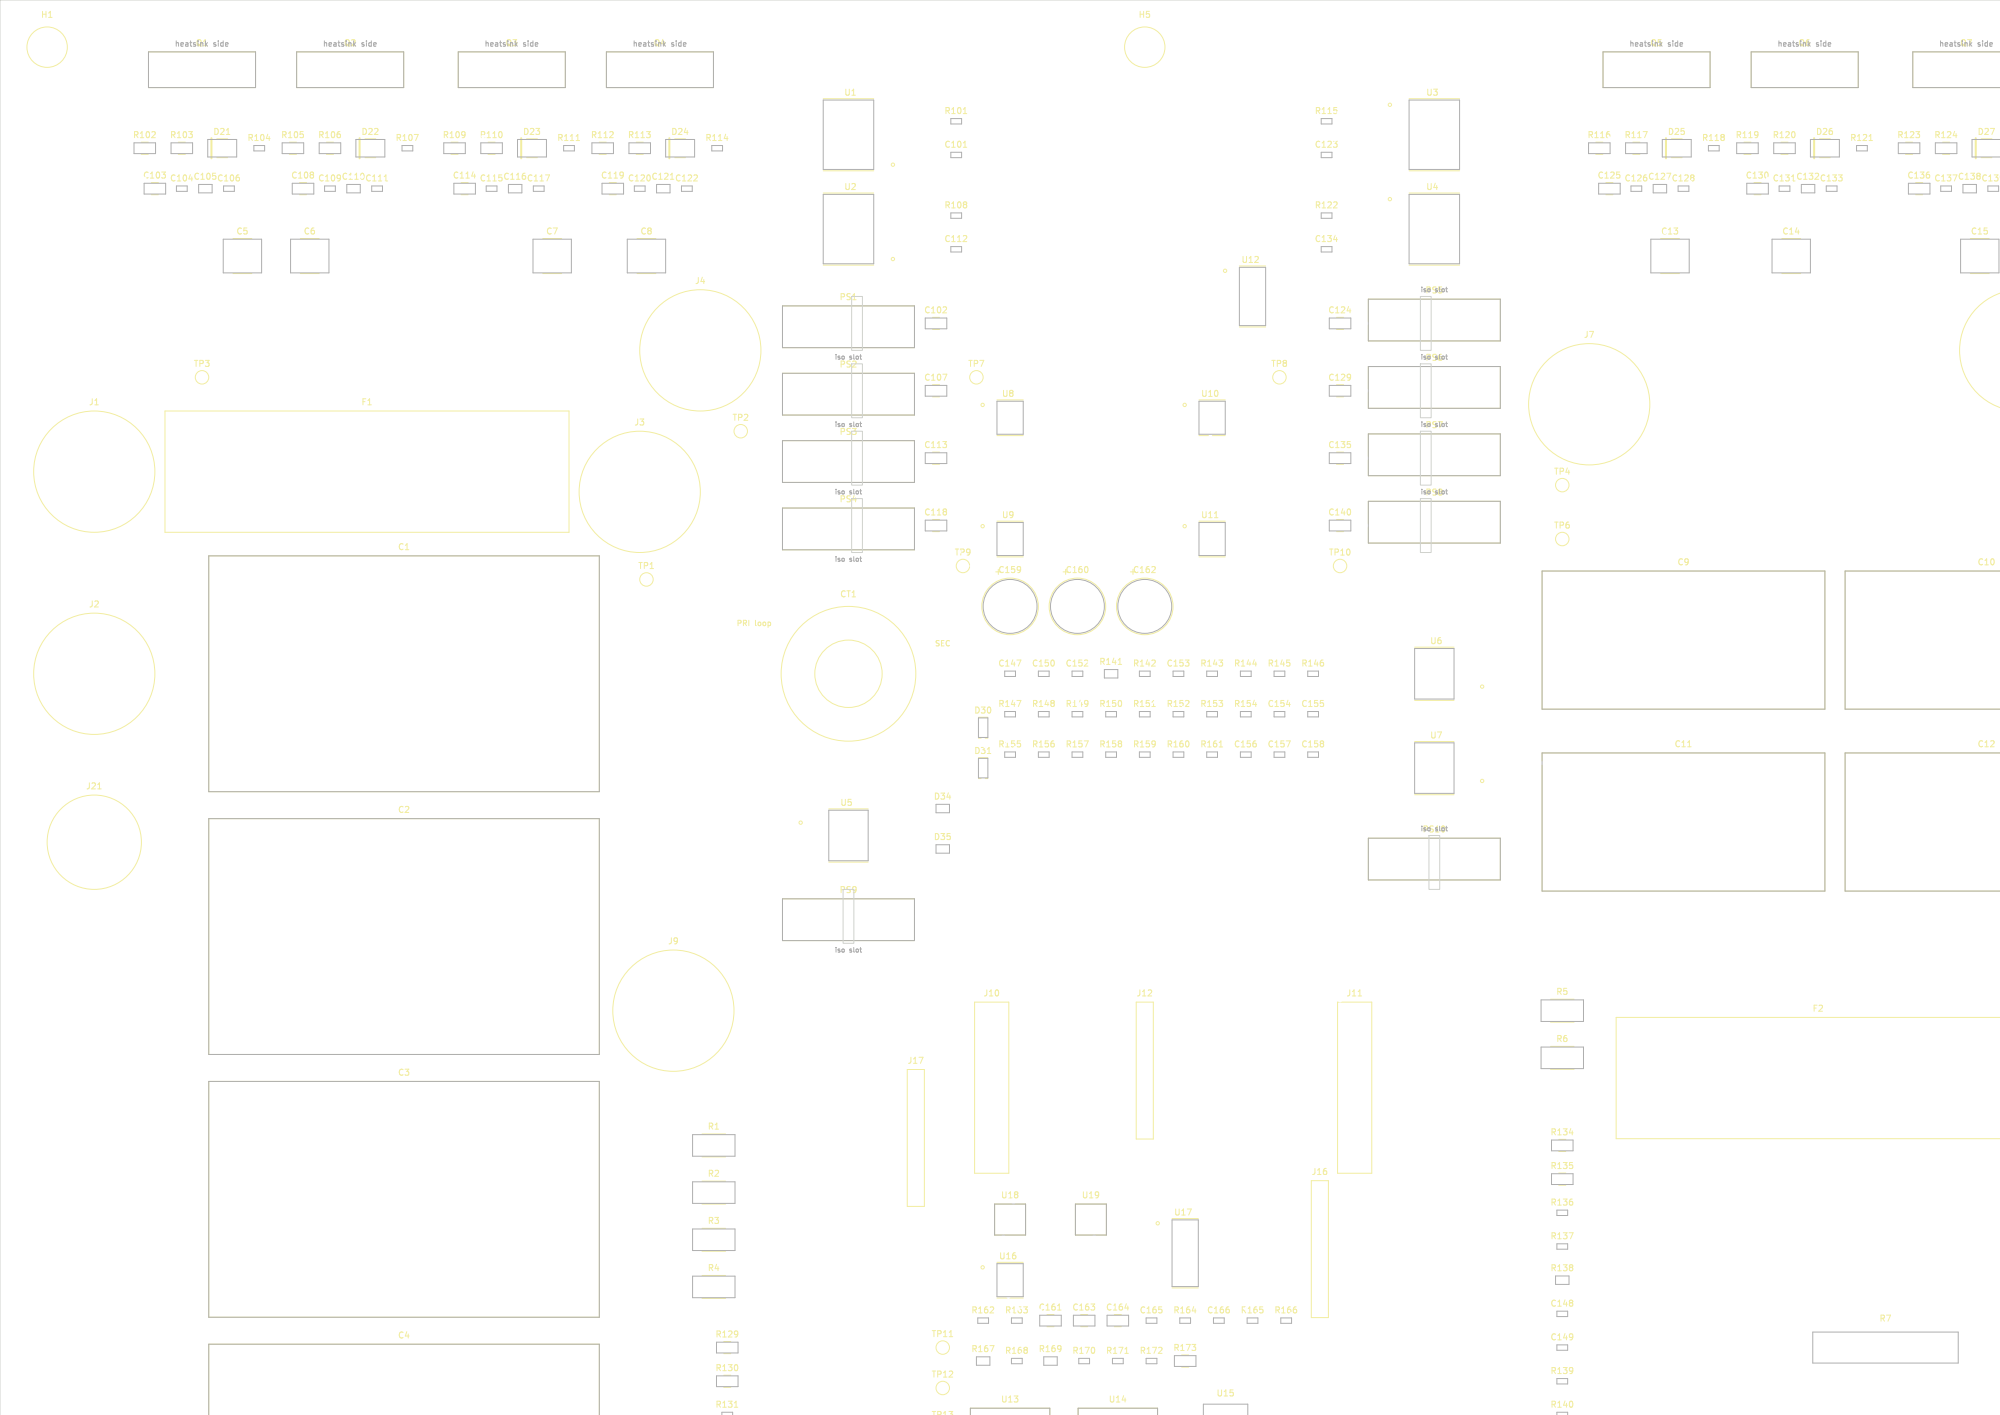
[picture p142: page 1]
