murugan-paramesh/SiC-DC-DC-Converter/SiC_6k6_Industrial_DAB/17_Manufacturing/outputs/SiC_DAB_6k6-top-copper.pdf

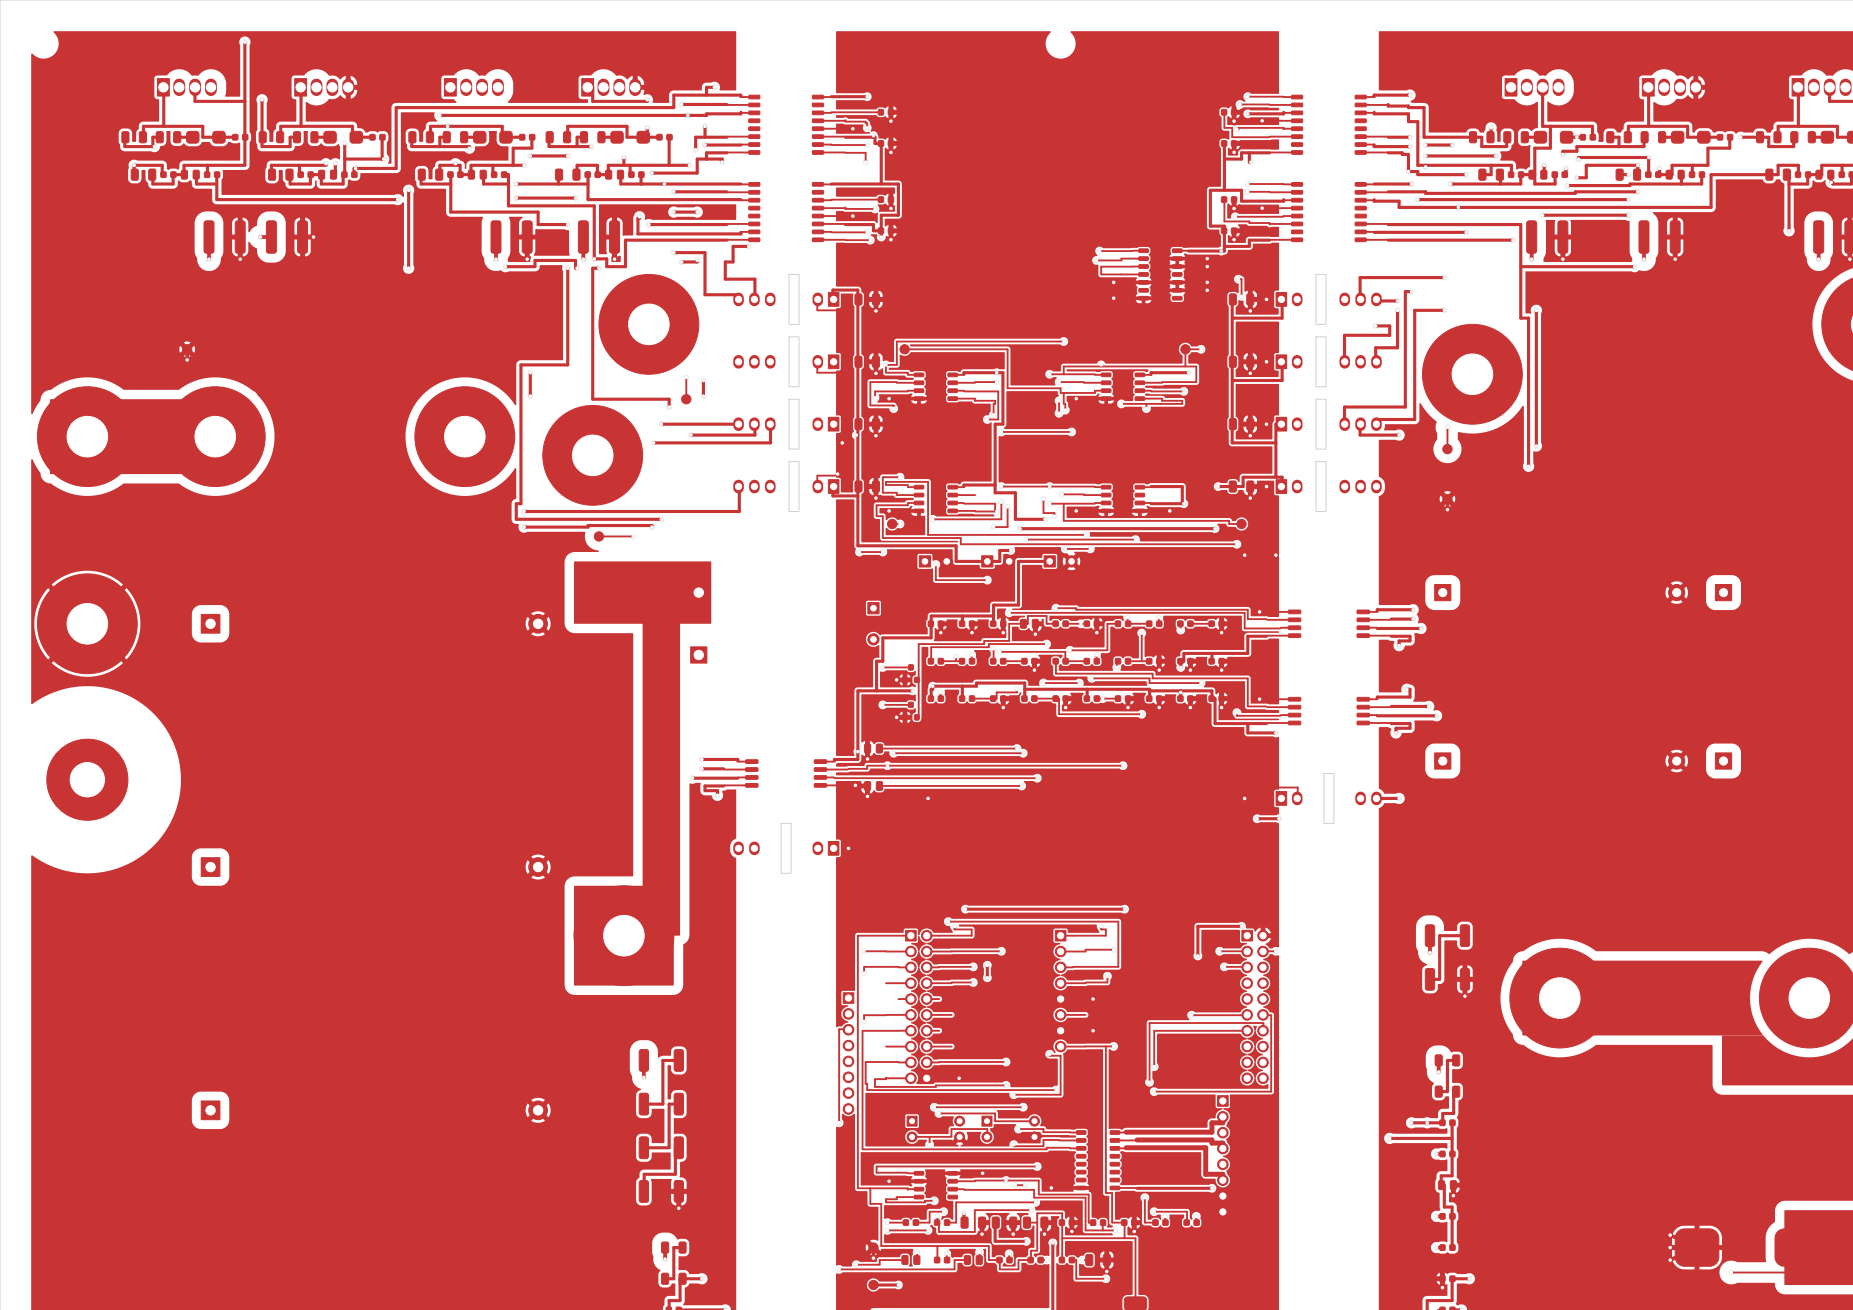
[picture p143: page 1]
