murugan-paramesh/SiC-DC-DC-Converter/SiC_6k6_Industrial_DAB/07_KiCad_Schematics/SiC_DAB_6k6.kicad_pcb

## KiCad design SiC_6k6_Industrial_DAB/07_KiCad_Schematics/SiC_DAB_6k6.kicad_pcb (2026-10-10)

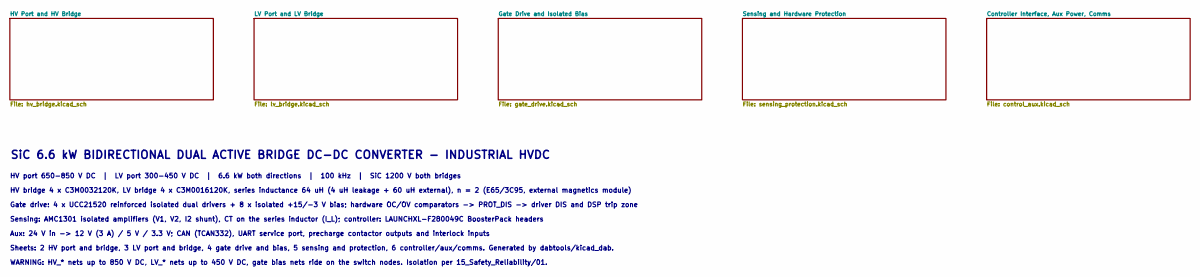
[picture p144: schematic SiC_DAB_6k6.kicad_sch, SiC 6.6 kW Bidirectional Dual Active Bridge, 800 V / 400 V]

Notes on the sheet:
SiC 6.6 kW BIDIRECTIONAL DUAL ACTIVE BRIDGE DC-DC CONVERTER - INDUSTRIAL HVDC
HV port 650-850 V DC | LV port 300-450 V DC | 6.6 kW both directions | 100 kHz | SiC 1200 V both bridges
HV bridge 4 x C3M0032120K, LV bridge 4 x C3M0016120K, series inductance 64 uH (4 uH leakage + 60 uH external), n = 2 (E65/3C95, external magnetics module)
Gate drive: 4 x UCC21520 reinforced isolated dual drivers + 8 x isolated +15/-3 V bias; hardware OC/OV comparators -> PROT_DIS -> driver DIS and DSP trip zone
Sensing: AMC1301 isolated amplifiers (V1, V2, I2 shunt), CT on the series inductor (I_L); controller: LAUNCHXL-F280049C BoosterPack headers
Aux: 24 V in -> 12 V (3 A) / 5 V / 3.3 V; CAN (TCAN332), UART service port, precharge contactor outputs and interlock inputs
Sheets: 2 HV port and bridge, 3 LV port and bridge, 4 gate drive and bias, 5 sensing and protection, 6 controller/aux/comms. Generated by dabtools/kicad_dab.
WARNING: HV_* nets up to 850 V DC, LV_* nets up to 450 V DC, gate bias nets ride on the switch nodes. Isolation per 15_Safety_Reliability/01.

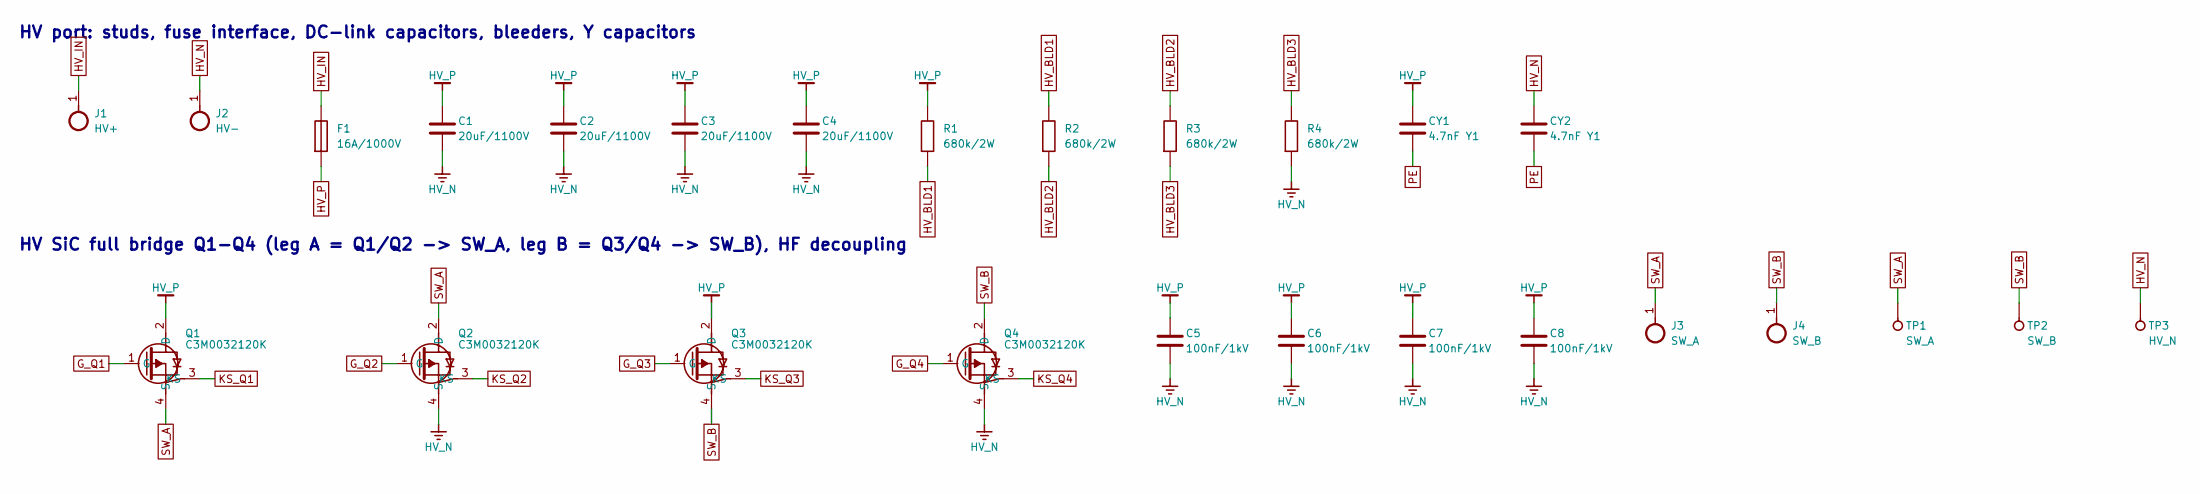
[picture p145: schematic hv_bridge.kicad_sch, SiC 6.6 kW Bidirectional Dual Active Bridge, 800 V / 400 V]

Parts:
C1, C2, C3, C4: 20uF/1100V; C_Film_P52.5; MPN TDK B32778J0206K (verify 1100 V variant)
C5, C6, C7, C8: 100nF/1kV; C_2220; MPN TDK CGA9N4X7T2W104K (verify)
CY1, CY2: 4.7nF Y1; C_Y1_P12.5; MPN Vishay VY1472M63Y5UQ63V0
F1: 16A/1000V; Fuse_Terminal_M6; MPN Bussmann FWP-16A14F class (verify)
J1: HV+; Stud_M6
J2: HV-; Stud_M6
J3: SW_A; Stud_M6
J4: SW_B; Stud_M6
Q1, Q2, Q3, Q4: C3M0032120K; TO-247-4_Vertical; MPN Wolfspeed C3M0032120K
R1, R2, R3, R4: 680k/2W; R_2512
TP1: SW_A; TestPoint
TP2: SW_B; TestPoint
TP3: HV_N; TestPoint

Connections:
G_Q1: Q1.1 (G); also elsewhere on the board
G_Q2: Q2.1 (G); also elsewhere on the board
G_Q3: Q3.1 (G); also elsewhere on the board
G_Q4: Q4.1 (G); also elsewhere on the board
HV_BLD1: R1.2, R2.1
HV_BLD2: R2.2, R3.1
HV_BLD3: R3.2, R4.1
HV_IN: F1.1, J1.1
HV_N: C1.2, C2.2, C3.2, C4.2, C5.2, C6.2, C7.2, C8.2, CY2.1, J2.1, Q2.4 (S), Q4.4 (S), R4.2, TP3.1; also elsewhere on the board
HV_P: C1.1, C2.1, C3.1, C4.1, C5.1, C6.1, C7.1, C8.1, CY1.1, F1.2, Q1.2 (D), Q3.2 (D), R1.1; also elsewhere on the board
KS_Q1: Q1.3 (KS); also elsewhere on the board
KS_Q2: Q2.3 (KS); also elsewhere on the board
KS_Q3: Q3.3 (KS); also elsewhere on the board
KS_Q4: Q4.3 (KS); also elsewhere on the board
PE_HV: CY1.2, CY2.2; also elsewhere on the board
SW_A: J3.1, Q1.4 (S), Q2.2 (D), TP1.1; also elsewhere on the board
SW_B: J4.1, Q3.4 (S), Q4.2 (D), TP2.1

Notes on the sheet:
HV port: studs, fuse interface, DC-link capacitors, bleeders, Y capacitors
HV SiC full bridge Q1-Q4 (leg A = Q1/Q2 -> SW_A, leg B = Q3/Q4 -> SW_B), HF decoupling

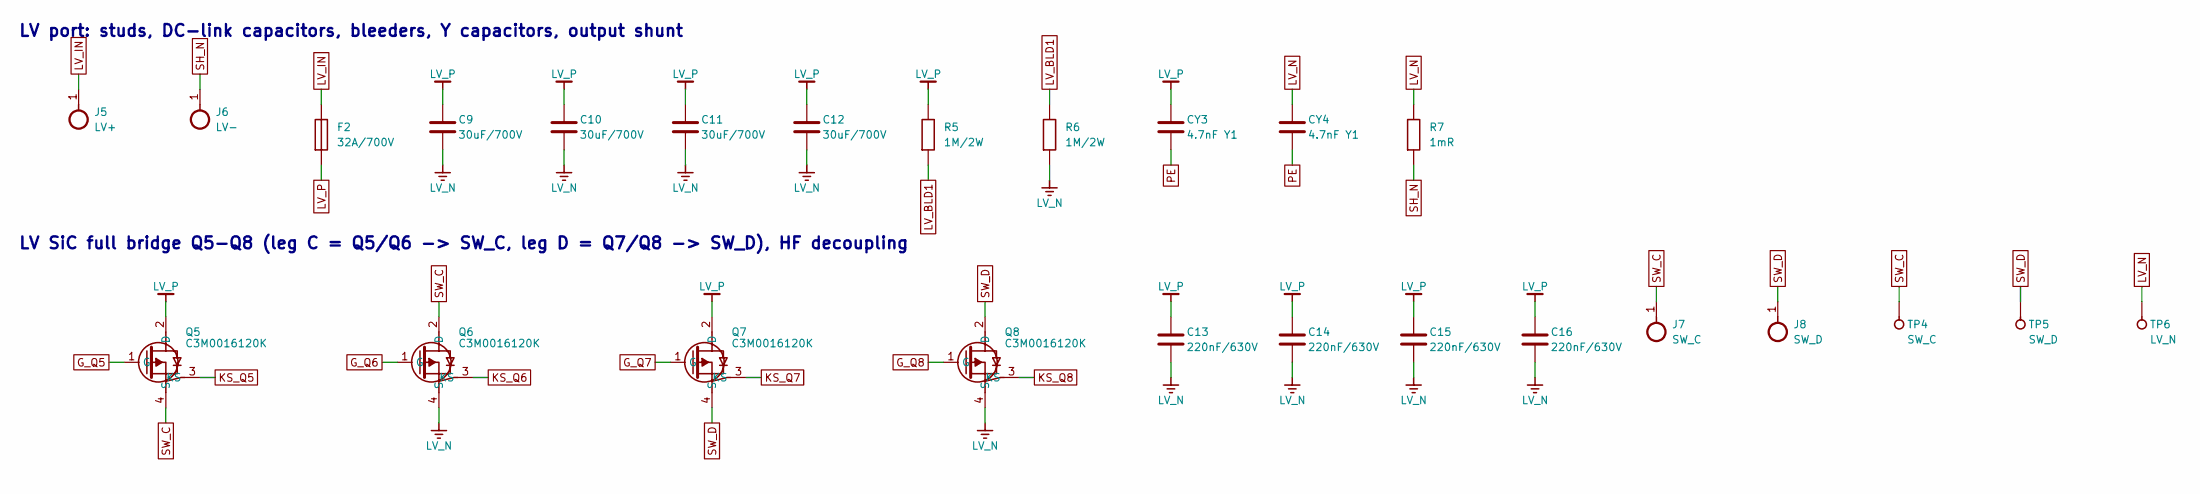
[picture p146: schematic lv_bridge.kicad_sch, SiC 6.6 kW Bidirectional Dual Active Bridge, 800 V / 400 V]

Parts:
C9, C10, C11, C12: 30uF/700V; C_Film_P37.5; MPN TDK B32778G7306K (verify)
C13, C14, C15, C16: 220nF/630V; C_2220; MPN TDK CGA9P4X7T2J224K (verify)
CY3, CY4: 4.7nF Y1; C_Y1_P12.5; MPN Vishay VY1472M63Y5UQ63V0
F2: 32A/700V; Fuse_Terminal_M6; MPN Bussmann FWP-32A14F class (verify)
J5: LV+; Stud_M6
J6: LV-; Stud_M6
J7: SW_C; Stud_M6
J8: SW_D; Stud_M6
Q5, Q6, Q7, Q8: C3M0016120K; TO-247-4_Vertical; MPN Wolfspeed C3M0016120K
R5, R6: 1M/2W; R_2512
R7: 1mR; R_Shunt_8518; MPN Vishay WSBS8518L1000JK
TP4: SW_C; TestPoint
TP5: SW_D; TestPoint
TP6: LV_N; TestPoint

Connections:
G_Q5: Q5.1 (G); also elsewhere on the board
G_Q6: Q6.1 (G); also elsewhere on the board
G_Q7: Q7.1 (G); also elsewhere on the board
G_Q8: Q8.1 (G); also elsewhere on the board
KS_Q5: Q5.3 (KS); also elsewhere on the board
KS_Q6: Q6.3 (KS); also elsewhere on the board
KS_Q7: Q7.3 (KS); also elsewhere on the board
KS_Q8: Q8.3 (KS); also elsewhere on the board
LV_BLD1: R5.2, R6.1
LV_IN: F2.1, J5.1
LV_N: C9.2, C10.2, C11.2, C12.2, C13.2, C14.2, C15.2, C16.2, CY4.1, Q6.4 (S), Q8.4 (S), R6.2, R7.1, TP6.1; also elsewhere on the board
LV_P: C9.1, C10.1, C11.1, C12.1, C13.1, C14.1, C15.1, C16.1, CY3.1, F2.2, Q5.2 (D), Q7.2 (D), R5.1; also elsewhere on the board
PE_LV: CY3.2, CY4.2; also elsewhere on the board
SH_N: J6.1, R7.2; also elsewhere on the board
SW_C: J7.1, Q5.4 (S), Q6.2 (D), TP4.1
SW_D: J8.1, Q7.4 (S), Q8.2 (D), TP5.1

Notes on the sheet:
LV port: studs, DC-link capacitors, bleeders, Y capacitors, output shunt
LV SiC full bridge Q5-Q8 (leg C = Q5/Q6 -> SW_C, leg D = Q7/Q8 -> SW_D), HF decoupling

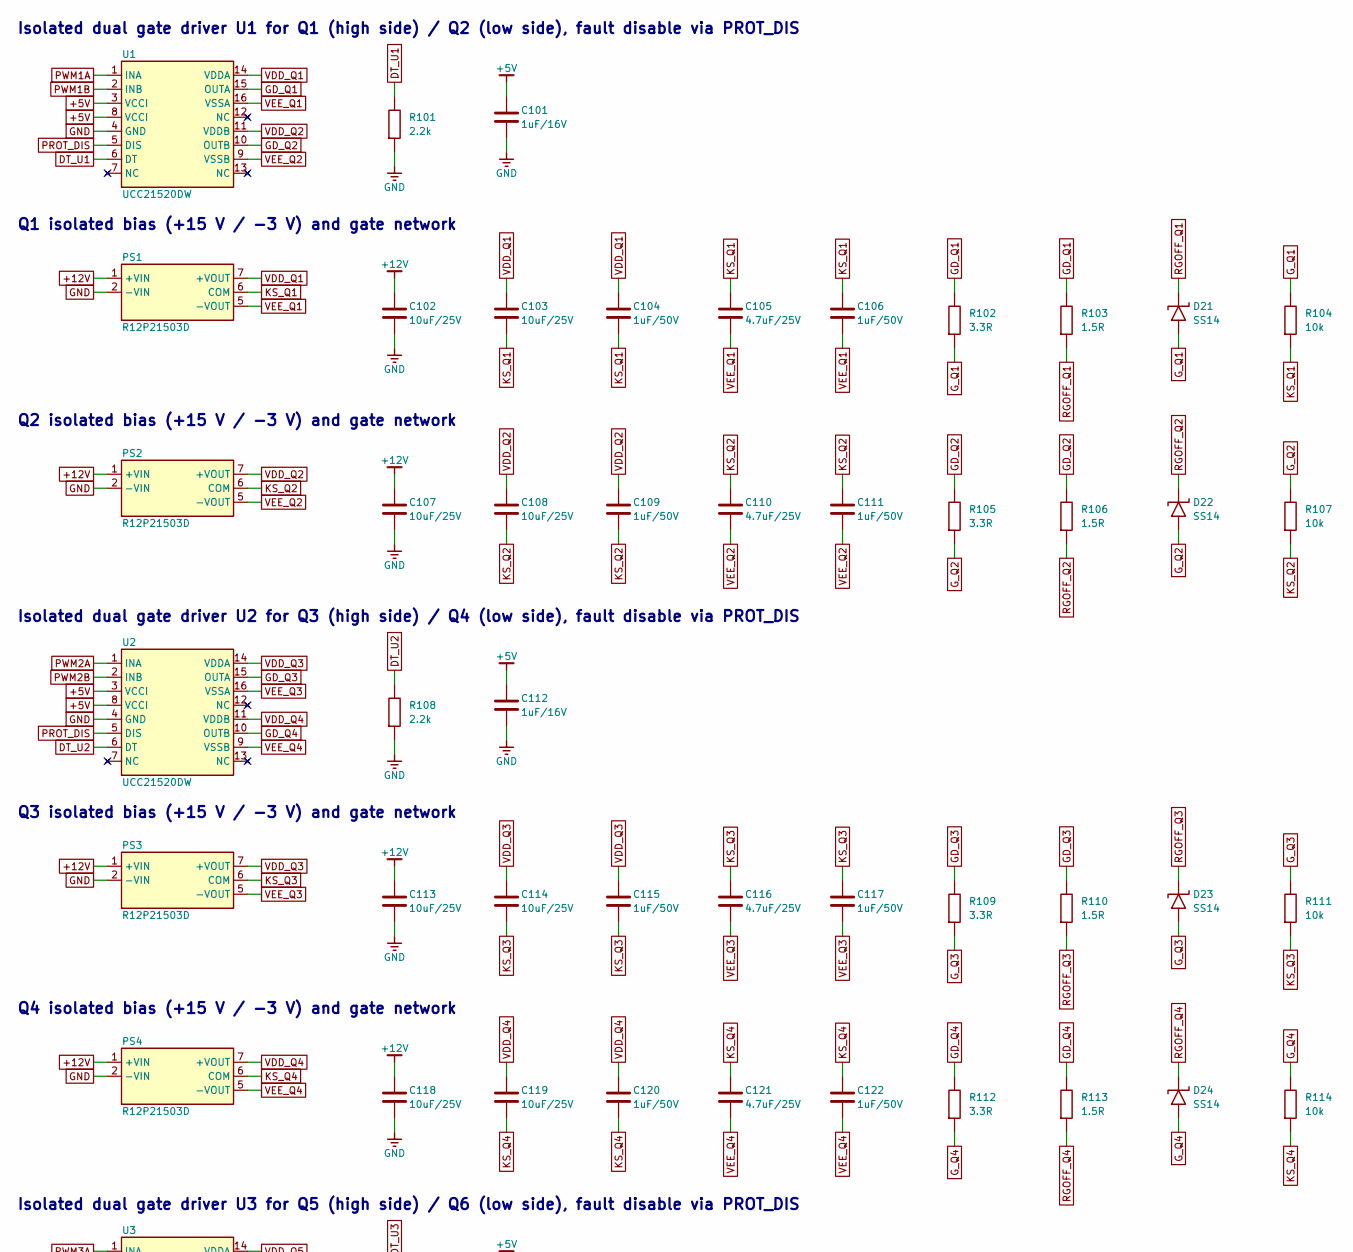
[picture p147: schematic gate_drive.kicad_sch, SiC 6.6 kW Bidirectional Dual Active Bridge, 800 V / 400 V, part in row 1, column 1]

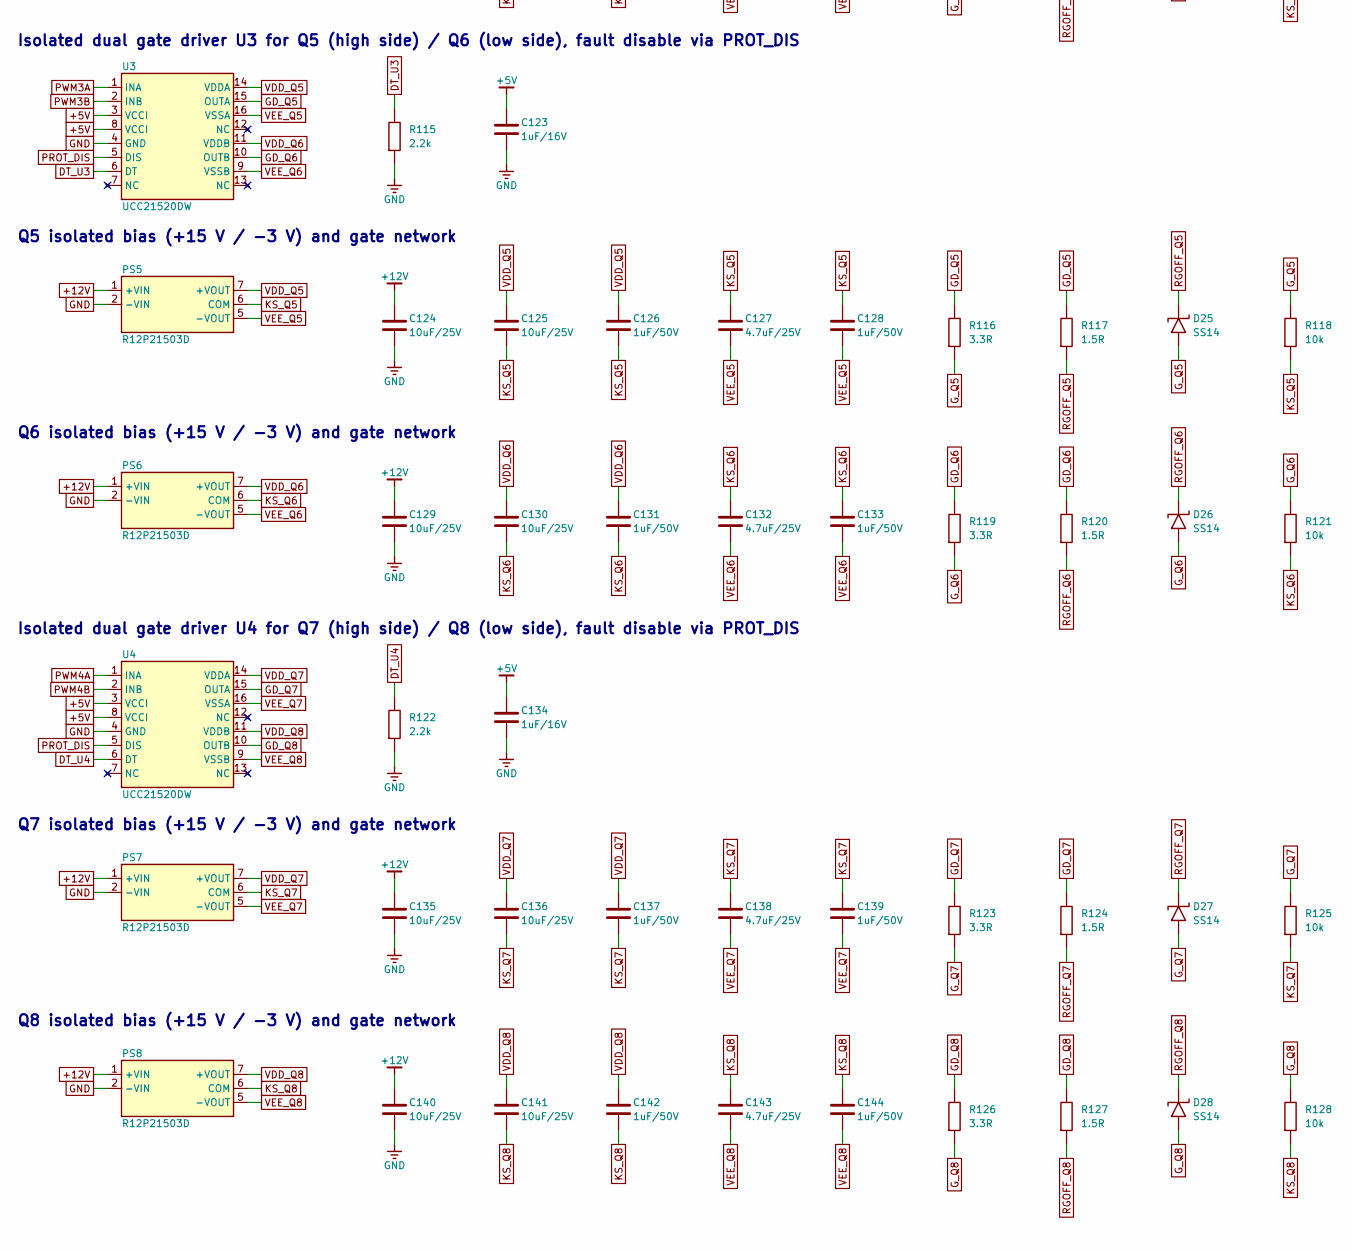
[picture p148: schematic gate_drive.kicad_sch, SiC 6.6 kW Bidirectional Dual Active Bridge, 800 V / 400 V, part in row 2, column 1]

Parts:
C101, C112, C123, C134: 1uF/16V; C_0603
C102, C103, C107, C108, C113, C114, C118, C119, C124, C125, C129, C130, C135, C136, C140, C141: 10uF/25V; C_1206
C104, C106, C109, C111, C115, C117, C120, C122, C126, C128, C131, C133, C137, C139, C142, C144: 1uF/50V; C_0603
C105, C110, C116, C121, C127, C132, C138, C143: 4.7uF/25V; C_0805
D21, D22, D23, D24, D25, D26, D27, D28: SS14; D_SMA; MPN Vishay SS14
PS1, PS2, PS3, PS4, PS5, PS6, PS7, PS8: R12P21503D; SIP-7_IsoDCDC; MPN RECOM R12P21503D (basic-class isolation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
R101, R108, R115, R122: 2.2k; R_0603
R102, R105, R109, R112, R116, R119, R123, R126: 3.3R; R_1206
R103, R106, R110, R113, R117, R120, R124, R127: 1.5R; R_1206
R104, R107, R111, R114, R118, R121, R125, R128: 10k; R_0603
U1, U2, U3, U4: UCC21520DW; SOIC-16W; MPN TI UCC21520DW

Connections:
+5V: C101.1, C112.1, C123.1, C134.1, U1.3 (VCCI), U1.8 (VCCI), U2.3 (VCCI), U2.8 (VCCI), U3.3 (VCCI), U3.8 (VCCI), U4.3 (VCCI), U4.8 (VCCI); also elsewhere on the board
+12V: C102.1, C107.1, C113.1, C118.1, C124.1, C129.1, C135.1, C140.1, PS1.1 (+VIN), PS2.1 (+VIN), PS3.1 (+VIN), PS4.1 (+VIN), PS5.1 (+VIN), PS6.1 (+VIN), PS7.1 (+VIN), PS8.1 (+VIN); also elsewhere on the board
DT_U1: R101.1, U1.6 (DT)
DT_U2: R108.1, U2.6 (DT)
DT_U3: R115.1, U3.6 (DT)
DT_U4: R122.1, U4.6 (DT)
GD_Q1: R102.1, R103.1, U1.15 (OUTA)
GD_Q2: R105.1, R106.1, U1.10 (OUTB)
GD_Q3: R109.1, R110.1, U2.15 (OUTA)
GD_Q4: R112.1, R113.1, U2.10 (OUTB)
GD_Q5: R116.1, R117.1, U3.15 (OUTA)
GD_Q6: R119.1, R120.1, U3.10 (OUTB)
GD_Q7: R123.1, R124.1, U4.15 (OUTA)
GD_Q8: R126.1, R127.1, U4.10 (OUTB)
GND: C101.2, C102.2, C107.2, C112.2, C113.2, C118.2, C123.2, C124.2, C129.2, C134.2, C135.2, C140.2, PS1.2 (-VIN), PS2.2 (-VIN), PS3.2 (-VIN), PS4.2 (-VIN), PS5.2 (-VIN), PS6.2 (-VIN), PS7.2 (-VIN), PS8.2 (-VIN), R101.2, R108.2, R115.2, R122.2, U1.4 (GND), U2.4 (GND), U3.4 (GND), U4.4 (GND); also elsewhere on the board
G_Q1: D21.2 (A), R102.2, R104.1; also elsewhere on the board
G_Q2: D22.2 (A), R105.2, R107.1; also elsewhere on the board
G_Q3: D23.2 (A), R109.2, R111.1; also elsewhere on the board
G_Q4: D24.2 (A), R112.2, R114.1; also elsewhere on the board
G_Q5: D25.2 (A), R116.2, R118.1; also elsewhere on the board
G_Q6: D26.2 (A), R119.2, R121.1; also elsewhere on the board
G_Q7: D27.2 (A), R123.2, R125.1; also elsewhere on the board
G_Q8: D28.2 (A), R126.2, R128.1; also elsewhere on the board
KS_Q1: C103.2, C104.2, C105.1, C106.1, PS1.6 (COM), R104.2; also elsewhere on the board
KS_Q2: C108.2, C109.2, C110.1, C111.1, PS2.6 (COM), R107.2; also elsewhere on the board
KS_Q3: C114.2, C115.2, C116.1, C117.1, PS3.6 (COM), R111.2; also elsewhere on the board
KS_Q4: C119.2, C120.2, C121.1, C122.1, PS4.6 (COM), R114.2; also elsewhere on the board
KS_Q5: C125.2, C126.2, C127.1, C128.1, PS5.6 (COM), R118.2; also elsewhere on the board
KS_Q6: C130.2, C131.2, C132.1, C133.1, PS6.6 (COM), R121.2; also elsewhere on the board
KS_Q7: C136.2, C137.2, C138.1, C139.1, PS7.6 (COM), R125.2; also elsewhere on the board
KS_Q8: C141.2, C142.2, C143.1, C144.1, PS8.6 (COM), R128.2; also elsewhere on the board
PROT_DIS: U1.5 (DIS), U2.5 (DIS), U3.5 (DIS), U4.5 (DIS); also elsewhere on the board
PWM1A: U1.1 (INA); also elsewhere on the board
PWM1B: U1.2 (INB); also elsewhere on the board
PWM2A: U2.1 (INA); also elsewhere on the board
PWM2B: U2.2 (INB); also elsewhere on the board
PWM3A: U3.1 (INA); also elsewhere on the board
PWM3B: U3.2 (INB); also elsewhere on the board
PWM4A: U4.1 (INA); also elsewhere on the board
PWM4B: U4.2 (INB); also elsewhere on the board
RGOFF_Q1: D21.1 (K), R103.2
RGOFF_Q2: D22.1 (K), R106.2
RGOFF_Q3: D23.1 (K), R110.2
RGOFF_Q4: D24.1 (K), R113.2
RGOFF_Q5: D25.1 (K), R117.2
RGOFF_Q6: D26.1 (K), R120.2
RGOFF_Q7: D27.1 (K), R124.2
RGOFF_Q8: D28.1 (K), R127.2
VDD_Q1: C103.1, C104.1, PS1.7 (+VOUT), U1.14 (VDDA)
VDD_Q2: C108.1, C109.1, PS2.7 (+VOUT), U1.11 (VDDB)
VDD_Q3: C114.1, C115.1, PS3.7 (+VOUT), U2.14 (VDDA)
VDD_Q4: C119.1, C120.1, PS4.7 (+VOUT), U2.11 (VDDB)
VDD_Q5: C125.1, C126.1, PS5.7 (+VOUT), U3.14 (VDDA)
VDD_Q6: C130.1, C131.1, PS6.7 (+VOUT), U3.11 (VDDB)
VDD_Q7: C136.1, C137.1, PS7.7 (+VOUT), U4.14 (VDDA)
VDD_Q8: C141.1, C142.1, PS8.7 (+VOUT), U4.11 (VDDB)
VEE_Q1: C105.2, C106.2, PS1.5 (-VOUT), U1.16 (VSSA)
VEE_Q2: C110.2, C111.2, PS2.5 (-VOUT), U1.9 (VSSB)
VEE_Q3: C116.2, C117.2, PS3.5 (-VOUT), U2.16 (VSSA)
VEE_Q4: C121.2, C122.2, PS4.5 (-VOUT), U2.9 (VSSB)
VEE_Q5: C127.2, C128.2, PS5.5 (-VOUT), U3.16 (VSSA)
VEE_Q6: C132.2, C133.2, PS6.5 (-VOUT), U3.9 (VSSB)
VEE_Q7: C138.2, C139.2, PS7.5 (-VOUT), U4.16 (VSSA)
VEE_Q8: C143.2, C144.2, PS8.5 (-VOUT), U4.9 (VSSB)

Notes on the sheet:
Isolated dual gate driver U1 for Q1 (high side) / Q2 (low side), fault disable via PROT_DIS
Q1 isolated bias (+15 V / -3 V) and gate network
Q2 isolated bias (+15 V / -3 V) and gate network
Isolated dual gate driver U2 for Q3 (high side) / Q4 (low side), fault disable via PROT_DIS
Q3 isolated bias (+15 V / -3 V) and gate network
Q4 isolated bias (+15 V / -3 V) and gate network
Isolated dual gate driver U3 for Q5 (high side) / Q6 (low side), fault disable via PROT_DIS
Q5 isolated bias (+15 V / -3 V) and gate network
Q6 isolated bias (+15 V / -3 V) and gate network
Isolated dual gate driver U4 for Q7 (high side) / Q8 (low side), fault disable via PROT_DIS
Q7 isolated bias (+15 V / -3 V) and gate network
Q8 isolated bias (+15 V / -3 V) and gate network

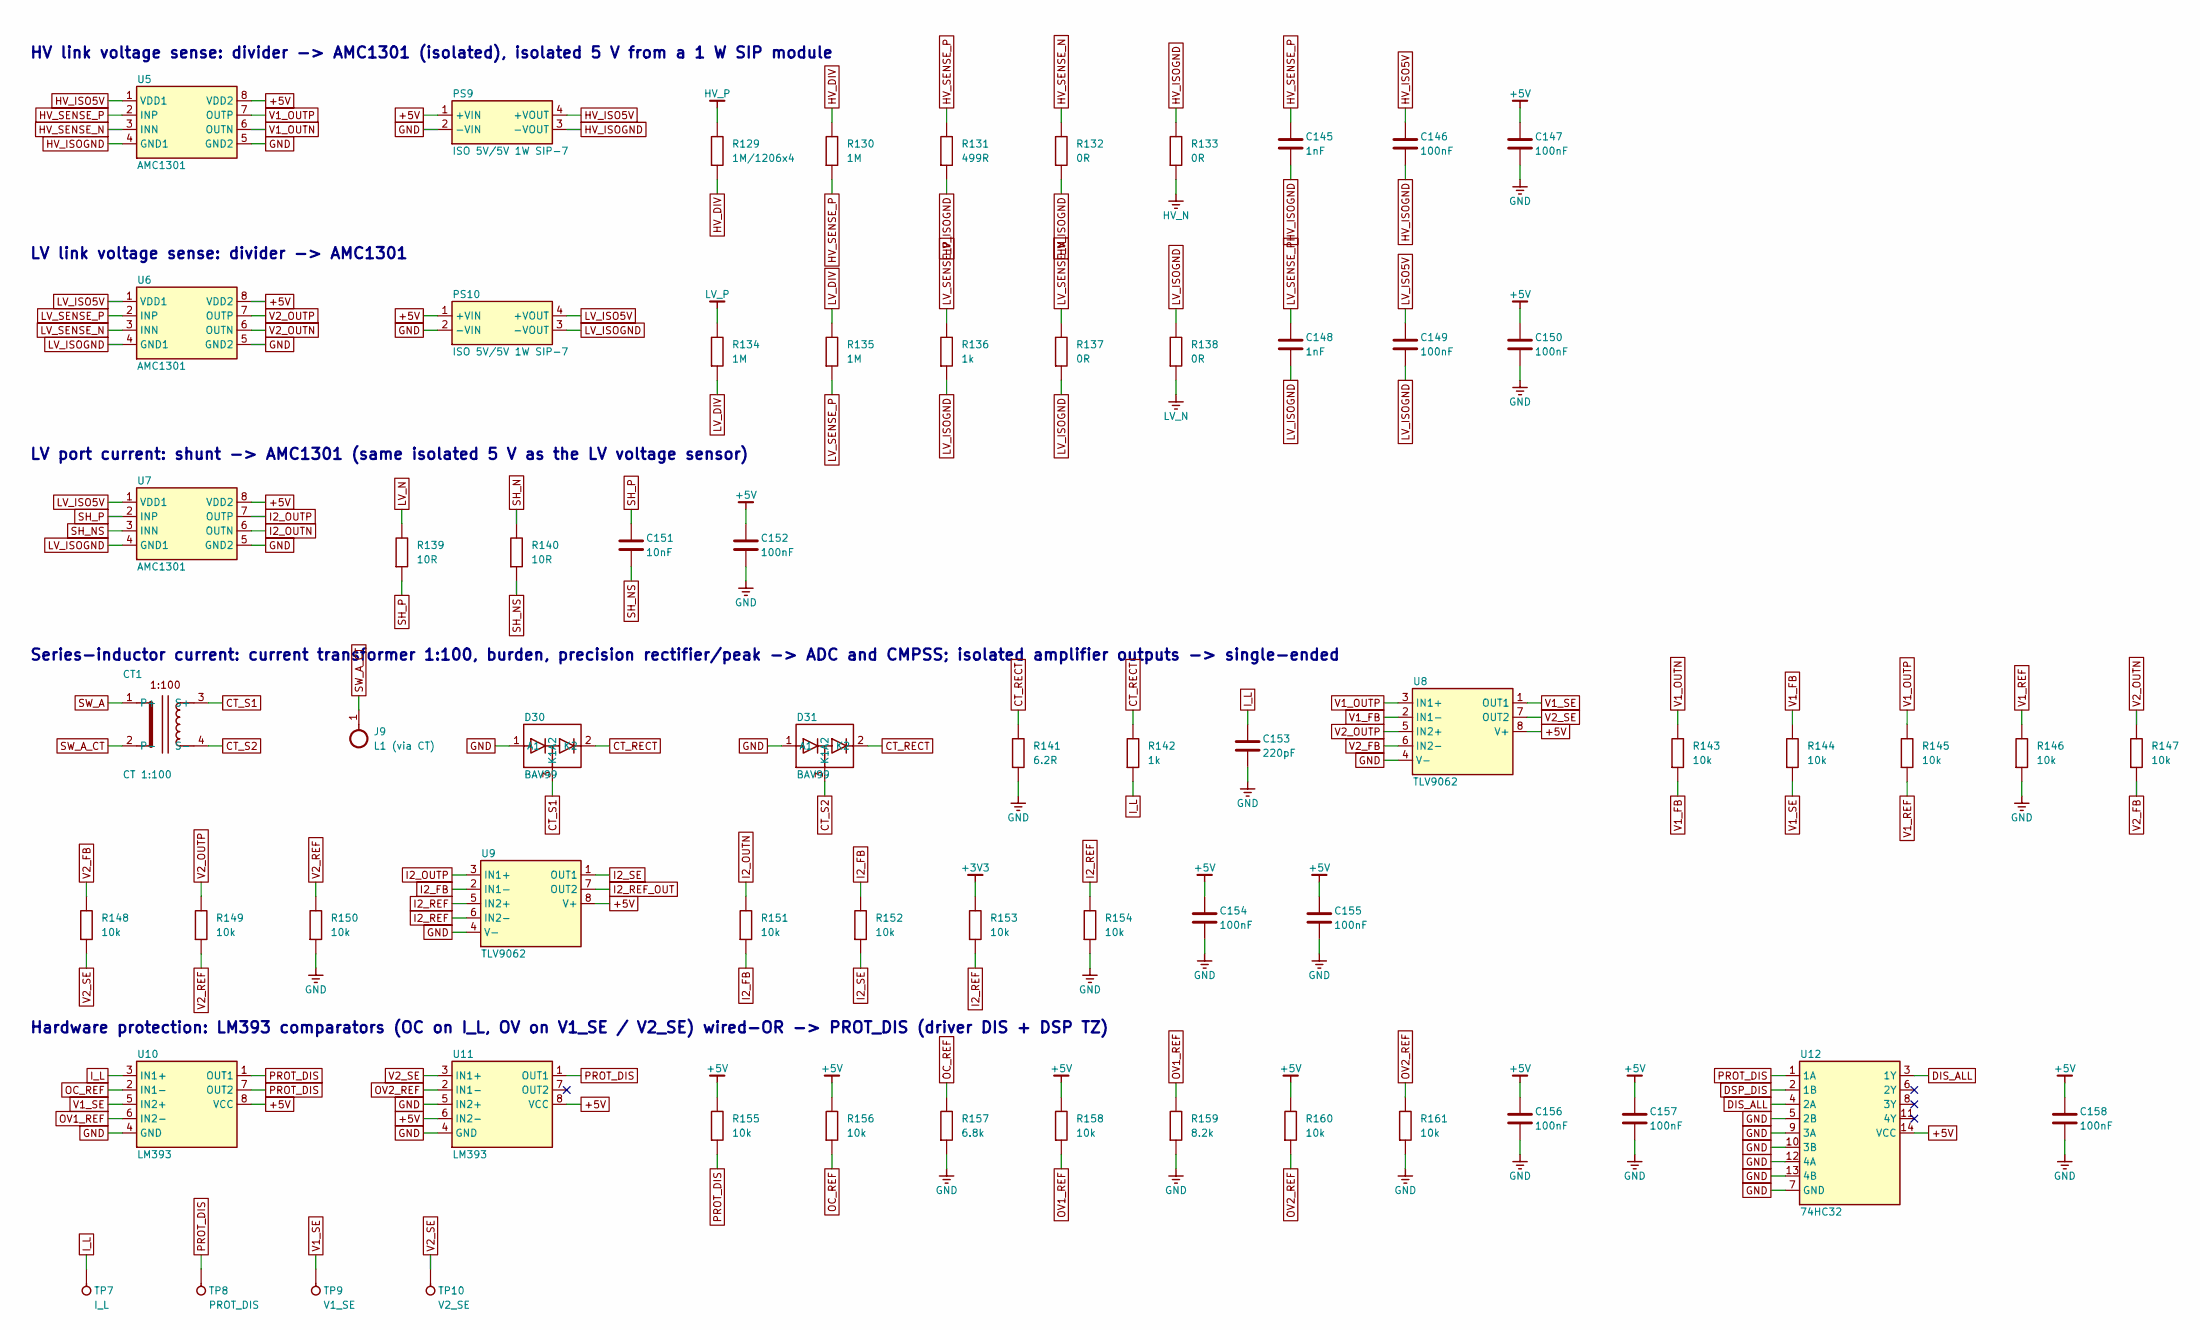
[picture p149: schematic sensing_protection.kicad_sch, SiC 6.6 kW Bidirectional Dual Active Bridge, 800 V / 400 V]

Parts:
C145, C148: 1nF; C_0603
C146, C147, C149, C150, C152, C154, C155, C156, C157, C158: 100nF; C_0603
C151: 10nF; C_0603
C153: 220pF; C_0603
CT1: CT 1:100; CT_Toroid_Straddle; MPN Magnetics ZW42908TC + 100T AWG32
D30, D31: BAV99; SOT-23
J9: L1 (via CT); Stud_M6
PS9: ISO 5V/5V 1W SIP-7; SIP-7_IsoDCDC_1W; MPN TBD - 1 W 5 V->5 V isolated module, SIP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
PS10: ISO 5V/5V 1W SIP-7; SIP-7_IsoDCDC_1W; MPN TBD - as PS9
R129: 1M/1206x4; R_1206
R130, R134, R135: 1M; R_1206
R131: 499R; R_0603
R132, R137: 0R; R_0603
R133, R138: 0R; R_0805
R136, R142: 1k; R_0603
R139, R140: 10R; R_0603
R141: 6.2R; R_0805
R143, R144, R145, R146, R147, R148, R149, R150, R151, R152, R153, R154, R155, R156, R158, R160, R161: 10k; R_0603
R157: 6.8k; R_0603
R159: 8.2k; R_0603
TP7: I_L; TestPoint
TP8: PROT_DIS; TestPoint
TP9: V1_SE; TestPoint
TP10: V2_SE; TestPoint
U5, U6, U7: AMC1301; SOIC-8W; MPN TI AMC1301DWV
U8, U9: TLV9062; SOIC-8; MPN TI TLV9062IDR
U10, U11: LM393; SOIC-8; MPN TI LM393DR
U12: 74HC32; SOIC-14; MPN TI SN74HC32D

Connections:
+3V3: R153.1; also elsewhere on the board
+5V: C147.1, C150.1, C152.1, C154.1, C155.1, C156.1, C157.1, C158.1, PS9.1 (+VIN), PS10.1 (+VIN), R155.1, R156.1, R158.1, R160.1, U5.8 (VDD2), U6.8 (VDD2), U7.8 (VDD2), U8.8 (V+), U9.8 (V+), U10.8 (VCC), U11.6 (IN2-), U11.8 (VCC), U12.14 (VCC); also elsewhere on the board
CT_RECT: D30.2 (K2), D31.2 (K2), R141.1, R142.1
CT_S1: CT1.3 (S+), D30.3 (K1A2)
CT_S2: CT1.4 (S-), D31.3 (K1A2)
DIS_ALL: U12.3 (1Y), U12.4 (2A)
DSP_DIS: U12.2 (1B); also elsewhere on the board
GND: C147.2, C150.2, C152.2, C153.2, C154.2, C155.2, C156.2, C157.2, C158.2, D30.1 (A1), D31.1 (A1), PS9.2 (-VIN), PS10.2 (-VIN), R141.2, R146.2, R150.2, R154.2, R157.2, R159.2, R161.2, U5.5 (GND2), U6.5 (GND2), U7.5 (GND2), U8.4 (V-), U9.4 (V-), U10.4 (GND), U11.4 (GND), U11.5 (IN2+), U12.5 (2B), U12.7 (GND), U12.9 (3A), U12.10 (3B), U12.12 (4A), U12.13 (4B); also elsewhere on the board
HV_DIV: R129.2, R130.1
HV_ISO5V: C146.1, PS9.4 (+VOUT), U5.1 (VDD1)
HV_ISOGND: C145.2, C146.2, PS9.3 (-VOUT), R131.2, R132.2, R133.1, U5.4 (GND1)
HV_N: R133.2; also elsewhere on the board
HV_P: R129.1; also elsewhere on the board
HV_SENSE_N: R132.1, U5.3 (INN)
HV_SENSE_P: C145.1, R130.2, R131.1, U5.2 (INP)
I2_FB: R151.2, R152.1, U9.2 (IN1-)
I2_OUTN: R151.1, U7.6 (OUTN)
I2_OUTP: U7.7 (OUTP), U9.3 (IN1+)
I2_REF: R153.2, R154.1, U9.5 (IN2+), U9.6 (IN2-)
I2_REF_OUT: U9.7 (OUT2)
I2_SE: R152.2, U9.1 (OUT1); also elsewhere on the board
I_L: C153.1, R142.2, TP7.1, U10.3 (IN1+); also elsewhere on the board
LV_DIV: R134.2, R135.1
LV_ISO5V: C149.1, PS10.4 (+VOUT), U6.1 (VDD1), U7.1 (VDD1)
LV_ISOGND: C148.2, C149.2, PS10.3 (-VOUT), R136.2, R137.2, R138.1, U6.4 (GND1), U7.4 (GND1)
LV_N: R138.2, R139.1; also elsewhere on the board
LV_P: R134.1; also elsewhere on the board
LV_SENSE_N: R137.1, U6.3 (INN)
LV_SENSE_P: C148.1, R135.2, R136.1, U6.2 (INP)
OC_REF: R156.2, R157.1, U10.2 (IN1-)
OV1_REF: R158.2, R159.1, U10.6 (IN2-)
OV2_REF: R160.2, R161.1, U11.2 (IN1-)
PROT_DIS: R155.2, TP8.1, U10.1 (OUT1), U10.7 (OUT2), U11.1 (OUT1), U12.1 (1A); also elsewhere on the board
SH_N: R140.1; also elsewhere on the board
SH_NS: C151.2, R140.2, U7.3 (INN)
SH_P: C151.1, R139.2, U7.2 (INP)
SW_A: CT1.1 (P+); also elsewhere on the board
SW_A_CT: CT1.2 (P-), J9.1
V1_FB: R143.2, R144.1, U8.2 (IN1-)
V1_OUTN: R143.1, U5.6 (OUTN)
V1_OUTP: R145.1, U5.7 (OUTP), U8.3 (IN1+)
V1_REF: R145.2, R146.1
V1_SE: R144.2, TP9.1, U8.1 (OUT1), U10.5 (IN2+); also elsewhere on the board
V2_FB: R147.2, R148.1, U8.6 (IN2-)
V2_OUTN: R147.1, U6.6 (OUTN)
V2_OUTP: R149.1, U6.7 (OUTP), U8.5 (IN2+)
V2_REF: R149.2, R150.1
V2_SE: R148.2, TP10.1, U8.7 (OUT2), U11.3 (IN1+); also elsewhere on the board

Notes on the sheet:
HV link voltage sense: divider -> AMC1301 (isolated), isolated 5 V from a 1 W SIP module
LV link voltage sense: divider -> AMC1301
LV port current: shunt -> AMC1301 (same isolated 5 V as the LV voltage sensor)
Series-inductor current: current transformer 1:100, burden, precision rectifier/peak -> ADC and CMPSS; isolated amplifier outputs -> single-ended
Hardware protection: LM393 comparators (OC on I_L, OV on V1_SE / V2_SE) wired-OR -> PROT_DIS (driver DIS + DSP TZ)

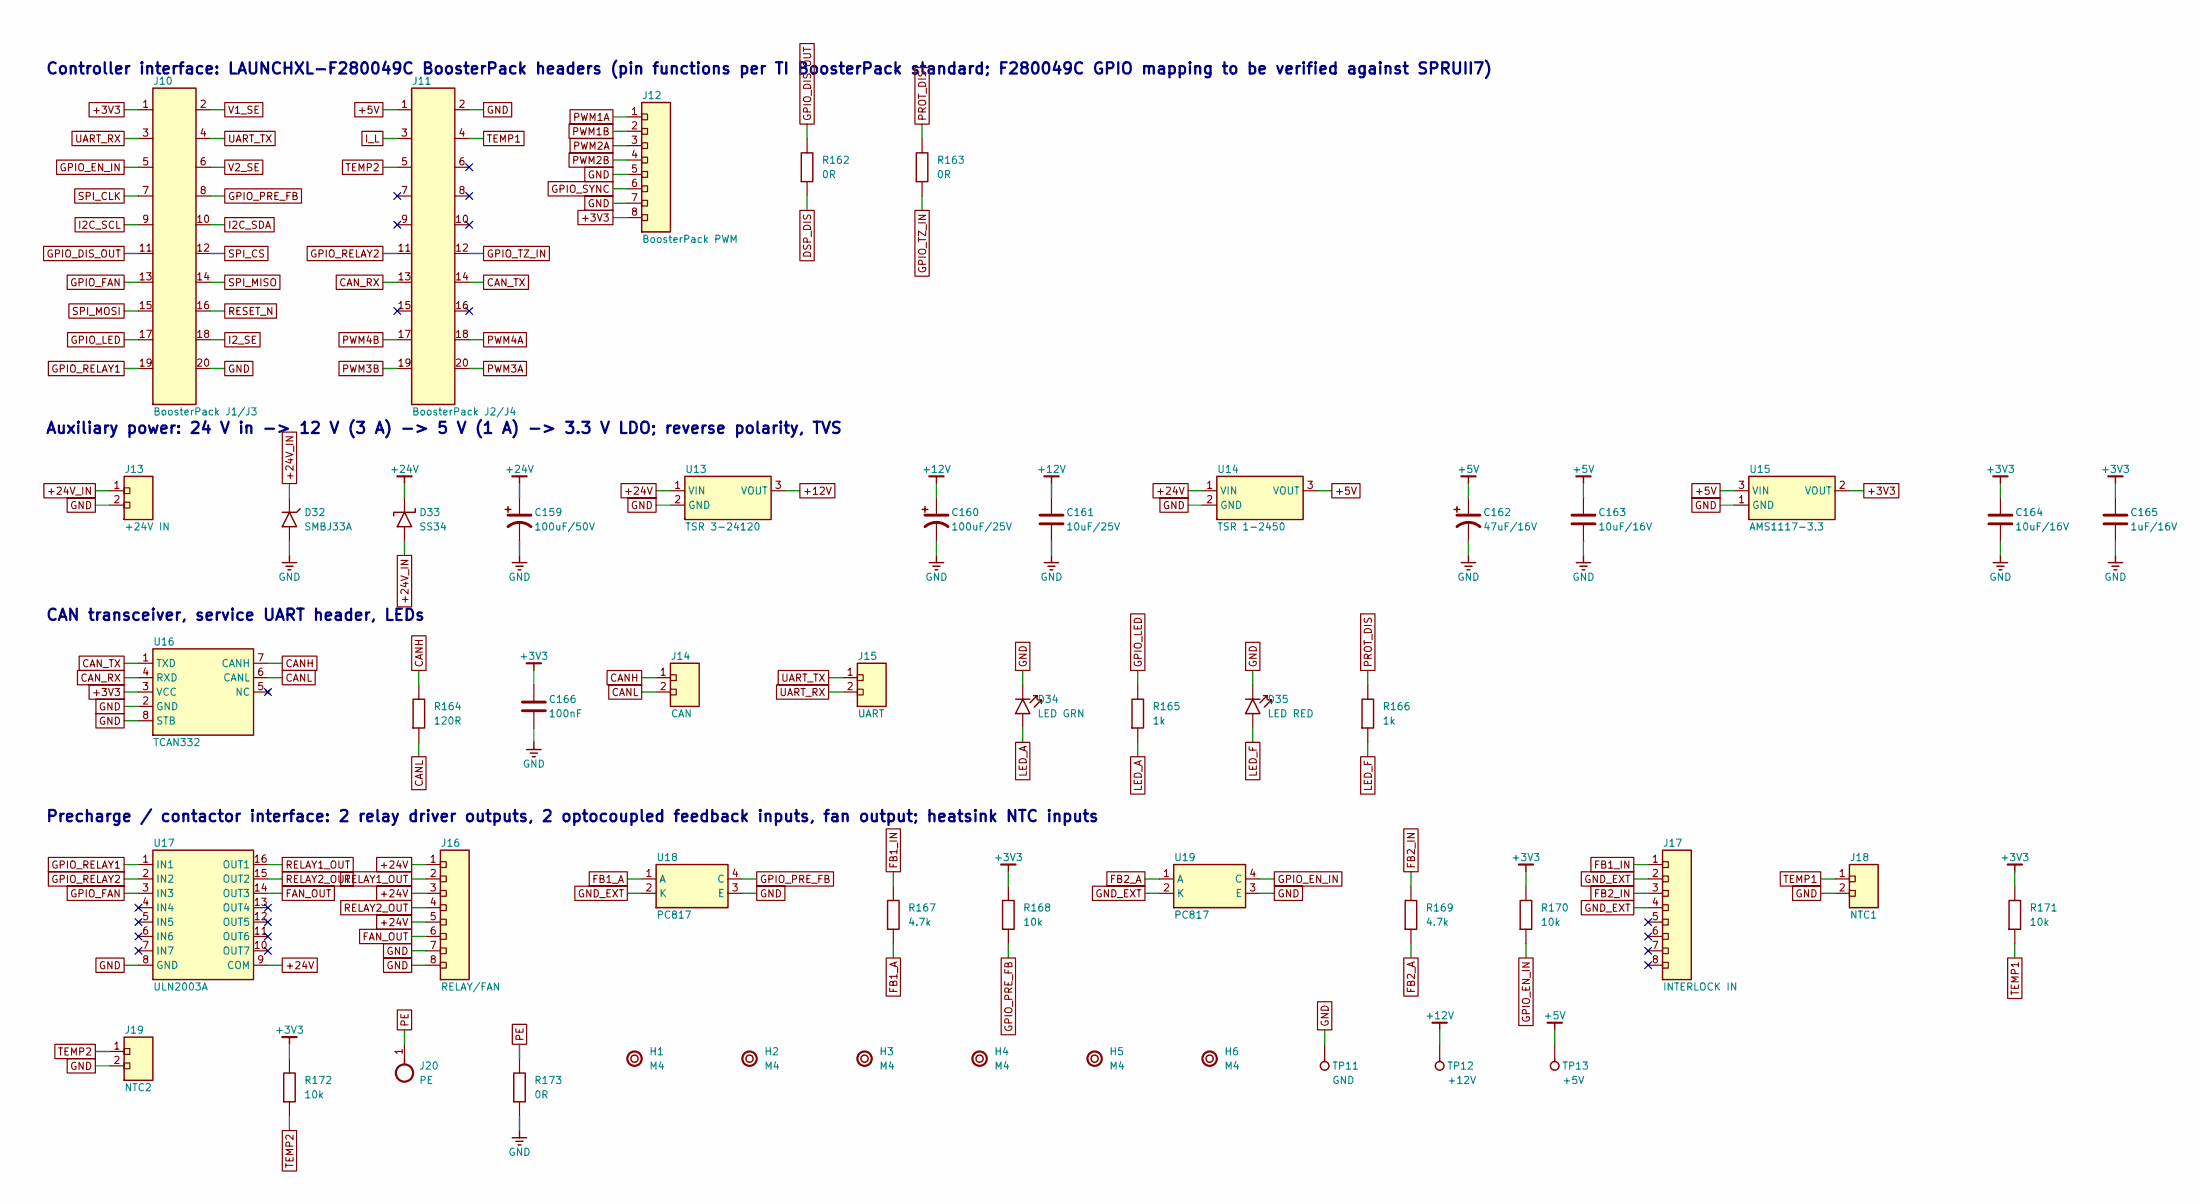
[picture p150: schematic control_aux.kicad_sch, SiC 6.6 kW Bidirectional Dual Active Bridge, 800 V / 400 V]

Parts:
C159: 100uF/50V; C_Radial_D8_P3.5
C160: 100uF/25V; C_Radial_D8_P3.5
C161: 10uF/25V; C_1206
C162: 47uF/16V; C_Radial_D8_P3.5
C163, C164: 10uF/16V; C_1206
C165: 1uF/16V; C_0603
C166: 100nF; C_0603
D32: SMBJ33A; D_SMA; MPN Littelfuse SMBJ33A
D33: SS34; D_SMA; MPN Vishay SS34
D34: LED GRN; LED_0805
D35: LED RED; LED_0805
H1, H2, H3, H4, H5, H6: M4; MountingHole_M4
J10: BoosterPack J1/J3; PinHeader_2x10_P2.54; MPN Samtec SSW-110-01-G-D class
J11: BoosterPack J2/J4; PinHeader_2x10_P2.54; MPN Samtec SSW-110-01-G-D class
J12: BoosterPack PWM; PinHeader_1x08_P2.54
J13: +24V IN; TerminalBlock_1x02_P5.08
J14: CAN; TerminalBlock_1x02_P5.08
J15: UART; PinHeader_1x02_P2.54
J16: RELAY/FAN; PinHeader_1x08_P2.54
J17: INTERLOCK IN; PinHeader_1x08_P2.54
J18: NTC1; PinHeader_1x02_P2.54
J19: NTC2; PinHeader_1x02_P2.54
J20: PE; Lug_M5
R162, R163: 0R; R_0603
R164: 120R; R_0603
R165, R166: 1k; R_0603
R167, R169: 4.7k; R_0805
R168, R170, R171, R172: 10k; R_0603
R173: 0R; R_1206
TP11: GND; TestPoint
TP12: +12V; TestPoint
TP13: +5V; TestPoint
U13: TSR 3-24120; SIP-3_TSR; MPN TRACO TSR 3-24120
U14: TSR 1-2450; SIP-3_TSR; MPN TRACO TSR 1-2450
U15: AMS1117-3.3; SOT-223; MPN AMS1117-3.3
U16: TCAN332; SOIC-8; MPN TI TCAN332D
U17: ULN2003A; SOIC-16; MPN TI ULN2003AD
U18, U19: PC817; DIP-4; MPN Sharp PC817

Connections:
+3V3: C164.1, C165.1, C166.1, J10.1, J12.8, R168.1, R170.1, R171.1, R172.1, U15.2 (VOUT), U16.3 (VCC); also elsewhere on the board
+5V: C162.1 (+), C163.1, J11.1, TP13.1, U14.3 (VOUT), U15.3 (VIN); also elsewhere on the board
+12V: C160.1 (+), C161.1, TP12.1, U13.3 (VOUT); also elsewhere on the board
+24V: C159.1 (+), D33.1 (K), J16.1, J16.3, J16.5, U13.1 (VIN), U14.1 (VIN), U17.9 (COM)
+24V_IN: D32.1 (K), D33.2 (A), J13.1
CANH: J14.1, R164.1, U16.7 (CANH)
CANL: J14.2, R164.2, U16.6 (CANL)
CAN_RX: J11.13, U16.4 (RXD)
CAN_TX: J11.14, U16.1 (TXD)
DSP_DIS: R162.2; also elsewhere on the board
FAN_OUT: J16.6, U17.14 (OUT3)
FB1_A: R167.2, U18.1 (A)
FB1_IN: J17.1, R167.1
FB2_A: R169.2, U19.1 (A)
FB2_IN: J17.3, R169.1
GND: C159.2 (-), C160.2 (-), C161.2, C162.2 (-), C163.2, C164.2, C165.2, C166.2, D32.2 (A), D34.1 (K), D35.1 (K), J10.20, J11.2, J12.5, J12.7, J13.2, J16.7, J16.8, J18.2, J19.2, R173.2, TP11.1, U13.2 (GND), U14.2 (GND), U15.1 (GND), U16.2 (GND), U16.8 (STB), U17.8 (GND), U18.3 (E), U19.3 (E); also elsewhere on the board
GND_EXT: J17.2, J17.4, U18.2 (K), U19.2 (K)
GPIO_DIS_OUT: J10.11, R162.1
GPIO_EN_IN: J10.5, R170.2, U19.4 (C)
GPIO_FAN: J10.13, U17.3 (IN3)
GPIO_LED: J10.17, R165.1
GPIO_PRE_FB: J10.8, R168.2, U18.4 (C)
GPIO_RELAY1: J10.19, U17.1 (IN1)
GPIO_RELAY2: J11.11, U17.2 (IN2)
GPIO_SYNC: J12.6
GPIO_TZ_IN: J11.12, R163.2
I2C_SCL: J10.9
I2C_SDA: J10.10
I2_SE: J10.18; also elsewhere on the board
I_L: J11.3; also elsewhere on the board
LED_A: D34.2 (A), R165.2
LED_F: D35.2 (A), R166.2
PE: J20.1, R173.1
PROT_DIS: R163.1, R166.1; also elsewhere on the board
PWM1A: J12.1; also elsewhere on the board
PWM1B: J12.2; also elsewhere on the board
PWM2A: J12.3; also elsewhere on the board
PWM2B: J12.4; also elsewhere on the board
PWM3A: J11.20; also elsewhere on the board
PWM3B: J11.19; also elsewhere on the board
PWM4A: J11.18; also elsewhere on the board
PWM4B: J11.17; also elsewhere on the board
RELAY1_OUT: J16.2, U17.16 (OUT1)
RELAY2_OUT: J16.4, U17.15 (OUT2)
RESET_N: J10.16
SPI_CLK: J10.7
SPI_CS: J10.12
SPI_MISO: J10.14
SPI_MOSI: J10.15
TEMP1: J11.4, J18.1, R171.2
TEMP2: J11.5, J19.1, R172.2
UART_RX: J10.3, J15.2
UART_TX: J10.4, J15.1
V1_SE: J10.2; also elsewhere on the board
V2_SE: J10.6; also elsewhere on the board

Notes on the sheet:
Controller interface: LAUNCHXL-F280049C BoosterPack headers (pin functions per TI BoosterPack standard; F280049C GPIO mapping to be verified against SPRUII7)
Auxiliary power: 24 V in -> 12 V (3 A) -> 5 V (1 A) -> 3.3 V LDO; reverse polarity, TVS
CAN transceiver, service UART header, LEDs
Precharge / contactor interface: 2 relay driver outputs, 2 optocoupled feedback inputs, fan output; heatsink NTC inputs
