murugan-paramesh/SiC-DC-DC-Converter/SiC_6k6_Industrial_DAB/07_KiCad_Schematics/SiC_DAB_6k6.kicad_pcb

## KiCad design SiC_6k6_Industrial_DAB/07_KiCad_Schematics/SiC_DAB_6k6.kicad_pcb (continued)

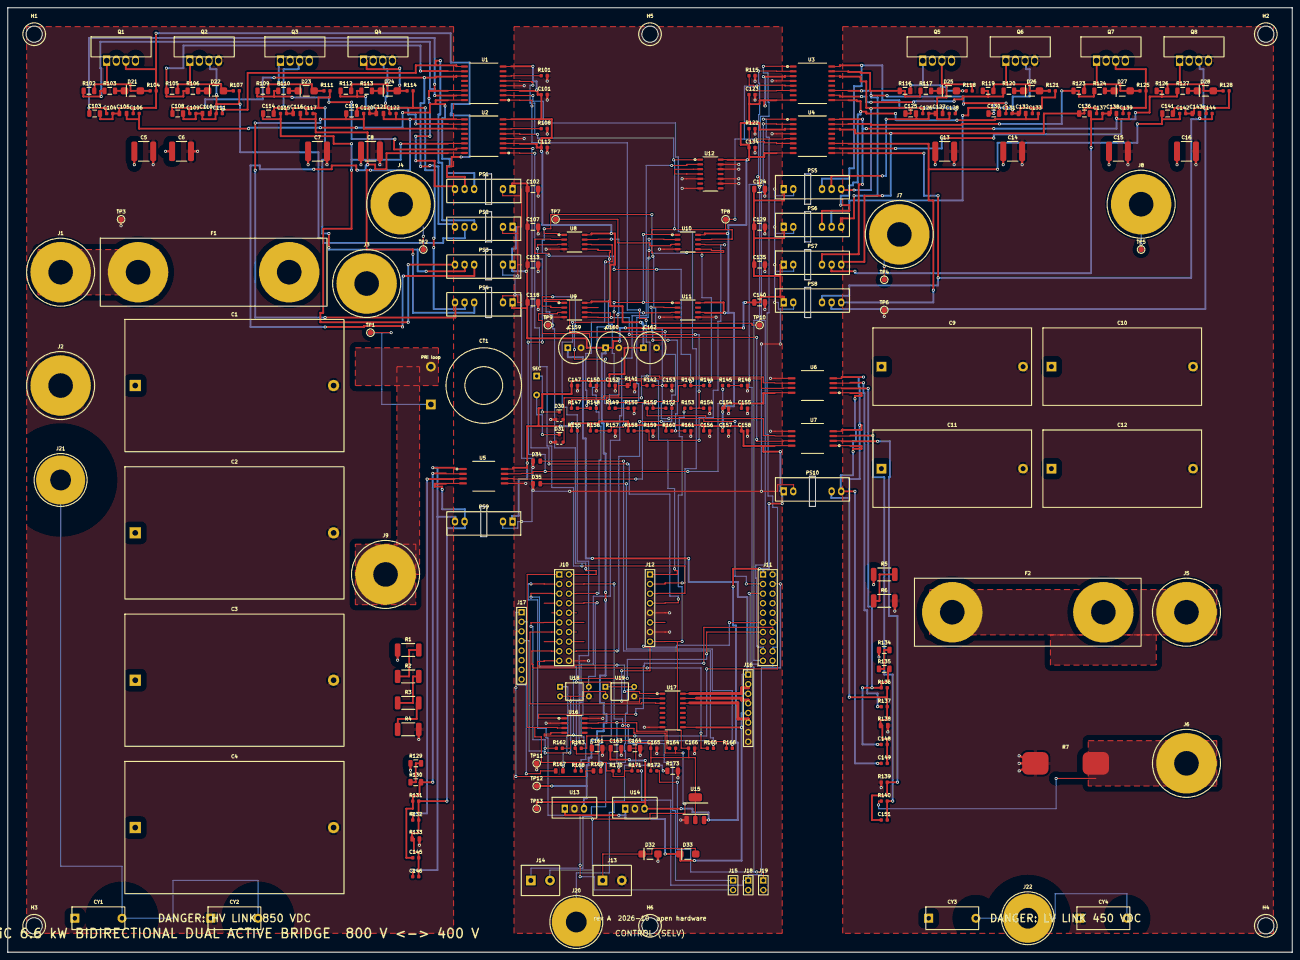
[picture p151: board SiC_DAB_6k6.kicad_pcb from above]

Board: 6 copper layers, 340.0 x 250.0 mm, 261 parts (0 on the bottom side), 148 nets.

Other parts of the board:
J21: PE_HV; Lug_M5
J22: PE_LV; Lug_M5

Their connections:
PE_HV: J21.1; also elsewhere on the board
PE_LV: J22.1; also elsewhere on the board
