murugan-paramesh/SiC-DC-DC-Converter/hardware/kicad/SiC_PSFB_3kW.kicad_pcb

## KiCad design hardware/kicad/SiC_PSFB_3kW.kicad_pcb (2026-10-09)

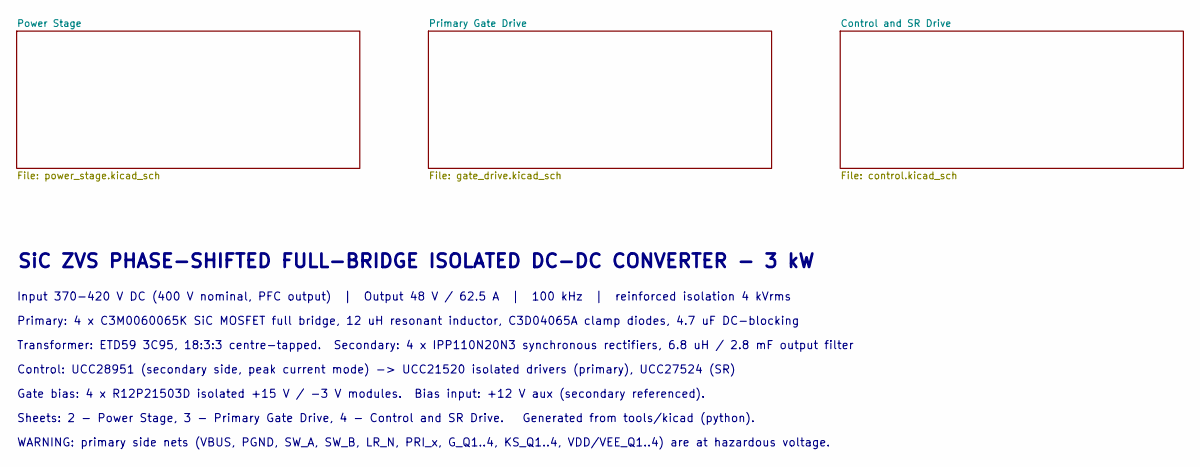
[picture p152: schematic SiC_PSFB_3kW.kicad_sch, SiC ZVS Phase-Shifted Full-Bridge 3 kW DC-DC]

Notes on the sheet:
SiC ZVS PHASE-SHIFTED FULL-BRIDGE ISOLATED DC-DC CONVERTER - 3 kW
Input 370-420 V DC (400 V nominal, PFC output) | Output 48 V / 62.5 A | 100 kHz | reinforced isolation 4 kVrms
Primary: 4 x C3M0060065K SiC MOSFET full bridge, 12 uH resonant inductor, C3D04065A clamp diodes, 4.7 uF DC-blocking
Transformer: ETD59 3C95, 18:3:3 centre-tapped. Secondary: 4 x IPP110N20N3 synchronous rectifiers, 6.8 uH / 2.8 mF output filter
Control: UCC28951 (secondary side, peak current mode) -> UCC21520 isolated drivers (primary), UCC27524 (SR)
Gate bias: 4 x R12P21503D isolated +15 V / -3 V modules. Bias input: +12 V aux (secondary referenced).
Sheets: 2 - Power Stage, 3 - Primary Gate Drive, 4 - Control and SR Drive. Generated from tools/kicad (python).
WARNING: primary side nets (VBUS, PGND, SW_A, SW_B, LR_N, PRI_x, G_Q1..4, KS_Q1..4, VDD/VEE_Q1..4) are at hazardous voltage.

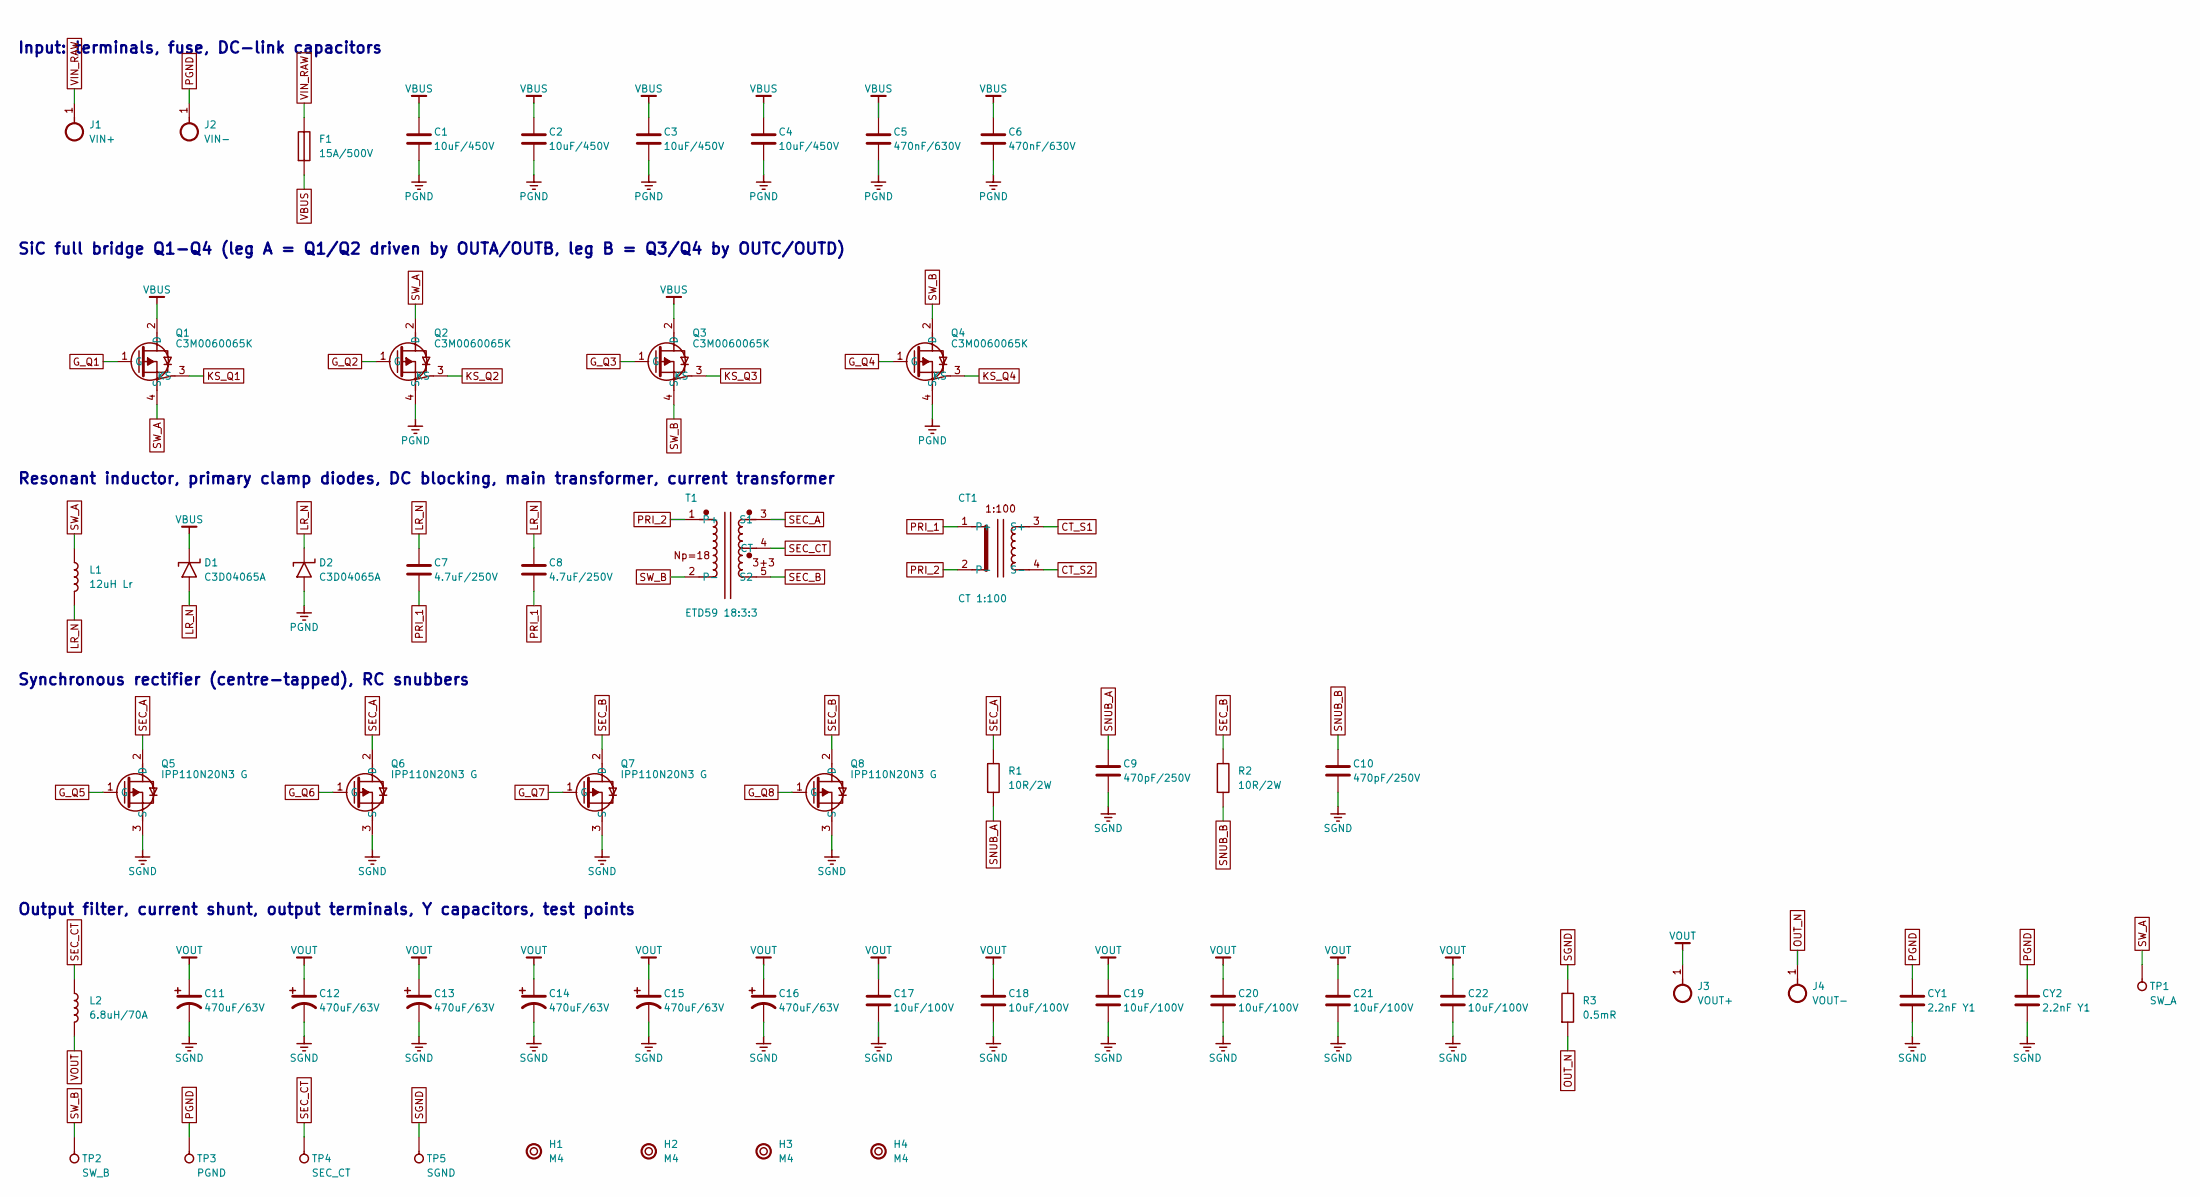
[picture p153: schematic power_stage.kicad_sch, SiC ZVS Phase-Shifted Full-Bridge 3 kW DC-DC]

Parts:
C1, C2, C3, C4: 10uF/450V; C_Film_P37.5; MPN TDK B32778G4106K
C5, C6: 470nF/630V; C_2220; MPN TDK CGA9P4X7T2J474K
C7, C8: 4.7uF/250V; C_Film_P22.5; MPN TDK B32674D3475K
C9, C10: 470pF/250V; C_1206
C11, C12, C13, C14, C15, C16: 470uF/63V; C_Radial_D16_P7.5; MPN Nichicon UHW1J471MHD
C17, C18, C19, C20, C21, C22: 10uF/100V; C_1210; MPN TDK CGA6P3X7S2A106K
CT1: CT 1:100; CT_Toroid_Straddle; MPN Magnetics ZW42908TC + 100T AWG32 (or Pu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
CY1, CY2: 2.2nF Y1; C_Y1_P12.5; MPN Vishay VY1222M63Y5UQ63V0
D1, D2: C3D04065A; TO-220-2_Vertical; MPN Wolfspeed C3D04065A
F1: 15A/500V; Fuse_6.3x32_Clips; MPN Littelfuse 0215015.MXP
H1, H2, H3, H4: M4; MountingHole_M4
J1: VIN+; Lug_M4
J2: VIN-; Lug_M4
J3: VOUT+; Lug_M5
J4: VOUT-; Lug_M5
L1: 12uH Lr; Inductor_ETD39_Lr; MPN custom ETD39/3C95 10T litz
L2: 6.8uH/70A; Inductor_Toroid_D52_Lo; MPN custom 2x Magnetics 77439-A7, 5T flat w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
Q1, Q2, Q3, Q4: C3M0060065K; TO-247-4_Vertical; MPN Wolfspeed C3M0060065K
Q5, Q6, Q7, Q8: IPP110N20N3 G; TO-220-3_Vertical; MPN Infineon IPP110N20N3 G
R1, R2: 10R/2W; R_2512
R3: 0.5mR; R_Shunt_8518; MPN Vishay WSBS8518L5000JK
T1: ETD59 18:3:3; Transformer_ETD59_PSFB; MPN custom, see docs/06
TP1: SW_A; TestPoint
TP2: SW_B; TestPoint
TP3: PGND; TestPoint
TP4: SEC_CT; TestPoint
TP5: SGND; TestPoint

Connections:
CT_S1: CT1.3 (S+); also elsewhere on the board
CT_S2: CT1.4 (S-); also elsewhere on the board
G_Q1: Q1.1 (G); also elsewhere on the board
G_Q2: Q2.1 (G); also elsewhere on the board
G_Q3: Q3.1 (G); also elsewhere on the board
G_Q4: Q4.1 (G); also elsewhere on the board
G_Q5: Q5.1 (G); also elsewhere on the board
G_Q6: Q6.1 (G); also elsewhere on the board
G_Q7: Q7.1 (G); also elsewhere on the board
G_Q8: Q8.1 (G); also elsewhere on the board
KS_Q1: Q1.3 (KS); also elsewhere on the board
KS_Q2: Q2.3 (KS); also elsewhere on the board
KS_Q3: Q3.3 (KS); also elsewhere on the board
KS_Q4: Q4.3 (KS); also elsewhere on the board
LR_N: C7.1, C8.1, D1.2 (A), D2.1 (K), L1.2
OUT_N: J4.1, R3.2; also elsewhere on the board
PGND: C1.2, C2.2, C3.2, C4.2, C5.2, C6.2, CY1.1, CY2.1, D2.2 (A), J2.1, Q2.4 (S), Q4.4 (S), TP3.1
PRI_1: C7.2, C8.2, CT1.1 (P+)
PRI_2: CT1.2 (P-), T1.1 (P+)
SEC_A: Q5.2 (D), Q6.2 (D), R1.1, T1.3 (S1)
SEC_B: Q7.2 (D), Q8.2 (D), R2.1, T1.5 (S2)
SEC_CT: L2.1, T1.4 (CT), TP4.1
SGND: C9.2, C10.2, C11.2 (-), C12.2 (-), C13.2 (-), C14.2 (-), C15.2 (-), C16.2 (-), C17.2, C18.2, C19.2, C20.2, C21.2, C22.2, CY1.2, CY2.2, Q5.3 (S), Q6.3 (S), Q7.3 (S), Q8.3 (S), R3.1, TP5.1; also elsewhere on the board
SNUB_A: C9.1, R1.2
SNUB_B: C10.1, R2.2
SW_A: L1.1, Q1.4 (S), Q2.2 (D), TP1.1
SW_B: Q3.4 (S), Q4.2 (D), T1.2 (P-), TP2.1
VBUS: C1.1, C2.1, C3.1, C4.1, C5.1, C6.1, D1.1 (K), F1.2, Q1.2 (D), Q3.2 (D)
VIN_RAW: F1.1, J1.1
VOUT: C11.1 (+), C12.1 (+), C13.1 (+), C14.1 (+), C15.1 (+), C16.1 (+), C17.1, C18.1, C19.1, C20.1, C21.1, C22.1, J3.1, L2.2; also elsewhere on the board

Notes on the sheet:
Input: terminals, fuse, DC-link capacitors
SiC full bridge Q1-Q4 (leg A = Q1/Q2 driven by OUTA/OUTB, leg B = Q3/Q4 by OUTC/OUTD)
Resonant inductor, primary clamp diodes, DC blocking, main transformer, current transformer
Synchronous rectifier (centre-tapped), RC snubbers
Output filter, current shunt, output terminals, Y capacitors, test points

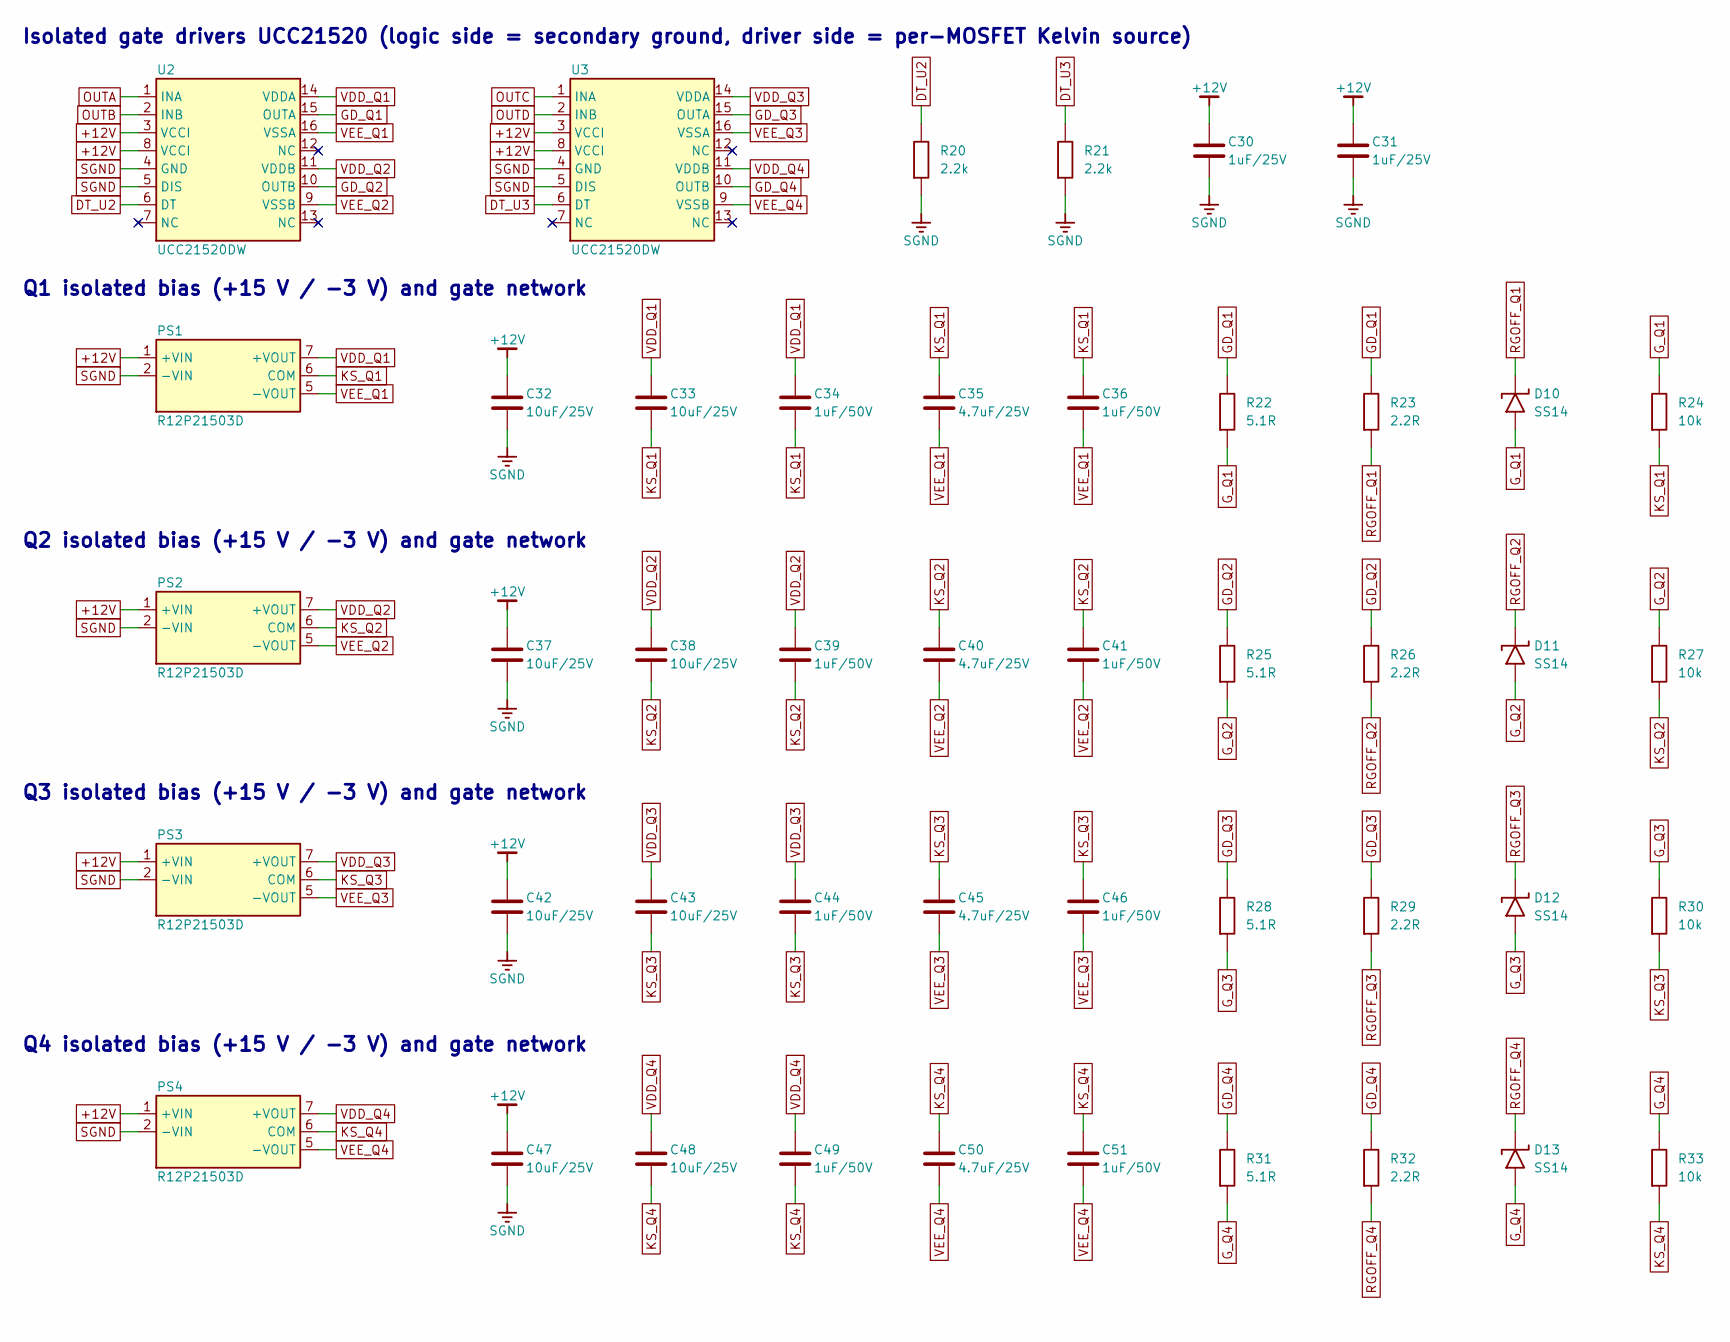
[picture p154: schematic gate_drive.kicad_sch, SiC ZVS Phase-Shifted Full-Bridge 3 kW DC-DC]

Parts:
C30, C31: 1uF/25V; C_0603
C32, C33, C37, C38, C42, C43, C47, C48: 10uF/25V; C_1206
C34, C36, C39, C41, C44, C46, C49, C51: 1uF/50V; C_0603
C35, C40, C45, C50: 4.7uF/25V; C_0805
D10, D11, D12, D13: SS14; D_SMA; MPN Vishay SS14
PS1, PS2, PS3, PS4: R12P21503D; SIP-7_IsoDCDC; MPN RECOM R12P21503D
R20, R21: 2.2k; R_0603
R22, R25, R28, R31: 5.1R; R_1206
R23, R26, R29, R32: 2.2R; R_1206
R24, R27, R30, R33: 10k; R_0603
U2, U3: UCC21520DW; SOIC-16W; MPN TI UCC21520DW

Connections:
+12V: C30.1, C31.1, C32.1, C37.1, C42.1, C47.1, PS1.1 (+VIN), PS2.1 (+VIN), PS3.1 (+VIN), PS4.1 (+VIN), U2.3 (VCCI), U2.8 (VCCI), U3.3 (VCCI), U3.8 (VCCI); also elsewhere on the board
DT_U2: R20.1, U2.6 (DT)
DT_U3: R21.1, U3.6 (DT)
GD_Q1: R22.1, R23.1, U2.15 (OUTA)
GD_Q2: R25.1, R26.1, U2.10 (OUTB)
GD_Q3: R28.1, R29.1, U3.15 (OUTA)
GD_Q4: R31.1, R32.1, U3.10 (OUTB)
G_Q1: D10.2 (A), R22.2, R24.1; also elsewhere on the board
G_Q2: D11.2 (A), R25.2, R27.1; also elsewhere on the board
G_Q3: D12.2 (A), R28.2, R30.1; also elsewhere on the board
G_Q4: D13.2 (A), R31.2, R33.1; also elsewhere on the board
KS_Q1: C33.2, C34.2, C35.1, C36.1, PS1.6 (COM), R24.2; also elsewhere on the board
KS_Q2: C38.2, C39.2, C40.1, C41.1, PS2.6 (COM), R27.2; also elsewhere on the board
KS_Q3: C43.2, C44.2, C45.1, C46.1, PS3.6 (COM), R30.2; also elsewhere on the board
KS_Q4: C48.2, C49.2, C50.1, C51.1, PS4.6 (COM), R33.2; also elsewhere on the board
OUTA: U2.1 (INA); also elsewhere on the board
OUTB: U2.2 (INB); also elsewhere on the board
OUTC: U3.1 (INA); also elsewhere on the board
OUTD: U3.2 (INB); also elsewhere on the board
RGOFF_Q1: D10.1 (K), R23.2
RGOFF_Q2: D11.1 (K), R26.2
RGOFF_Q3: D12.1 (K), R29.2
RGOFF_Q4: D13.1 (K), R32.2
SGND: C30.2, C31.2, C32.2, C37.2, C42.2, C47.2, PS1.2 (-VIN), PS2.2 (-VIN), PS3.2 (-VIN), PS4.2 (-VIN), R20.2, R21.2, U2.4 (GND), U2.5 (DIS), U3.4 (GND), U3.5 (DIS); also elsewhere on the board
VDD_Q1: C33.1, C34.1, PS1.7 (+VOUT), U2.14 (VDDA)
VDD_Q2: C38.1, C39.1, PS2.7 (+VOUT), U2.11 (VDDB)
VDD_Q3: C43.1, C44.1, PS3.7 (+VOUT), U3.14 (VDDA)
VDD_Q4: C48.1, C49.1, PS4.7 (+VOUT), U3.11 (VDDB)
VEE_Q1: C35.2, C36.2, PS1.5 (-VOUT), U2.16 (VSSA)
VEE_Q2: C40.2, C41.2, PS2.5 (-VOUT), U2.9 (VSSB)
VEE_Q3: C45.2, C46.2, PS3.5 (-VOUT), U3.16 (VSSA)
VEE_Q4: C50.2, C51.2, PS4.5 (-VOUT), U3.9 (VSSB)

Notes on the sheet:
Isolated gate drivers UCC21520 (logic side = secondary ground, driver side = per-MOSFET Kelvin source)
Q1 isolated bias (+15 V / -3 V) and gate network
Q2 isolated bias (+15 V / -3 V) and gate network
Q3 isolated bias (+15 V / -3 V) and gate network
Q4 isolated bias (+15 V / -3 V) and gate network

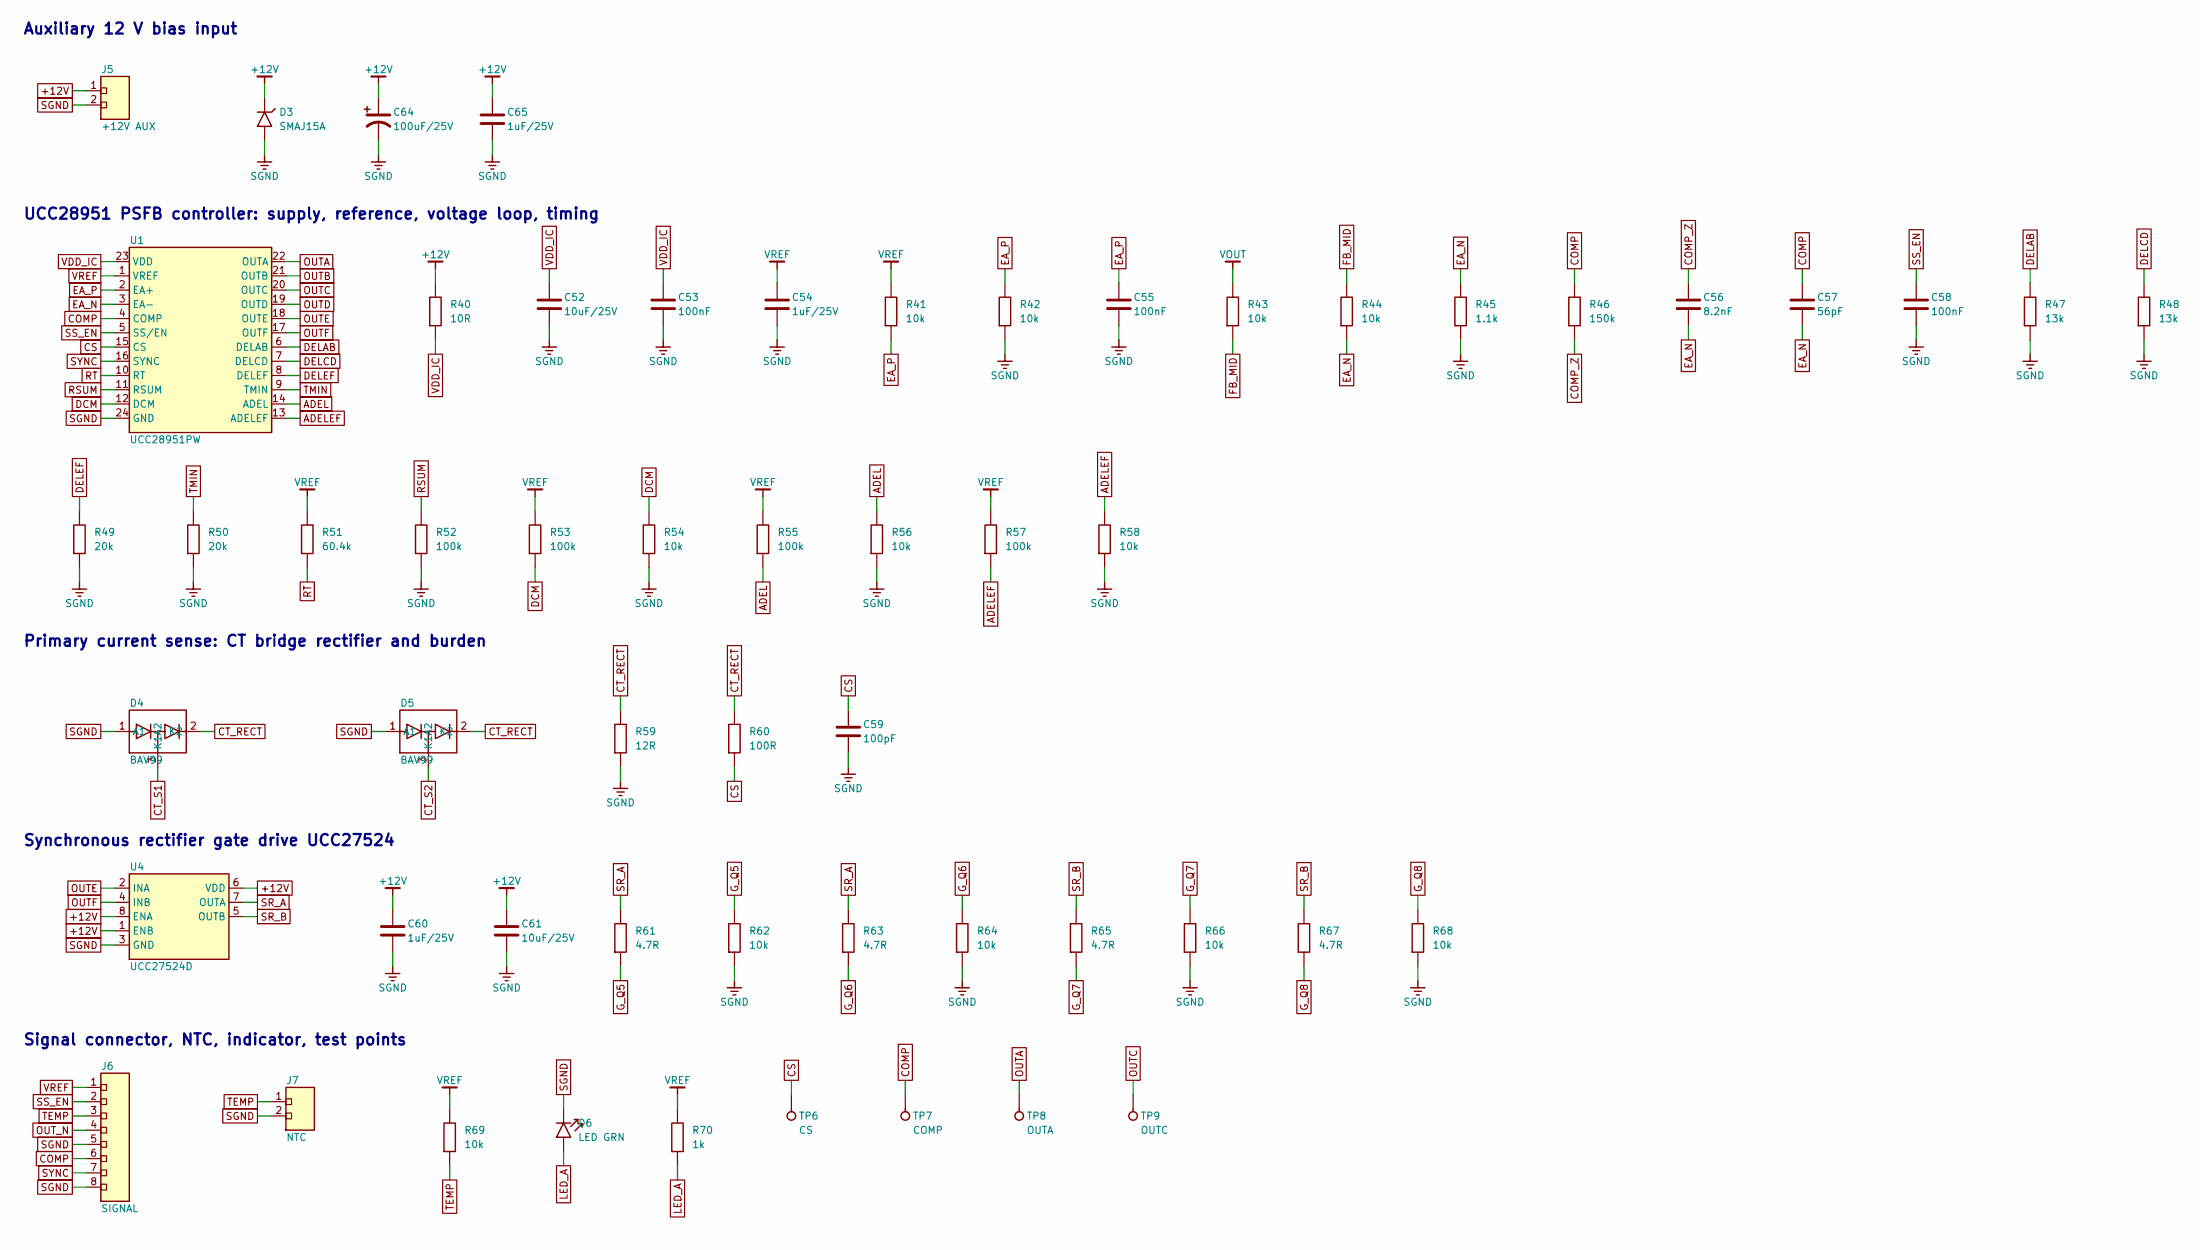
[picture p155: schematic control.kicad_sch, SiC ZVS Phase-Shifted Full-Bridge 3 kW DC-DC]

Parts:
C52, C61: 10uF/25V; C_1206
C53, C55, C58: 100nF; C_0603
C54, C60, C65: 1uF/25V; C_0603
C56: 8.2nF; C_0603
C57: 56pF; C_0603
C59: 100pF; C_0603
C64: 100uF/25V; C_Radial_D8_P3.5
D3: SMAJ15A; D_SMA; MPN Littelfuse SMAJ15A
D4, D5: BAV99; SOT-23
D6: LED GRN; LED_0805
J5: +12V AUX; TerminalBlock_1x02_P5.08
J6: SIGNAL; PinHeader_1x08_P2.54
J7: NTC; PinHeader_1x02_P2.54
R40: 10R; R_0805
R41, R42, R54, R56, R58, R62, R64, R66, R68, R69: 10k; R_0603
R43, R44: 10k; R_0805
R45: 1.1k; R_0603
R46: 150k; R_0603
R47, R48: 13k; R_0603
R49, R50: 20k; R_0603
R51: 60.4k; R_0603
R52, R53, R55, R57: 100k; R_0603
R59: 12R; R_0805
R60: 100R; R_0603
R61, R63, R65, R67: 4.7R; R_0805
R70: 1k; R_0603
TP6: CS; TestPoint
TP7: COMP; TestPoint
TP8: OUTA; TestPoint
TP9: OUTC; TestPoint
U1: UCC28951PW; TSSOP-24; MPN TI UCC28951PW
U4: UCC27524D; SOIC-8; MPN TI UCC27524D

Connections:
+12V: C60.1, C61.1, C64.1 (+), C65.1, D3.1 (K), J5.1, R40.1, U4.1 (ENB), U4.6 (VDD), U4.8 (ENA); also elsewhere on the board
ADEL: R55.2, R56.1, U1.14 (ADEL)
ADELEF: R57.2, R58.1, U1.13 (ADELEF)
COMP: C57.1, J6.6, R46.1, TP7.1, U1.4 (COMP)
COMP_Z: C56.1, R46.2
CS: C59.1, R60.2, TP6.1, U1.15 (CS)
CT_RECT: D4.2 (K2), D5.2 (K2), R59.1, R60.1
CT_S1: D4.3 (K1A2); also elsewhere on the board
CT_S2: D5.3 (K1A2); also elsewhere on the board
DCM: R53.2, R54.1, U1.12 (DCM)
DELAB: R47.1, U1.6 (DELAB)
DELCD: R48.1, U1.7 (DELCD)
DELEF: R49.1, U1.8 (DELEF)
EA_N: C56.2, C57.2, R44.2, R45.1, U1.3 (EA-)
EA_P: C55.1, R41.2, R42.1, U1.2 (EA+)
FB_MID: R43.2, R44.1
G_Q5: R61.2, R62.1; also elsewhere on the board
G_Q6: R63.2, R64.1; also elsewhere on the board
G_Q7: R65.2, R66.1; also elsewhere on the board
G_Q8: R67.2, R68.1; also elsewhere on the board
LED_A: D6.2 (A), R70.2
OUTA: TP8.1, U1.22 (OUTA); also elsewhere on the board
OUTB: U1.21 (OUTB); also elsewhere on the board
OUTC: TP9.1, U1.20 (OUTC); also elsewhere on the board
OUTD: U1.19 (OUTD); also elsewhere on the board
OUTE: U1.18 (OUTE), U4.2 (INA)
OUTF: U1.17 (OUTF), U4.4 (INB)
OUT_N: J6.4; also elsewhere on the board
RSUM: R52.1, U1.11 (RSUM)
RT: R51.2, U1.10 (RT)
SGND: C52.2, C53.2, C54.2, C55.2, C58.2, C59.2, C60.2, C61.2, C64.2 (-), C65.2, D3.2 (A), D4.1 (A1), D5.1 (A1), D6.1 (K), J5.2, J6.5, J6.8, J7.2, R42.2, R45.2, R47.2, R48.2, R49.2, R50.2, R52.2, R54.2, R56.2, R58.2, R59.2, R62.2, R64.2, R66.2, R68.2, U1.24 (GND), U4.3 (GND); also elsewhere on the board
SR_A: R61.1, R63.1, U4.7 (OUTA)
SR_B: R65.1, R67.1, U4.5 (OUTB)
SS_EN: C58.1, J6.2, U1.5 (SS/EN)
SYNC: J6.7, U1.16 (SYNC)
TEMP: J6.3, J7.1, R69.2
TMIN: R50.1, U1.9 (TMIN)
VDD_IC: C52.1, C53.1, R40.2, U1.23 (VDD)
VOUT: R43.1; also elsewhere on the board
VREF: C54.1, J6.1, R41.1, R51.1, R53.1, R55.1, R57.1, R69.1, R70.1, U1.1 (VREF)

Notes on the sheet:
Auxiliary 12 V bias input
UCC28951 PSFB controller: supply, reference, voltage loop, timing
Primary current sense: CT bridge rectifier and burden
Synchronous rectifier gate drive UCC27524
Signal connector, NTC, indicator, test points

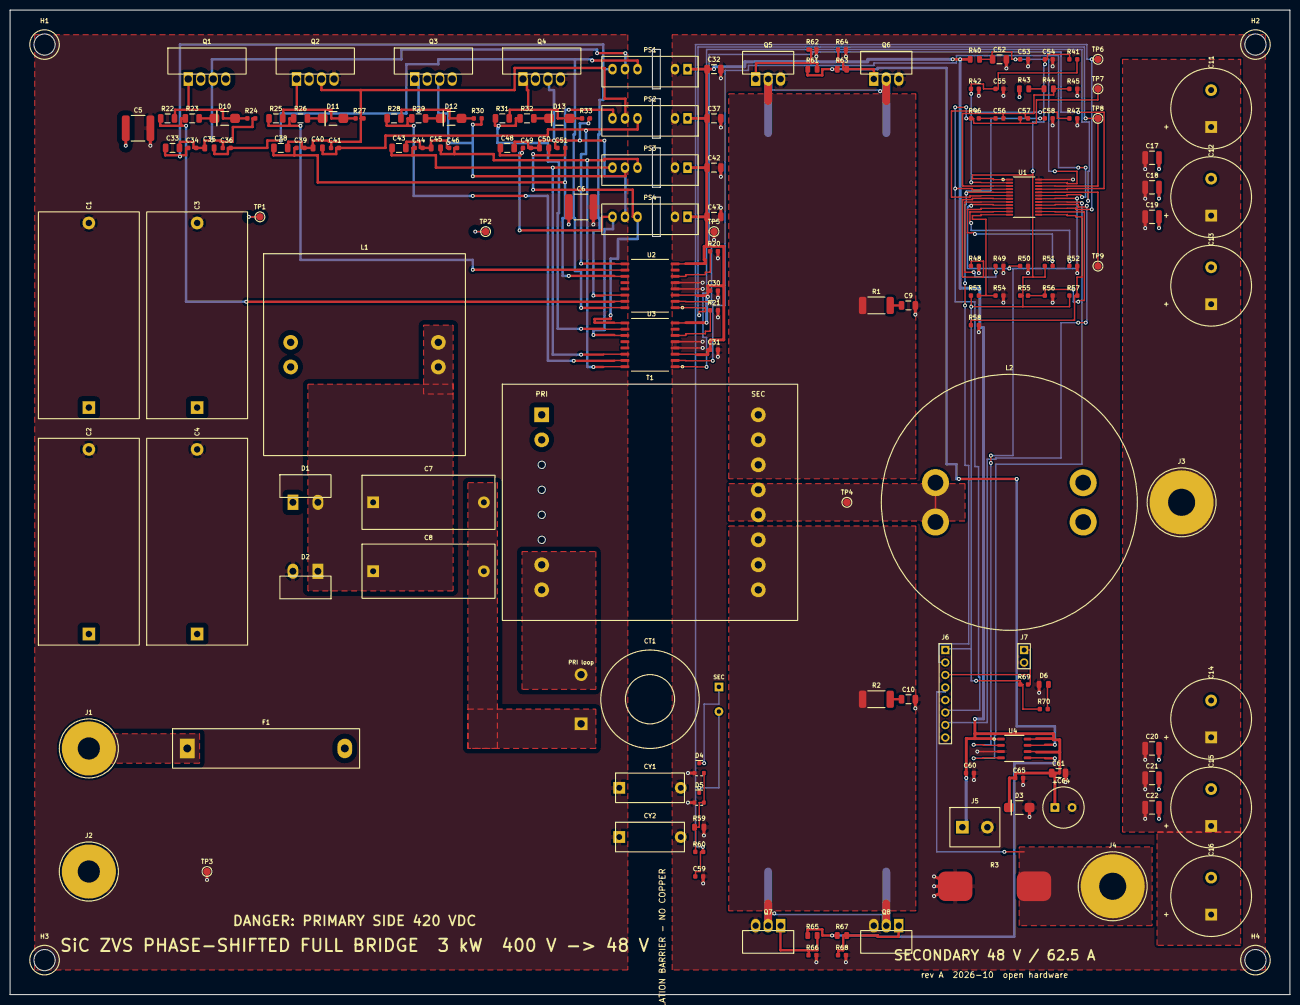
[picture p156: board SiC_PSFB_3kW.kicad_pcb from above]

Board: 4 copper layers, 260.0 x 200.0 mm, 157 parts (0 on the bottom side), 79 nets.
