murugan-paramesh/SiC-DC-DC-Converter/(commit log)

2026-10-09 PSFB 3 kW SiC reference design (KiCad 7 generated) + DAB 6.6 kW platform work in progress
    PSFB baseline: design calculation engine, hierarchical schematic (netlist verified against the
    design database with kicad-cli), symbol/footprint libraries, generated 4-layer PCB with zones,
    grid router and DRC report (routing completion still in progress), switched-model simulation,
    documentation set and BOM.
    DAB platform (SiC_6k6_Industrial_DAB): requirements/RTM, literature review, topology comparison,
    analytical model package, design calculations with derating/ZVS maps, magnetics design,
    closed-loop switched simulation, ngspice netlist, control design. Not yet verified items are
    marked in the docume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
    [03_RTM.csv, SiC_PSFB_3kW.kicad_pcb, SiC_PSFB_3kW.kicad_sch, bom.csv, control.kicad_sch, dab_sps.csv, gate_drive.kicad_sch, power_stage.kicad_sch]
2026-10-09 DAB 6.6 kW platform: models, design, simulations, control+firmware (SIL), schematic, PCB generator, thermal/EMI/safety, optimisation, BOM, manufacturing, verification, report, test plan; PSFB generat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
    Claude-Session: https://claude.ai/code/session_01TJ4PYx4qhHYB2ApeFHUZoW
    [02_FMEA.csv, SiC_DAB_6k6.kicad_pcb, SiC_DAB_6k6.kicad_sch, SiC_PSFB_3kW.kicad_pcb, bom.csv, control_aux.kicad_sch, gate_drive.kicad_sch, hv_bridge.kicad_sch]
2026-10-09 Router halo fix, PSFB layout guide update, DAB schematic project files (board routing in progress)
    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
    [SiC_DAB_6k6.kicad_pcb, SiC_PSFB_3kW.kicad_pcb]
2026-10-09 Router: halo radius from own-class clearance (fixes 8 mm wide halos on gate nets)
    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
    [SiC_PSFB_3kW.kicad_pcb]
2026-10-09 Router: A* cost uses halo-dilated usage map; conflict check over full halo window
    The negotiated router penalised only the path cell, so a re-routed net could
    still sit closer than width+clearance to its neighbour (its own halo was not
    accounted for). The cost map is now the Chebyshev maximum filter of
    (usage, history) with the net's own halo radius, and nets are flagged as
    conflicting when any overlap lies inside their halo window.
    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
2026-10-09 Router hard pass with rip-up retry, exact halo radii, via cost dilation; DAB: driver passives off the fan-out corridors, PS9/PS10 SIP-7 1 W module footprint, 0.5 mm control-power tracks; PSFB: DT res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
    - NegotiatedRouter: full/small halo masks give the exact d < hw_a+hw_b+clearance
    overlap test; A* via placement sees the via halo; nets still in conflict after
    the negotiation are re-routed against hard obstacles, with a bounded rip-up
    retry, so emitted copper never violates the clearance model.
    - Fan-out: plane-net vias 1.2 mm beyond the long stubs; corridors long+1.5 mm;
    unreachable terminals are reported.
    - plot_board.py: matplotlib region renderer for layout review.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
    [SiC_DAB_6k6.kicad_pcb, SiC_DAB_6k6.kicad_sch, bom.csv, control_aux.kicad_sch, gate_drive.kicad_sch, hv_bridge.kicad_sch, lv_bridge.kicad_sch, sensing_protection.kicad_sch]
2026-10-09 Router: recursive rip-up retry with state snapshots, same-net task merge; DAB: per-region PE lugs with PE clearance class, net-class fixes (SW_A_CT, SH_N, SH_NS), placement fixes (U15, U18/U19, TP1, 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
    [SiC_DAB_6k6.kicad_pcb, SiC_DAB_6k6.kicad_sch, bom.csv, control_aux.kicad_sch, gate_drive.kicad_sch, hv_bridge.kicad_sch, lv_bridge.kicad_sch, sensing_protection.kicad_sch]
2026-10-09 BoardGen: footprint library nickname (FPID), reference designators above the courtyard, solid pour connection option for pads at a pour edge; PSFB barrier silk text clear of the slots
    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
2026-10-09 PSFB board: fully routed, KiCad DRC 0 errors / 0 unconnected (40 silkscreen warnings); reference placement from footprint bbox, SIP-7 silk split at the slot
    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
    [SiC_PSFB_3kW.kicad_pcb, SiC_PSFB_3kW.kicad_sch, control.kicad_sch, gate_drive.kicad_sch, power_stage.kicad_sch]
2026-10-09 Router: corridor-mouth cost band; BoardGen: pour-connection tasks for plane pins outside their plane, free-cell pour goals; DAB placement: PE lugs/Y caps, gate clusters, bulk caps row, bias caps, slo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
2026-10-09 PSFB: manufacturing outputs (gerbers of the real layer set, drill, pos, PDFs), layout guide status and images
    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
    [SiC_PSFB_3kW-B_Cu.gbl, SiC_PSFB_3kW-B_Mask.gbs, SiC_PSFB_3kW-B_Paste.gbp, SiC_PSFB_3kW-B_Silkscreen.gbo, SiC_PSFB_3kW-Edge_Cuts.gm1, SiC_PSFB_3kW-F_Cu.gtl, SiC_PSFB_3kW-F_Fab.gbr, SiC_PSFB_3kW-F_Mask.gts]
2026-10-09 DAB placement: gate cluster pitch 5.5/6 mm, HV PE lug beside the HV- stud
    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
2026-10-09 DAB 08_KiCad_PCB README: floor plan, layers, isolation features, fan-out description
    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
2026-10-09 DAB board: intermediate generated board, DRC report and manufacturing outputs (final routing run in progress)
    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
    [SiC_DAB_6k6-B_Cu.gbl, SiC_DAB_6k6-B_Mask.gbs, SiC_DAB_6k6-B_Paste.gbp, SiC_DAB_6k6-B_Silkscreen.gbo, SiC_DAB_6k6-Edge_Cuts.gm1, SiC_DAB_6k6-F_Cu.gtl, SiC_DAB_6k6-F_Fab.gbr, SiC_DAB_6k6-F_Mask.gts]
2026-10-09 DAB layout: SW_A stud west of the SW_A_CT strip, LV_IN pour loop around the fuse stud, parts clear of CT1/U17/J20 collisions; stitching vias never inside another net's pour
    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
    [gen_pcb_dab.py]
2026-10-09 DAB placement: SW_C stud and TP6 clear of the U4 fan-out and PS6 body
    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
2026-10-09 DAB board: intermediate generated board and DRC report (run 17: 29 errors, routing run 19 in progress)
    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
    [SiC_DAB_6k6.kicad_pcb]
2026-10-09 Router: no vias in the corridor mouth bands, terminal-neighbourhood cost, sealers added to rip-up victims, deeper retry; DAB placement: J3 stud above C1, HF caps clear of the switch-node strips, TP/J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
    [gen_pcb_dab.py]
2026-10-09 DAB board: intermediate generated board and DRC report (run 19: 18 errors; run 20 in progress)
    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
    [SiC_DAB_6k6.kicad_pcb]
2026-10-10 Router: module exit bands (straight-out tracks, no vias, both layers); DAB: exit bands at the bias-module output faces, fuse holder / bottom header / PE lug courtyard fixes
    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
    [gen_pcb_dab.py]
2026-10-10 DAB board: intermediate generated board and DRC report (run 20: 6 errors; run 21 in progress)
    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
    [SiC_DAB_6k6.kicad_pcb]
2026-10-10 Router: region re-route round in the hard pass, ROUTER_RESUME replay of a dumped negotiation state; DAB board run 21 intermediate files
    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
    [SiC_DAB_6k6.kicad_pcb]
2026-10-10 DAB: stub fan-out for the 2.54 mm pin-header fields (J10-J12, J16, J17)
    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
2026-10-10 DAB: header fan-out limited to J10/J12/J16, short stubs on J11 (barrier side)
    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
    [gen_pcb_dab.py]
2026-10-10 Fan-out: column side from the mean pad x (2xN headers with pin-1 origin); DAB: no stubs on J11
    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
2026-10-10 DAB placement: sense ICs spaced for 5 mm exit channels, J17 clear of the J10 corridor
    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
2026-10-10 DAB board: intermediate generated board files (run 22 in progress)
    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
    [SiC_DAB_6k6.kicad_pcb]
2026-10-10 DAB placement: J16 below the J11 pin field so its first pin can exit
    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
2026-10-10 DAB board: intermediate generated board file (run 23 in progress)
    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
    [SiC_DAB_6k6.kicad_pcb]
2026-10-10 DAB: no stub fan-out on J16, fuse holder 1 mm further from the J1 stud; run 23 board (8 errors: +24V unrouted, 1 courtyard)
    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
    [SiC_DAB_6k6.kicad_pcb]
2026-10-10 DAB board: intermediate generated board file (run 24 in progress)
    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
    [SiC_DAB_6k6.kicad_pcb]
2026-10-10 DAB board: run 24 result (+5V unrouted at the U4 exit channel); widen the driver-side exit channels, move J3 clear of F1, solid GND pads for C160/J16; research gap analysis and literature database
    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
    [SiC_DAB_6k6.kicad_pcb, literature_2022_2026.csv]
2026-10-10 Digital twin module: observability analysis, RLS/EKF/Bayes estimation study, Coss estimator (proposed sensor), thermal observer, supervisory selector; fix pulse asymmetry in the switched plant and re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
    [gen_pcb_dab.py]
2026-10-10 Router: region re-route widens its reach (3/5/8 mm) when a stack of tracks seals a terminal; DAB: U10/U11 moved 8 mm right (run 26: only the +5V net unrouted, 0 courtyard/thermal errors); learning-no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
    [gen_pcb_dab.py]
2026-10-10 WIP snapshot: research modules in progress (agents writing), DAB board run 26 result files and run-27 intermediate board
    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
    [SYNTHETIC_meas_degrading_case_sensor.csv, SYNTHETIC_meas_degrading_heatsink_ntc.csv, SYNTHETIC_meas_degrading_junction_model.csv, SYNTHETIC_meas_healthy_case_sensor.csv, SYNTHETIC_meas_healthy_heatsink_ntc.csv, SYNTHETIC_meas_healthy_junction_model.csv, SYNTHETIC_mission_degrading.csv, SYNTHETIC_mission_healthy.csv]
2026-10-10 DAB 6-layer board: routing run 27 - DRC 0 errors, 0 unconnected items (63 silkscreen/dangling warnings)
    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
    [SiC_DAB_6k6.kicad_pcb]
2026-10-10 Research: verified literature database (57 entries with evidence), FEM magnetics (2-D FD solver, leakage/proximity/planar study) and parasitic extraction modules; maturity matrix rows
    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
    [literature_2022_2026.csv, validation_leakage_convergence.csv]
2026-10-10 DAB: PCB status docs and board images (run 27, 0 DRC errors), manufacturing outputs regenerated; controller mirrors the C core's gates_enabled flag (dead-bus start harness defect), reserved single-pi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
    [SiC_DAB_6k6-B_Cu.gbl, SiC_DAB_6k6-B_Mask.gbs, SiC_DAB_6k6-B_Paste.gbp, SiC_DAB_6k6-B_Silkscreen.gbo, SiC_DAB_6k6-Edge_Cuts.gm1, SiC_DAB_6k6-F_Cu.gtl, SiC_DAB_6k6-F_Fab.gbr, SiC_DAB_6k6-F_Mask.gts]
2026-10-10 DAB: verification report (all checks pass incl. dead-bus start after the harness fix), RTM status, research report rebuilt with the run-27 DRC numbers
    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
    [03_RTM.csv, SiC_DAB_6k6.kicad_sch, control_aux.kicad_sch, gate_drive.kicad_sch, hv_bridge.kicad_sch, lv_bridge.kicad_sch, sensing_protection.kicad_sch]
2026-10-10 WIP snapshot: research modules and learning-notes chapters being completed by background agents
    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
    [SiC_PSFB_3kW-B_Cu.gbl, SiC_PSFB_3kW-B_Mask.gbs, SiC_PSFB_3kW-B_Paste.gbp, SiC_PSFB_3kW-B_Silkscreen.gbo, SiC_PSFB_3kW-Edge_Cuts.gm1, SiC_PSFB_3kW-F_Cu.gtl, SiC_PSFB_3kW-F_Fab.gbr, SiC_PSFB_3kW-F_Mask.gts]
2026-10-10 WIP snapshot: background agents' intermediate files
    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
    [adaptive_robust_metrics.csv, test_vectors_lut_q15.csv, test_vectors_mlp_q15.csv, tps_eps_map_MODEL.csv]
2026-10-10 Research: health monitoring, active gate drive, reliability (FTA/FMEDA/state-machine check), HIL fault-injection suite, cybersecurity, multiphysics modules; known-issues register (14 baseline finding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
    [benchmark_ccs_r_sweep.csv, benchmark_metrics.csv, benchmark_modulators.csv, bo_front.csv, grid_front_reevaluated.csv, pareto_fronts.csv, parity_A2_test.csv]
2026-10-10 Research: adaptive MPC (6 controllers, WCET, ZVS maps) and embedded AI (Q15 LUT vs MLP, schedule, test vectors) modules; learning-notes chapters 01-14; maturity matrix rows
    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
    [adaptive_robust_metrics.csv, benchmark_ccs_r_sweep.csv, benchmark_metrics.csv, benchmark_modulators.csv, benchmark_table.csv, pareto_fronts.csv, parity_GP_rbf_test.csv, parity_HYB_sps_plus_residual_test.csv]
2026-10-10 Safe RL module README (no benefit over PI+EPS; safety limits held; two model-based ZVS filter misses documented); notes checker resolves short file references; five modules registered in the toolchai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
2026-10-10 Learning notes chapters 19-20; DAB PCB maturity raised to L3 (its own criterion, 0 DRC errors / 0 unconnected, is met) and the chapters updated accordingly
    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
2026-10-10 Learning notes chapters 15, 17, 18; chapter 09 explicit-MPC figures updated to the current table (33x9x23, 0.14 deg rms); known issue 12 extended with the MCU timing basis (F280049C vs F28379D)
    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
2026-10-10 Full toolchain run in progress: regenerated outputs so far
    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
    [validation_leakage_convergence.csv]
2026-10-10 Complete toolchain run: all 26 scripts of 18 research modules pass in one run (178 result files hashed in run_log.json); maturity matrix refreshed
    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
    [adaptive_robust_metrics.csv, benchmark_ccs_r_sweep.csv, benchmark_metrics.csv, benchmark_modulators.csv, gate_loop_sensitivity.csv, literature_comparison.csv]
